albertorestifo/trenino/docs/mechanical/FDM_SPECIALIST_REVIEW.md

# FDM specialist review — integrated controller, 24 October 2026

Review basis: `integrated_controller.fs`, all 30 exported STL objects and the mesh/slicer reports in `integrated-print`, and the assembly/print guide. This is an independent design-for-FDM review of the current revision, before the requested main-gear/handle and 2020-frame redesign. Dimensions below are taken directly from the FeatureScript. No physical print or load test has been performed.

## Findings to implement before releasing prints

1. **Fork is not lying on the flat side claimed by the print layout.** Bars are y=-52…-44, but the roller ends now have radius 5 about y=-48, extending to y=-53. After the +90 degree X print rotation, the cylindrical nose sets Z=0 and the full long bars start 1 mm above the bed. The first contact is a rounded tangent, not a stable broad face. Make the fork bars 12 mm wide (y=-54…-42) with a common flat lower side at y=-54. A local radius-6 pivot boss can fit inside this width. Keep the radius-5 roller ends inside this envelope. Re-run cam and support clearances after widening. Otherwise the part requires extensive underside support, with poorer bearing-hole accuracy.
2. **Fork pivot ligaments are too thin for a repeat-loaded printed part.** The Ø5.3 hole crosses 8 mm wide bars, leaving only (8-5.3)/2 = 1.35 mm of material each side. The 12 mm width above raises that to 3.35 mm. Use rounded transitions into the bar rather than sharp notches. This is a recommended reinforcement, not a calculated load rating.
3. **Roller-axle head seat is only 1.2 mm thick.** Upper cheek z42…45 is cut by the counterbore beginning at z43.2. A clamped screw can crush or split this thin seat. Provide at least 2 mm solid thickness below the head counterbore, preferably by thickening the roller-end cheek locally; preserve the internal 12 mm tube spacing and recheck head clearance and the cam-removal route. Do not solve it simply by pulling the two fork cheeks together with the axle screw.
4. **The shaft needs explicit support under its journals.** D-flat-down is the correct starting orientation for a printed torque shaft, but its 9.2 mm journals are 0.4 mm above the bed when the D-flat establishes Z=0. Add local removable support under both journals or sacrificial print-only feet. Do not remove journal geometry to create flat bearing surfaces. Keep support away from deep insert bores and clean the running surfaces afterward.
5. **No integrated slicing success has yet been demonstrated.** The current `slice-report.json` records exit -3 and zero-byte outputs for every part. Logs say the settings file `integrated-print/profiles/process-integrated*.json` is missing; the generated process files are actually in `integrated-print/`. Correct the path before interpreting any result as a geometry/slicing failure. The shaft is also marked `Supports=false` in the current report. Re-slice the final revised exports, not these superseded meshes.

## Part-by-part disposition

| Part/family | FDM assessment and required treatment |
|---|---|
| Printed main shaft M01 | Keep horizontal D-flat down; add journal support as above. The Ø9.2 journal around a Ø4.6 insert leaves 2.3 mm nominal radial material, acceptable as a prototype starting point. Add ~0.5 mm entry chamfers to running/insert openings, and a modest shoulder fillet where assembly clearance permits. Insert heat can deform bearing journals; use a simple holding/alignment jig and recheck diameter after installation. |
| Bushings M02, two | Upright on end faces is suitable. Nominal Ø9.6 bore vs Ø9.2 journal gives 0.4 mm diametral clearance; actual FDM holes can close this significantly. Print these with the shaft first. Test a small fit coupon before the long parts. Avoid supports inside the bore; clean/ream rather than force fitting. They are replaceable sliding wear parts. |
| End washers M03, two | Flat 1.6 mm parts are printable, but tightening is only for shaft retention. Use conservative screw torque so the printed washers do not dish or clamp the rotating stack. Consider 2 mm if axial space allows. |
| Existing separate handle M04 | Superseded by user correction. For the replacement, integrate the lever into the large gear at its original radial attachment location and print the gear/lever broad face down. Keep a broad stem (approximately 18 mm) and gear-width root (~12 mm); add a generous 3–5 mm rounded root transition. Remove/fill the obsolete threaded lever socket if it would leave an internal void at that new root. Check that handle/gear fits the bed as a single piece; avoid a thin neck or printed transverse thread as the primary load path. |
| Drive spacers M05, two | Flat annular pieces are printable. The 3.2 and 2.5 mm thicknesses are adequate compression spacers. Faces must stay parallel; avoid elephant-foot interference in bores. Their count/thickness must be regenerated when the handle moves into the gear plane. |
| Cam M06 | Flat orientation correctly gives a smooth XY-defined contact profile. Underside boss reliefs leave approximately 9.6 mm-wide roofs, with top screw holes interrupting the bridges. Use accessible support under those reliefs; they open toward the inner edge, allowing removal. Block support on the roller track. Recess seats are 2.2 mm above the relief roof, reasonable but do not overtighten the cam screws. Inspect seam placement and polish only obvious seam/elephant-foot defects, without altering notch shape. |
| Carrier M07 | Flat bottom with vertical insert pockets is suitable. Ø9 bosses around Ø4.6 inserts leave 2.2 mm radial plastic and a 1.8 mm pocket floor; workable for the prototype with careful installation. The stop lug is only 4 mm thick and 6 mm wide with a sharp root. Add a rounded/gusseted root and increase lug thickness toward 6 mm if the revised stop geometry allows. A printed lug is a high-wear impact location; retain generous material instead of a thin projecting tab. |
| Fork M08 | Apply the three findings above before printing. Shared flat side is preferable to a supported curved nose. Horizontal pivot/axle holes may need gentle drilling/reaming; do not heat-set anything in these running holes. |
| Roller M09 | End-face-down is appropriate. Ø4.3 bore over Ø4 tube gives 0.3 mm diametral nominal running clearance. Confirm free rotation after tightening. External seam can be felt at every revolution; tune seam and deburr. A standard smooth roller/bearing is an optional later wear improvement, not necessary to evaluate the printed prototype. |
| Lower/upper plates S01/S02 | Broad-face-down, 6 mm thickness is a sound printable structure. Lower pivot counterbore leaves 3.5 mm seat; upper captured-nut floor leaves 2 mm. The upper plate's asymmetric form is intentional for cam servicing. 2020 T-slot mounting should shorten and stiffen the reaction path and may eliminate several spacers. Keep the resulting parts flat and avoid replacing them with tall thin printed towers. |
| Spring block S03 | The current +90 degree print orientation leaves insert bores horizontal but puts the adjuster/nut entry upward. Small Ø4 roofs can bridge; block automatic support inside the blind insert holes where it cannot be cleaned. Use local support only on accessible overhangs. Insert pockets have 2.7 mm nominal side walls in the 10 mm column, but the y=-26 pocket is only 1.7 mm from the outer edge after insert installation; moving it inward or extending that edge by ~1 mm would improve margin if the bracket survives the 2020 redesign. |
| Stop arch S04 | Broad-face-down 6 mm arch is much better than the earlier cantilever. Upright Ø7 posts project 5 mm above the arch and are short enough to print without support, but their roots are layer-loaded under lever impact. Add root fillets/gussets where clear of the moving lug; direct mounting into the 2020 structure is preferable to slender printed posts carrying the whole base. |
| Ten support spacers S05–S14 | Upright axis is appropriate and all are single contiguous solids. Ø12 spacers have adequate material around M3 holes. Front 8 mm insert caps leave only 1.3 mm below a 6.7 mm pocket (with a through clearance hole); if retained, increase height to 9–10 mm or use a captured/through metal nut. The 2 mm plain spacer is printable as a washer, not a structural stand-off. Use the 2020 rails to reduce stack count. |
| Frame plates | Both current orientations put their broad faces on the bed and bearing seats upward. The 190×93 mm footprint fits P2S; manage warping with a clean bed and brim if needed. Small horizontal flange holes can be bridged/cleaned. Preserve the existing metal-extrusion attachment interface. Existing correct plates need not be reprinted simply because the detent changed. |
| Main and potentiometer gears | Existing module-1 teeth are small but sensible for the prototype with 0.4 mm nozzle and fine mesh export. Broad gear face down keeps tooth profiles in XY. No support should touch teeth. Main gear is now superseded by the integrated lever version; pot gear can remain original. Check the 6 mm pot bore against the real D/round shaft rather than forcing it. |
| Fasteners, spring, dowel, tube and potentiometer references | These are hardware/reference bodies, not print parts. Exclude them from print exports and retain an explicit BOM. Do not describe the spring envelope as a manufactured spring. |

## Release checks for the revised design

- Regenerate the 2020-supported revision and all print groups before exporting. The current 30-part meshes pass topology and build-envelope checks, but that does not cover revised geometry or physical strength.
- Use a first fit job with shaft, bushings, a short insert boss coupon and the roller. Confirm heat-set insert installation and both rotating fits before printing large plates or gear/handle.
- Start with 0.20 mm layers, five walls and five top/bottom layers. Five walls matter more than merely raising infill for these small bosses; use local solid infill around bearing/insert seats if the slicer leaves sparse cores. 35% gyroid is a reasonable prototype starting point, not a strength qualification.
- PLA is suitable for initial fit/geometry evaluation. PETG changes compliance and fits; recheck those after switching. Avoid treating either material as validated for stop impacts until a modest-load bench test has been completed.
- Re-run full lever clearance and cam-removal checks after the fork width, head-seat and gear/handle revisions. The added 2020 rail geometry must be included in those checks.
- Verify support accessibility and layer preview, including the first five shaft/fork layers. A watertight mesh and a zero-interference CAD sweep alone do not prove printability.

## Requested implementation fragment

`review_fork_fragment.fs` implements the agreed candidate: 14 mm bars sharing y=-55 flat print side, Ø7.3 fork pivot bore over a 7 OD × 5.2 ID × 20 mm metal sleeve, 4 mm upper cheek with 2.2 mm remaining axle head seat, 9.5 mm-wide roller, and 11 mm axle spacer tube. The main agent must integrate and collision-test it. The stationary pivot sleeve must not be added to the rotating `rollerHardware` query. Its ends clamp against the fixed plate faces at z26 and z46; there remains 1 mm axial clearance to each outer fork face. The rounded roller nose beyond x=0 still needs a small accessible support region in this orientation; the long bars now have broad bed contact.
