albertorestifo/trenino/docs/mechanical/fusion-controller/FINAL_FDM_REVIEW.md

# Final FDM specialist review — Fusion controller

Review scope: the NEW Fusion controller only, using build scripts 01–17, export manifest, supplied print orientations, mesh report, original slicer report and superseding normal-support re-slice report, assembly guide, and `fusion-overview.png`. The earlier Onshape review does not apply to this geometry. Joint script 17 is not assumed to have run, and this review does not replace motion validation.

## Disposition

The parts are generally designed to print in the supplied orientations on the P2S, with removable supports as listed. The rotor/lever now has a broad printing face, the printed shaft lies horizontally, the base is separate rail-mounted plates, and the rounded grip is split into printable halves. One **mandatory insert-retention correction** was found in P13 before release. Other items below are prototype assembly/fit checks, not reasons to claim the CAD cannot be printed.

### Blocker: P13 cam clearance cuts through two insert sites

The raised crossblock mounting holes nearest the cam are centered at y=-51, z=52, on both ends of P13. The cam-clearance cylinder is R51 centered at y=0, z=65. The distance from that hole center to the cut is:

`sqrt(51² + (65−52)²) − 51 = 1.63 mm`

The Ø4 pilot radius is 2 mm, so even the pilot breaks into the clearance cut. The installed CNC Kitchen insert is approximately Ø4.6; its 2.3 mm radius leaves **negative wall thickness** toward the cam. Heat-setting here cannot produce a fully enclosed retaining boss. Mesh watertightness does not detect this design problem.

Recommended local correction: move the matched P13 and P01/P02 mounting-hole pairs from y=-59/-51 to **y=-62/-54**, keeping z=52, and move the four screw models with them. The y=-54 insert has approximately 2.24 mm nominal material between its outside and the R51 cut; the y=-62 insert has 1.7 mm nominal material to the block's y=-66 outer edge. The 8 mm center spacing leaves 3.4 mm between installed inserts. Recheck rail-head/tool clearances, export and re-slice the affected three parts. Do not simply fill the hole without preserving the cam-clearance envelope.

## Part-by-part review

| Parts | Assessment and concrete print/assembly treatment |
|---|---|
| P01 left sideplate | X-min face down puts the broad 12 mm plate on the bed and grows the reinforced stop cores upward. Supports are appropriate for transverse rail bores and recessed nut/head details. Steel stop bolts reinforce short printed contact posts. Ensure nut recess support is completely removed and rail faces sit flat before tightening. Match the P13 mounting-hole correction above. |
| P02 right sideplate | X-min face down gives a broad base. The sensor rails grow upward to a 56 mm overall print height, rather than appearing as disconnected bridges. Supports cover the service-window/rail access details. The tall rails are lightly loaded sensor supports; use normal supports as in the superseding slice report. Match the P13 mounting-hole correction. |
| P03/P04 flanged bushes | Both print flange-down. Ø20.1 bodies in Ø20.3 seats and Ø12.3 bores over Ø12 journals are plausible nominal clearances, but the first layer can close holes. The 1.2 mm flanges should be allowed to cool before removal to avoid warping. Print these and the shaft first. Check free rotation, axial seating and visible wear. |
| P05 printed shaft | Y-max/D-flat down is appropriate. The 16 mm structural section has a broad flat, and the shoulder has been flattened to the same plane. Round journals and sensor stub remain raised and need the enabled supports. Clean support without flattening bearing surfaces. The M3 insert in the 12 mm journal has adequate nominal surrounding material; install with controlled heat and then verify journal roundness. Shoulder/diameter changes are fatigue-sensitive under abuse; modest-load prototype testing is appropriate. |
| P06 cap | Flat, 2 mm thick, support-free. It retains the shaft; do not tighten it to eliminate the designed end float or dish the cap. |
| P07 integral lever rotor/carrier | X-max face down puts the continuous 14 mm hub/stem/fan on the bed and grows the stop lug upward. Removing the former long axial hub was the correct printability change. Cam insert pockets open toward the bed but are small Ø4 blind openings with accessible entry; clean any roof stringing before heat-setting. At R36 on an R41 fan the installed inserts retain approximately 2.7 mm radial margin. Rounded stop contact lies within the lever-root footprint and does not create the earlier Onshape carrier's raised unsupported ledge. Six walls are appropriate for this prototype. |
| P08 cams, all three profiles | Flat face down, 8 mm thick, with counterbores upward. No underside boss pockets need support. This is a good orientation for XY roller-track quality. Keep seams/support scars off the track and remove elephant foot only at the nonfunctional lower edge. Three alternatives are exported; install one only. |
| P09/P10 rounded grip | Split-face down with normal supports in the 14.4 mm-wide stem socket is suitable. Socket support is accessible from the split face and open lower mouth. Install the two inserts from the recessed socket side before closing the halves. The rounded crown and 40×60 mm envelope are manufacturable; deburr seam and counterbore mouths. Confirm comfort and grip screw seating physically rather than claiming an ergonomic qualification. |
| P11 fork | Z-min side down provides two long flat cheek contacts, unlike the old Onshape floating bars. Supports are enabled for horizontal pivot/axle bores and the tail pilot. The Ø8.3 pivot hole in a 12 mm-high cheek leaves 1.85 mm nominal ligaments; the 3 mm cheeks and approximately 1.5 mm material behind the roller nut recess are the thinnest repeatedly loaded details. They are acceptable for a gentle fit prototype with the metal sleeves carrying bolt clamp loads, but deserve early inspection for cracking, crushing or looseness. Do not use higher spring force or impact testing as the initial test. A later endurance version could widen/thicken these areas if tests show strain. |
| P12 roller | End down, no supports. Ø4.3 bore over Ø4 tube gives nominal 0.3 mm diametral clearance; the 9.5 mm roller inside the 10 mm tube span has 0.5 mm total axial room. Check that axle tightening does not remove this freedom. A seam ridge will be felt at the cam; deburr it carefully. |
| P13 reaction crossblock | Top down makes the spring-side M4 nut recess accessible upward, and normal supports handle the side insert bores and clearance contour. **Apply the insert-position blocker above.** Long 8.8 mm blind cuts provide screw-tip room behind 5.7 mm inserts; do not bury inserts deeper than their intended entry face. |
| P14 spring cup | Top down, pilot upward, no supports. The 2 mm cup plate has a broad bed footprint. Guide bores are Ø4.4 for Ø4 sleeves. Use the guide tubes so tightening the screws does not clamp the sliding plate. Remove it from the bed by the plate, not by pulling the narrow pilot. |
| P15 preload collar | The final part is the 4 mm collar, not the earlier 9 mm version. Ø6.6 outside and Ø4.5 inside leaves about 1.05 mm wall. This is a short compression limiter, not a bearing; print with solid perimeter walls and avoid forcing it over a damaged screw. Its role and dimension should remain clear in the guide. |
| P16 sensor carriage | X-max panel face down gives a broad 3 mm panel base; the adjustment ears grow upward. The small horizontal slots can bridge in this orientation; clean them enough that washers seat and the carriage slides. The RK097 bushing/body assumptions must be checked on the actual purchased part before tightening. |
| P17 input coupling hub | X-min down with normal supports is appropriate. The larger flange extends past the lower clamp body and does require support. The 0.4 mm pinch split must remain open; prevent support residue or elephant foot from welding it. Heat-set insert/clamp walls have modest but usable margins for transmitting sensor torque, not lever reaction loads. Tighten only enough to prevent slip. |
| P18 floating Oldham disc | X-min down with support beneath the lower open transverse groove. Both grooves run to the perimeter and remain accessible for cleaning. There is a 3 mm web between the opposing 2.5 mm-deep grooves. It is a deliberate floating coupling component, not an unsupported printed island. Check free sliding with the actual hub tongues before installing the sensor. |
| P19/P20 output clamp halves | Split faces down with normal supports beneath the semicircular shaft bore. The 0.4 mm assembled split allows clamping; remove brim/elephant foot from that gap. Insert-side minimum nominal material is about 1.6–1.7 mm near the bore/edge, so use controlled insert heat and modest clamp torque. The shaft bore is an assumption; do not force or overclamp an incompatible sensor shaft. |
| P21/P22 follower spacers | Axial ends down, no supports. P21 is Ø12×27.8 with Ø8.4 bore, a 1.8 mm wall; use a brim if bed adhesion is marginal. P22 is the short 3.8 mm counterpart. Their lengths establish end float; do not substitute arbitrary washer stacks. |
| P23/P24 rotor thrust spacers | End down, no supports. Ø20 outside / Ø16.4 inside leaves a 1.8 mm wall and both are 16.85 mm long. Keep end faces parallel, remove elephant foot from bores, and confirm the nominal 0.3 mm rotor end float after the entire stack is assembled. |

## Evidence and release limits

- The mesh report records 26 single connected, closed, consistently wound meshes, all on Z=0 and within the P2S envelope. This includes three cam alternatives; one installed controller uses 24 of those printed solids.
- All original slice records report success. For the 11 supported parts, `slice-report-reslice.json` supersedes the tree-support runs with normal supports. That is important: the earlier tree runs reported lost-branch diagnostics even though they exited zero.
- The normal-support re-slices still carry printer-preset/tool diagnostics including `nozzle_volume_type` and `T65535`. Release geometry, not those CLI-generated G-code files. Slice with the user's installed P2S/filament profile and inspect support contact/removal in Bambu Studio.
- Slicer success is evidence that toolpaths can be generated; it does not prove support removal, running fits, insert retention, layer strength or fatigue life. Print the shaft/bush/coupling fits first and start with low spring load.
- The actual RK097 must be measured. The assumed Ø6 shaft/M7 mounting bushing, coupling engagement and usable travel remain hardware validation items. An Oldham disc's free motion must not be removed by axial bottoming of the hubs.
- FDM review does not certify native joint constraints or cam contact. The sampled motion and service-path checks must remain separately documented and repeated after any collision-relevant geometry changes.

**Review outcome:** release the supported PLA prototype geometry only after the P13/plate mounting-hole correction and affected mesh/slice checks. No other mandatory FDM CAD changes were identified in this review. The fork's thin sections, printed bearings, clamp fits, stop contact and real sensor fit remain explicit early bench-test items.

### Adjacent mounting-hole caveat

At the plate mount nearest the cam, the rail-head counterbore R5.3 centered at Z45 reaches Z50.3, while the M3 through-bore R1.7 centered at Z52 also reaches Z50.3. Their nominal voids are tangent where their Y ranges overlap (including the suggested Y=-54 mount). The actual screw envelopes may still clear, but the zero web is a stress concentration and needs inspection in the layer preview/first prototype. A local raised mounting boss with higher hole center would improve the durable version if it can be accommodated without changing the preload stack. This is distinct from the missing insert-retention wall in P13; no load or fatigue rating is claimed here.

## Implementation closure (same review round)

The reviewed findings were implemented in scripts19,20 and22. Final crossblock rows are Y=-70/-62 at Z53.5, with the block extended toY=-74 (1mm inside the rail); this supersedes the intermediate -62/-54 proposal, which crossed a cup guide. Installed-insert outer wall is at least1.7mm for an assumed4.6mm OD, with ample cam-side wall. The guide bores remain separate. Rotor clamp with flat washer pad, default4.2mm and optional4.1mm coupling grooves, M5x30/5mm-total metal rail spacers, 2mm preload collar, M3x35 guides and M4 socket head are present.

Final neutral CAD check finds only0.000634mm� numerical cam-contact overlap. The three cam profiles each passed53 sampled poses. After corrections,27 additional rotor/coupling poses, operating/service follower positions, +/-1mm preload movement and optional tight-disc assembly fit passed the0.01mm� threshold. Revised cam withdrawal at5mm increments through40mm with the follower depressed5deg passes. Exported cam profiles track the intended roller center within0.0013mm over the159 sampled positions (mesh/facet approximation). These checks do not replace physical force or fatigue tests.

All27 final print meshes are single connected, closed, consistently wound solids, bed-oriented and inside the256mm P2S envelope. All27 final slices succeeded;12 use conventional supports. The largest part is171mm long. Vendor CLI preset/tool-command warnings are retained in logs; only geometry is released, not that G-code. Guide/BOM explicitly retain actual RK097, T-nut engagement, spring choice, free-sliding coupling and reversal-hysteresis checks. No additional review round was commissioned.
