albertorestifo/trenino/docs/feature-reference/serial-protocol.md

# Serial transport and byte protocol

This is the implemented host contract at commit `188f35e4108733358730e92ebd98f1912af5173a`, reviewed on 2026-10-25. It describes the Elixir host, not an independently verified firmware implementation. No real port was opened during this review. For configuration semantics see [hardware](hardware.md), flashing and port ownership see [firmware](firmware.md), and executable acceptance stories see [hardware user stories](hardware-user-stories.md).

## Transport and framing

[Connection](https://github.com/albertorestifo/trenino/blob/188f35e4108733358730e92ebd98f1912af5173a/lib/trenino/serial/connection.ex) opens each eligible UART with `active: false`, `speed: 115_200`, `framing: Trenino.Serial.Framing`, and `rx_framing_timeout: 1_000`. Other line settings are left to Circuits.UART defaults; this repository does not explicitly select parity, data bits, or stop bits. After the identity handshake it switches to `active: true`. Bootloader uploads use their separate board-specific baud rates.

[Framing](https://github.com/albertorestifo/trenino/blob/188f35e4108733358730e92ebd98f1912af5173a/lib/trenino/serial/framing.ex) sends one message payload per zero-delimited COBS frame:

1. Append a zero to the payload.
2. Split it at zeros or after 254 nonzero bytes. Each block has a leading code equal to nonzero byte count plus one; a full 254-byte block uses `FF`.
3. Append a literal `00` frame delimiter to the encoded bytes.

The appended-zero implementation detail matters at block boundaries: 254 `AA` payload bytes become `FF` + 254 × `AA` + `01 00` (257 bytes); 255 `AA` bytes become `FF` + 254 × `AA` + `02 AA 00`. An ordinary heartbeat payload `06` becomes `02 06 00`; payload `00 11 00` becomes `01 02 11 01 00`. There is no packet length prefix outside message bodies, checksum, CRC, sequence number, encryption, or transport acknowledgement in this framing code.

Receive buffering concatenates new bytes, splits on every `00`, and processes all complete frames in order. Empty encoded frames are ignored. Decoding appends an implied zero after every block with code below `FF`, then removes exactly one final decoded byte. A code claiming more bytes than remain raises `ArgumentError`, which is caught and causes that frame to be dropped; following valid frames are still processed. A remaining incomplete buffer returns `:in_frame`; an empty buffer returns `:ok`. `flush/2` clears buffered bytes. `frame_timeout/1` returns no frames and retains state. Although `init/1` stores a `max_length` option, nothing enforces it: an undelimited stream can grow indefinitely. These are source observations; corruption detection beyond structural COBS checks is absent.

Evidence: [framing tests](https://github.com/albertorestifo/trenino/blob/188f35e4108733358730e92ebd98f1912af5173a/test/trenino/serial/framing_test.exs) cover standard examples, 254/255-byte boundaries, split frames, 500-byte random round trips, corrupt frames, and recovery to the next frame.

## Message notation and dispatch

All layouts below are **decoded payload bytes**, before COBS. Offset zero is always the type byte. `u8` is one unsigned byte; `u32le` is four unsigned little-endian bytes; `i16le` is a signed two's-complement little-endian two-byte value. Fixed-size decoder patterns require exactly the shown size, including rejection of trailing bytes. Wire config IDs permit unsigned 32-bit values even though normally generated application IDs are positive signed-32-bit-range integers.

[Message.decode/1](https://github.com/albertorestifo/trenino/blob/188f35e4108733358730e92ebd98f1912af5173a/lib/trenino/serial/protocol/message.ex) dispatches by the first byte. Empty binary returns `{:error, :insufficient_data}`; an unrecognized byte returns `{:error, :unknown_message_type}`; nonbinary input returns `{:error, :invalid_input}`. Known messages with a bad body return `{:error, :invalid_message}`. Struct APIs represent input/output kinds with atoms and encoders convert to integer tags. Most encoders rely on binary construction rather than full field validation: callers must not assume the Ecto constraints are repeated at the wire boundary.

| Type | Message; usual direction | Exact decoded layout; total length | Host behavior |
|---|---|---|---|
| `00` | IdentityRequest; host → device | `00`, request_id `u32le` at 1–4; 5 bytes | Discovery writes and drains a fresh request on each attempt. |
| `01` | IdentityResponse; device → host | `01`, request_id `u32le` at 1–4, major `u8` at 5, minor at 6, patch at 7, config_id `u32le` at 8–11; 12 bytes | Converts version bytes to `"major.minor.patch"`; records firmware version/config ID. No board type, serial number, USB identity, or device ID is present. |
| `02` | Configure; host → device | Header and discriminated payload detailed below; variable length | One frame per direct input, matrix, or I2C module. |
| `03` | ConfigurationStored; device → host | `03`, config_id `u32le` at 1–4; 5 bytes | Completes matching in-flight configuration; no per-part ACK. |
| `04` | ConfigurationError; device → host | `04`, config_id `u32le` at 1–4; 5 bytes | Completes matching request with `:device_rejected`; no numeric reason/detail. |
| `05` | InputValue; device → host | `05`, pin `u8` at 1, value `i16le` at 2–3; 4 bytes | Caches/broadcasts raw integer values by receiving port and pin. **There is no config_id in this message.** |
| `06` | Heartbeat; nominally both directions | `06`; 1 byte, empty body | Codec exists; Connection only broadcasts it. No periodic heartbeat writer, pong handler, missed-heartbeat timer, or liveness enforcement exists in these modules. |
| `07` | SetOutput; host → device | `07`, pin `u8` at 1, value `u8` at 2 (`00` low, `01` high); 3 bytes | Fire and forget; invalid value atom returns `:invalid_value`; other received value bytes reject. |
| `08` | RetryCalibration; host → device | `08`, pin `u8` at 1; 2 bytes | Encoder explicitly accepts integer 0–255, otherwise `:invalid_pin`; codec support does not make this part of the host sampling wizard. |
| `09`–`0C` | Reserved, removed BLDC stubs | No supported payload | Dispatcher returns unknown-message-type. |
| `0D` | WriteSegments; host → device | `0D`, I2C address `u8` at 1, byte count `N:u8` at 2, N raw bytes at 3 onward; `3+N` bytes | Encoder permits at most 16 data bytes, otherwise `:data_too_long`. Decoder requires precisely N bytes but does **not** itself cap N at 16. |
| `0E` | SetModuleBrightness; host → device | `0E`, I2C address `u8` at 1, brightness `u8` at 2; 3 bytes | Encode/decode restrict brightness to 0–15; invalid encode returns `:invalid_brightness`. No acknowledgement. |
| `0F` | ModuleError; device → host | `0F`, I2C address `u8` at 1, error_code `u8` at 2; 3 bytes | ConfigurationManager logs a warning. No error-code enum, persistent status, retry, or failed-configuration event is defined. Module documentation says it follows ConfigurationStored for each failed module. |

IdentityRequest/Response sources: [request](https://github.com/albertorestifo/trenino/blob/188f35e4108733358730e92ebd98f1912af5173a/lib/trenino/serial/protocol/identity_request.ex), [response](https://github.com/albertorestifo/trenino/blob/188f35e4108733358730e92ebd98f1912af5173a/lib/trenino/serial/protocol/identity_response.ex). Response encoding splits a string into exactly three integer components; malformed versions can raise rather than return an error tuple. Configuration responses: [stored](https://github.com/albertorestifo/trenino/blob/188f35e4108733358730e92ebd98f1912af5173a/lib/trenino/serial/protocol/configuration_stored.ex), [error](https://github.com/albertorestifo/trenino/blob/188f35e4108733358730e92ebd98f1912af5173a/lib/trenino/serial/protocol/configuration_error.ex). Remaining codecs: [input](https://github.com/albertorestifo/trenino/blob/188f35e4108733358730e92ebd98f1912af5173a/lib/trenino/serial/protocol/input_value.ex), [heartbeat](https://github.com/albertorestifo/trenino/blob/188f35e4108733358730e92ebd98f1912af5173a/lib/trenino/serial/protocol/heartbeat.ex), [output](https://github.com/albertorestifo/trenino/blob/188f35e4108733358730e92ebd98f1912af5173a/lib/trenino/serial/protocol/set_output.ex), [retry](https://github.com/albertorestifo/trenino/blob/188f35e4108733358730e92ebd98f1912af5173a/lib/trenino/serial/protocol/retry_calibration.ex), [segments](https://github.com/albertorestifo/trenino/blob/188f35e4108733358730e92ebd98f1912af5173a/lib/trenino/serial/protocol/write_segments.ex), [brightness](https://github.com/albertorestifo/trenino/blob/188f35e4108733358730e92ebd98f1912af5173a/lib/trenino/serial/protocol/set_module_brightness.ex), [module error](https://github.com/albertorestifo/trenino/blob/188f35e4108733358730e92ebd98f1912af5173a/lib/trenino/serial/protocol/module_error.ex). ModuleError encoding checks integer types but not byte bounds.
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
