albertorestifo/trenino/docs/mechanical/cam-detent-prototype.png

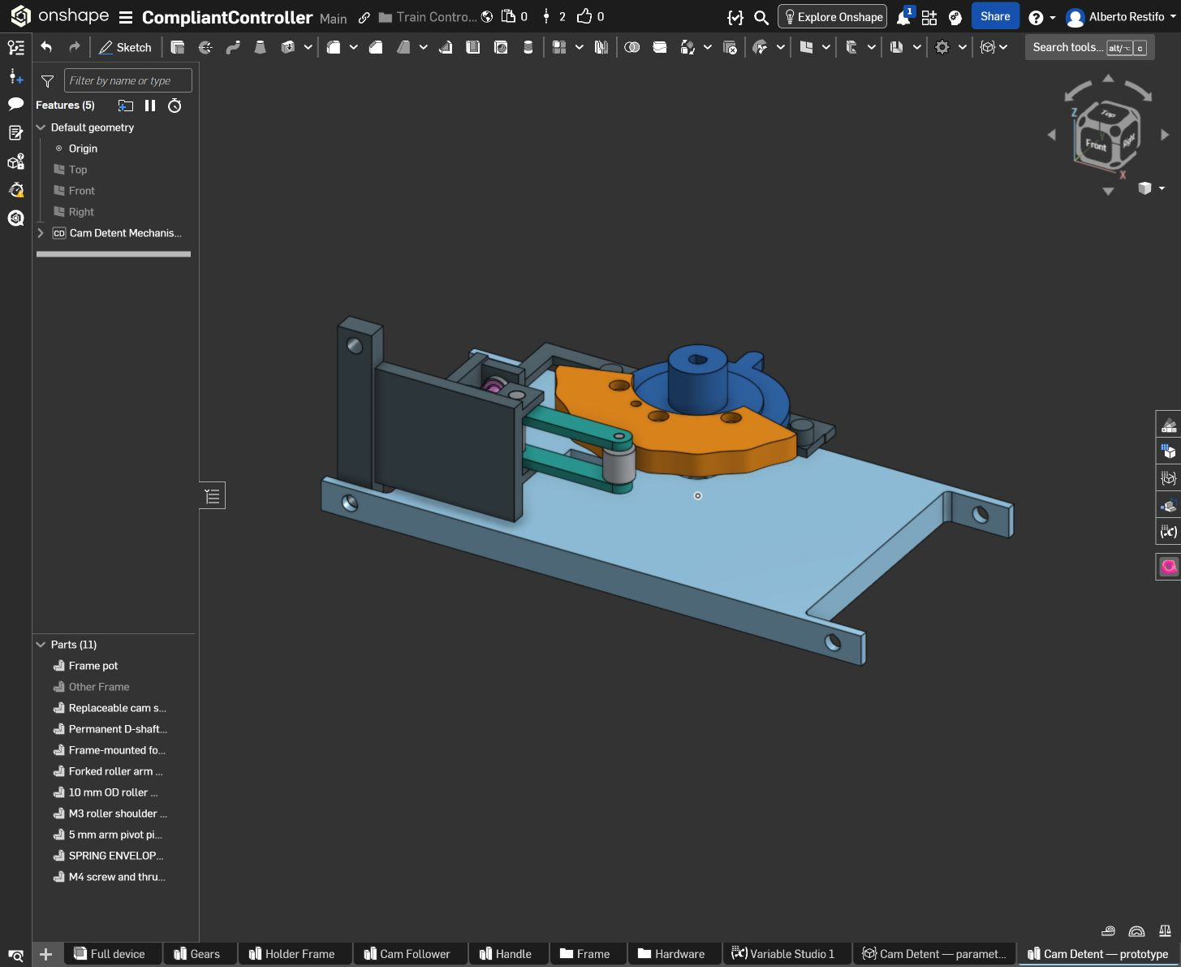
docs/mechanical/cam-detent-prototype.png
