albertorestifo/trenino/docs/mechanical/fusion-controller/fusion-closeup.png

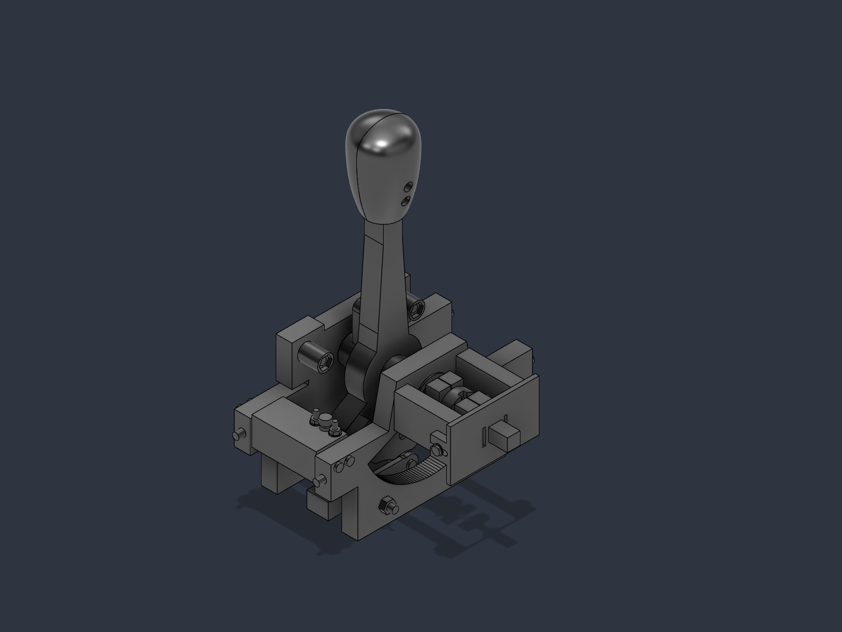
docs/mechanical/fusion-controller/fusion-closeup.png
