albertorestifo/trenino/docs/mechanical/fusion-controller/fusion-overview.png

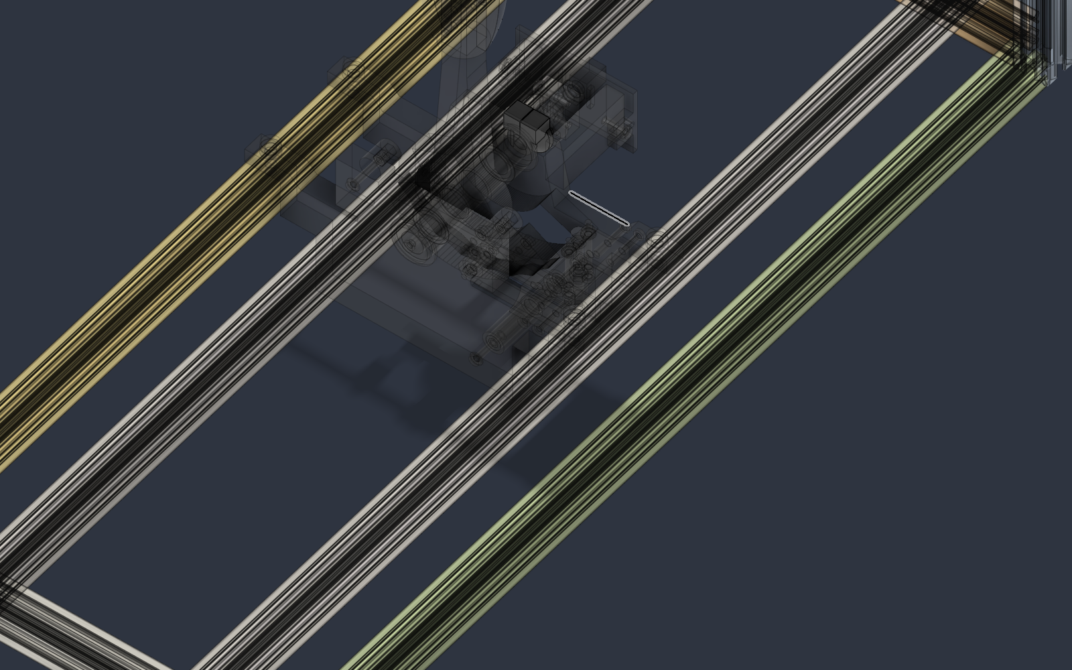
docs/mechanical/fusion-controller/fusion-overview.png
