albertorestifo/trenino/docs/mechanical/fusion-controller/gear-comparison/geared-v3-overview.png

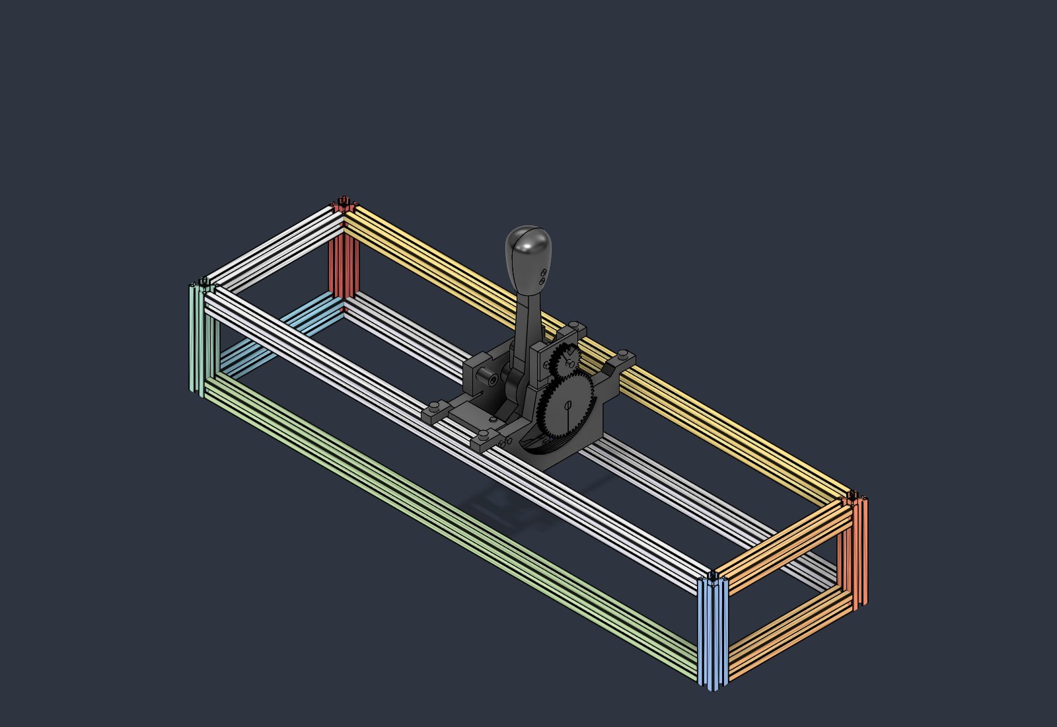
docs/mechanical/fusion-controller/gear-comparison/geared-v3-overview.png
