albertorestifo/trenino/docs/mechanical/fusion-controller/gear-comparison/layer-review/layers-1.png

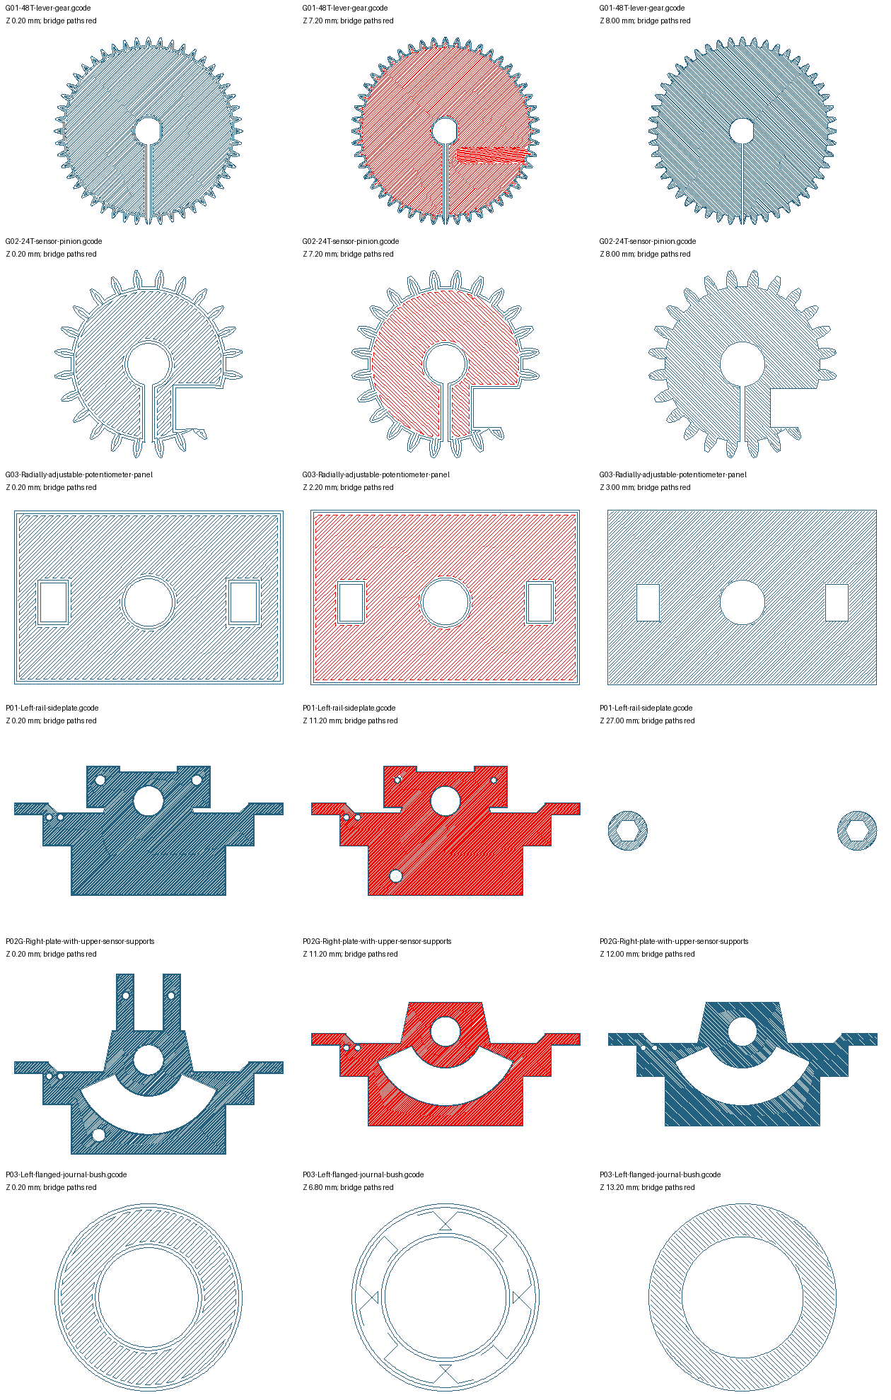
docs/mechanical/fusion-controller/gear-comparison/layer-review/layers-1.png
