albertorestifo/trenino/docs/mechanical/fusion-controller/gear-comparison/layer-review/layers-2.png

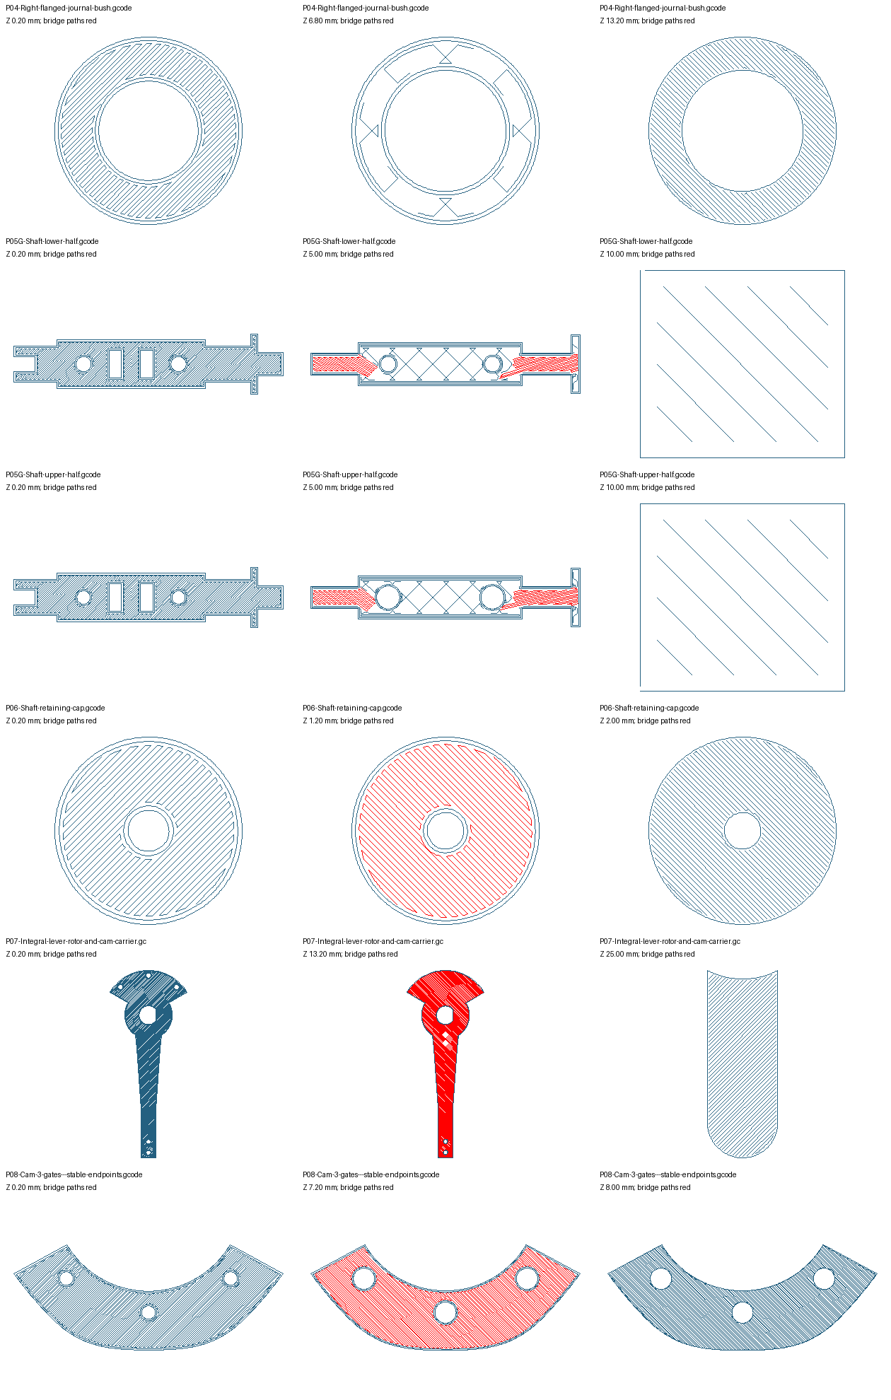
docs/mechanical/fusion-controller/gear-comparison/layer-review/layers-2.png
