albertorestifo/trenino/docs/mechanical/fusion-controller/gear-comparison/layer-review/layers-3.png

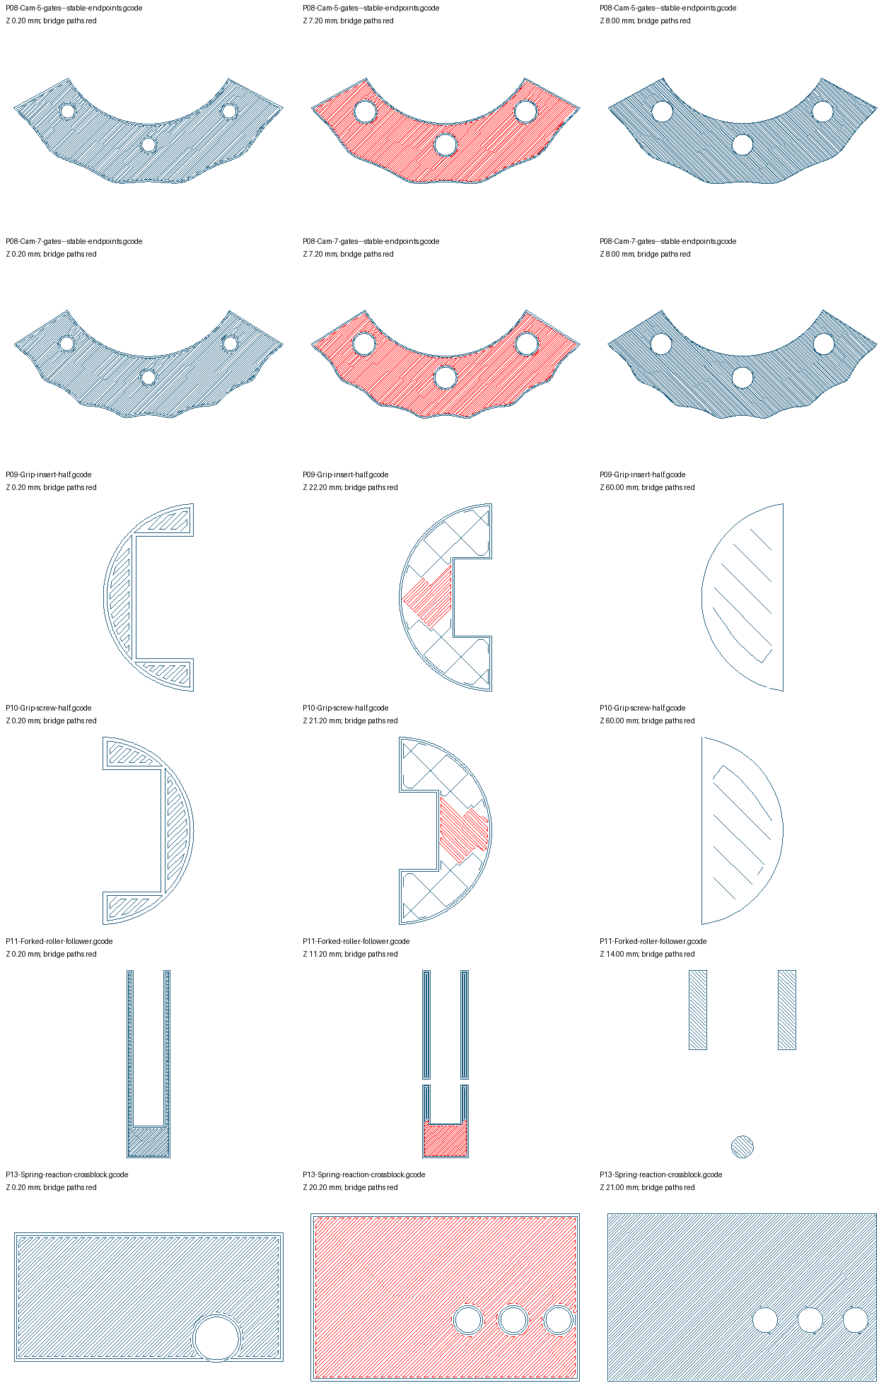
docs/mechanical/fusion-controller/gear-comparison/layer-review/layers-3.png
