albertorestifo/trenino/docs/mechanical/fusion-controller/gear-comparison/layer-review/layers-4.png

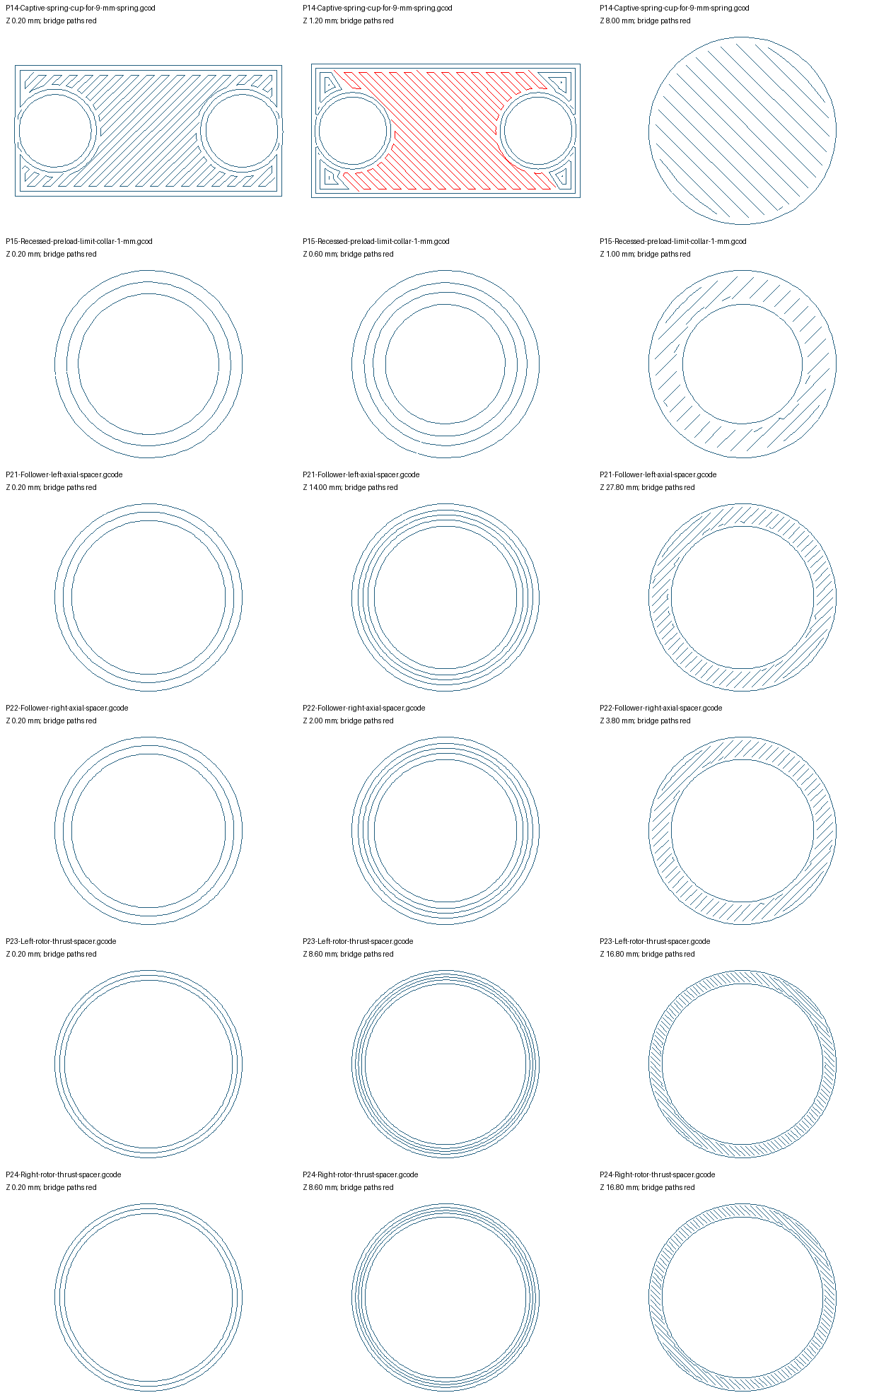
docs/mechanical/fusion-controller/gear-comparison/layer-review/layers-4.png
