albertorestifo/trenino/docs/mechanical/fusion-controller/gear-comparison/layer-review/layers-5.png

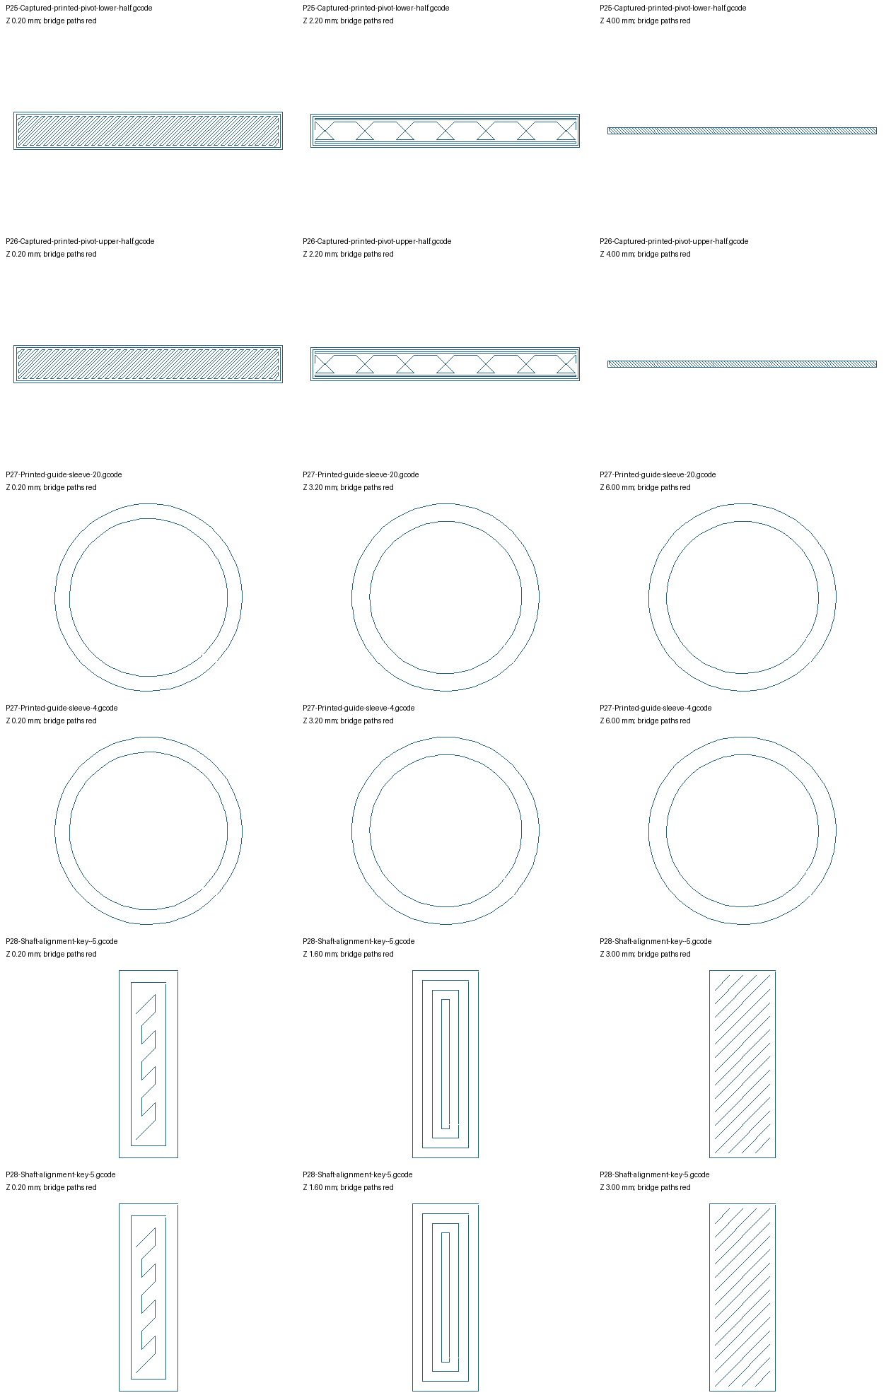
docs/mechanical/fusion-controller/gear-comparison/layer-review/layers-5.png
