albertorestifo/trenino/docs/mechanical/fusion-controller/gear-comparison/plate-layer-review/layers-1.png

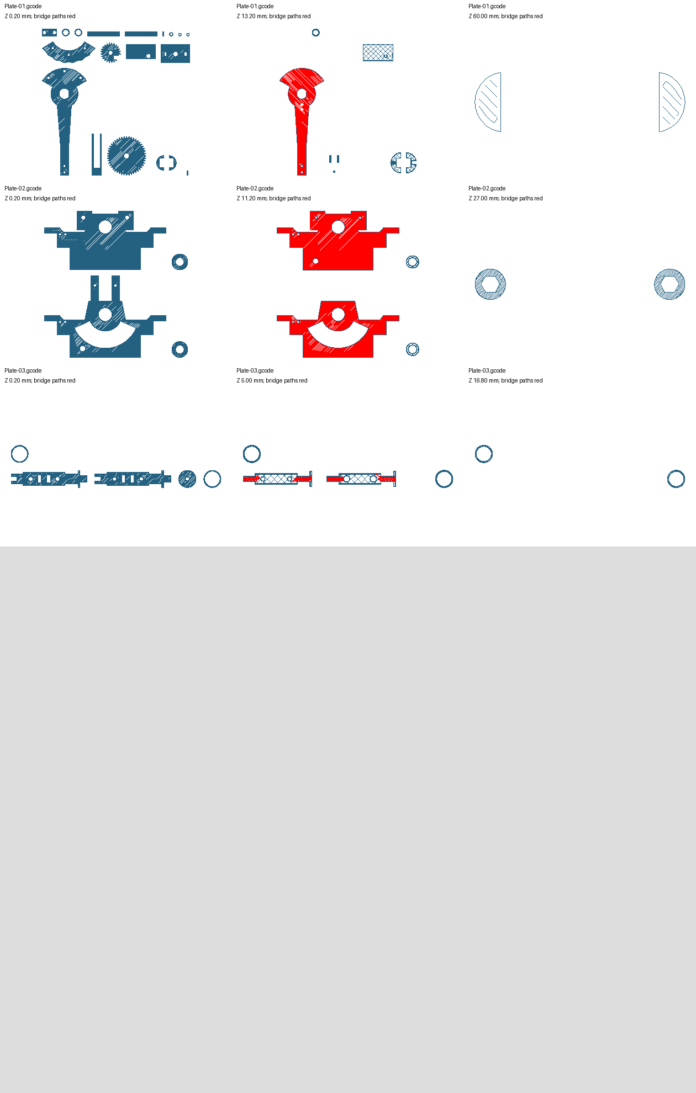
docs/mechanical/fusion-controller/gear-comparison/plate-layer-review/layers-1.png
