albertorestifo/trenino/docs/mechanical/fusion-controller/one-piece-shaft/cam-service-side.png

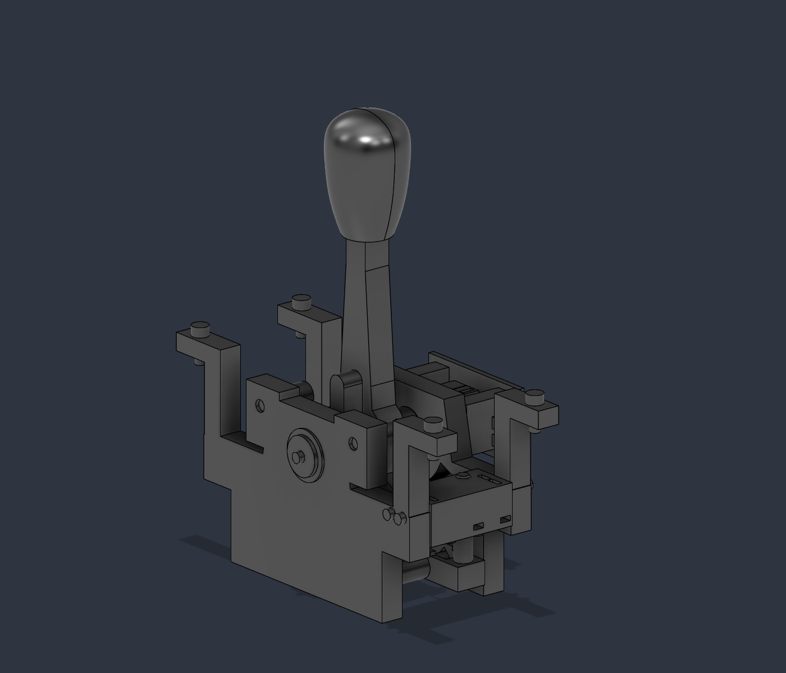
docs/mechanical/fusion-controller/one-piece-shaft/cam-service-side.png
