albertorestifo/trenino/docs/mechanical/fusion-controller/one-piece-shaft/fdm-layer-review/critical-1.png

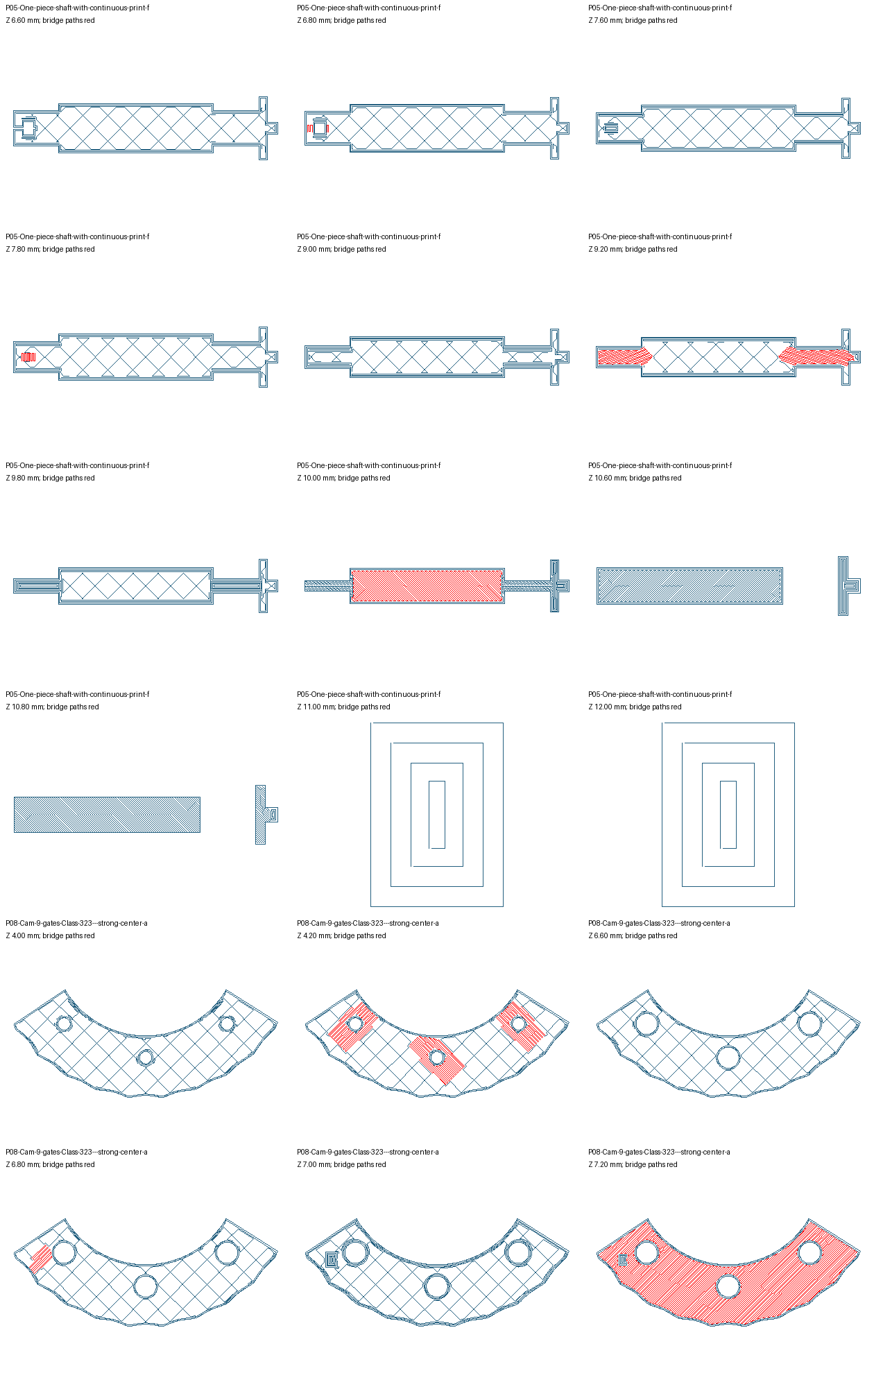
docs/mechanical/fusion-controller/one-piece-shaft/fdm-layer-review/critical-1.png
