albertorestifo/trenino/docs/mechanical/fusion-controller/one-piece-shaft/layer-review/critical-1.png

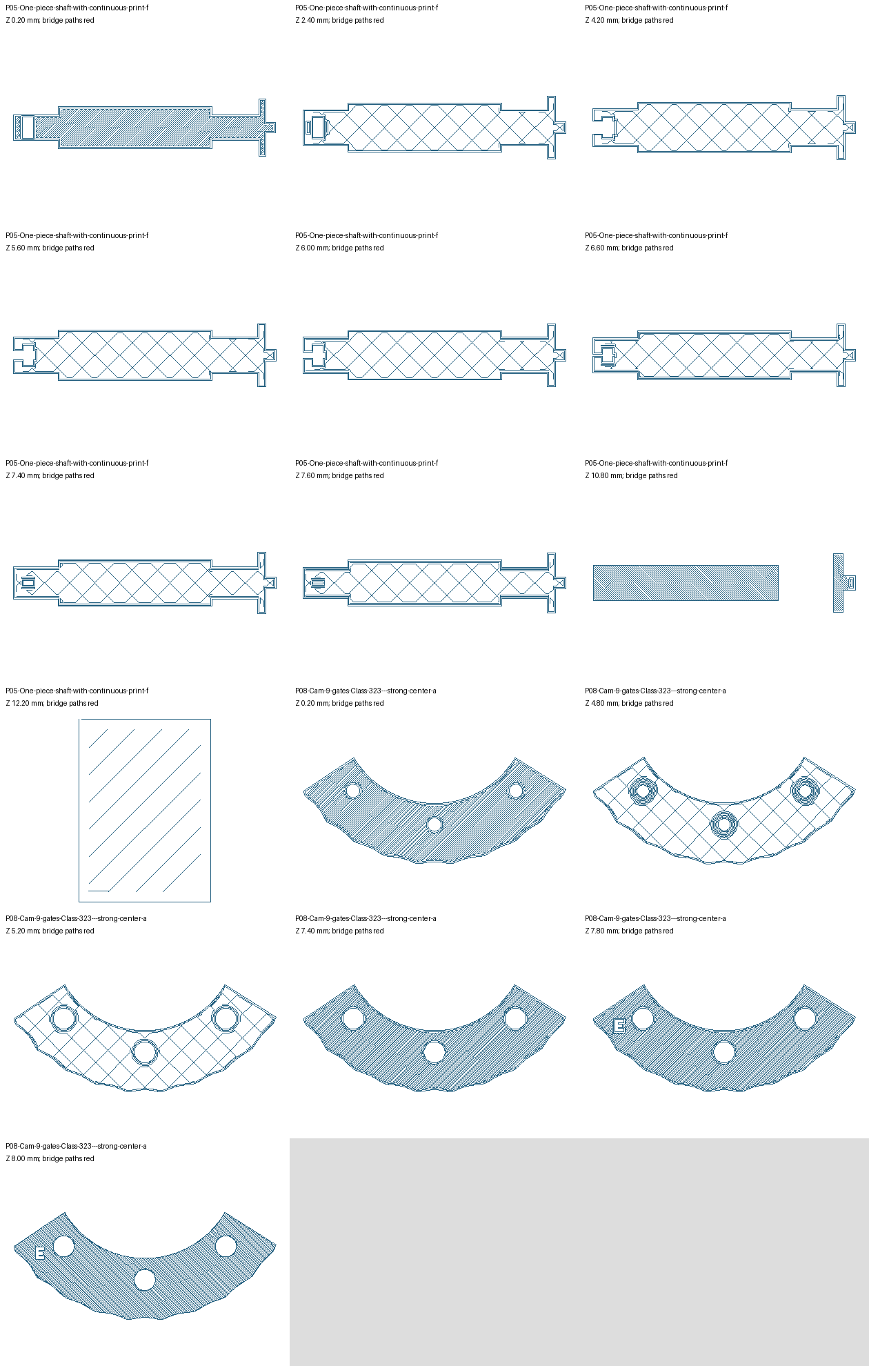
docs/mechanical/fusion-controller/one-piece-shaft/layer-review/critical-1.png
