albertorestifo/trenino/docs/mechanical/fusion-controller/one-piece-shaft/rail-mounted-layout.png

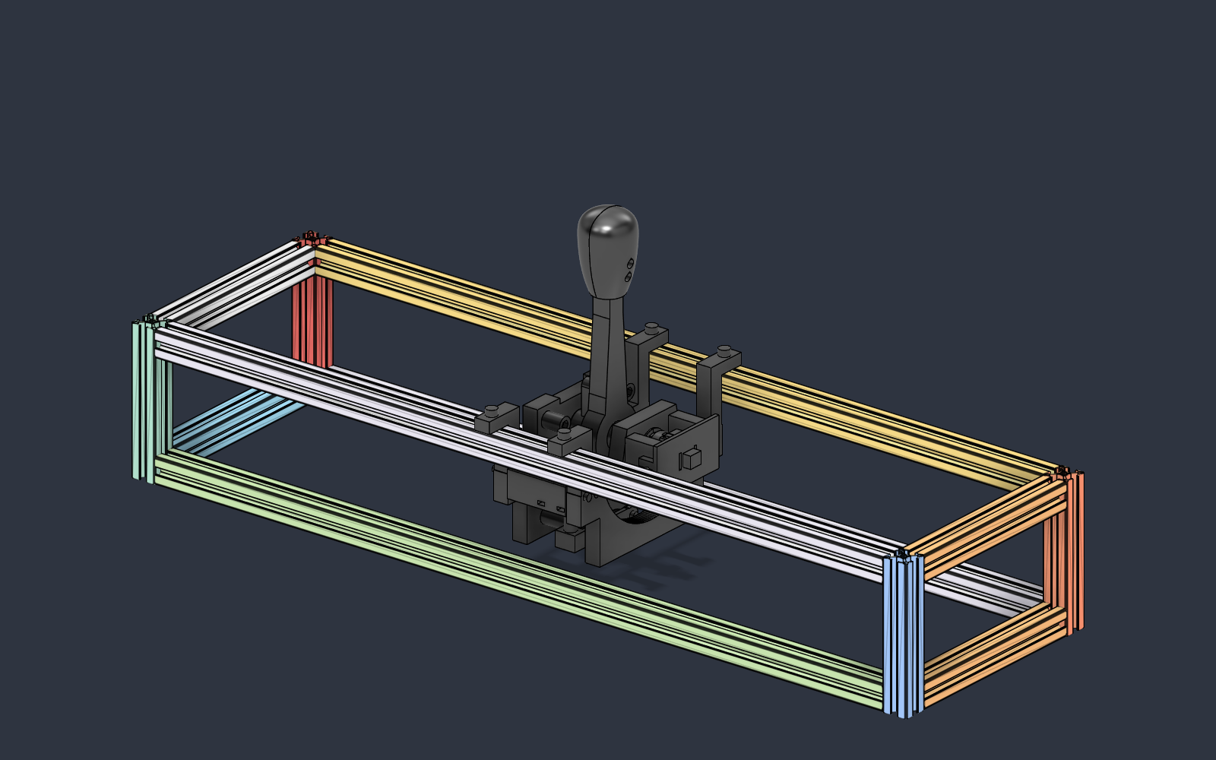
docs/mechanical/fusion-controller/one-piece-shaft/rail-mounted-layout.png
