albertorestifo/trenino/docs/mechanical/fusion-controller/opposite-sides/cam-service-side.png

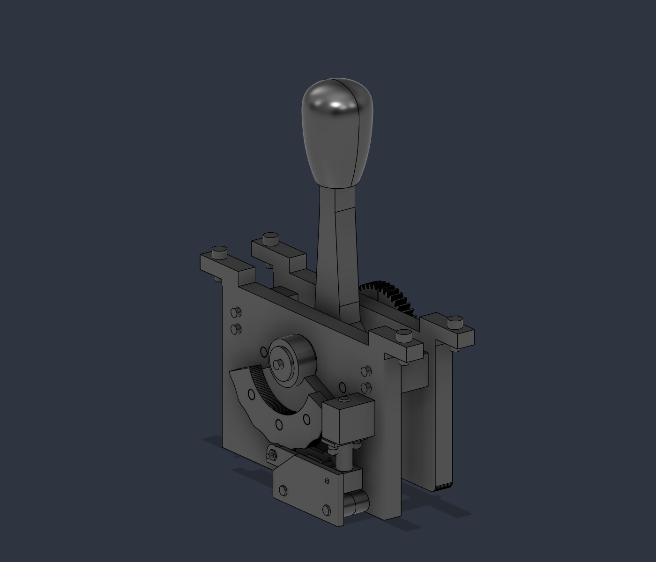
docs/mechanical/fusion-controller/opposite-sides/cam-service-side.png
