albertorestifo/trenino/docs/mechanical/fusion-controller/opposite-sides/layer-review/critical-1.png

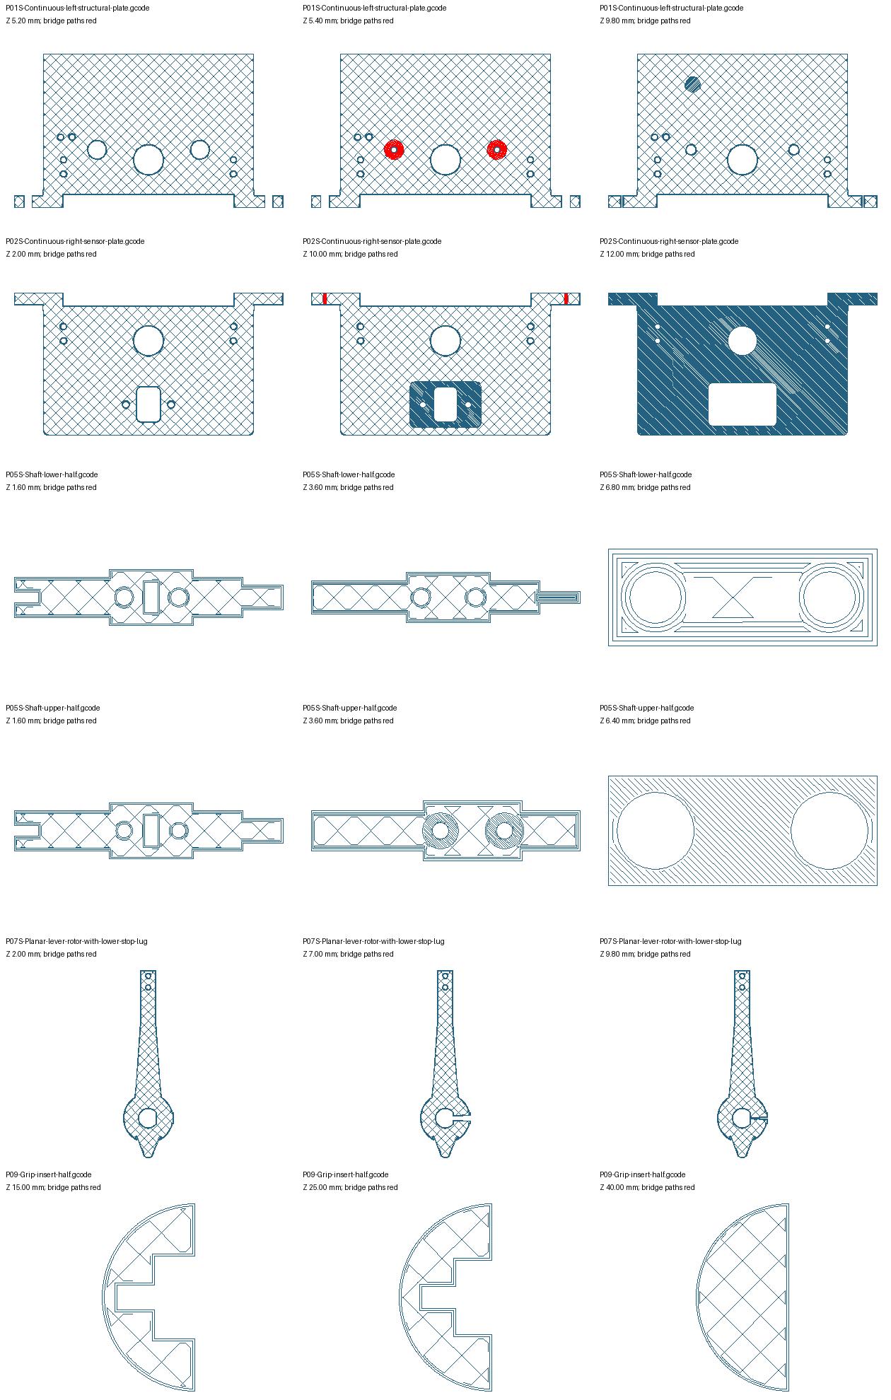
docs/mechanical/fusion-controller/opposite-sides/layer-review/critical-1.png
