albertorestifo/trenino/docs/mechanical/fusion-controller/opposite-sides/layer-review/critical-2.png

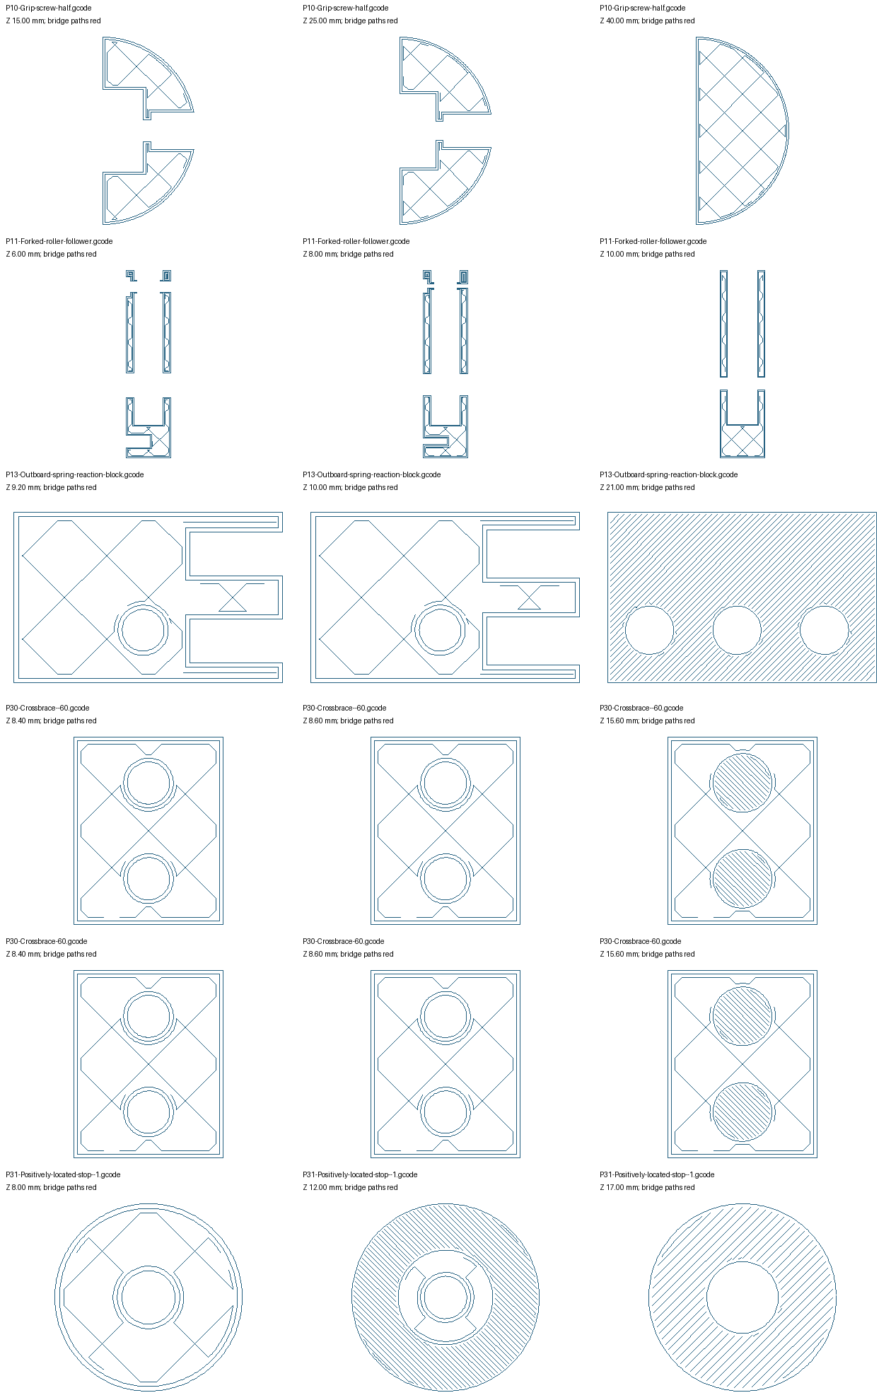
docs/mechanical/fusion-controller/opposite-sides/layer-review/critical-2.png
