albertorestifo/trenino/docs/mechanical/fusion-controller/opposite-sides/layer-review/critical-3.png

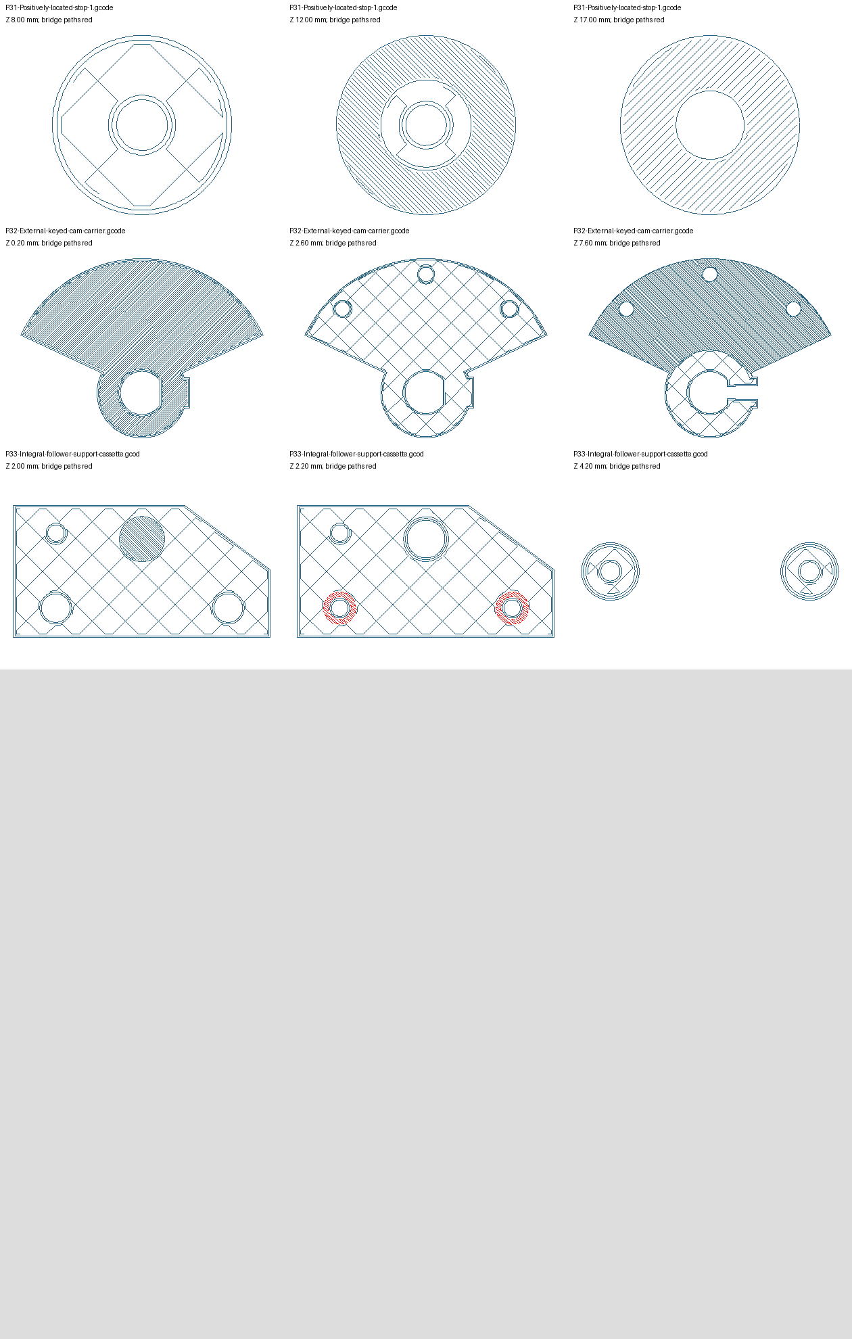
docs/mechanical/fusion-controller/opposite-sides/layer-review/critical-3.png
