albertorestifo/trenino/docs/mechanical/fusion-controller/opposite-sides/layer-review/layers-2.png

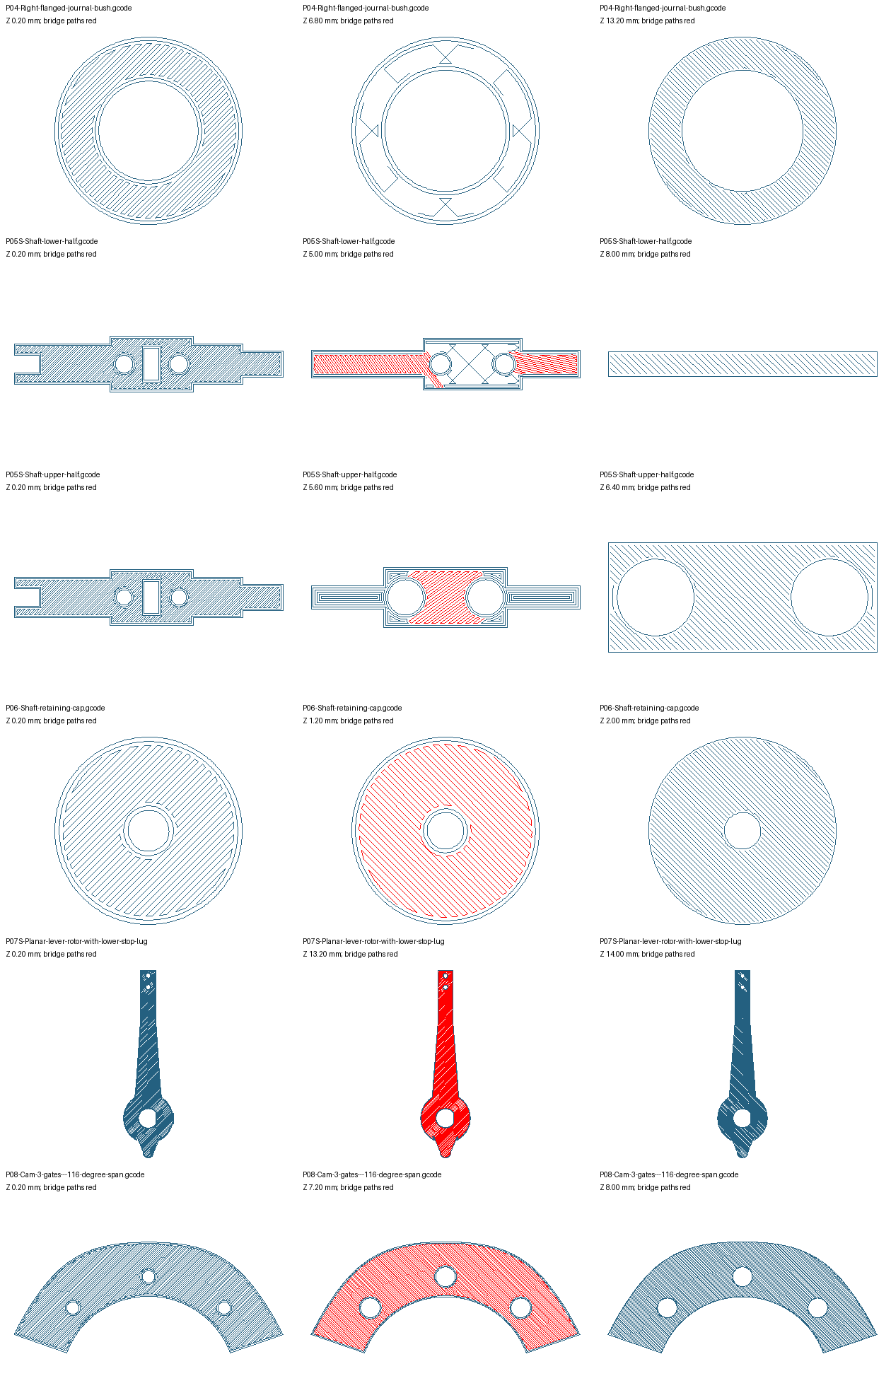
docs/mechanical/fusion-controller/opposite-sides/layer-review/layers-2.png
