albertorestifo/trenino/docs/mechanical/fusion-controller/opposite-sides/layer-review/layers-3.png

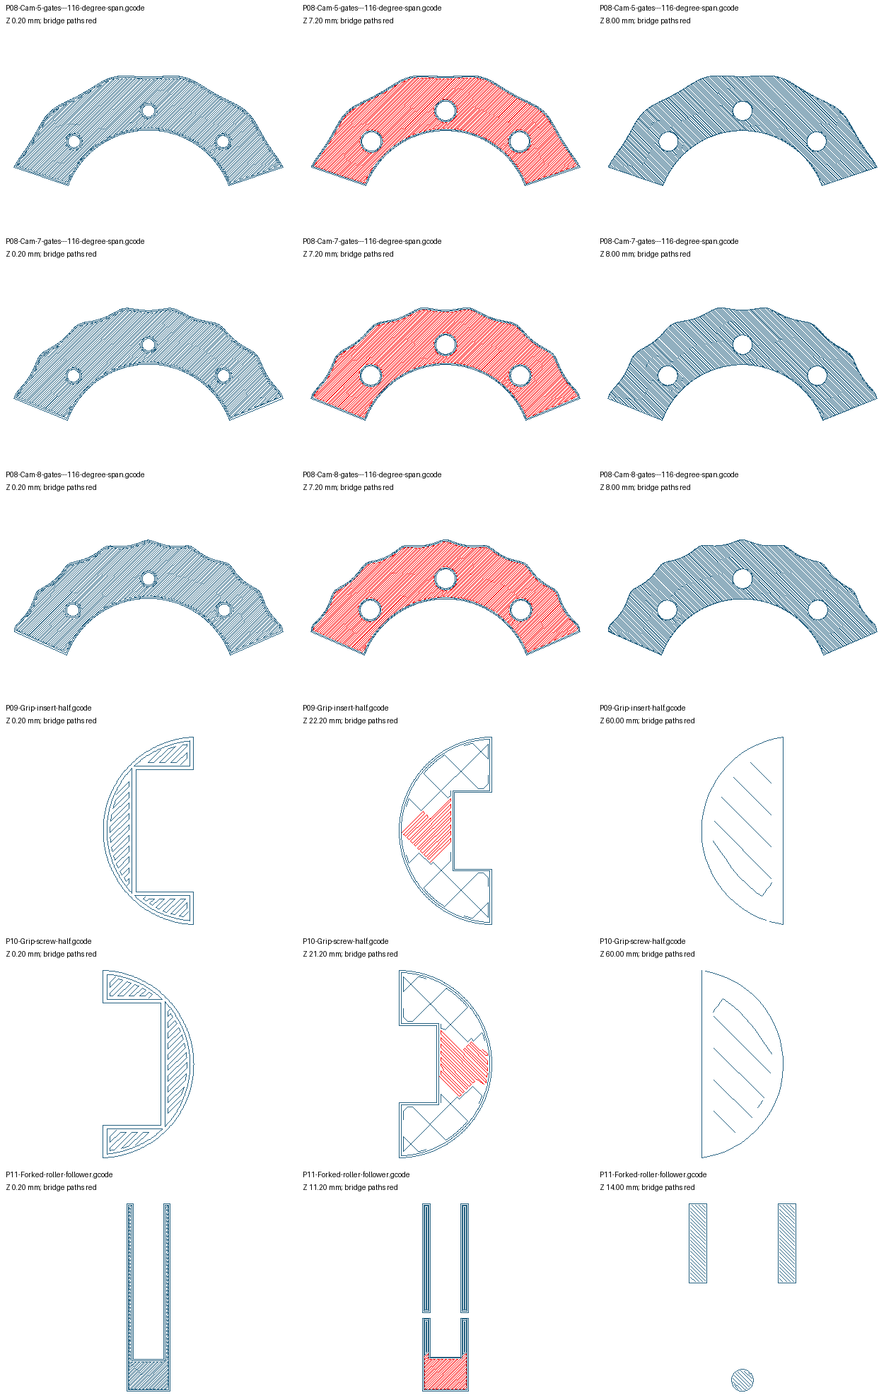
docs/mechanical/fusion-controller/opposite-sides/layer-review/layers-3.png
