albertorestifo/trenino/docs/mechanical/fusion-controller/opposite-sides/layer-review/layers-4.png

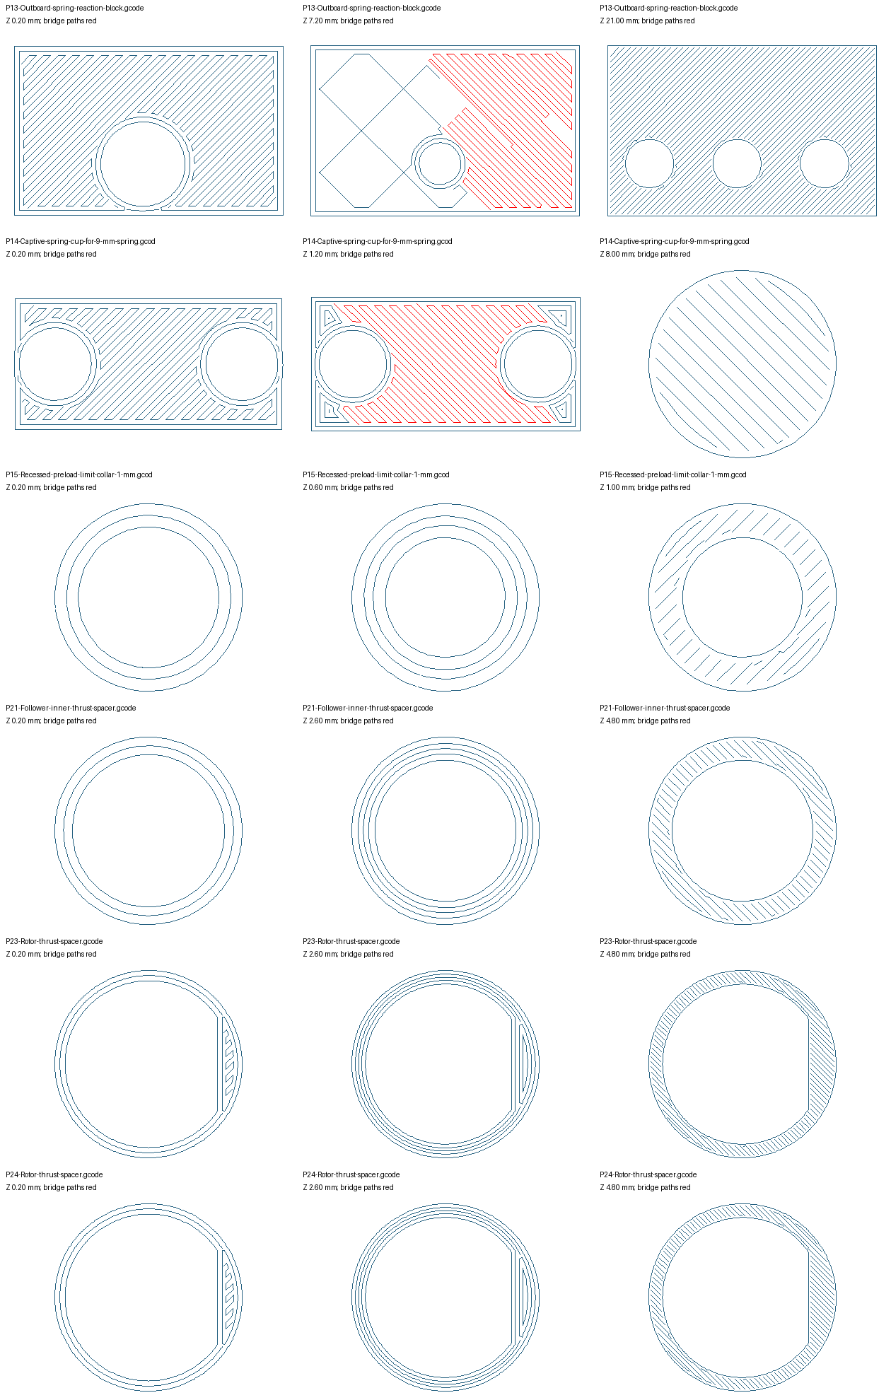
docs/mechanical/fusion-controller/opposite-sides/layer-review/layers-4.png
