albertorestifo/trenino/docs/mechanical/fusion-controller/opposite-sides/layer-review/layers-6.png

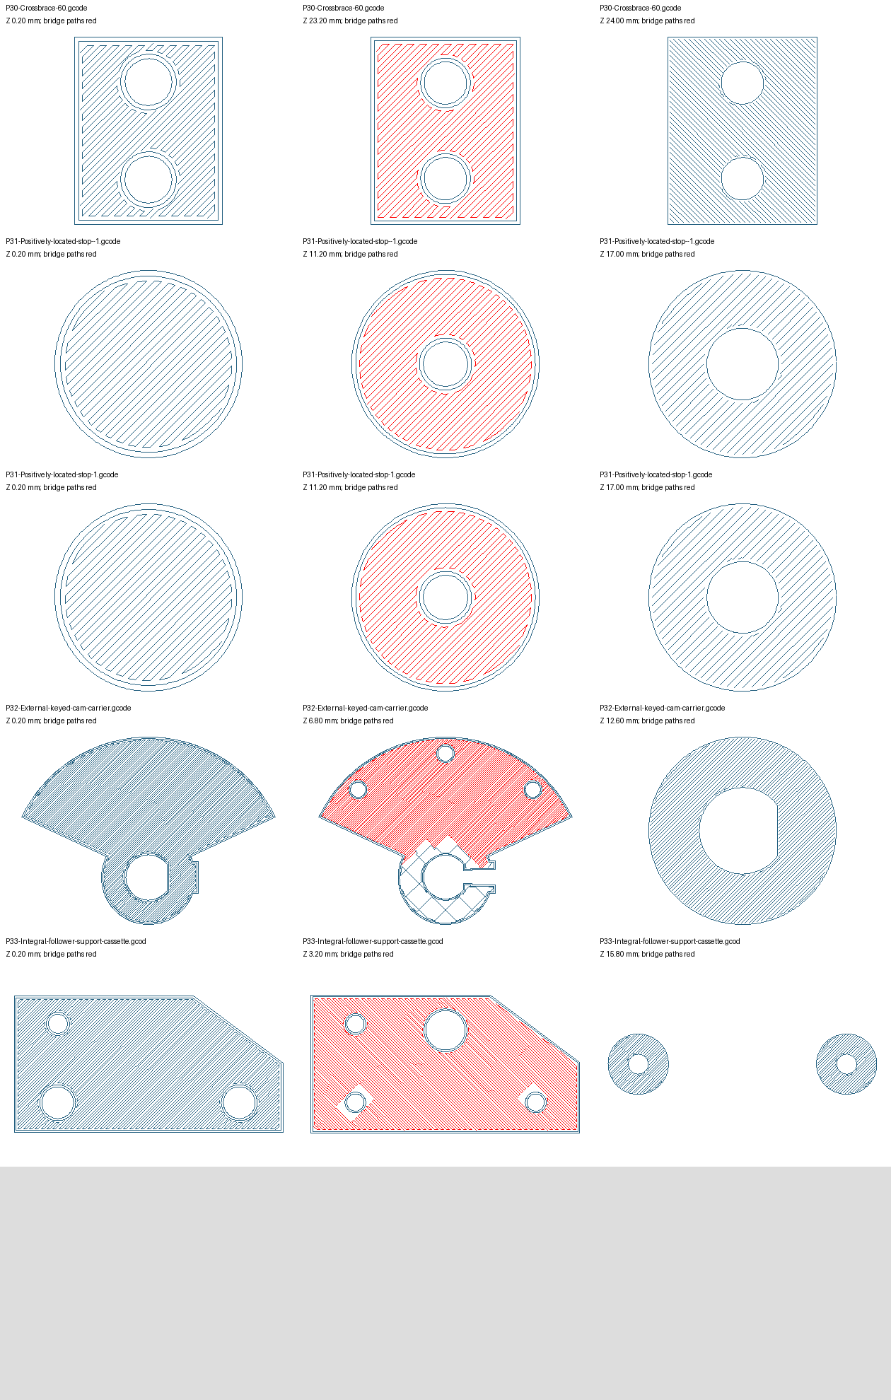
docs/mechanical/fusion-controller/opposite-sides/layer-review/layers-6.png
