albertorestifo/trenino/docs/mechanical/fusion-controller/opposite-sides/mechanism-detail.png

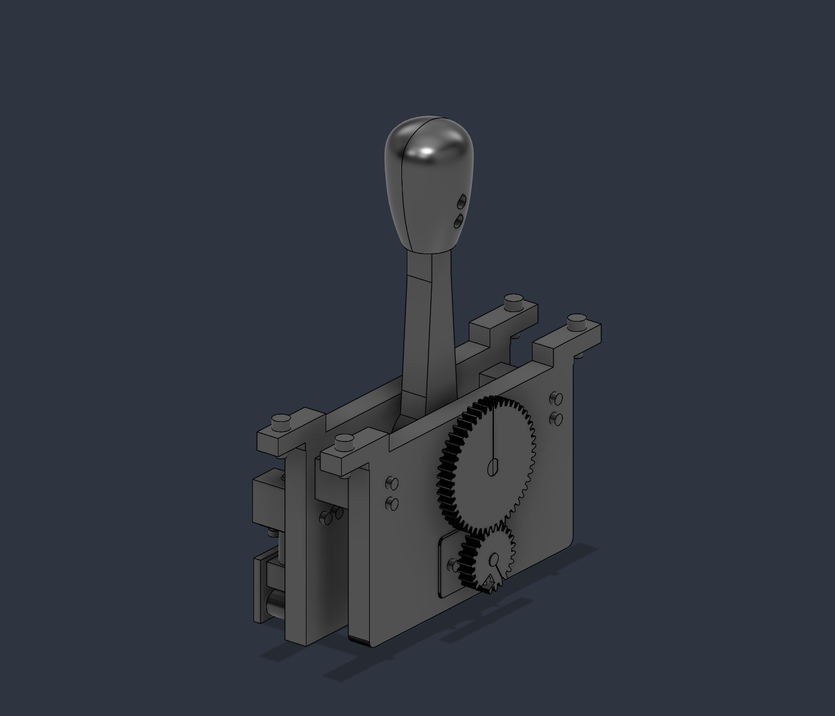
docs/mechanical/fusion-controller/opposite-sides/mechanism-detail.png
