albertorestifo/trenino/docs/mechanical/fusion-controller/raised-wide-travel/layer-review/layers-1.png

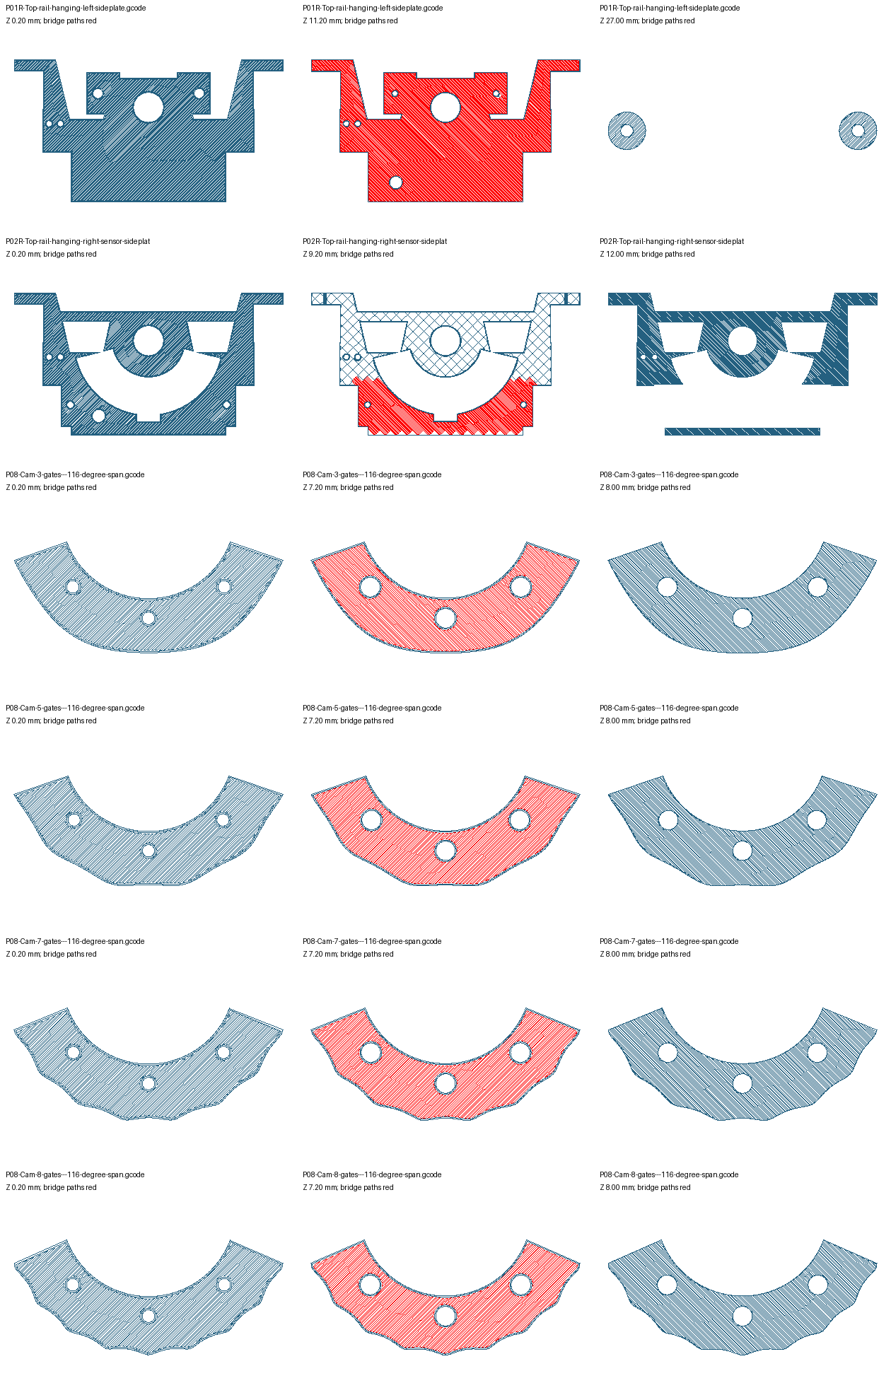
docs/mechanical/fusion-controller/raised-wide-travel/layer-review/layers-1.png
