albertorestifo/trenino/docs/mechanical/fusion-controller/raised-wide-travel/mechanism-detail.png

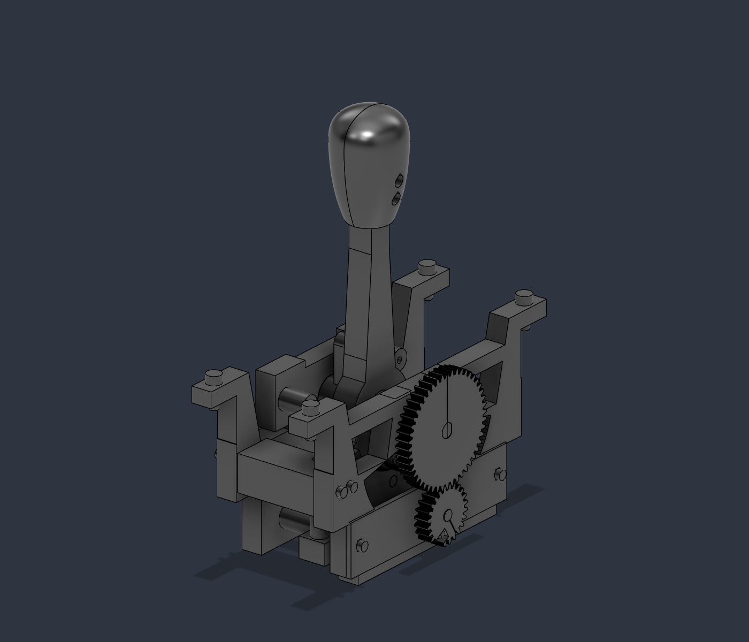
docs/mechanical/fusion-controller/raised-wide-travel/mechanism-detail.png
