albertorestifo/trenino/docs/mechanical/fusion-controller/recessed-bottom-sensor/layer-review/layers-1.png

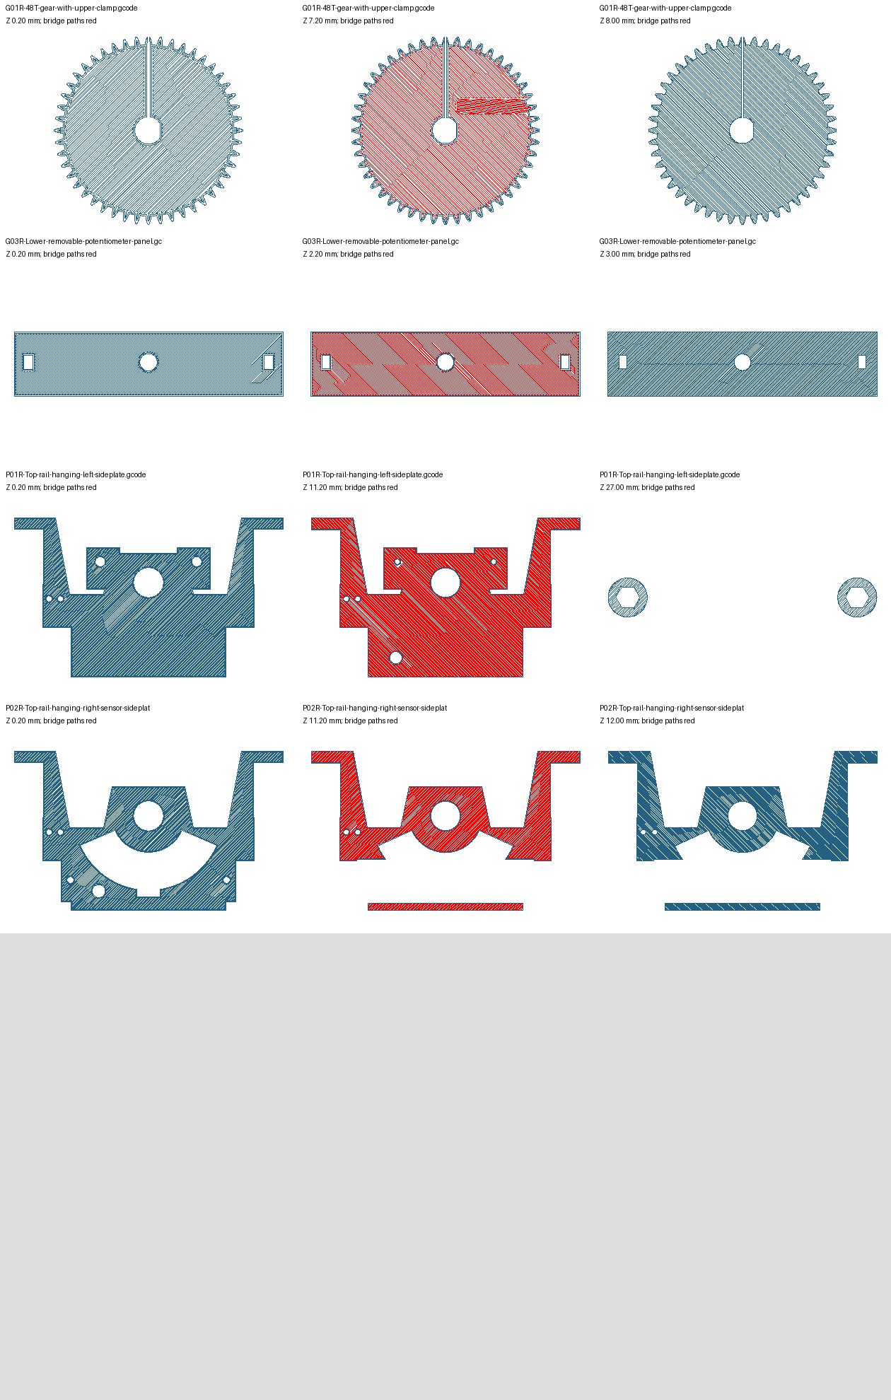
docs/mechanical/fusion-controller/recessed-bottom-sensor/layer-review/layers-1.png
