albertorestifo/trenino/docs/mechanical/fusion-controller/support-revision/disc-bridge-preview.png

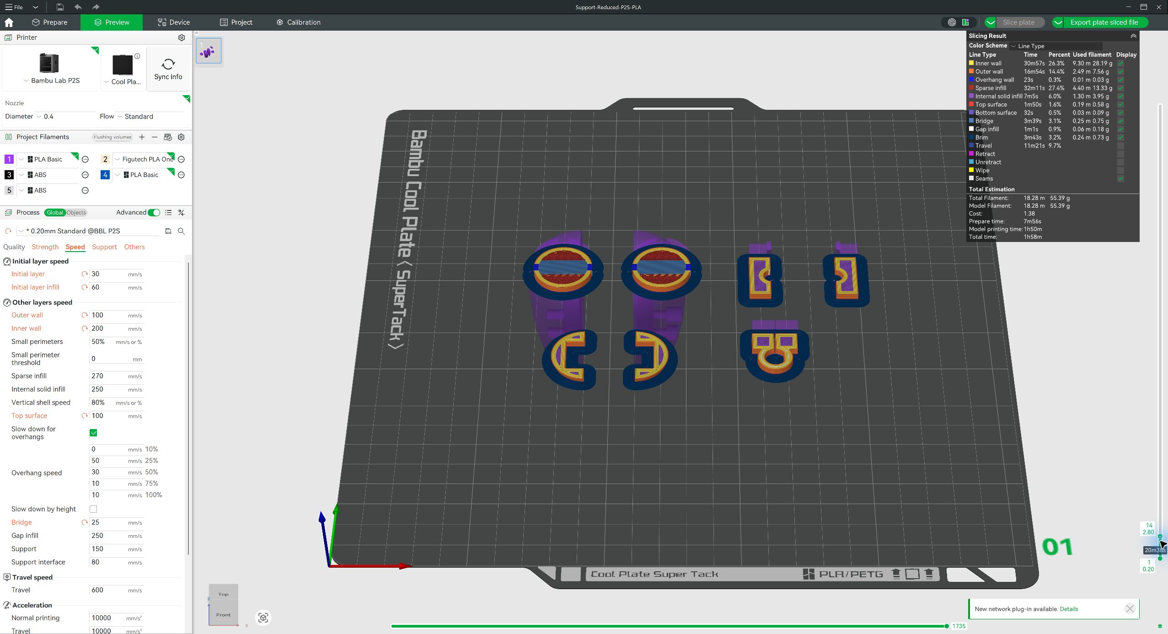
docs/mechanical/fusion-controller/support-revision/disc-bridge-preview.png
