albertorestifo/trenino/docs/mechanical/integrated-internals.png

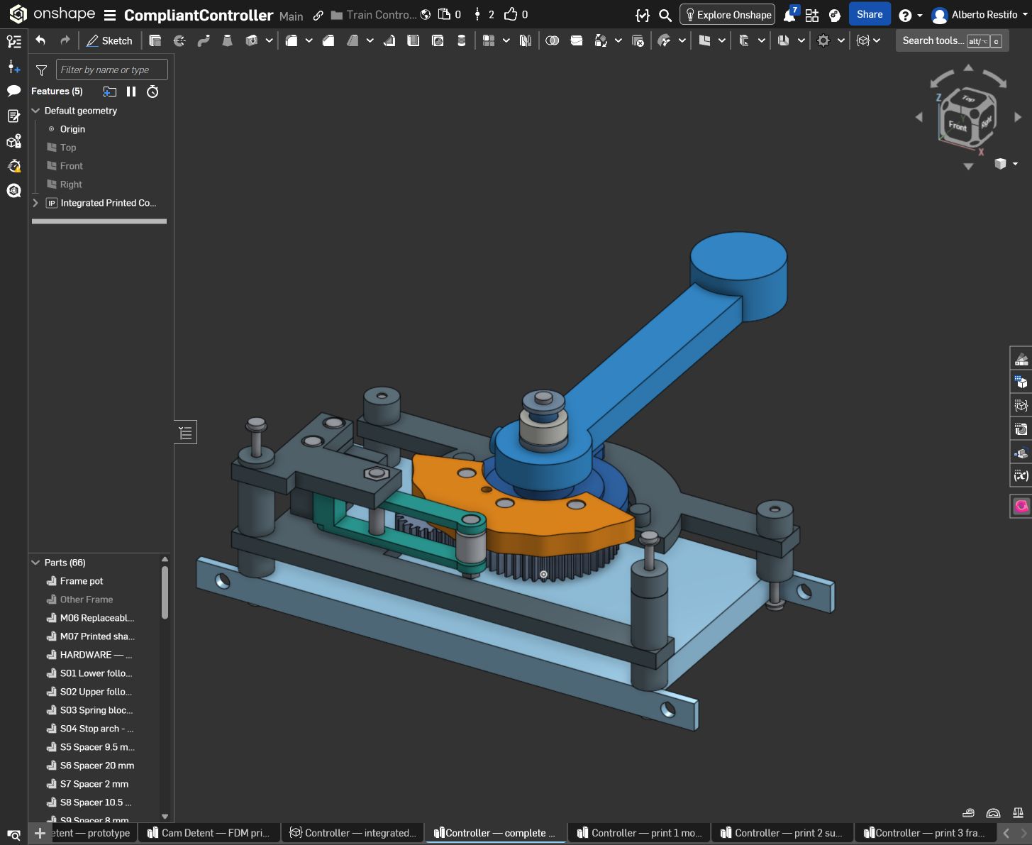
docs/mechanical/integrated-internals.png
