albertorestifo/trenino/docs/mechanical/integrated-stack.png

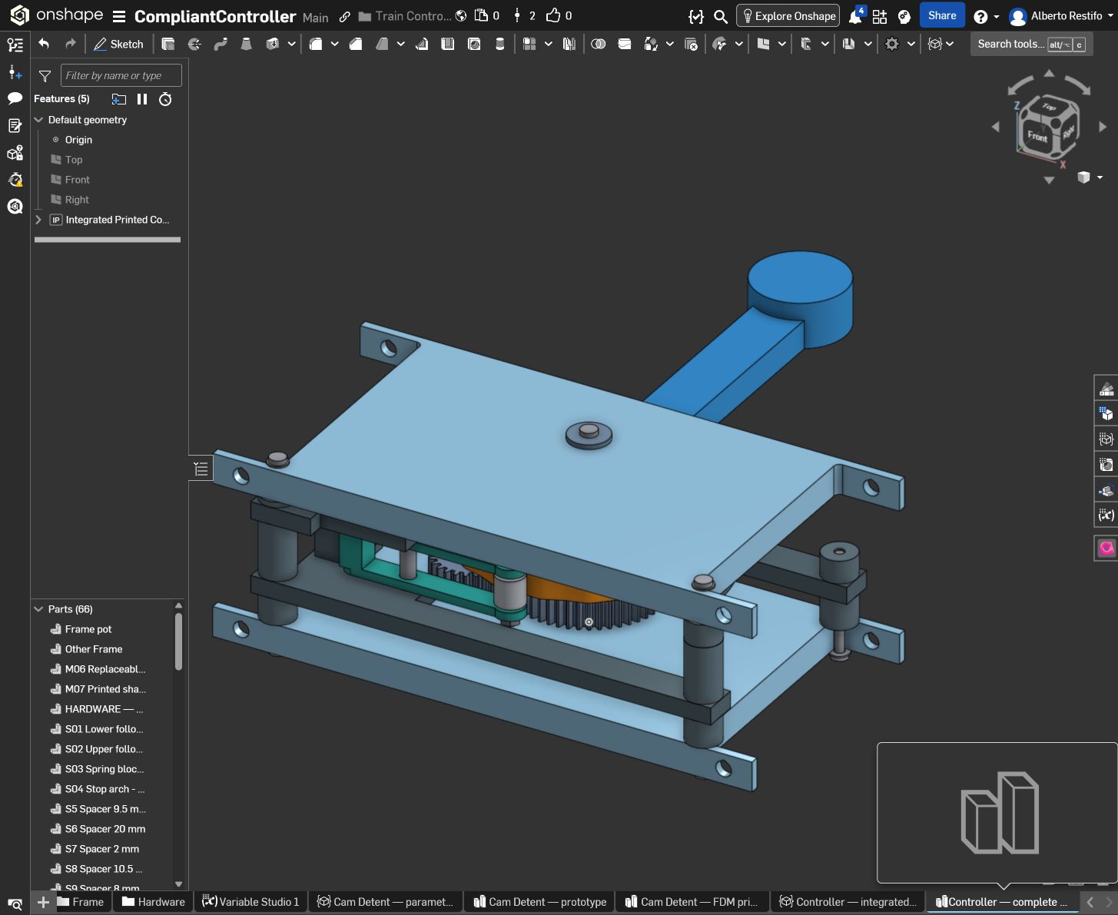
docs/mechanical/integrated-stack.png
