albertorestifo/trenino/docs/mechanical/reviewed-internals.png

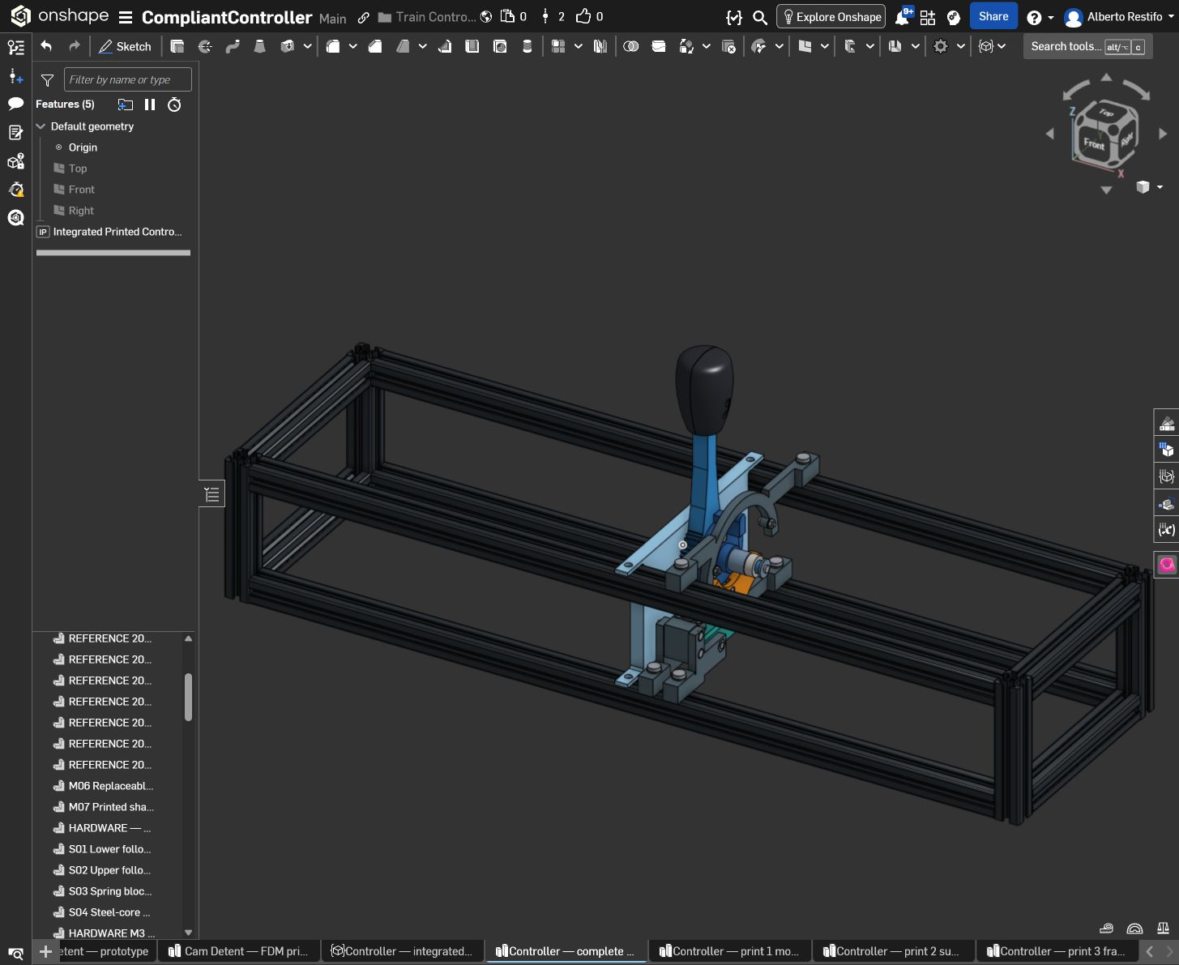
docs/mechanical/reviewed-internals.png
