albertorestifo/trenino/docs/mechanical/fusion-controller/CHANGED-PARTS-PRINT.md

# Changed parts - P2S PLA prototype

Print only P01, P02, P25 and P26, one of each. The saved Bambu Studio project contains these four parts on one plate, already oriented and arranged. P01/P02 lie on their broad faces; P25/P26 stand on their annular ends with 5 mm outer brims.

Use Changed-Parts-P2S-PLA.3mf for the editable project, or Changed-Parts-P2S-PLA.gcode.3mf for the sliced plate. Prepared with Bambu Studio 2.4.0.70, P2S 0.4 mm standard-flow nozzle, Bambu PLA Basic, Cool Plate SuperTack. This is the existing selected plate/material; confirm those match the physical plate and loaded filament before sending. Re-slice if either differs. No print was sent or started.

Settings: 0.20 mm layers, five walls, five top and bottom layers, 35% gyroid, normal automatic supports, 0.20 mm support Z clearance, 0.35 mm support XY clearance, 5 mm outer brim with 0.1 mm gap, no raft. Outer walls and top surfaces 100 mm/s, inner walls 200 mm/s, first layer 30 mm/s and first-layer infill 60 mm/s. Installed filament profile supplies 220 C nozzle and 40 C bed. Estimate: 5h26m, 168.29 g including supports and brims. Support layers may use independent finer heights.

Remove the brims and the small supports at the horizontal rail holes and side holes. Verify M5 screw clearance and the 3.4 mm insert bores without forcing hardware. These small printed centering inserts fit inside the existing metal pivot sleeve; they are not substitutes for that sleeve.

Updated hardware: four M5 x16 button-head rail screws with 3 mm TOTAL metal washer/spacer stack each, using your matching top-slot M5 T-nuts. Two M3 x25 stop screws and one M3 x80 follower pivot screw use M3 locknuts and 0.5 mm washers. Do not reuse the obsolete M5 stop/pivot hardware or rail screw lengths. See ASSEMBLY-AND-PRINT-GUIDE.md for full assembly.

Verification: corrected native model saved as AIDesignedLever v4 with389 healthy features. No clashes above0.01 mm3 in23 sampled operating positions or tested rail-screw/stop-nut insertion and driver paths. Exported meshes are closed, single connected solids with consistent winding. Bambu Studio reported Slice ok; first-layer contact, local supports and overall toolpaths were inspected. Fit and strength remain physical prototype checks.
