albertorestifo/trenino/docs/mechanical/fusion-controller/inventory-support-free-revision/FRESH-TASK-HANDOFF.md

# Current status

CURRENT: 25 October 2026 — AIDesignedLever v6, saved/unmodified in Fusion Admin Project.
Work completed here directly, without further agents.
Native: inventory-support-free-revision/Inventory-Compact-Lever.f3d
Geometry: inventory-support-free-revision/stl/ (30 files, 3 alternative cams; print one)
Read ASSEMBLY-AND-PRINT-GUIDE.md and VALIDATION.md for current instructions.
All meshes closed/consistent/on bed; all 30 diagnostic slices generated layers without supports.
No printer-ready G-code: CLI metadata/T65535 errors unresolved. Re-slice STLs in GUI using selected defaults.
No print started and no inventory checked out. Physical stock recount, sensor fit/supplied mounting hardware, spring solid height/rate and printed structural strength remain unresolved.
Previous handoff preserved under inventory-support-free-revision/historical-v5-docs/.
Do not rerun incremental Fusion mutation scripts 33–40. Final geometry already exists in v6.

Historical investigation detail: INVESTIGATIONS.md.
