albertorestifo/trenino/docs/mechanical/fusion-controller/changed-parts-bambu-preview.png

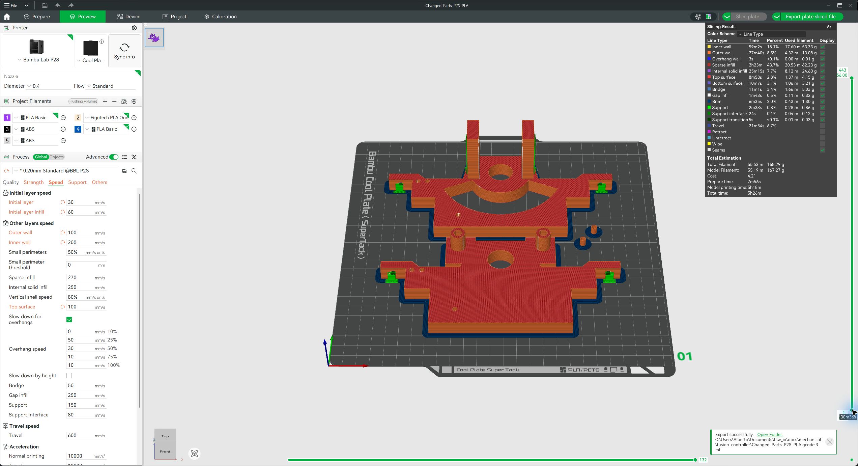
docs/mechanical/fusion-controller/changed-parts-bambu-preview.png
