albertorestifo/trenino/docs/mechanical/fusion-controller/inventory-support-free-revision/layer-review/critical-1.png

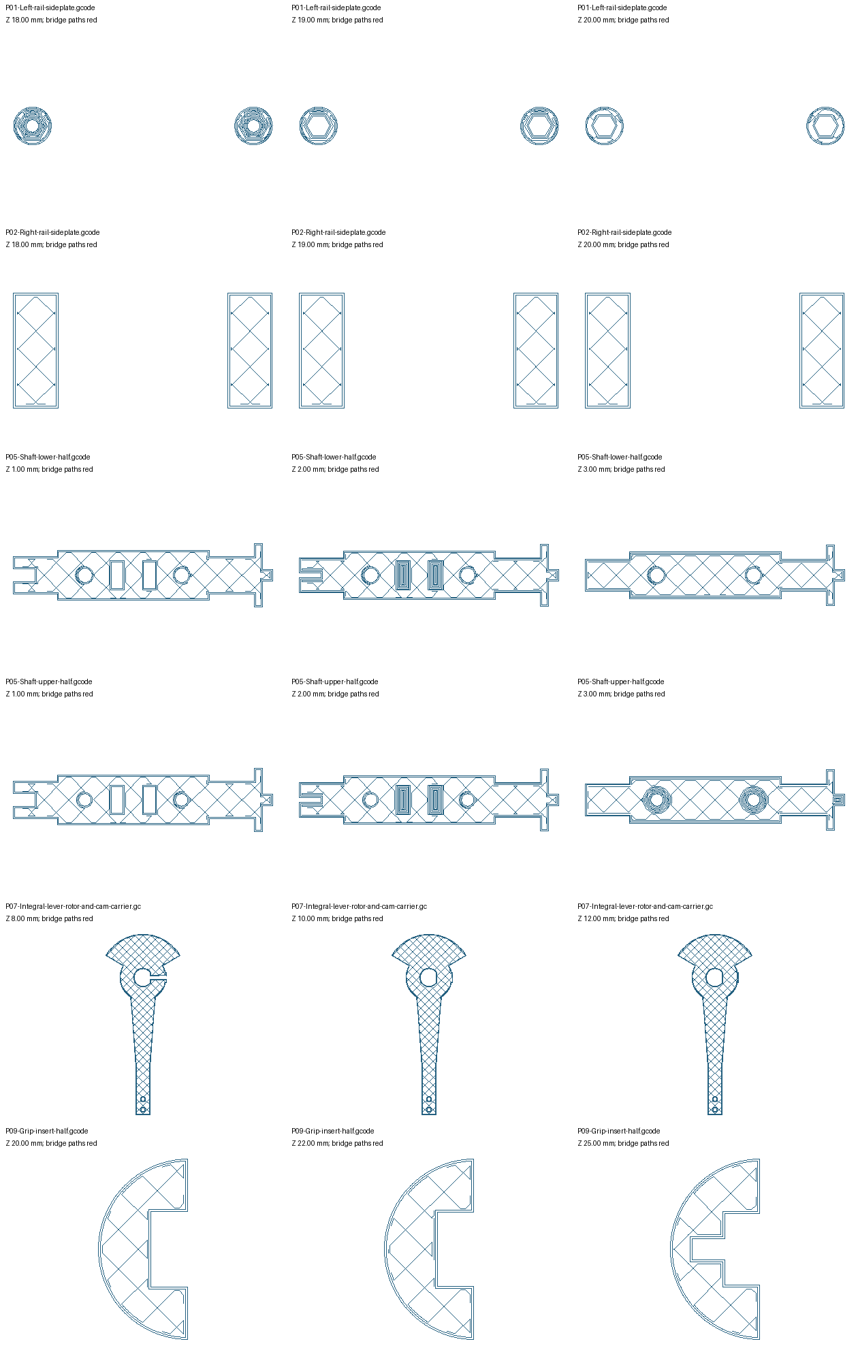
docs/mechanical/fusion-controller/inventory-support-free-revision/layer-review/critical-1.png
