albertorestifo/trenino/docs/mechanical/fusion-controller/inventory-support-free-revision/layer-review/layers-1.png

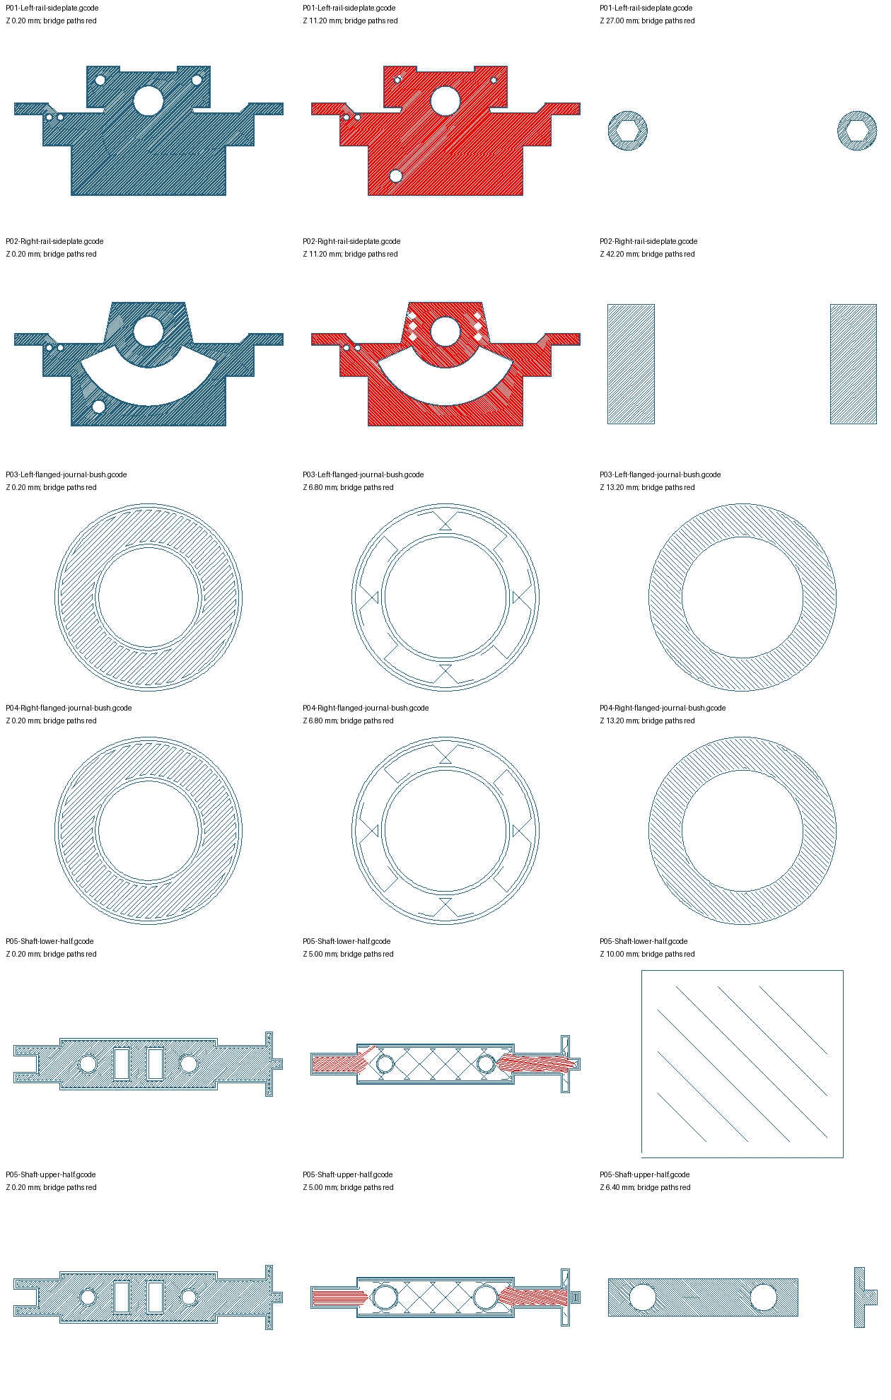
docs/mechanical/fusion-controller/inventory-support-free-revision/layer-review/layers-1.png
