albertorestifo/trenino/docs/mechanical/fusion-controller/inventory-support-free-revision/layer-review/layers-2.png

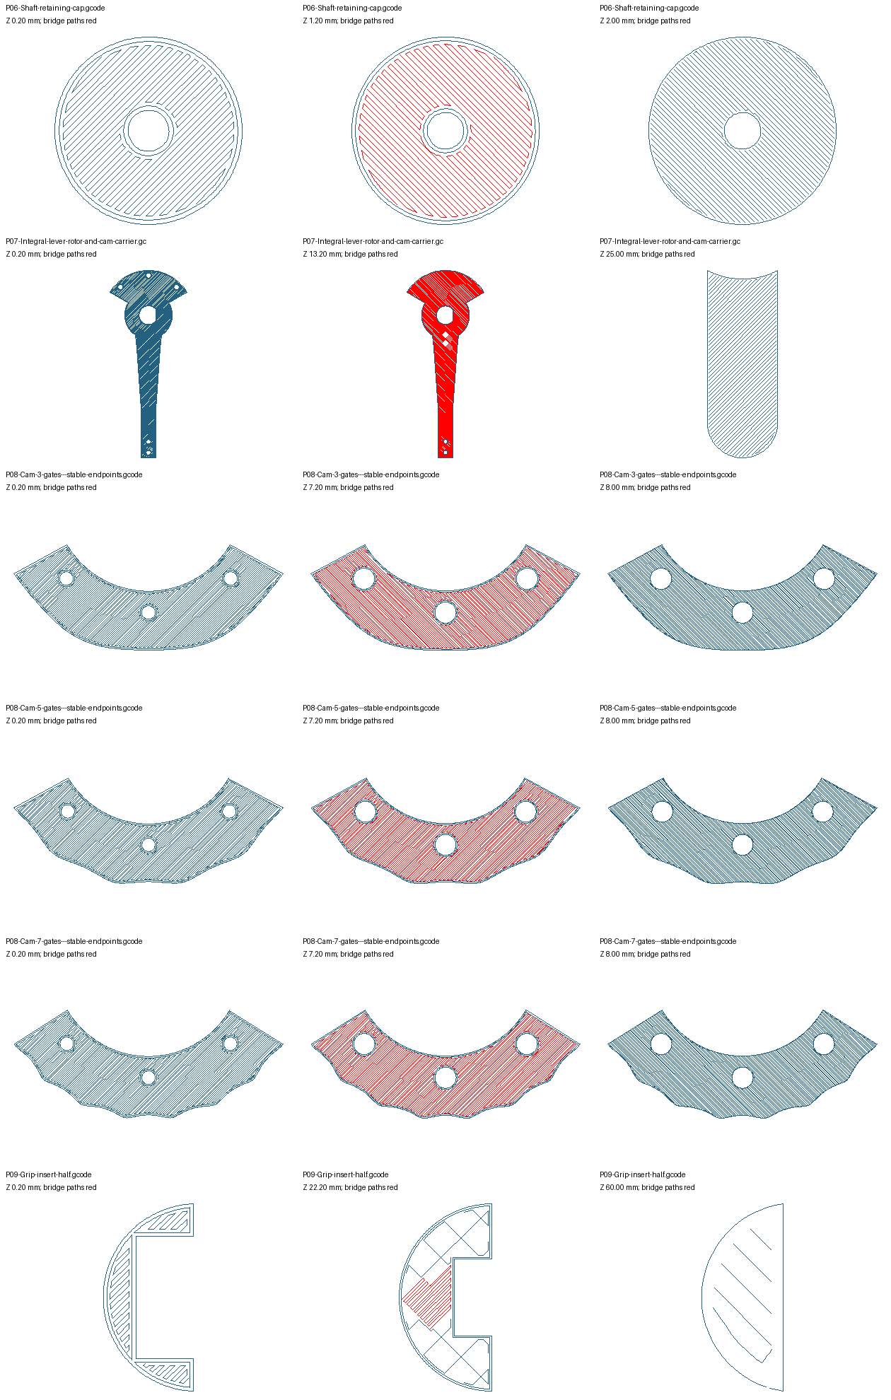
docs/mechanical/fusion-controller/inventory-support-free-revision/layer-review/layers-2.png
