albertorestifo/trenino/docs/mechanical/fusion-controller/sliced/P05-Printed-main-shaft---horizontal-print.gcode.3mf

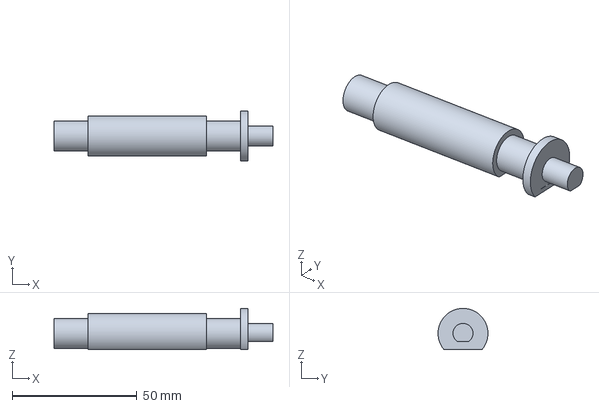
[picture p38: CAD file, 2026-10-25]
docs/mechanical/fusion-controller/sliced/P05-Printed-main-shaft---horizontal-print.gcode.3mf
87.7 x 20.0 x 16.5 mm
