albertorestifo/trenino/docs/mechanical/reviewed-print/sliced/moving-M04-One-piece-lever-and-original-48T-main-gear-id11.gcode.3mf

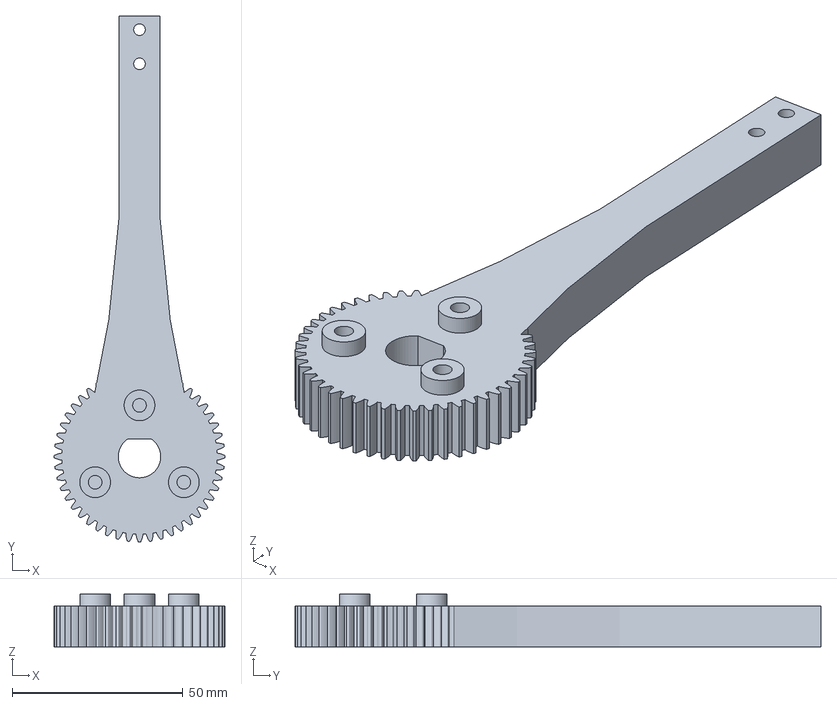
[picture p39: CAD file, 2026-10-25]
docs/mechanical/reviewed-print/sliced/moving-M04-One-piece-lever-and-original-48T-main-gear-id11.gcode.3mf
50.0 x 154.0 x 15.5 mm
