albertorestifo/trenino/docs/mechanical/Cam-Detent-FDM-P2S-layout.3mf

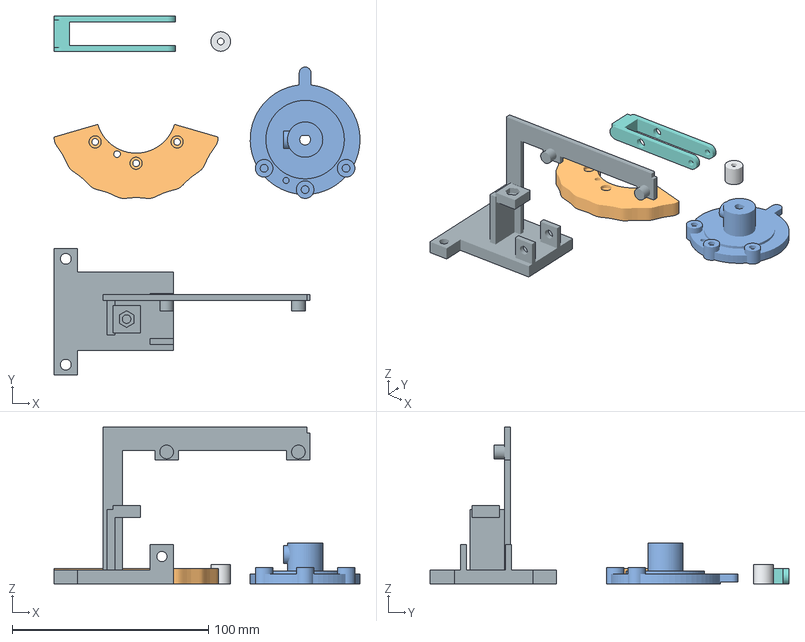
[picture p40: CAD file, 2026-10-25]
docs/mechanical/Cam-Detent-FDM-P2S-layout.3mf
156.0 x 183.0 x 80.0 mm
02 — Hub — flat carrier underside down
04 — Fork — long flat side down — bore supports
01 — Roller — print end face down
03 — Cam — flat underside down
05 — Bracket — mounting face down — supports required
