albertorestifo/trenino/docs/mechanical/fdm-stl/Cam Detent — FDM print layout - 02 — Hub — flat carrier underside down.stl

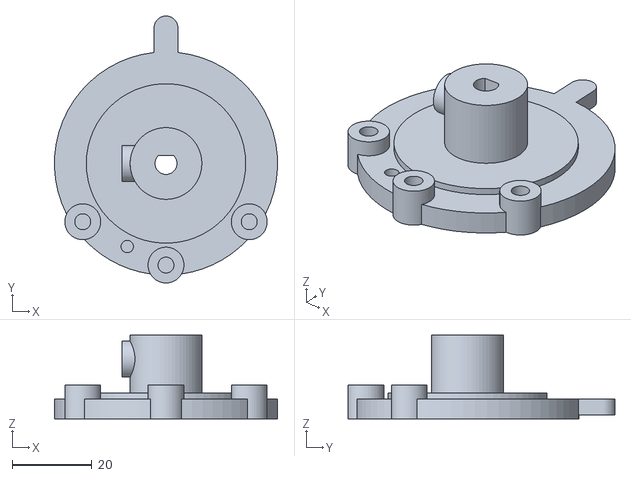
[picture p41: CAD file, 2026-10-25]
docs/mechanical/fdm-stl/Cam Detent — FDM print layout - 02 — Hub — flat carrier underside down.stl
56.0 x 67.0 x 21.0
