albertorestifo/trenino/docs/mechanical/fusion-controller/direct-v6-build-fixes/diagnostic-slices/P05-Shaft-lower-half.gcode.3mf

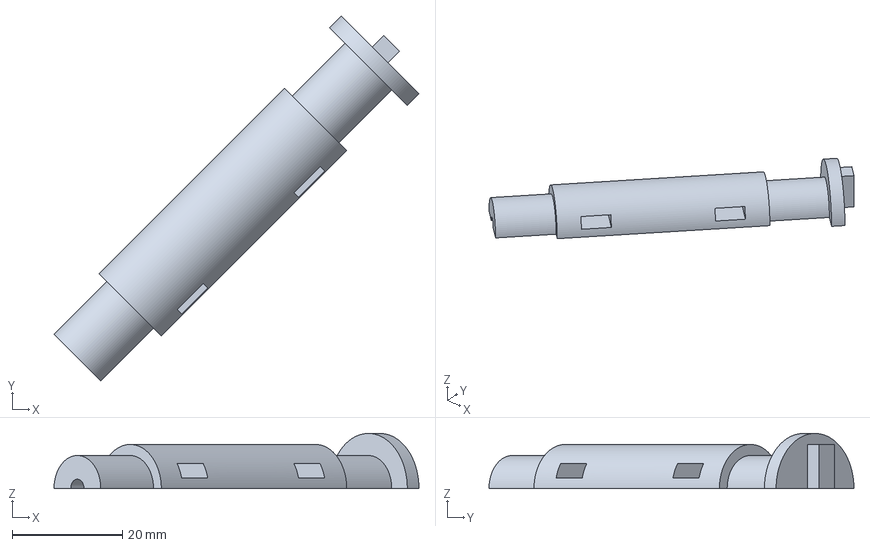
[picture p42: CAD file, 2026-10-25]
docs/mechanical/fusion-controller/direct-v6-build-fixes/diagnostic-slices/P05-Shaft-lower-half.gcode.3mf
66.3 x 66.3 x 10.00 mm
