albertorestifo/trenino/docs/mechanical/fusion-controller/direct-v6-build-fixes/optional-stl/P07-Integral-lever-rotor-and-cam-carrier.stl

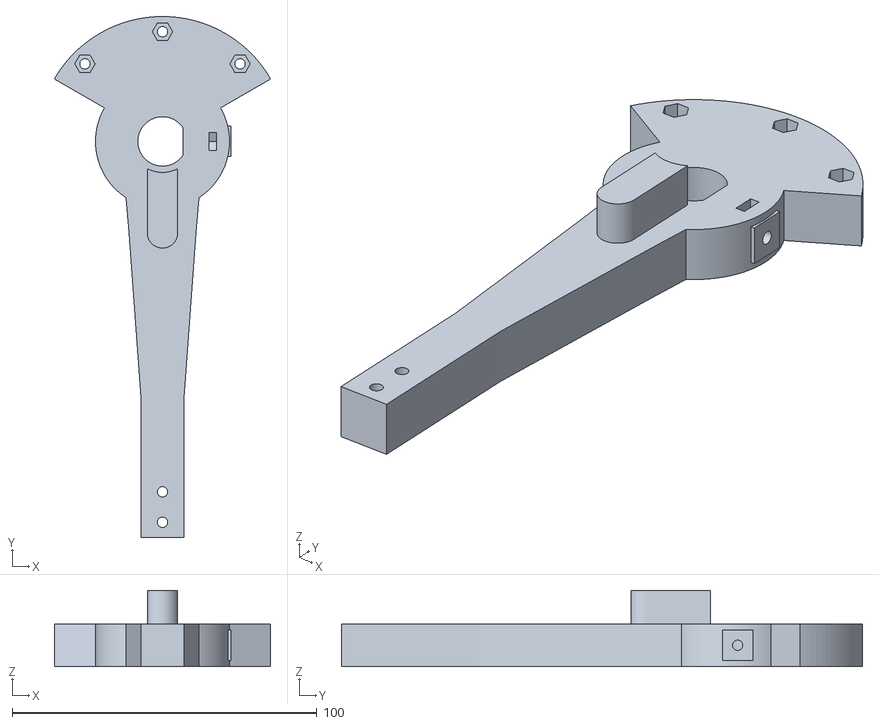
[picture p43: CAD file, 2026-10-25]
docs/mechanical/fusion-controller/direct-v6-build-fixes/optional-stl/P07-Integral-lever-rotor-and-cam-carrier.stl
71.0 x 171.0 x 25.0
