albertorestifo/trenino/docs/mechanical/fusion-controller/direct-v6-build-fixes/P05-lower-before-bed-rotation.stl

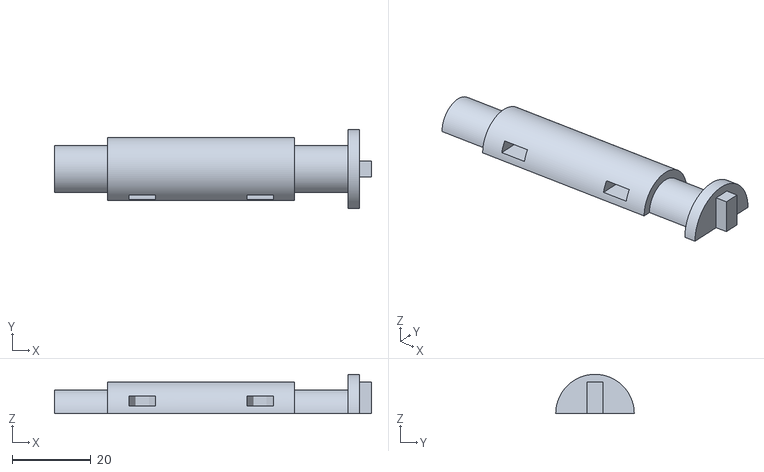
[picture p44: CAD file, 2026-10-25]
docs/mechanical/fusion-controller/direct-v6-build-fixes/P05-lower-before-bed-rotation.stl
80.7 x 20.0 x 10.00
