albertorestifo/trenino/docs/mechanical/fusion-controller/direct-v6-build-fixes/raw-stl/P19-Compact-one-piece-sensor-clamp.stl

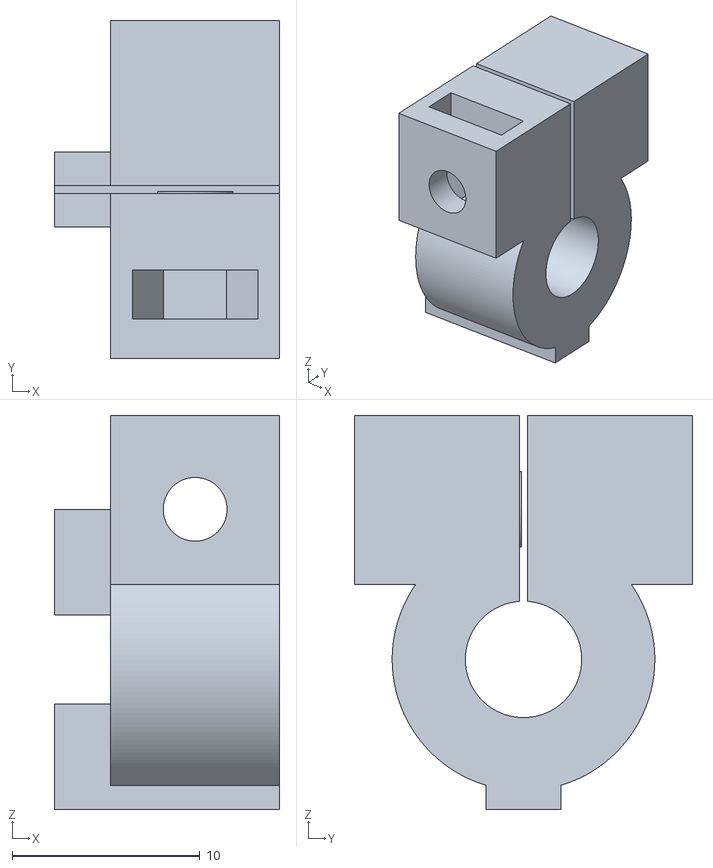
[picture p45: CAD file, 2026-10-25]
docs/mechanical/fusion-controller/direct-v6-build-fixes/raw-stl/P19-Compact-one-piece-sensor-clamp.stl
12.0 x 18.0 x 21.0
