albertorestifo/trenino/docs/mechanical/fusion-controller/direct-v6-build-fixes/required-stl/P13-Spring-reaction-crossblock.stl

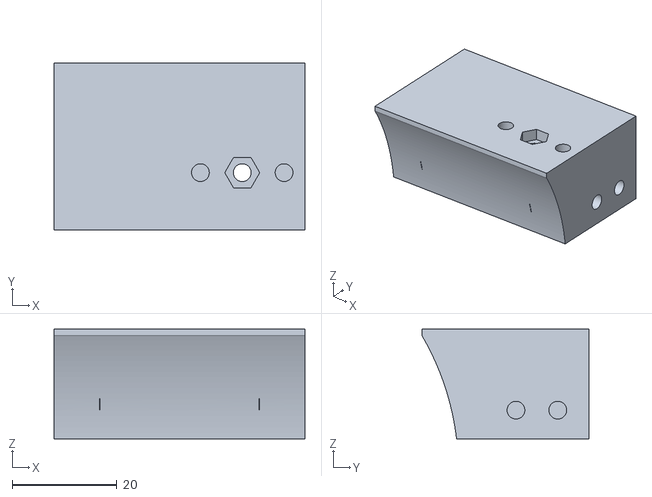
[picture p46: CAD file, 2026-10-25]
docs/mechanical/fusion-controller/direct-v6-build-fixes/required-stl/P13-Spring-reaction-crossblock.stl
48.0 x 32.0 x 21.0
