albertorestifo/trenino/docs/mechanical/fusion-controller/gear-comparison/diagnostic-lower-high.stl

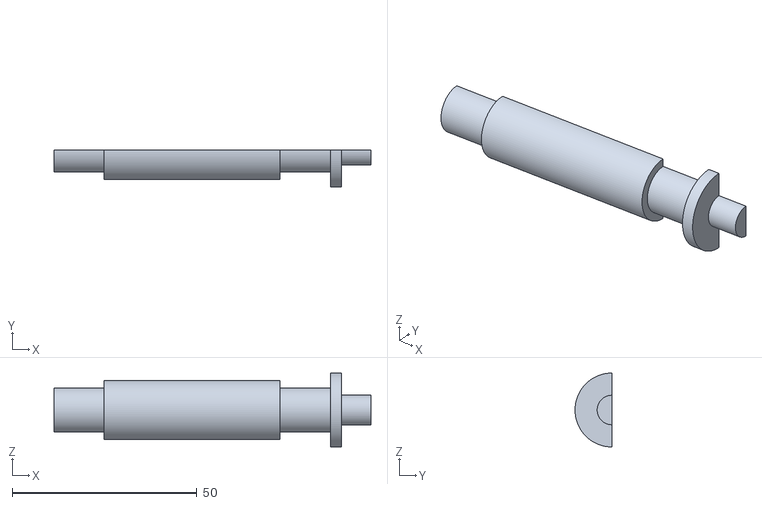
[picture p47: CAD file, 2026-10-25]
docs/mechanical/fusion-controller/gear-comparison/diagnostic-lower-high.stl
85.7 x 10.00 x 20.0
