albertorestifo/trenino/docs/mechanical/fusion-controller/gear-comparison/diagnostic-slices/P22-Follower-right-axial-spacer.gcode.3mf

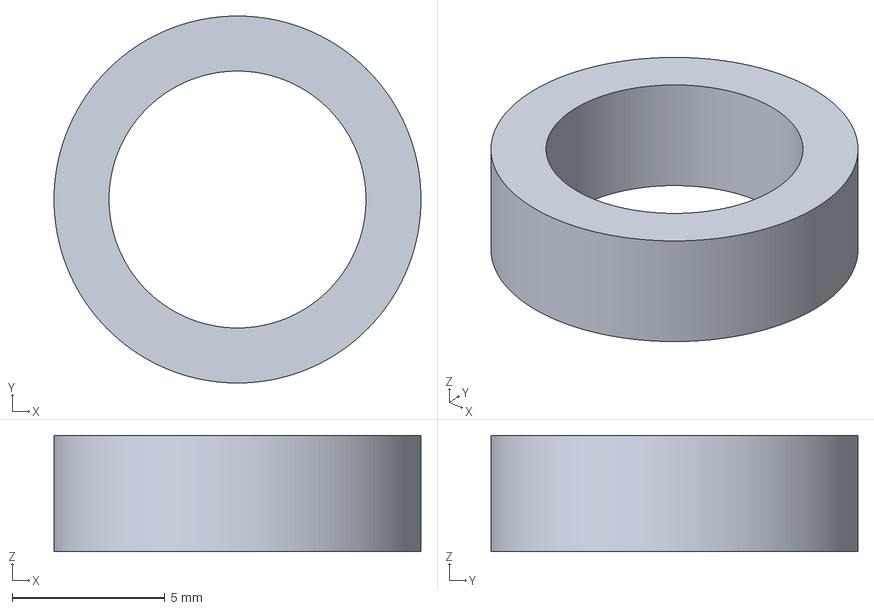
[picture p48: CAD file, 2026-10-25]
docs/mechanical/fusion-controller/gear-comparison/diagnostic-slices/P22-Follower-right-axial-spacer.gcode.3mf
12.0 x 12.0 x 3.80 mm
