albertorestifo/trenino/docs/mechanical/fusion-controller/gear-comparison/plate-slice-check/Plate-02.gcode.3mf

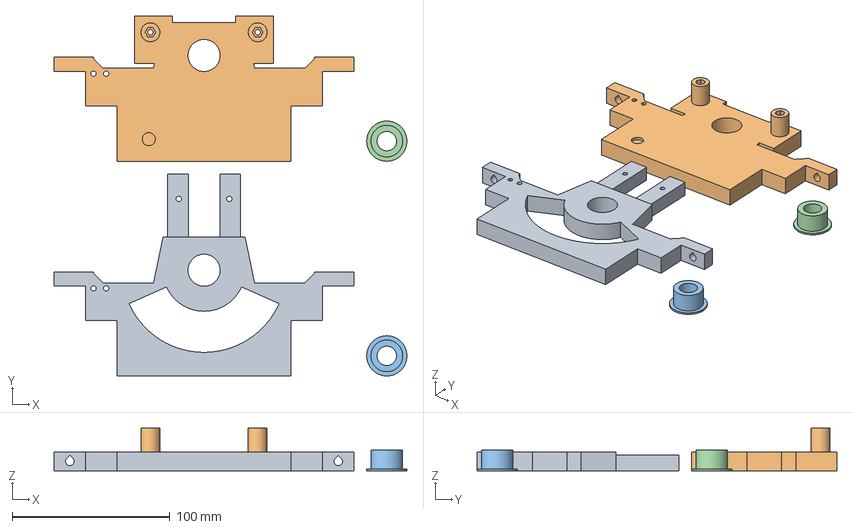
[picture p49: CAD file, 2026-10-25]
docs/mechanical/fusion-controller/gear-comparison/plate-slice-check/Plate-02.gcode.3mf
223.5 x 228.0 x 27.0 mm
P02G-Right-plate-with-upper-sensor-supports
P01-Left-rail-sideplate
P03-Left-flanged-journal-bush
P04-Right-flanged-journal-bush
