albertorestifo/trenino/docs/mechanical/fusion-controller/gear-comparison/plates/Plate-03.3mf

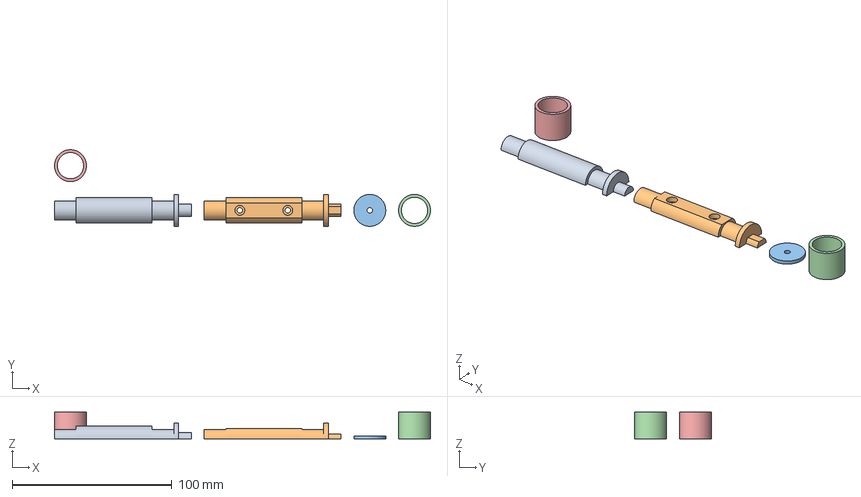
[picture p50: CAD file, 2026-10-25]
docs/mechanical/fusion-controller/gear-comparison/plates/Plate-03.3mf
235.4 x 48.0 x 16.9 mm
P05G-Shaft-lower-half
P05G-Shaft-upper-half
P06-Shaft-retaining-cap
P23-Left-rotor-thrust-spacer
P24-Right-rotor-thrust-spacer
