albertorestifo/trenino/docs/mechanical/fusion-controller/gear-comparison/stl/G01-48T-lever-gear.stl

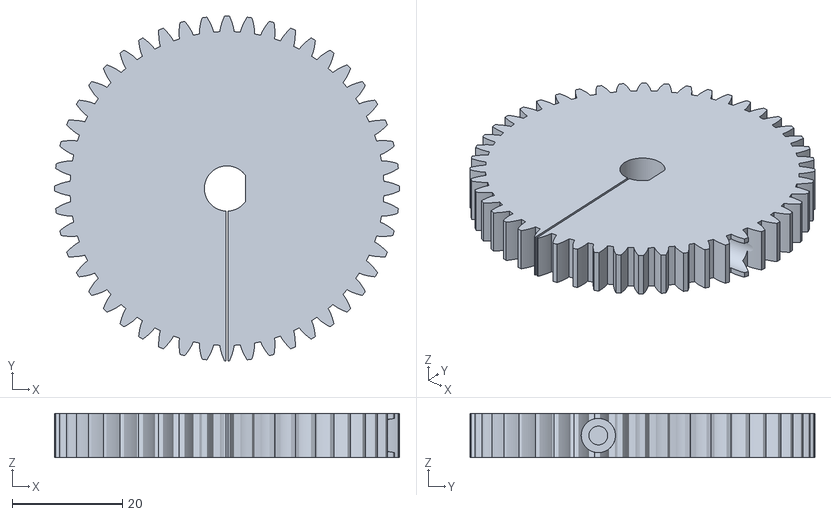
[picture p52: CAD file, 2026-10-25]
docs/mechanical/fusion-controller/gear-comparison/stl/G01-48T-lever-gear.stl
62.5 x 62.5 x 8.00
