albertorestifo/trenino/docs/mechanical/fusion-controller/inventory-support-free-revision/diagnostic-slices/P05-Shaft-upper-half.gcode.3mf

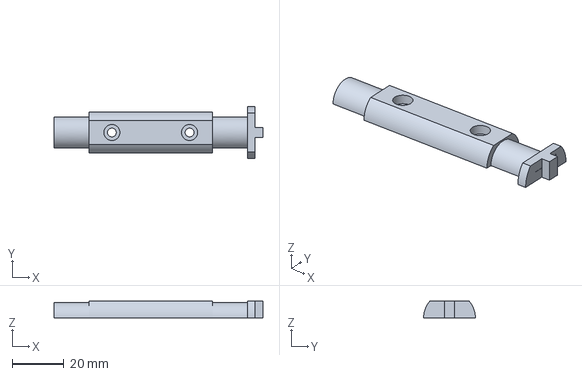
[picture p53: CAD file, 2026-10-25]
docs/mechanical/fusion-controller/inventory-support-free-revision/diagnostic-slices/P05-Shaft-upper-half.gcode.3mf
80.7 x 20.0 x 6.50 mm
