albertorestifo/trenino/docs/mechanical/fusion-controller/one-piece-shaft/diagnostic-slices/P08-Cam-9-gates-Class-323---strong-center-and-Emergency.gcode.3mf

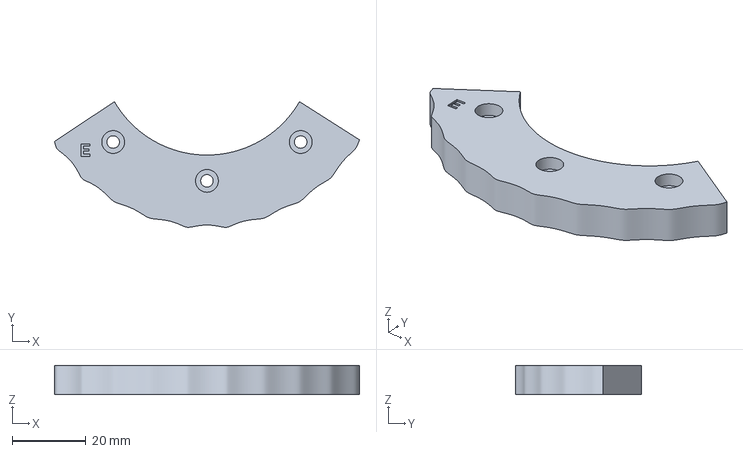
[picture p55: CAD file, 2026-10-25]
docs/mechanical/fusion-controller/one-piece-shaft/diagnostic-slices/P08-Cam-9-gates-Class-323---strong-center-and-Emergency.gcode.3mf
82.8 x 34.1 x 8.00 mm
