albertorestifo/trenino/docs/mechanical/fusion-controller/one-piece-shaft/required-stl/P04-Right-bush-upper-half.stl

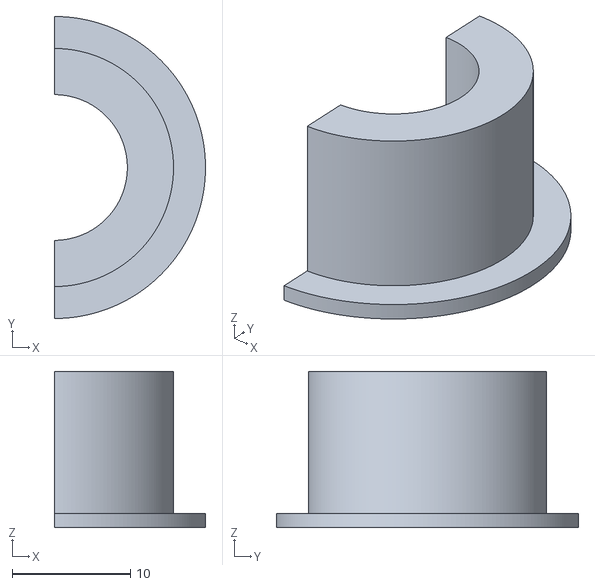
[picture p56: CAD file, 2026-10-25]
docs/mechanical/fusion-controller/one-piece-shaft/required-stl/P04-Right-bush-upper-half.stl
12.8 x 25.5 x 13.2
