albertorestifo/trenino/docs/mechanical/fusion-controller/opposite-sides/diagnostic-slices/P01S-Continuous-left-structural-plate.gcode.3mf

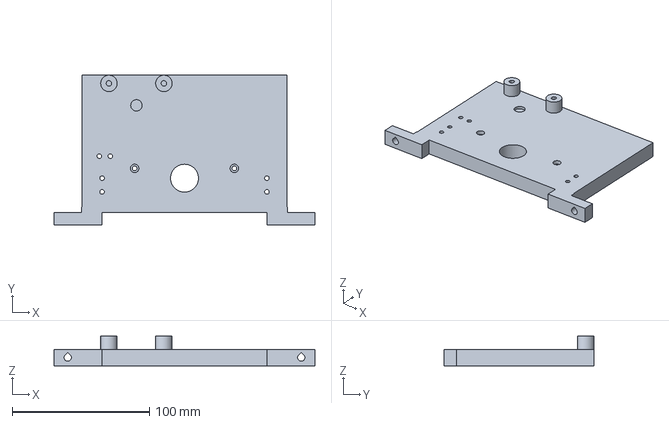
[picture p57: CAD file, 2026-10-25]
docs/mechanical/fusion-controller/opposite-sides/diagnostic-slices/P01S-Continuous-left-structural-plate.gcode.3mf
190.0 x 109.0 x 21.5 mm
