albertorestifo/trenino/docs/mechanical/fusion-controller/opposite-sides/stl/P21-Follower-inner-thrust-spacer.stl

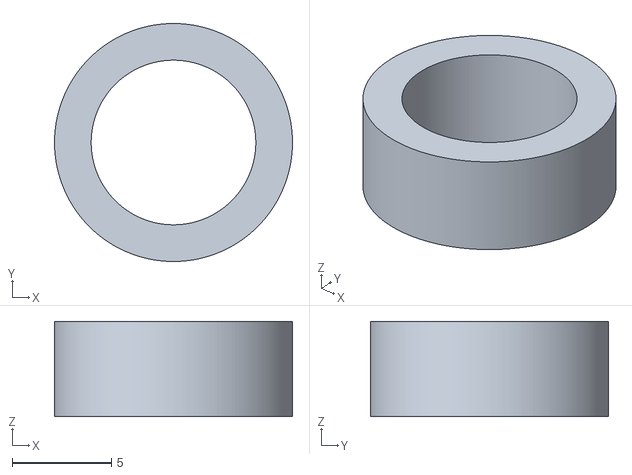
[picture p58: CAD file, 2026-10-25]
docs/mechanical/fusion-controller/opposite-sides/stl/P21-Follower-inner-thrust-spacer.stl
12.0 x 12.0 x 4.80
