albertorestifo/trenino/docs/mechanical/fusion-controller/raised-wide-travel/diagnostic-slices/P08-Cam-5-gates---116-degree-span.gcode.3mf

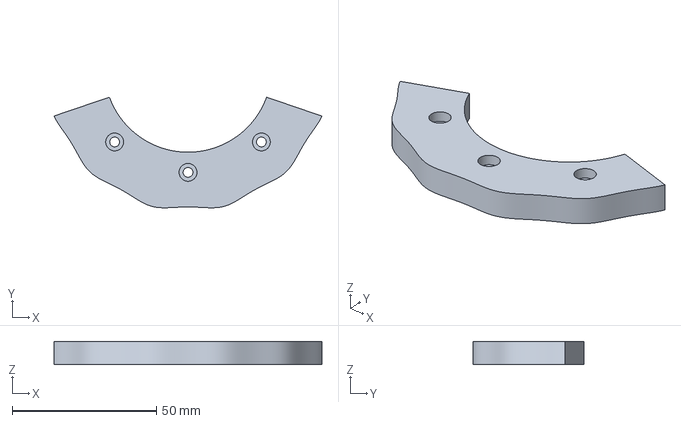
[picture p59: CAD file, 2026-10-25]
docs/mechanical/fusion-controller/raised-wide-travel/diagnostic-slices/P08-Cam-5-gates---116-degree-span.gcode.3mf
93.0 x 38.4 x 8.00 mm
