albertorestifo/trenino/docs/mechanical/fusion-controller/raised-wide-travel/raw-stl/P28-Shaft-alignment-key-5.stl

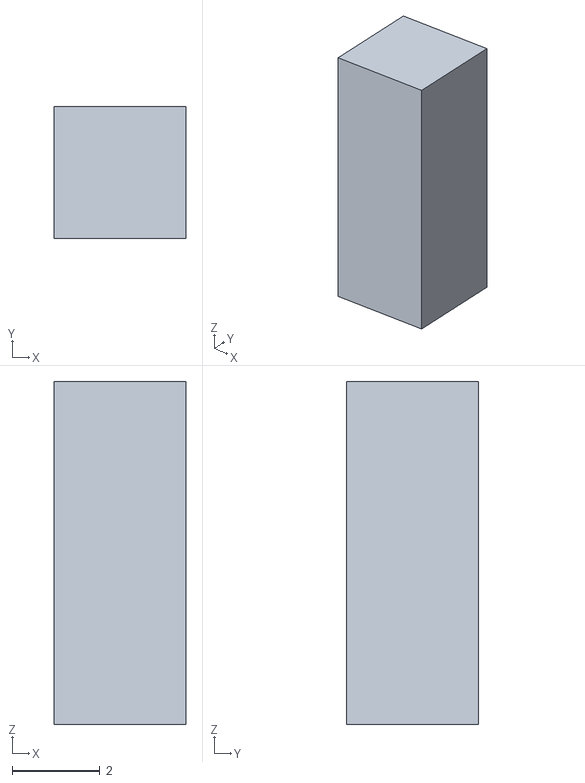
[picture p60: CAD file, 2026-10-25]
docs/mechanical/fusion-controller/raised-wide-travel/raw-stl/P28-Shaft-alignment-key-5.stl
3.00 x 3.00 x 7.80
