albertorestifo/trenino/docs/mechanical/fusion-controller/raised-wide-travel/stl/P08-Cam-3-gates---116-degree-span.stl

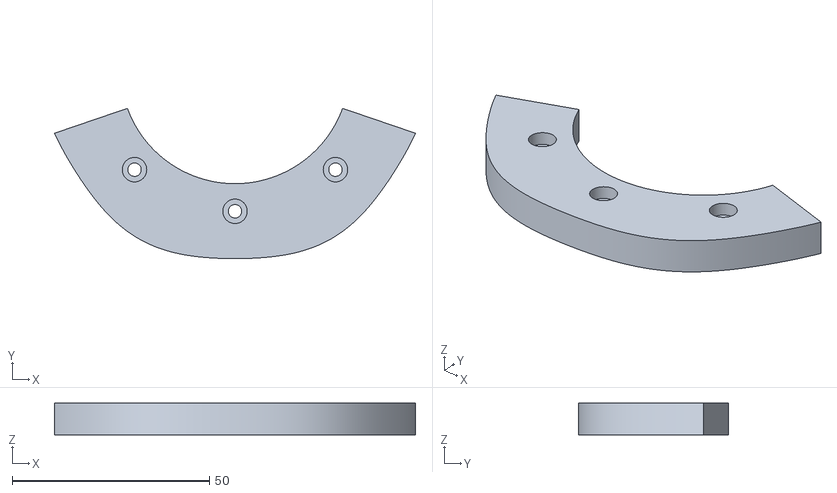
[picture p61: CAD file, 2026-10-25]
docs/mechanical/fusion-controller/raised-wide-travel/stl/P08-Cam-3-gates---116-degree-span.stl
91.5 x 38.1 x 8.00
