albertorestifo/trenino/docs/mechanical/fusion-controller/raw-stl/P19-RK097-clamp-insert-half.stl

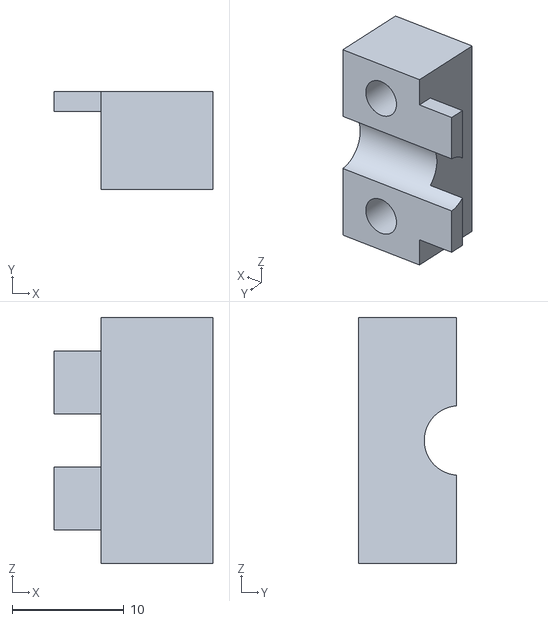
[picture p62: CAD file, 2026-10-25]
docs/mechanical/fusion-controller/raw-stl/P19-RK097-clamp-insert-half.stl
14.2 x 8.80 x 22.0
