albertorestifo/trenino/docs/mechanical/fusion-controller/recessed-bottom-sensor/diagnostic-slices/P01R-Top-rail-hanging-left-sideplate.gcode.3mf

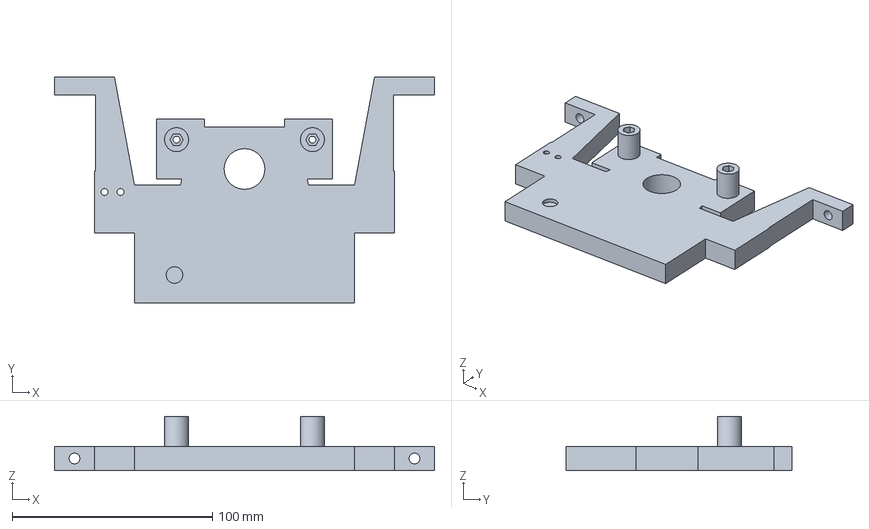
[picture p63: CAD file, 2026-10-25]
docs/mechanical/fusion-controller/recessed-bottom-sensor/diagnostic-slices/P01R-Top-rail-hanging-left-sideplate.gcode.3mf
190.0 x 113.0 x 27.0 mm
