albertorestifo/trenino/docs/mechanical/fusion-controller/sliced/P24-Right-rotor-thrust-spacer.gcode.3mf

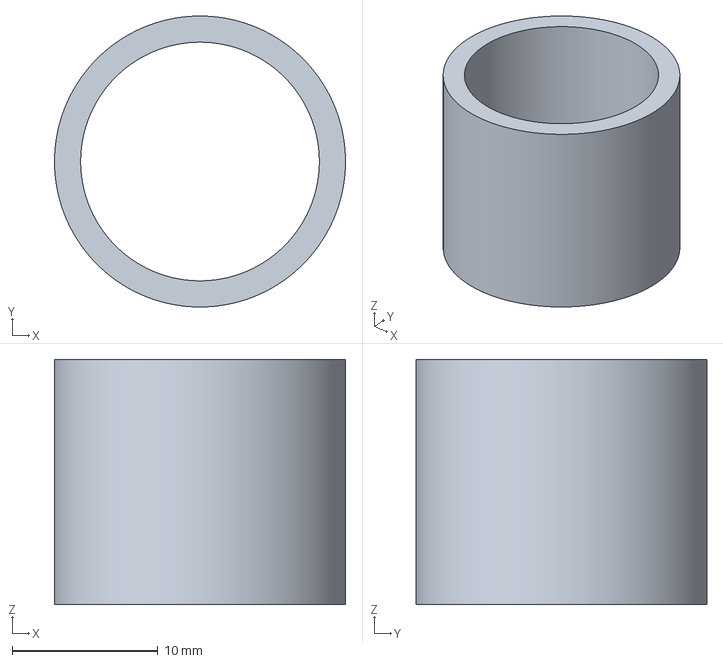
[picture p64: CAD file, 2026-10-25]
docs/mechanical/fusion-controller/sliced/P24-Right-rotor-thrust-spacer.gcode.3mf
20.0 x 20.0 x 16.9 mm
