albertorestifo/trenino/docs/mechanical/integrated-print/controller-moving.3mf

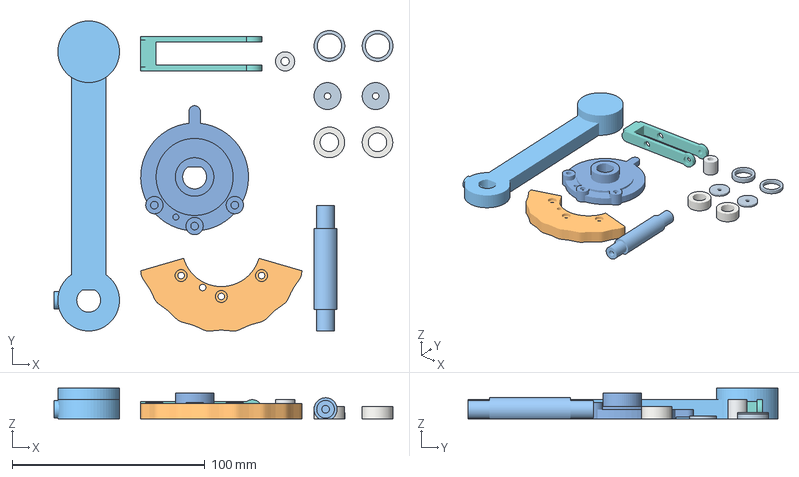
[picture p66: CAD file, 2026-10-25]
docs/mechanical/integrated-print/controller-moving.3mf
176.0 x 161.0 x 16.0 mm
M02 Printed bushing 4 - replaces 625 bearing
M07 Printed shaft carrier and stop lug
M01 Printed shaft - 12 mm D, 9.2 mm journals
M02 Printed bushing 54 - replaces 625 bearing
M06 Replaceable cam sector - 8 mm
M09 Roller - 10 mm diameter
M04 Printed lever and grip - flat underside
M05 Drive spacer 3.1999999999999993 mm
M08 Forked roller arm - 36 mm pivot radius
M03 Shaft retaining washer 64.8
M05 Drive spacer 2.5 mm
M03 Shaft retaining washer -1.9
