albertorestifo/trenino/docs/mechanical/integrated-print/stl/moving-M07-Printed-shaft-carrier-and-stop-lug-id3.stl

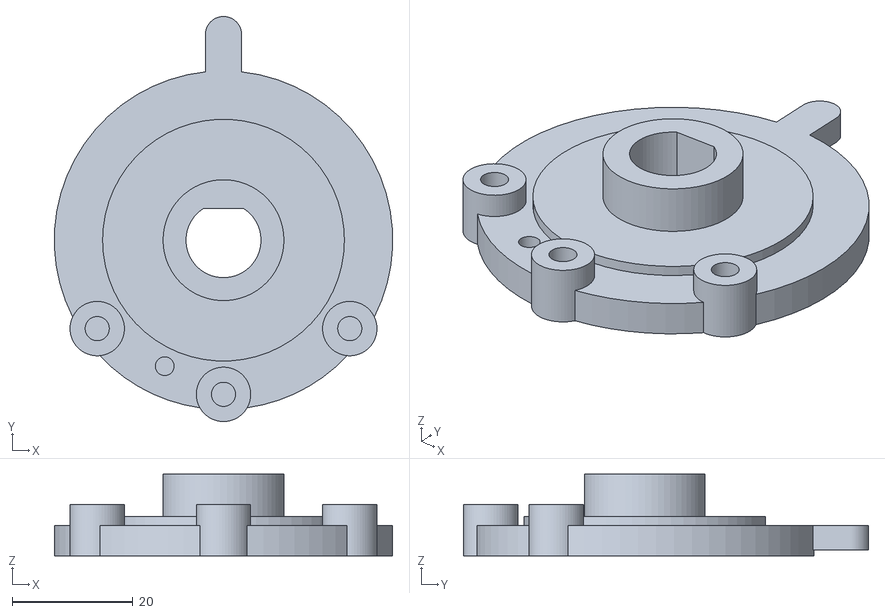
[picture p67: CAD file, 2026-10-25]
docs/mechanical/integrated-print/stl/moving-M07-Printed-shaft-carrier-and-stop-lug-id3.stl
56.0 x 67.0 x 13.5
