albertorestifo/trenino/docs/mechanical/reviewed-print/controller-frame.3mf

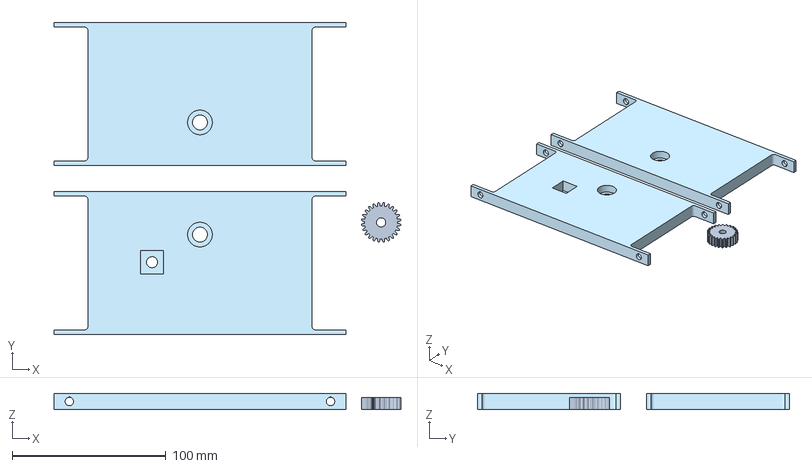
[picture p68: CAD file, 2026-10-25]
docs/mechanical/reviewed-print/controller-frame.3mf
225.9 x 203.0 x 10.5 mm
F04 Original 24T potentiometer gear
Other Frame
Frame pot
