albertorestifo/trenino/docs/mechanical/reviewed-print/sliced/frame-Frame-pot-id4.gcode.3mf

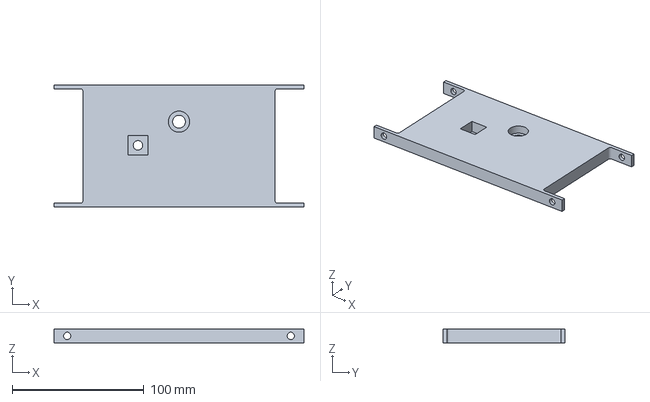
[picture p69: CAD file, 2026-10-25]
docs/mechanical/reviewed-print/sliced/frame-Frame-pot-id4.gcode.3mf
190.0 x 93.0 x 10.5 mm
