albertorestifo/trenino/docs/mechanical/reviewed-print/stl/moving-M05-Drive-spacer-13-mm-id8.stl

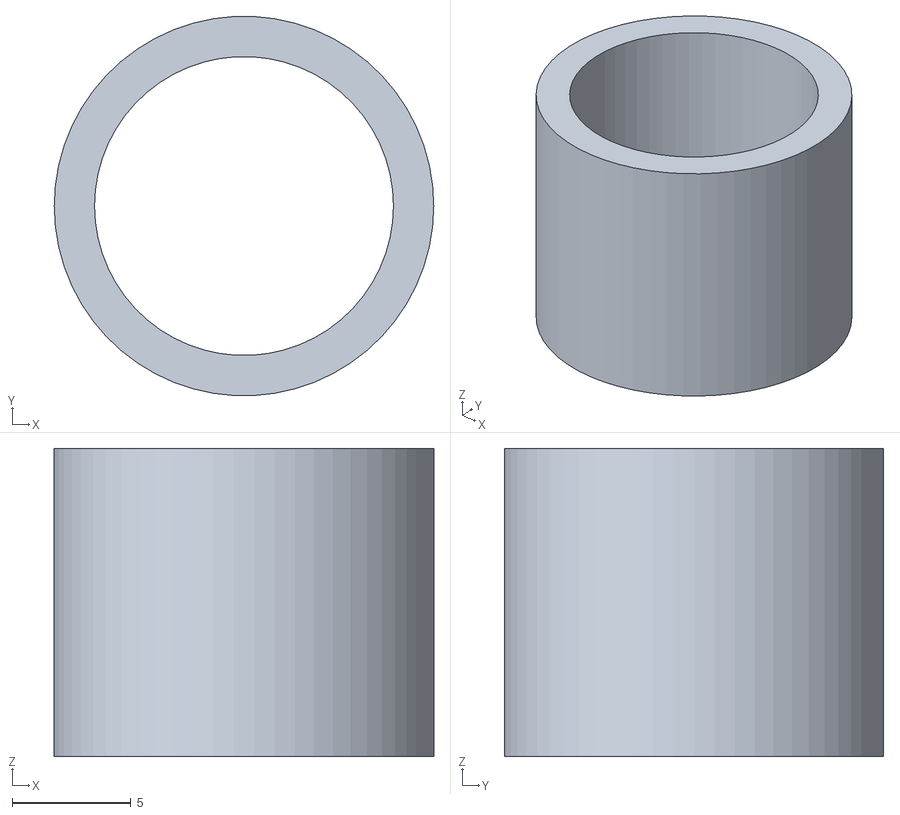
[picture p70: CAD file, 2026-10-25]
docs/mechanical/reviewed-print/stl/moving-M05-Drive-spacer-13-mm-id8.stl
16.0 x 16.0 x 13.0
