albertorestifo/trenino/docs/mechanical/slicer-check/sliced/hub.gcode.3mf

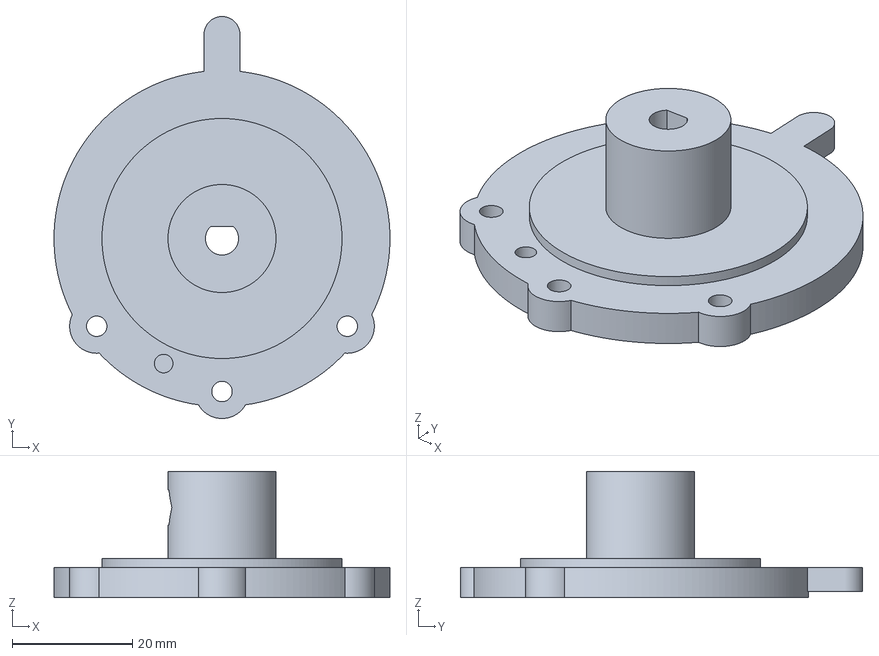
[picture p71: CAD file, 2026-10-25]
docs/mechanical/slicer-check/sliced/hub.gcode.3mf
56.0 x 67.0 x 21.0 mm
