albertorestifo/trenino/docs/mechanical/fdm-stl/Cam Detent — FDM print layout - 04 — Fork — long flat side down — bore supports.stl

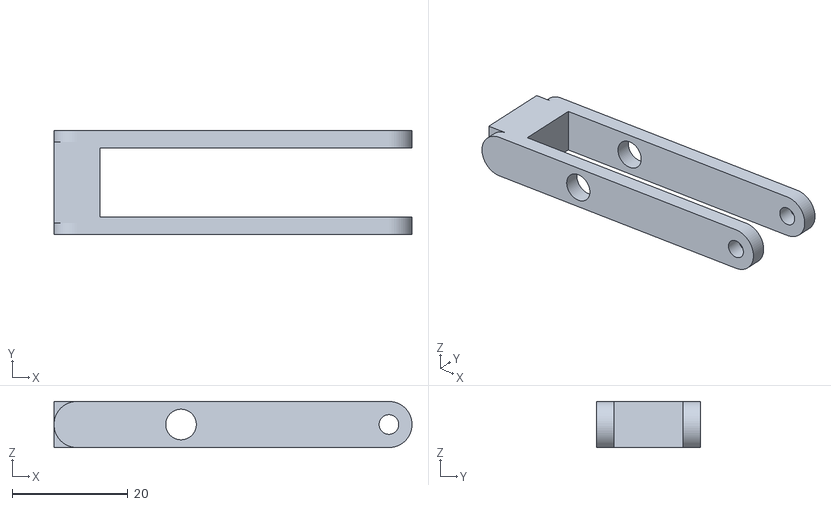
[picture p72: CAD file, 2026-10-25]
docs/mechanical/fdm-stl/Cam Detent — FDM print layout - 04 — Fork — long flat side down — bore supports.stl
62.0 x 18.0 x 8.00
