albertorestifo/trenino/docs/mechanical/fusion-controller/direct-v6-build-fixes/diagnostic-slices/P09-Grip-insert-half.gcode.3mf

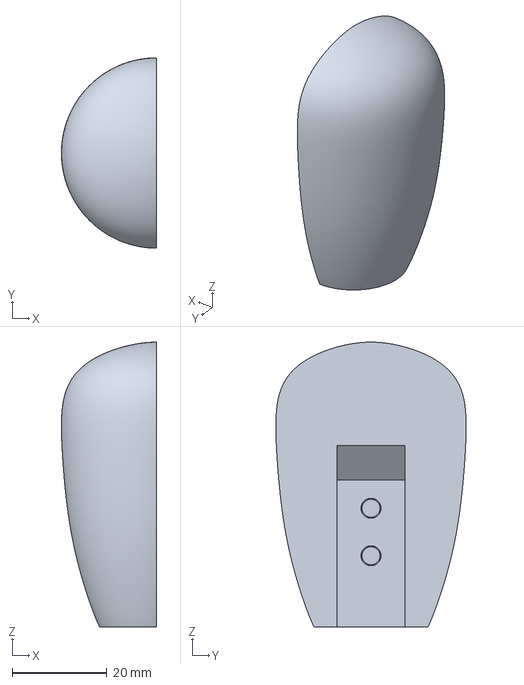
[picture p73: CAD file, 2026-10-25]
docs/mechanical/fusion-controller/direct-v6-build-fixes/diagnostic-slices/P09-Grip-insert-half.gcode.3mf
20.0 x 40.1 x 60.0 mm
