albertorestifo/trenino/docs/mechanical/fusion-controller/fixed-frame-reference.3mf

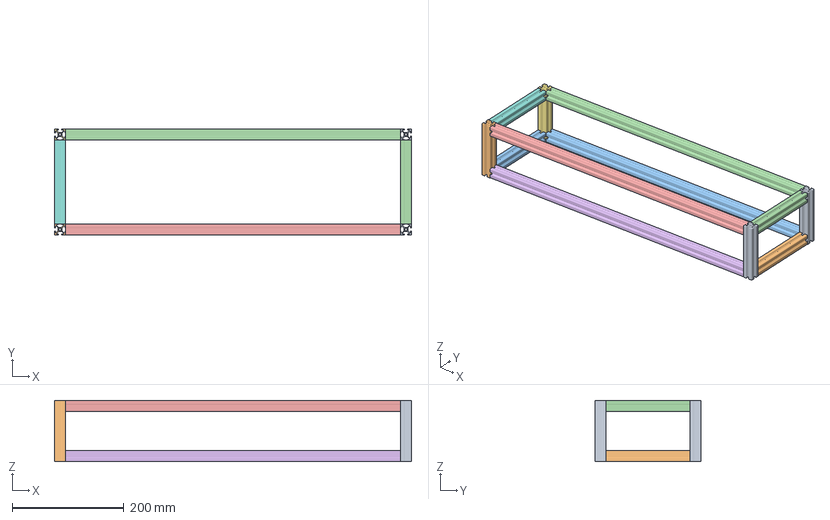
[picture p74: CAD file, 2026-10-25]
docs/mechanical/fusion-controller/fixed-frame-reference.3mf
640.0 x 190.0 x 110.0 mm
