albertorestifo/trenino/docs/mechanical/fusion-controller/gear-comparison/diagnostic-slices/P08-Cam-3-gates---stable-endpoints.gcode.3mf

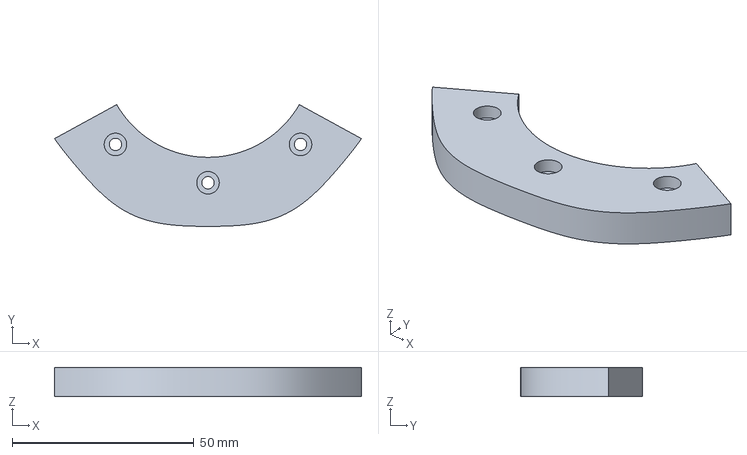
[picture p75: CAD file, 2026-10-25]
docs/mechanical/fusion-controller/gear-comparison/diagnostic-slices/P08-Cam-3-gates---stable-endpoints.gcode.3mf
84.5 x 33.5 x 8.00 mm
