albertorestifo/trenino/docs/mechanical/fusion-controller/gear-comparison/plate-slice-check/Plate-01.gcode.3mf

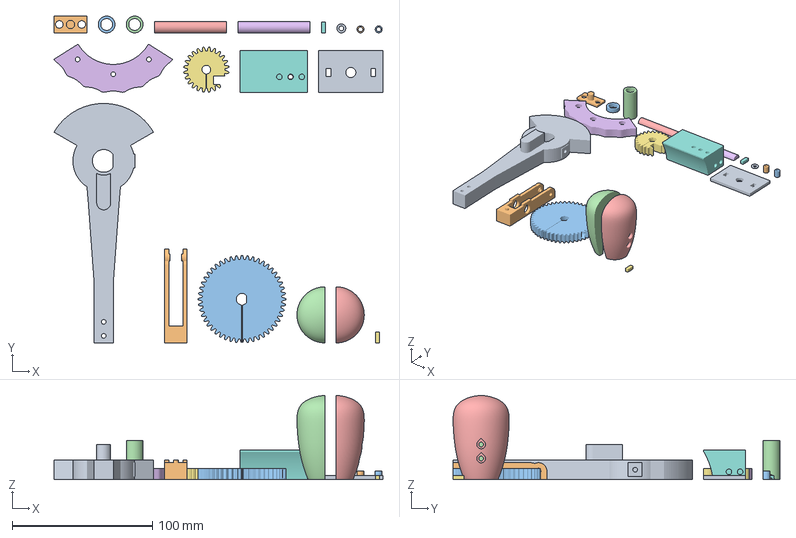
[picture p76: CAD file, 2026-10-25]
docs/mechanical/fusion-controller/gear-comparison/plate-slice-check/Plate-01.gcode.3mf
235.0 x 233.4 x 60.0 mm
P07-Integral-lever-rotor-and-cam-carrier
P11-Forked-roller-follower
G01-48T-lever-gear
P09-Grip-insert-half
P10-Grip-screw-half
P08-Cam-7-gates---stable-endpoints
G02-24T-sensor-pinion
P13-Spring-reaction-crossblock
G03-Radially-adjustable-potentiometer-panel
P14-Captive-spring-cup-for-9-mm-spring
P22-Follower-right-axial-spacer
P21-Follower-left-axial-spacer
P25-Captured-printed-pivot-lower-half
P26-Captured-printed-pivot-upper-half
P28-Shaft-alignment-key--5
P28-Shaft-alignment-key-5
P15-Recessed-preload-limit-collar-1-mm
P27-Printed-guide-sleeve-4
P27-Printed-guide-sleeve-20
