albertorestifo/trenino/docs/mechanical/fusion-controller/gear-comparison/raw-stl/P02G-Right-plate-with-upper-sensor-supports.stl

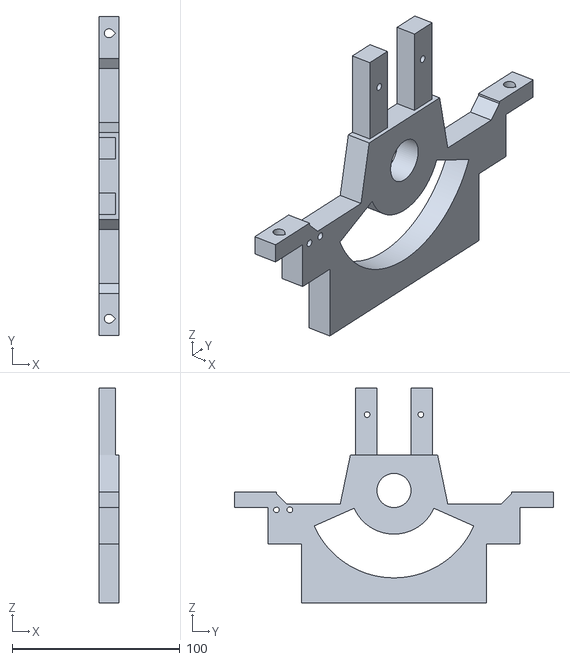
[picture p77: CAD file, 2026-10-25]
docs/mechanical/fusion-controller/gear-comparison/raw-stl/P02G-Right-plate-with-upper-sensor-supports.stl
12.0 x 190.0 x 128.0
