albertorestifo/trenino/docs/mechanical/fusion-controller/gear-comparison/stl/P06-Shaft-retaining-cap.stl

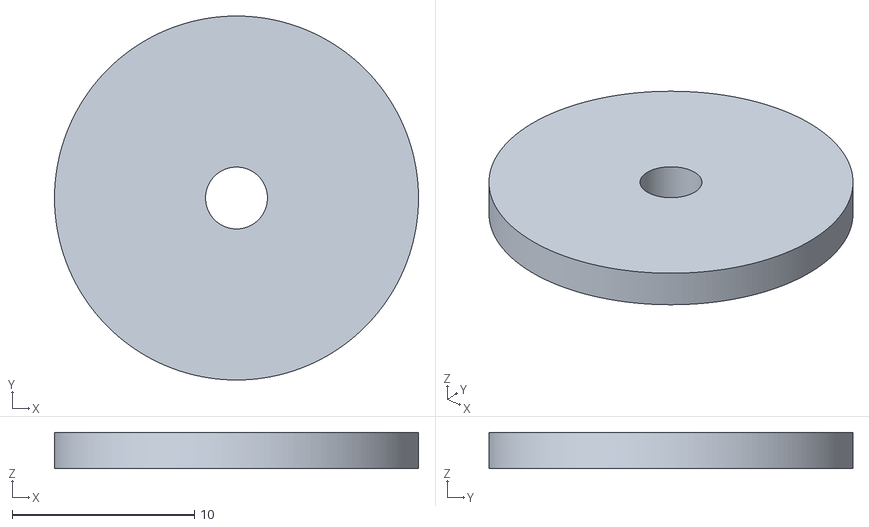
[picture p78: CAD file, 2026-10-25]
docs/mechanical/fusion-controller/gear-comparison/stl/P06-Shaft-retaining-cap.stl
20.0 x 20.0 x 2.00
