albertorestifo/trenino/docs/mechanical/fusion-controller/inventory-support-free-revision/diagnostic-slices/P08-Cam-7-gates---stable-endpoints.gcode.3mf

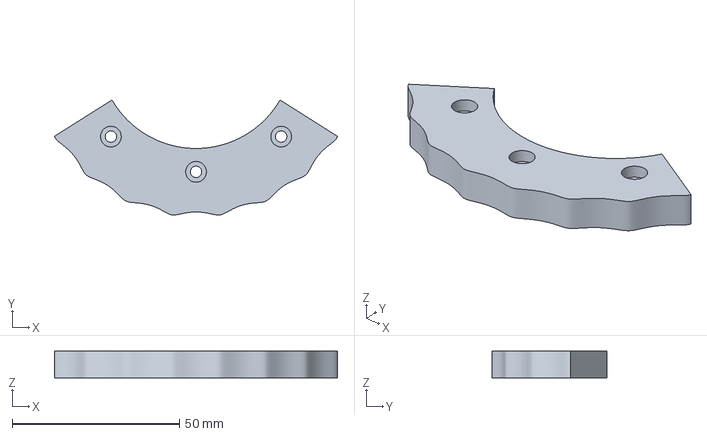
[picture p79: CAD file, 2026-10-25]
docs/mechanical/fusion-controller/inventory-support-free-revision/diagnostic-slices/P08-Cam-7-gates---stable-endpoints.gcode.3mf
84.6 x 34.4 x 8.00 mm
