albertorestifo/trenino/docs/mechanical/fusion-controller/one-piece-shaft/diagnostic-slices/P05-One-piece-shaft-with-continuous-print-flat.gcode.3mf

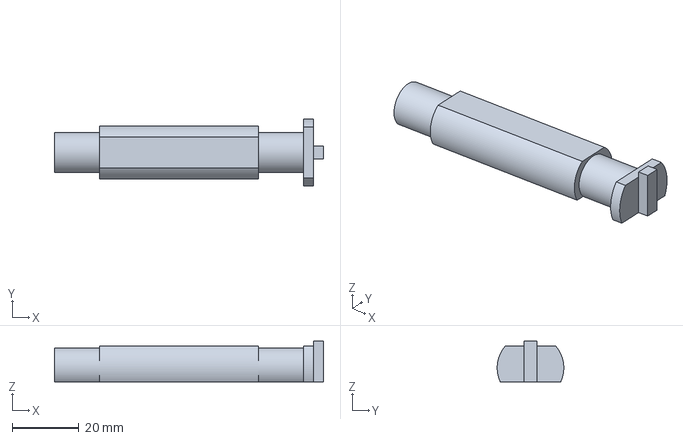
[picture p80: CAD file, 2026-10-25]
docs/mechanical/fusion-controller/one-piece-shaft/diagnostic-slices/P05-One-piece-shaft-with-continuous-print-flat.gcode.3mf
80.7 x 20.0 x 12.2 mm
