albertorestifo/trenino/docs/mechanical/fusion-controller/one-piece-shaft/required-stl/P02-Right-rail-sideplate.stl

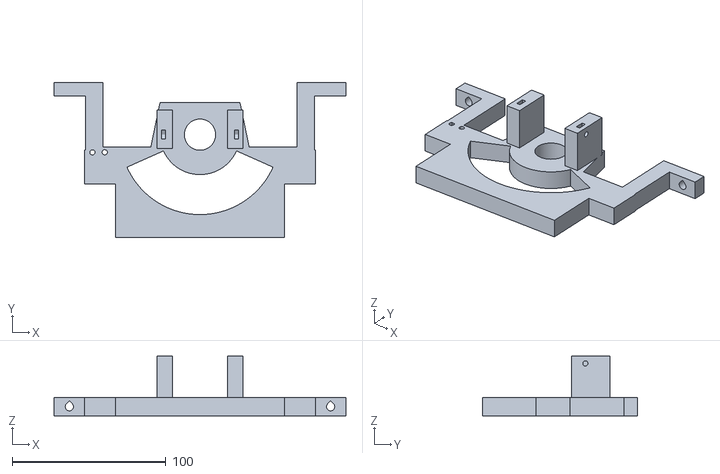
[picture p81: CAD file, 2026-10-25]
docs/mechanical/fusion-controller/one-piece-shaft/required-stl/P02-Right-rail-sideplate.stl
190.0 x 101.0 x 39.0
