albertorestifo/trenino/docs/mechanical/fusion-controller/opposite-sides/diagnostic-slices/P27-Printed-guide-sleeve-4.gcode.3mf

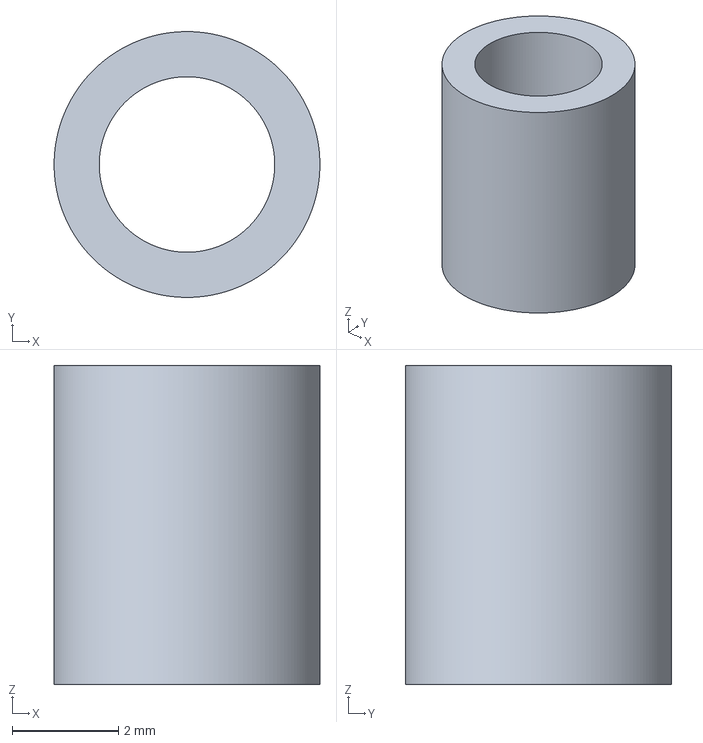
[picture p82: CAD file, 2026-10-25]
docs/mechanical/fusion-controller/opposite-sides/diagnostic-slices/P27-Printed-guide-sleeve-4.gcode.3mf
5.00 x 5.00 x 6.00 mm
