albertorestifo/trenino/docs/mechanical/fusion-controller/opposite-sides/raw-stl/P11-Forked-roller-follower.stl

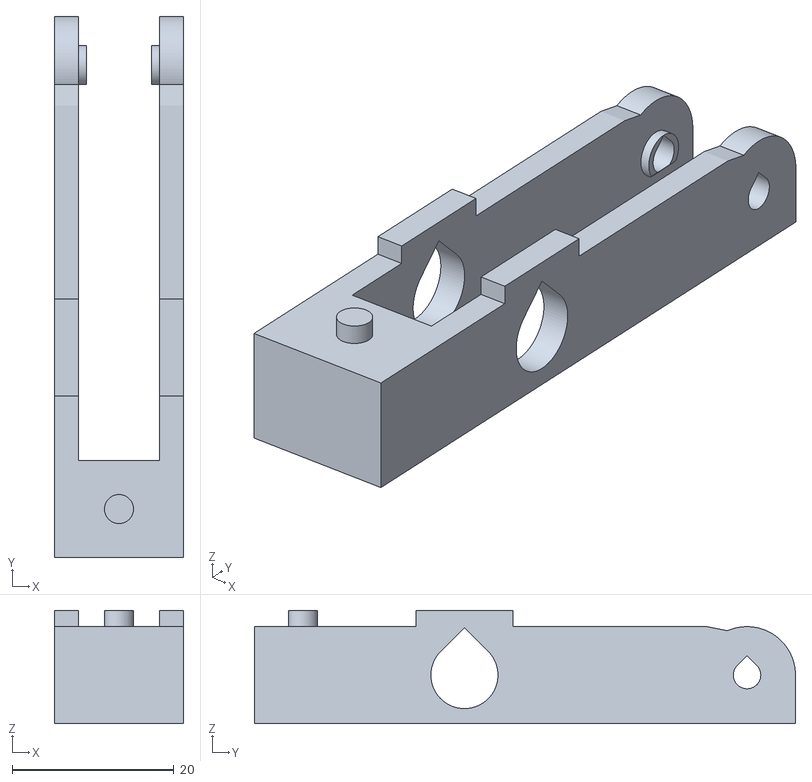
[picture p83: CAD file, 2026-10-25]
docs/mechanical/fusion-controller/opposite-sides/raw-stl/P11-Forked-roller-follower.stl
16.0 x 67.0 x 14.0
