albertorestifo/trenino/docs/mechanical/fusion-controller/opposite-sides/stl/G03S-Compact-adjustable-pot-panel.stl

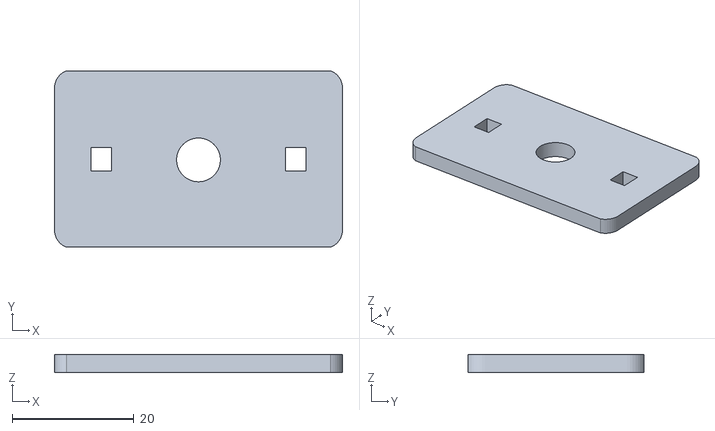
[picture p84: CAD file, 2026-10-25]
docs/mechanical/fusion-controller/opposite-sides/stl/G03S-Compact-adjustable-pot-panel.stl
47.4 x 29.0 x 3.00
