albertorestifo/trenino/docs/mechanical/fusion-controller/raised-wide-travel/raw-stl/P08-Cam-7-gates---116-degree-span.stl

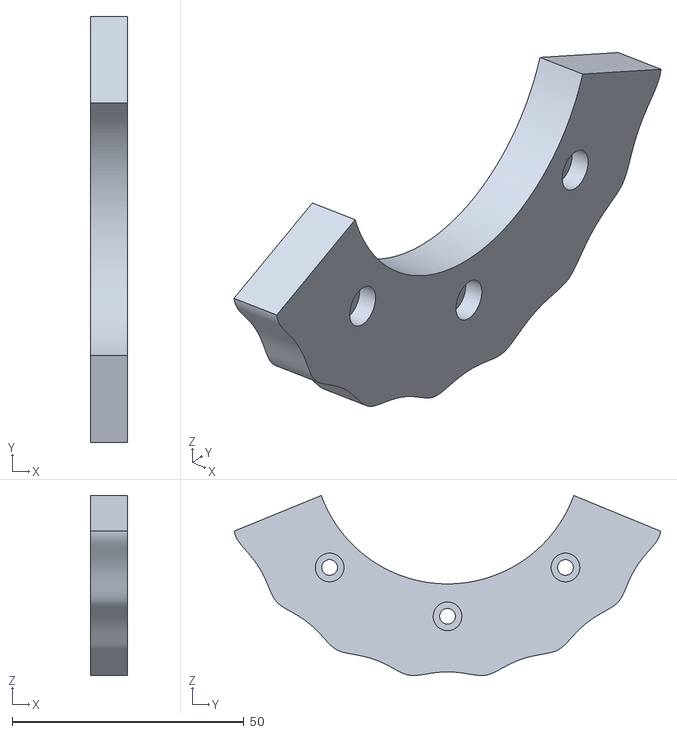
[picture p85: CAD file, 2026-10-25]
docs/mechanical/fusion-controller/raised-wide-travel/raw-stl/P08-Cam-7-gates---116-degree-span.stl
8.00 x 92.0 x 38.9
