albertorestifo/trenino/docs/mechanical/fusion-controller/raw-stl/P07-Integral-lever-rotor-and-cam-carrier.stl

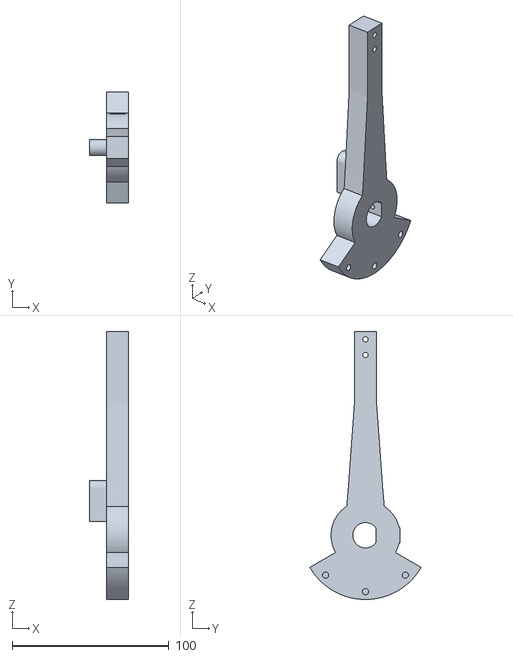
[picture p86: CAD file, 2026-10-25]
docs/mechanical/fusion-controller/raw-stl/P07-Integral-lever-rotor-and-cam-carrier.stl
25.0 x 71.0 x 171.0
