albertorestifo/trenino/docs/mechanical/fusion-controller/recessed-bottom-sensor/diagnostic-slices/P02R-Top-rail-hanging-right-sensor-sideplate.gcode.3mf

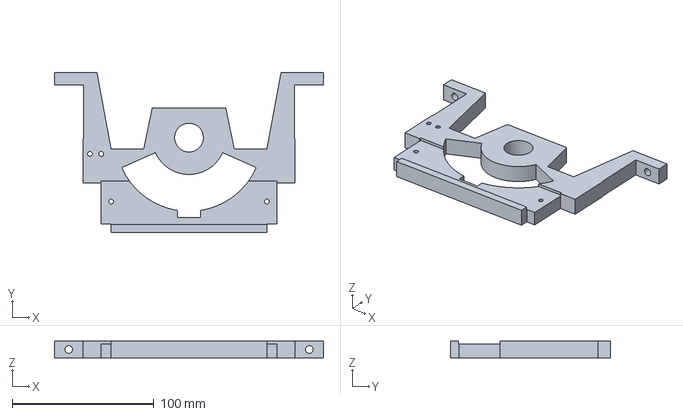
[picture p87: CAD file, 2026-10-25]
docs/mechanical/fusion-controller/recessed-bottom-sensor/diagnostic-slices/P02R-Top-rail-hanging-right-sensor-sideplate.gcode.3mf
190.0 x 113.0 x 12.0 mm
