albertorestifo/trenino/docs/mechanical/fusion-controller/recessed-bottom-sensor/raw-stl/P05G-Shaft-upper-half.stl

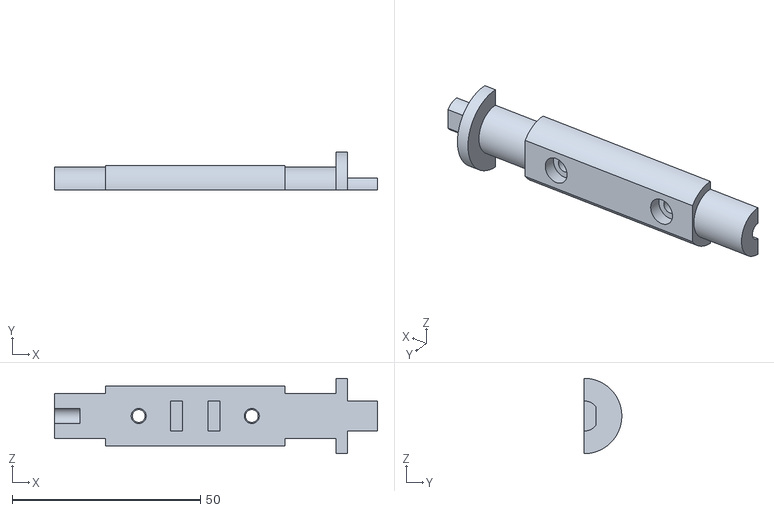
[picture p88: CAD file, 2026-10-25]
docs/mechanical/fusion-controller/recessed-bottom-sensor/raw-stl/P05G-Shaft-upper-half.stl
85.7 x 10.00 x 20.0
