albertorestifo/trenino/docs/mechanical/fusion-controller/stl/P02-Right-rail-sideplate.stl

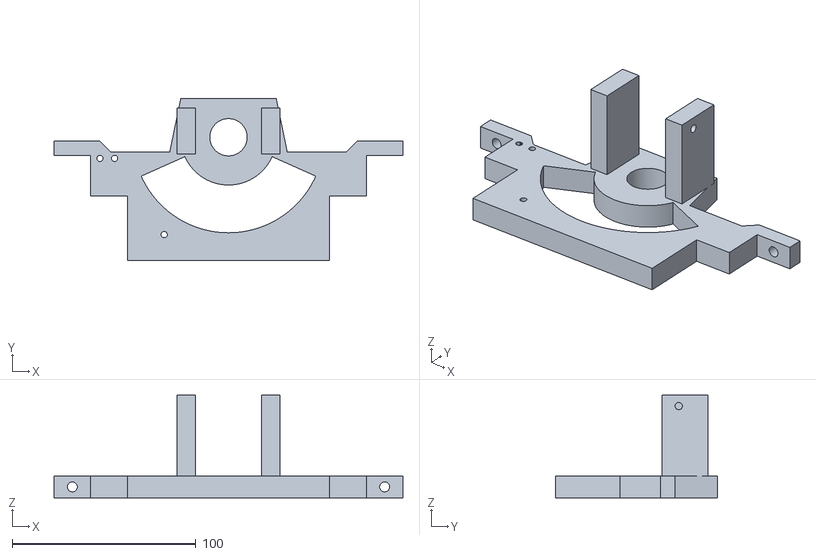
[picture p89: CAD file, 2026-10-25]
docs/mechanical/fusion-controller/stl/P02-Right-rail-sideplate.stl
190.0 x 88.0 x 56.0
