albertorestifo/trenino/docs/mechanical/fusion-controller/support-revision/Support-Reduced-P2S-PLA.3mf

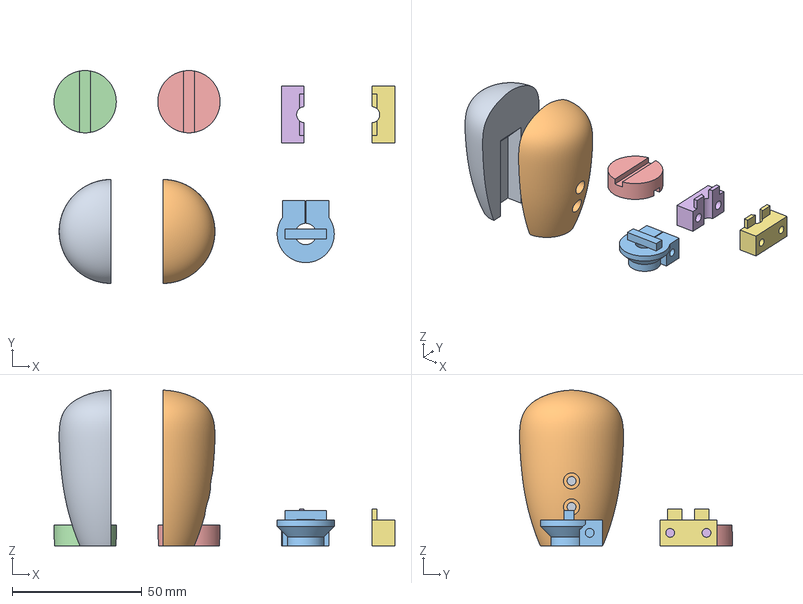
[picture p90: CAD file, 2026-10-25]
docs/mechanical/fusion-controller/support-revision/Support-Reduced-P2S-PLA.3mf
131.4 x 82.0 x 60.0 mm
P09-Grip-insert-half.stl
P10-Grip-screw-half.stl
P17-Shaft-side-floating-coupling-hub.stl
P18-Floating-cross-slot-coupling-disc.stl
P18-Tight-fit-alternate-disc---4-1-mm-slots.stl
P19-RK097-clamp-insert-half.stl
P20-RK097-clamp-screw-half.stl
