albertorestifo/trenino/docs/mechanical/integrated-print/controller-supports.3mf

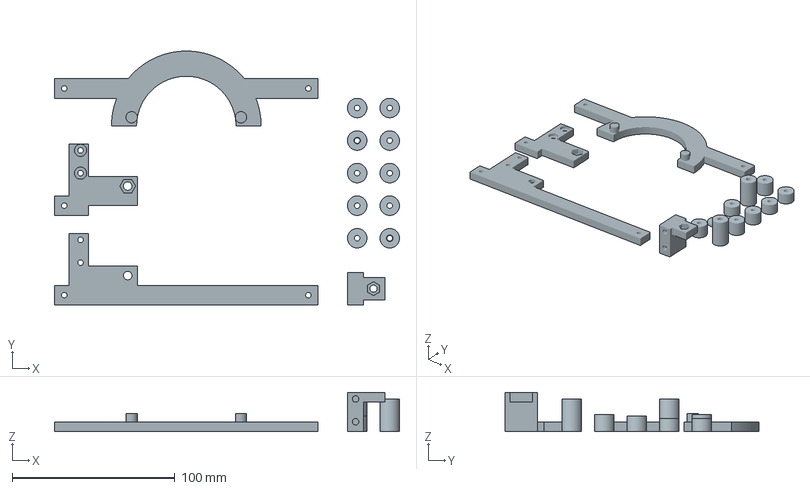
[picture p91: CAD file, 2026-10-25]
docs/mechanical/integrated-print/controller-supports.3mf
212.0 x 156.0 x 24.0 mm
S5 Spacer 9.5 mm
S8 Spacer 10.5 mm
S12 Spacer 8 mm
S11 Spacer 20 mm
S14 Spacer 8 mm
S01 Lower follower plate - flat
S03 Spring block - four M3 inserts
S6 Spacer 20 mm
S9 Spacer 8 mm
S10 Spacer 9.5 mm
S13 Spacer 10.5 mm
S02 Upper follower plate - flat
S04 Stop arch - flat, supported at both ends
S7 Spacer 2 mm
