albertorestifo/trenino/docs/mechanical/integrated-print/stl/supports-S13-Spacer-10.5-mm-id12.stl

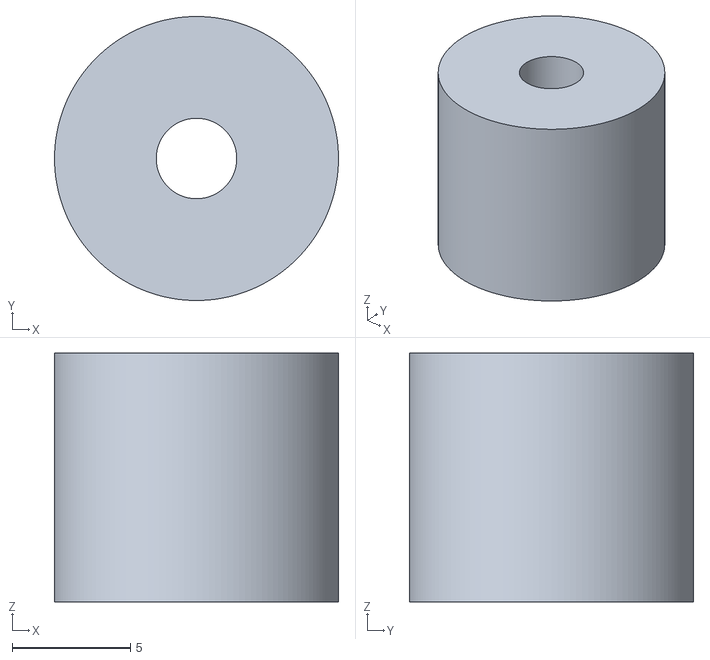
[picture p92: CAD file, 2026-10-25]
docs/mechanical/integrated-print/stl/supports-S13-Spacer-10.5-mm-id12.stl
12.0 x 12.0 x 10.5
