albertorestifo/trenino/docs/mechanical/reviewed-print/controller-supports.3mf

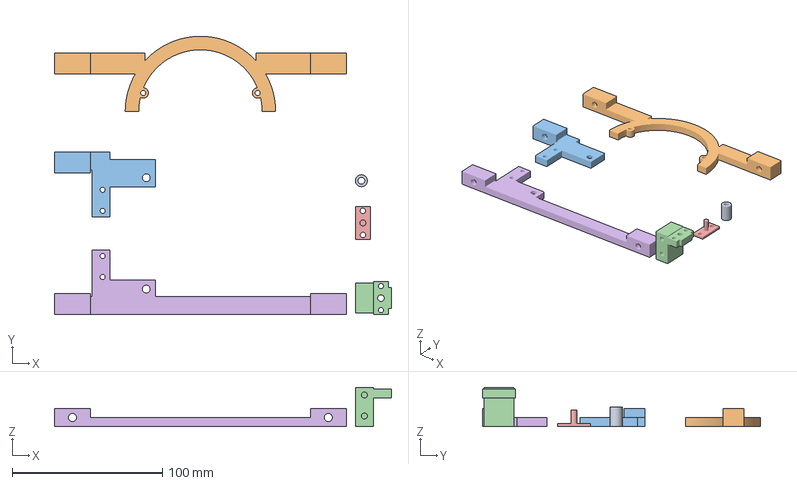
[picture p93: CAD file, 2026-10-25]
docs/mechanical/reviewed-print/controller-supports.3mf
224.0 x 185.0 x 26.0 mm
PRINT M4 preload limit collar - 13 mm
S04 Steel-core stop arch - bolts to upper 2020 rails
S02 Upper follower plate - flat
S03 Spring block - four M3 inserts
PRINT Spring cup - captive on two M3 guide screws
S01 Lower follower plate - flat
