albertorestifo/trenino/docs/mechanical/reviewed-print/sliced/supports-S01-Lower-follower-plate---flat-id7.gcode.3mf

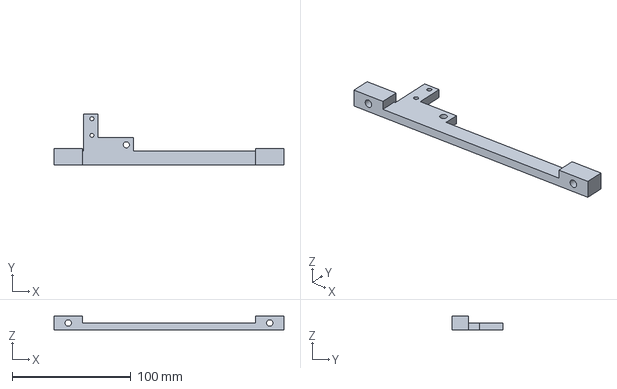
[picture p94: CAD file, 2026-10-25]
docs/mechanical/reviewed-print/sliced/supports-S01-Lower-follower-plate---flat-id7.gcode.3mf
194.0 x 43.0 x 12.0 mm
