albertorestifo/trenino/docs/mechanical/reviewed-print/stl/moving-M01-Printed-shaft---12-mm-D-9.2-mm-journals-id9.stl

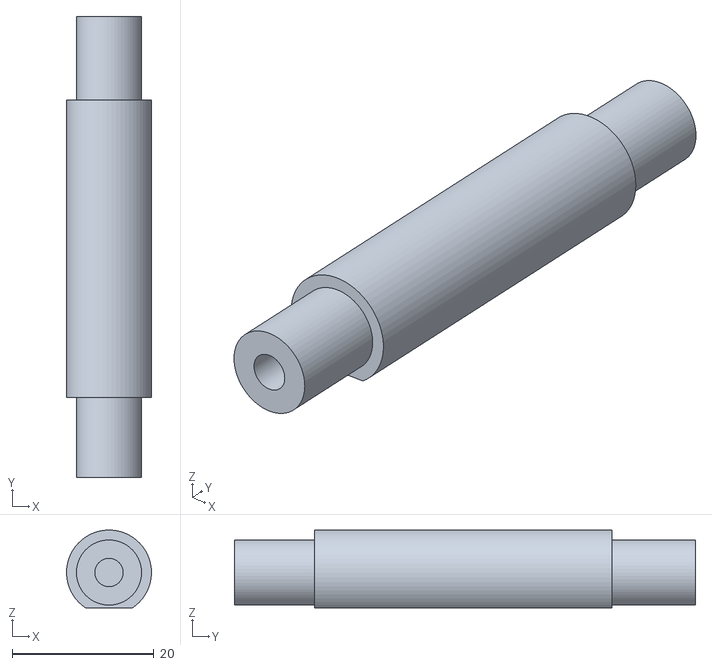
[picture p95: CAD file, 2026-10-25]
docs/mechanical/reviewed-print/stl/moving-M01-Printed-shaft---12-mm-D-9.2-mm-journals-id9.stl
12.0 x 65.1 x 11.0
