albertorestifo/trenino/docs/mechanical/slicer-check/sliced/bracket-final.gcode.3mf

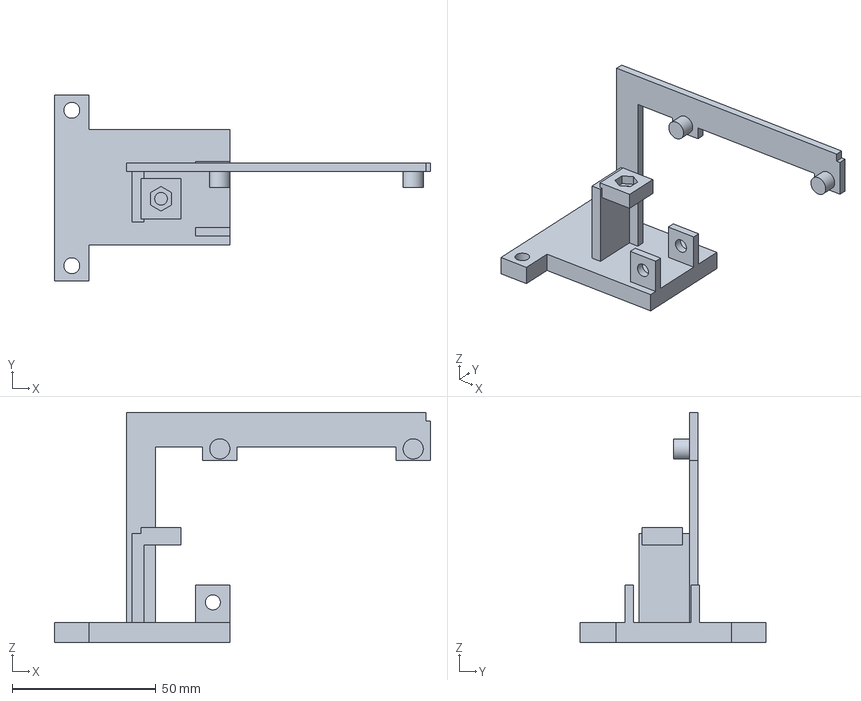
[picture p96: CAD file, 2026-10-25]
docs/mechanical/slicer-check/sliced/bracket-final.gcode.3mf
130.6 x 64.5 x 80.0 mm
