albertorestifo/trenino/docs/mechanical/fdm-stl/Cam Detent — FDM print layout - 01 — Roller — print end face down.stl

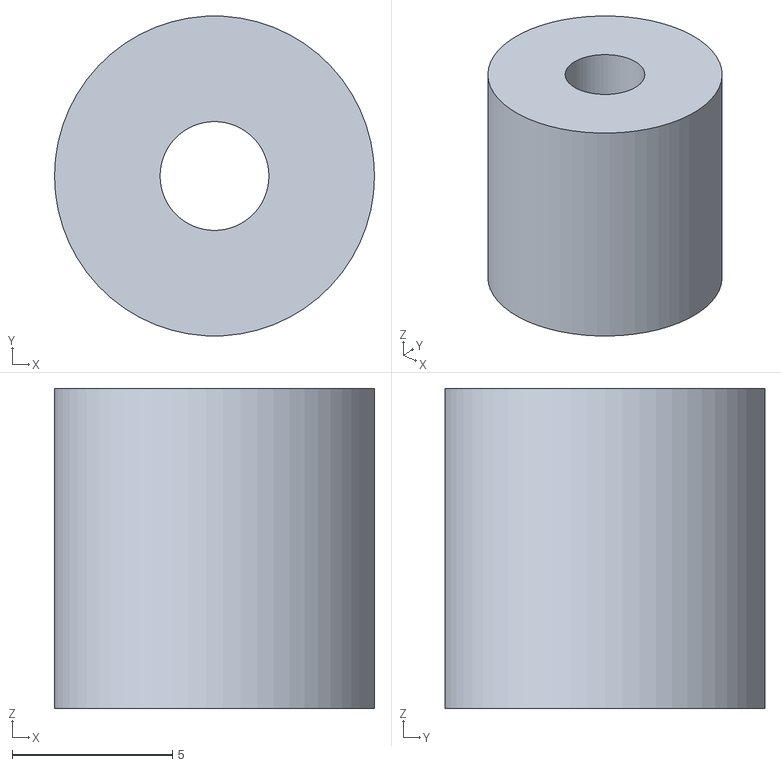
[picture p97: CAD file, 2026-10-25]
docs/mechanical/fdm-stl/Cam Detent — FDM print layout - 01 — Roller — print end face down.stl
10.0 x 9.99 x 10.0
