albertorestifo/trenino/docs/mechanical/fusion-controller/Changed-Parts-P2S-PLA.3mf

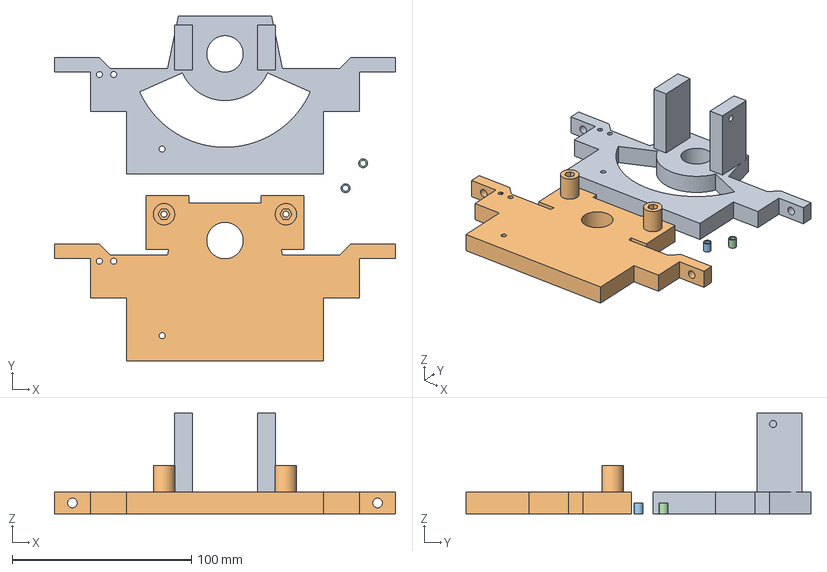
[picture p98: CAD file, 2026-10-25]
docs/mechanical/fusion-controller/Changed-Parts-P2S-PLA.3mf
190.0 x 192.0 x 56.0 mm
P02-Right-rail-sideplate.stl
P01-Left-rail-sideplate.stl
P25-Left-pivot-sleeve-centering-insert.stl
P26-Right-pivot-sleeve-centering-insert.stl
