albertorestifo/trenino/docs/mechanical/fusion-controller/direct-v6-build-fixes/optional-stl/P05-Shaft-upper-half.stl

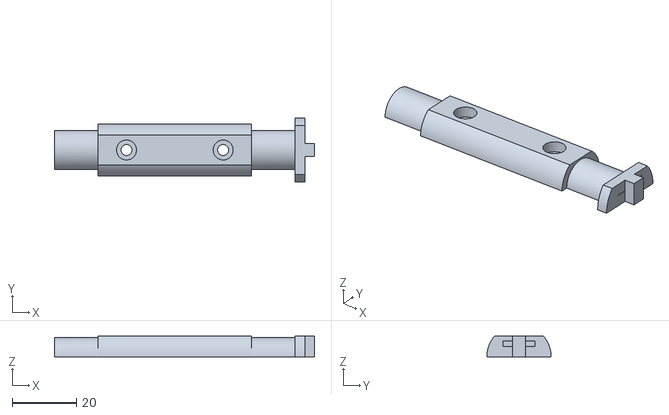
[picture p99: CAD file, 2026-10-25]
docs/mechanical/fusion-controller/direct-v6-build-fixes/optional-stl/P05-Shaft-upper-half.stl
80.7 x 20.0 x 6.50
