albertorestifo/trenino/docs/mechanical/fusion-controller/direct-v6-build-fixes/required-stl/P01-Left-rail-sideplate.stl

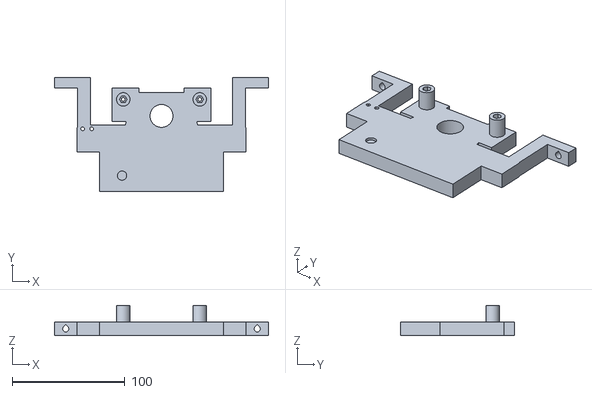
[picture p100: CAD file, 2026-10-25]
docs/mechanical/fusion-controller/direct-v6-build-fixes/required-stl/P01-Left-rail-sideplate.stl
190.0 x 101.0 x 27.0
