albertorestifo/trenino/docs/mechanical/fusion-controller/direct-v6-build-fixes/stl/P16-Compact-adjustable-RK097-mount.stl

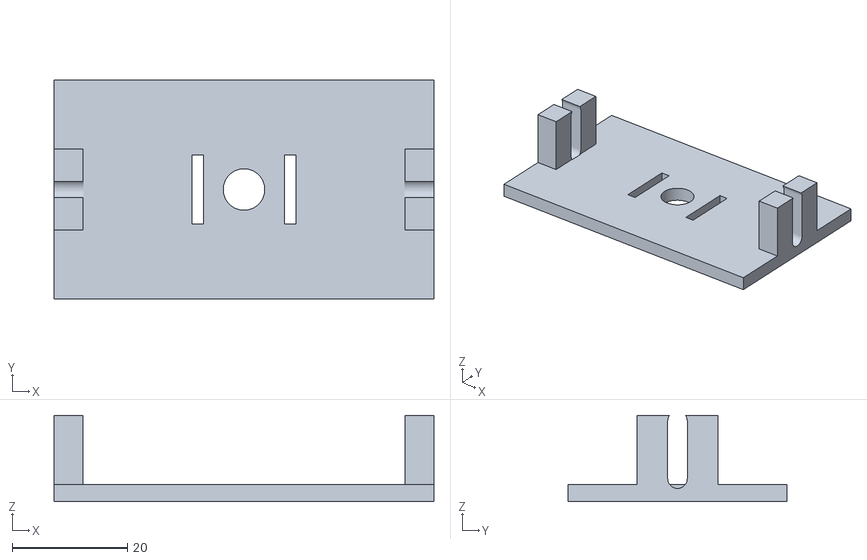
[picture p101: CAD file, 2026-10-25]
docs/mechanical/fusion-controller/direct-v6-build-fixes/stl/P16-Compact-adjustable-RK097-mount.stl
66.0 x 38.0 x 15.0
