albertorestifo/trenino/docs/mechanical/fusion-controller/gear-comparison/diagnostic-slices/P15-Recessed-preload-limit-collar-1-mm.gcode.3mf

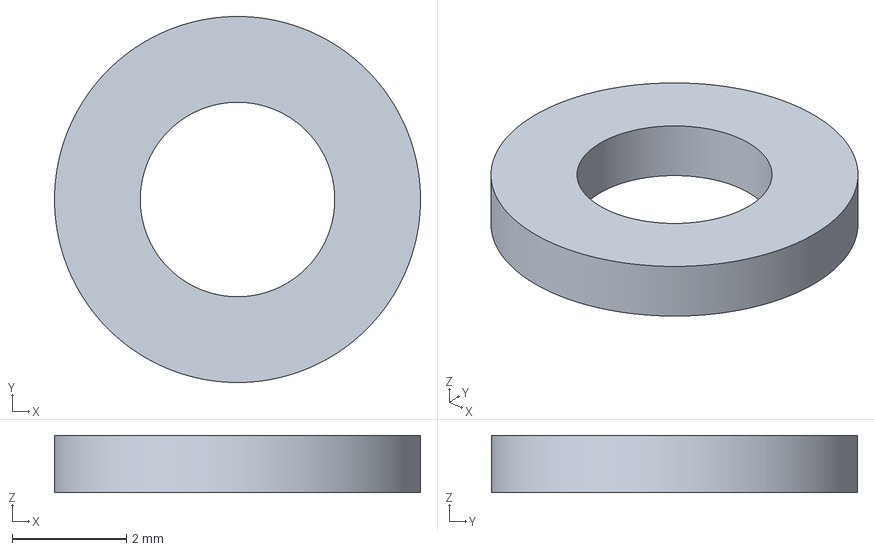
[picture p102: CAD file, 2026-10-25]
docs/mechanical/fusion-controller/gear-comparison/diagnostic-slices/P15-Recessed-preload-limit-collar-1-mm.gcode.3mf
6.40 x 6.40 x 1.00 mm
