albertorestifo/trenino/docs/mechanical/fusion-controller/inventory-support-free-revision/stl/P05-Shaft-lower-half.stl

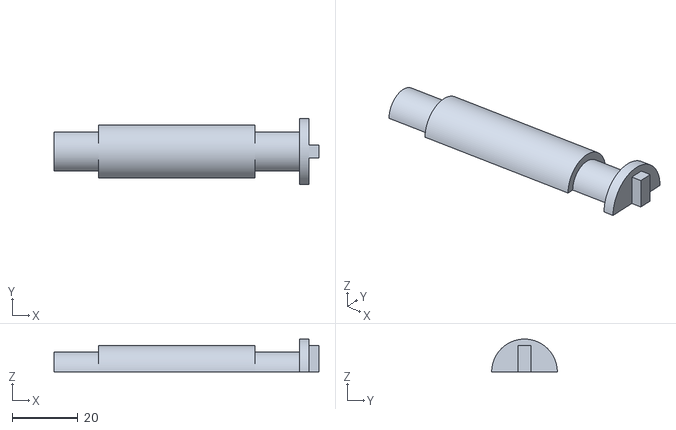
[picture p103: CAD file, 2026-10-25]
docs/mechanical/fusion-controller/inventory-support-free-revision/stl/P05-Shaft-lower-half.stl
80.7 x 20.0 x 10.00
