albertorestifo/trenino/docs/mechanical/fusion-controller/opposite-sides/diagnostic-slices/P23-Rotor-thrust-spacer.gcode.3mf

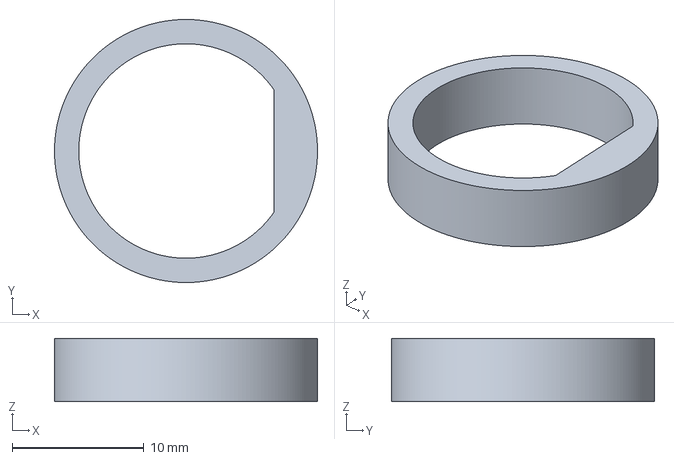
[picture p104: CAD file, 2026-10-25]
docs/mechanical/fusion-controller/opposite-sides/diagnostic-slices/P23-Rotor-thrust-spacer.gcode.3mf
20.0 x 20.0 x 4.80 mm
