albertorestifo/trenino/docs/mechanical/fusion-controller/opposite-sides/raw-stl/P02S-Continuous-right-sensor-plate.stl

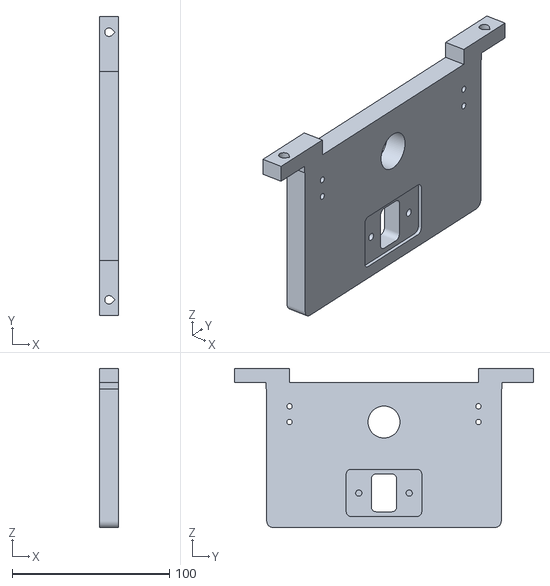
[picture p105: CAD file, 2026-10-25]
docs/mechanical/fusion-controller/opposite-sides/raw-stl/P02S-Continuous-right-sensor-plate.stl
12.0 x 190.0 x 101.0
