albertorestifo/trenino/docs/mechanical/fusion-controller/opposite-sides/stl/P03-Left-flanged-journal-bush.stl

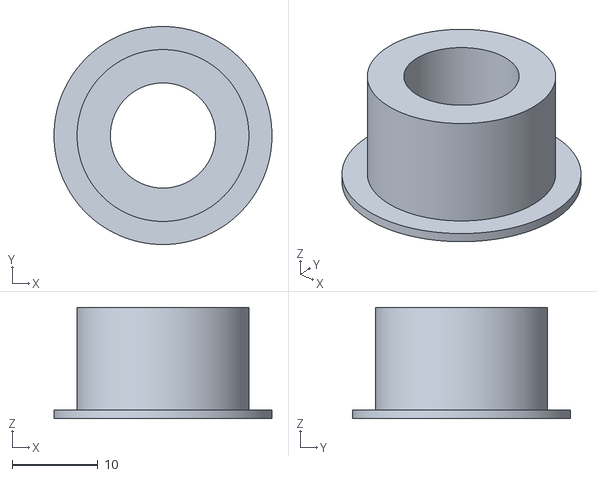
[picture p106: CAD file, 2026-10-25]
docs/mechanical/fusion-controller/opposite-sides/stl/P03-Left-flanged-journal-bush.stl
25.5 x 25.5 x 13.0
