albertorestifo/trenino/docs/mechanical/fusion-controller/raw-stl/P13-Spring-reaction-crossblock.stl

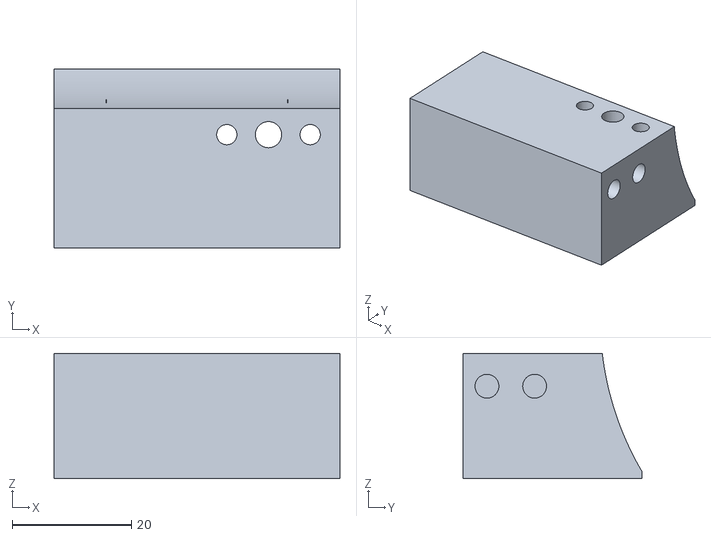
[picture p107: CAD file, 2026-10-25]
docs/mechanical/fusion-controller/raw-stl/P13-Spring-reaction-crossblock.stl
48.0 x 30.0 x 21.0
