albertorestifo/trenino/docs/mechanical/fusion-controller/recessed-bottom-sensor/diagnostic-slices/G03R-Lower-removable-potentiometer-panel.gcode.3mf

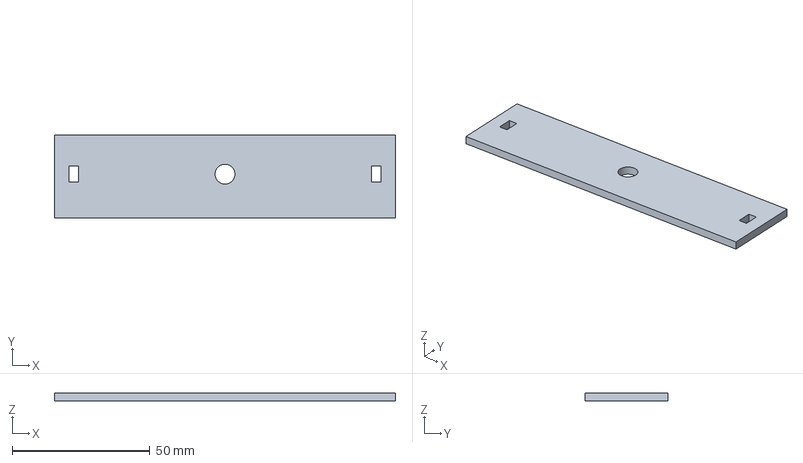
[picture p108: CAD file, 2026-10-25]
docs/mechanical/fusion-controller/recessed-bottom-sensor/diagnostic-slices/G03R-Lower-removable-potentiometer-panel.gcode.3mf
124.0 x 30.0 x 3.00 mm
