albertorestifo/trenino/docs/mechanical/integrated-print/controller-frame.3mf

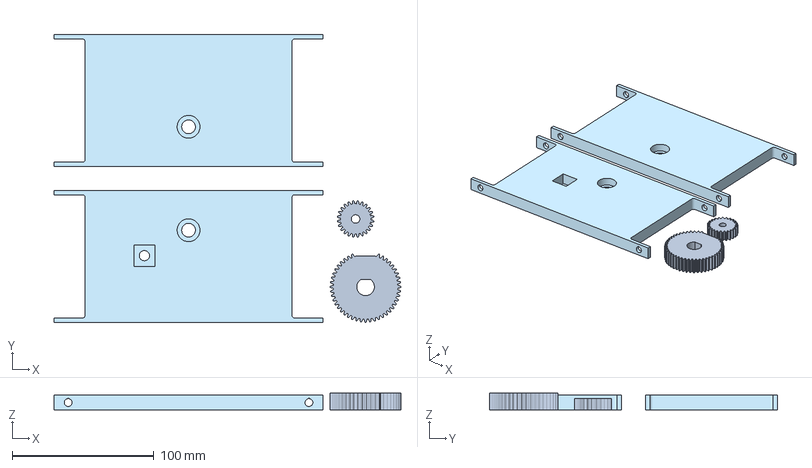
[picture p109: CAD file, 2026-10-25]
docs/mechanical/integrated-print/controller-frame.3mf
245.0 x 203.0 x 12.0 mm
Other Frame
Frame pot
F03 Original 48T gear - enlarged printed shaft bore
F04 Original 24T potentiometer gear
