albertorestifo/trenino/docs/mechanical/integrated-print/stl/frame-F04-Original-24T-potentiometer-gear-id5.stl

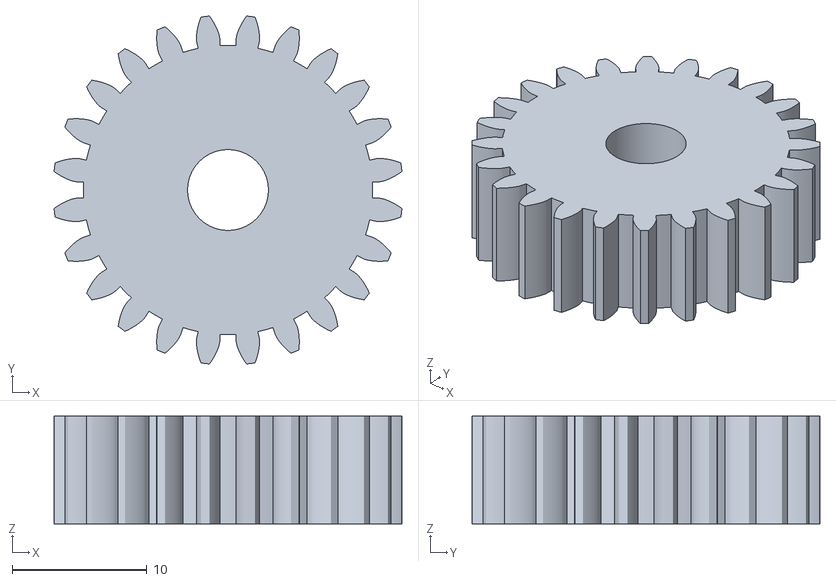
[picture p110: CAD file, 2026-10-25]
docs/mechanical/integrated-print/stl/frame-F04-Original-24T-potentiometer-gear-id5.stl
25.9 x 25.9 x 8.00
