albertorestifo/trenino/docs/mechanical/reviewed-print/controller-moving.3mf

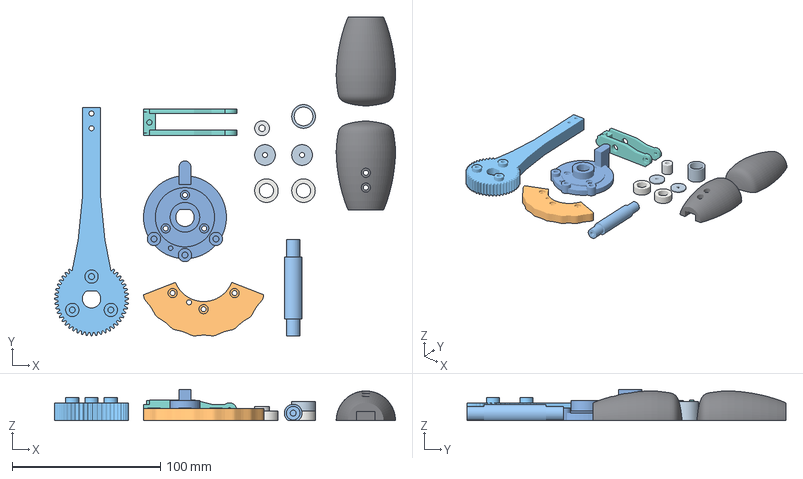
[picture p111: CAD file, 2026-10-25]
docs/mechanical/reviewed-print/controller-moving.3mf
230.0 x 215.0 x 21.0 mm
M02 Printed bushing 54 - replaces 625 bearing
M11 Railway palm grip - upper screw half
M10 Railway palm grip - lower insert half
M07 Printed shaft carrier and stop lug
M09 Roller - 10 mm diameter x 9.5 mm
M03 Shaft retaining washer -1.9
M05 Drive spacer 13 mm
M01 Printed shaft - 12 mm D, 9.2 mm journals
M02 Printed bushing 4 - replaces 625 bearing
M04 One-piece lever and original 48T main gear
M06 Replaceable cam sector - 8 mm
M08 Forked roller arm - flat side, sleeved pivot
M03 Shaft retaining washer 64.8
