albertorestifo/trenino/docs/mechanical/reviewed-print/stl/moving-M07-Printed-shaft-carrier-and-stop-lug-id5.stl

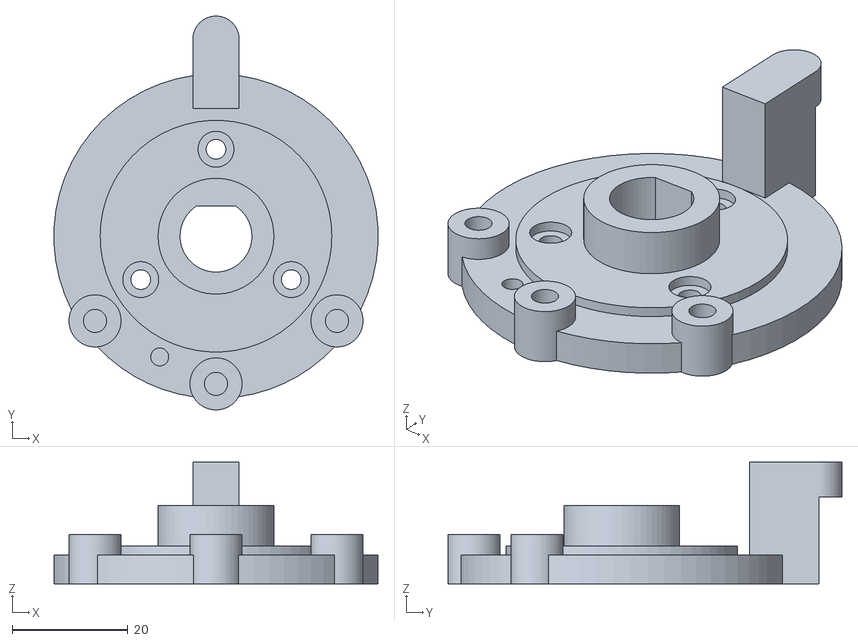
[picture p112: CAD file, 2026-10-25]
docs/mechanical/reviewed-print/stl/moving-M07-Printed-shaft-carrier-and-stop-lug-id5.stl
55.9 x 68.0 x 21.0
