albertorestifo/trenino/docs/mechanical/fdm-stl/Cam Detent — FDM print layout - 03 — Cam — flat underside down.stl

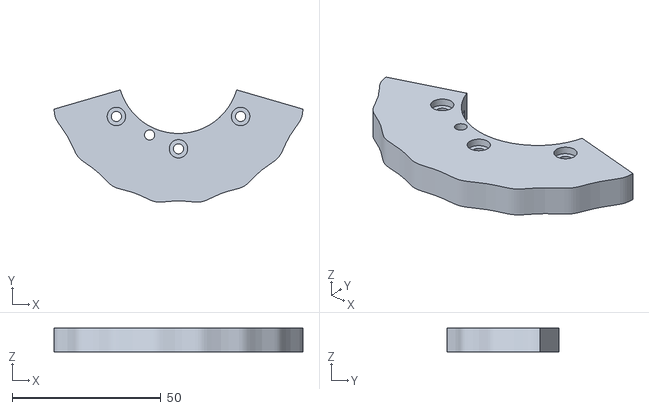
[picture p113: CAD file, 2026-10-25]
docs/mechanical/fdm-stl/Cam Detent — FDM print layout - 03 — Cam — flat underside down.stl
83.7 x 37.8 x 8.00
