albertorestifo/trenino/docs/mechanical/fusion-controller/gear-comparison/stl/G03-Radially-adjustable-potentiometer-panel.stl

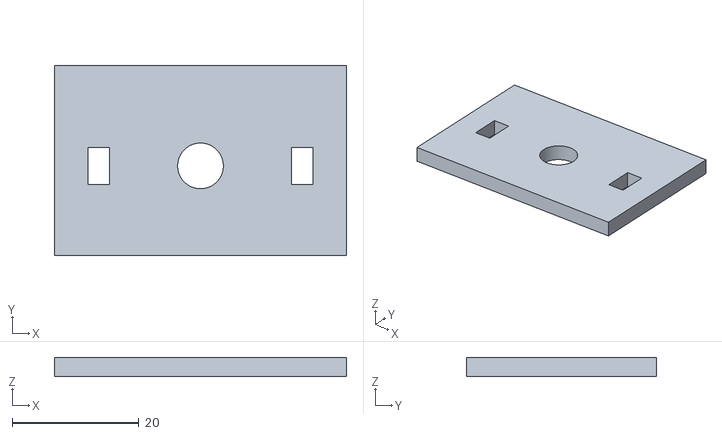
[picture p115: CAD file, 2026-10-25]
docs/mechanical/fusion-controller/gear-comparison/stl/G03-Radially-adjustable-potentiometer-panel.stl
46.0 x 30.0 x 3.00
