albertorestifo/trenino/docs/mechanical/fusion-controller/inventory-support-free-revision/diagnostic-slices/P25-Captured-printed-pivot-lower-half.gcode.3mf

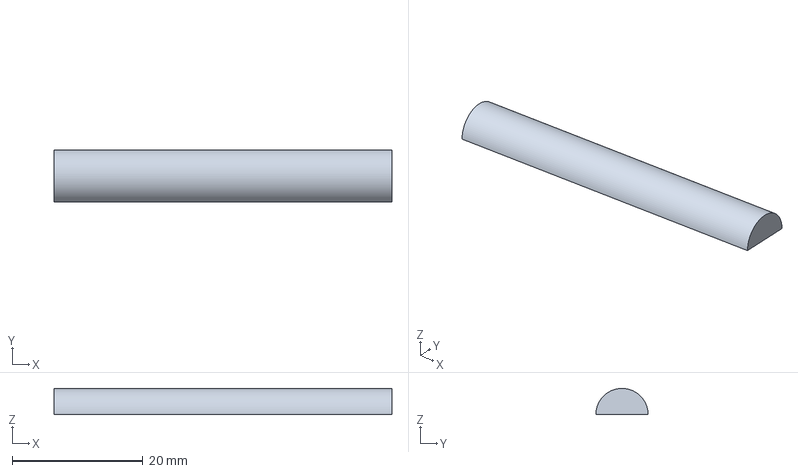
[picture p116: CAD file, 2026-10-25]
docs/mechanical/fusion-controller/inventory-support-free-revision/diagnostic-slices/P25-Captured-printed-pivot-lower-half.gcode.3mf
51.7 x 8.00 x 4.00 mm
