albertorestifo/trenino/docs/mechanical/fusion-controller/inventory-support-free-revision/stl/P18-Compact-floating-coupling-disc.stl

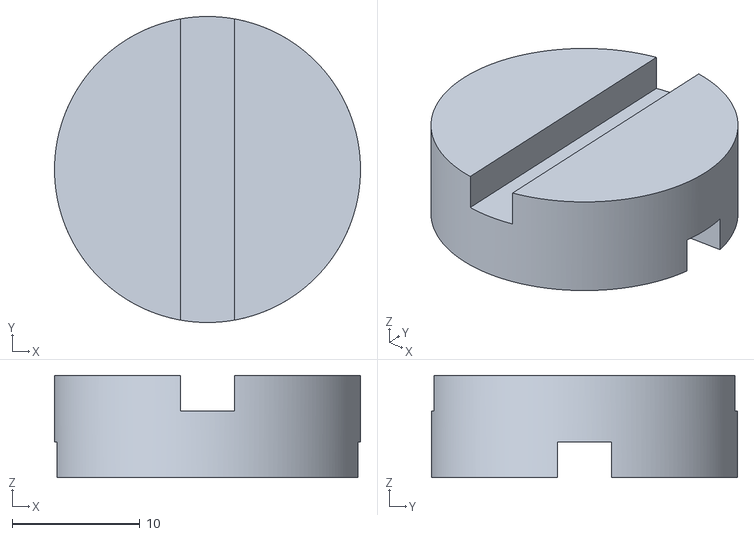
[picture p117: CAD file, 2026-10-25]
docs/mechanical/fusion-controller/inventory-support-free-revision/stl/P18-Compact-floating-coupling-disc.stl
24.0 x 24.0 x 8.00
