albertorestifo/trenino/docs/mechanical/fusion-controller/opposite-sides/stl/P07S-Planar-lever-rotor-with-lower-stop-lug.stl

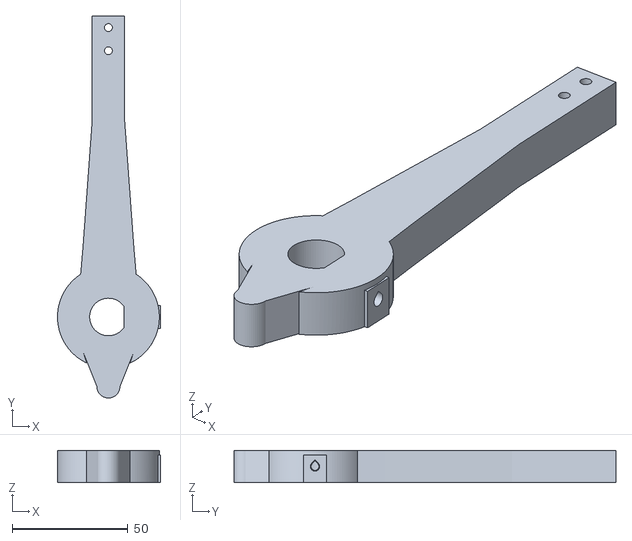
[picture p118: CAD file, 2026-10-25]
docs/mechanical/fusion-controller/opposite-sides/stl/P07S-Planar-lever-rotor-with-lower-stop-lug.stl
44.5 x 165.0 x 14.0
