albertorestifo/trenino/docs/mechanical/fusion-controller/raised-wide-travel/diagnostic-slices/P08-Cam-8-gates---116-degree-span.gcode.3mf

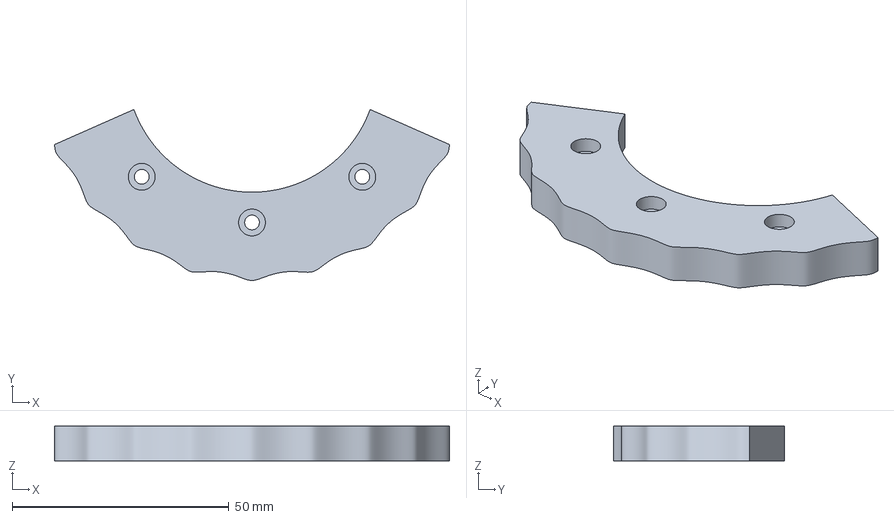
[picture p119: CAD file, 2026-10-25]
docs/mechanical/fusion-controller/raised-wide-travel/diagnostic-slices/P08-Cam-8-gates---116-degree-span.gcode.3mf
91.2 x 39.5 x 8.00 mm
