albertorestifo/trenino/docs/mechanical/fusion-controller/recessed-bottom-sensor/raw-stl/P08-Cam-5-gates---stable-endpoints.stl

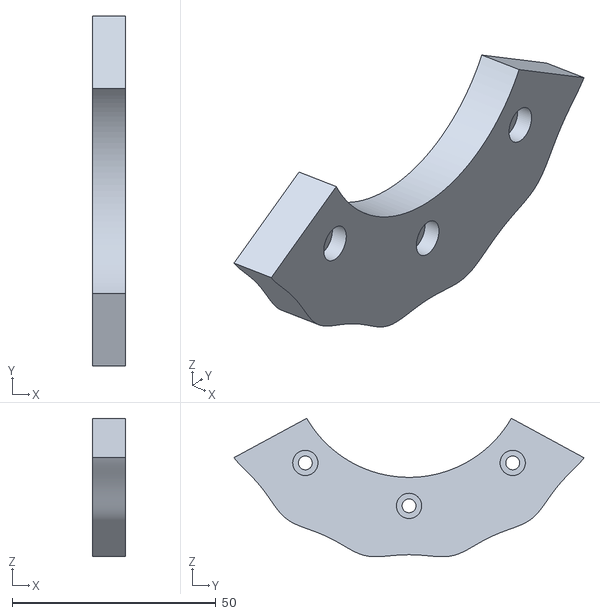
[picture p120: CAD file, 2026-10-25]
docs/mechanical/fusion-controller/recessed-bottom-sensor/raw-stl/P08-Cam-5-gates---stable-endpoints.stl
8.00 x 85.9 x 34.0
