albertorestifo/trenino/docs/mechanical/fusion-controller/sliced/P15-Preload-limit-collar-4-mm.gcode.3mf

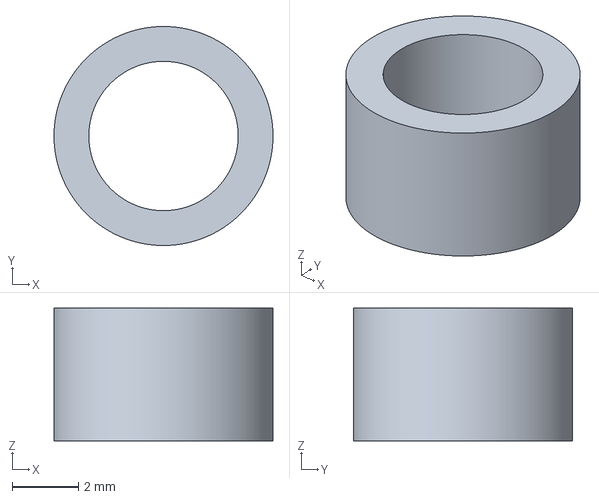
[picture p121: CAD file, 2026-10-25]
docs/mechanical/fusion-controller/sliced/P15-Preload-limit-collar-4-mm.gcode.3mf
6.60 x 6.60 x 4.00 mm
