albertorestifo/trenino/docs/mechanical/integrated-print/stl/moving-M05-Drive-spacer-3.1999999999999993-mm-id9.stl

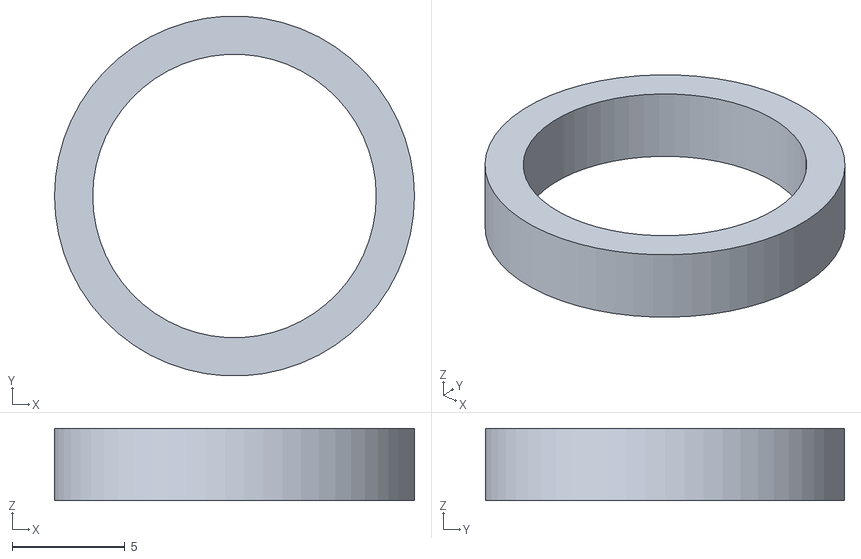
[picture p122: CAD file, 2026-10-25]
docs/mechanical/integrated-print/stl/moving-M05-Drive-spacer-3.1999999999999993-mm-id9.stl
16.0 x 16.0 x 3.20
