albertorestifo/trenino/docs/mechanical/reviewed-print/sliced/moving-M02-Printed-bushing-54---replaces-625-bearing-id2.gcode.3mf

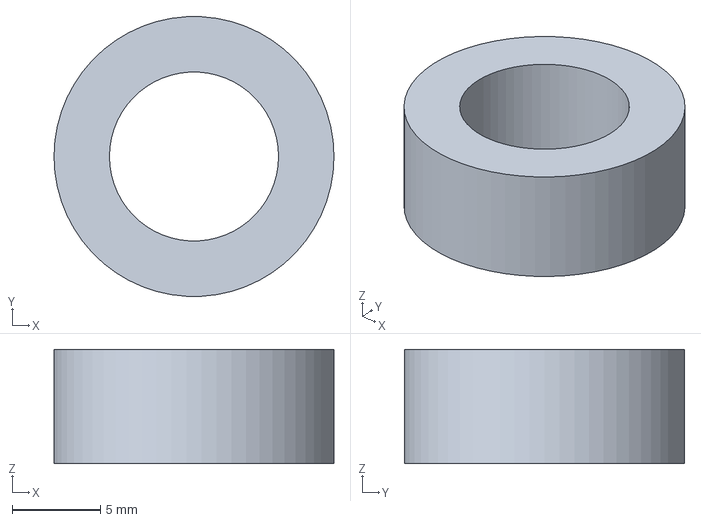
[picture p123: CAD file, 2026-10-25]
docs/mechanical/reviewed-print/sliced/moving-M02-Printed-bushing-54---replaces-625-bearing-id2.gcode.3mf
15.9 x 15.9 x 6.50 mm
