albertorestifo/trenino/docs/mechanical/reviewed-print/stl/moving-M09-Roller---10-mm-diameter-x-9.5-mm-id6.stl

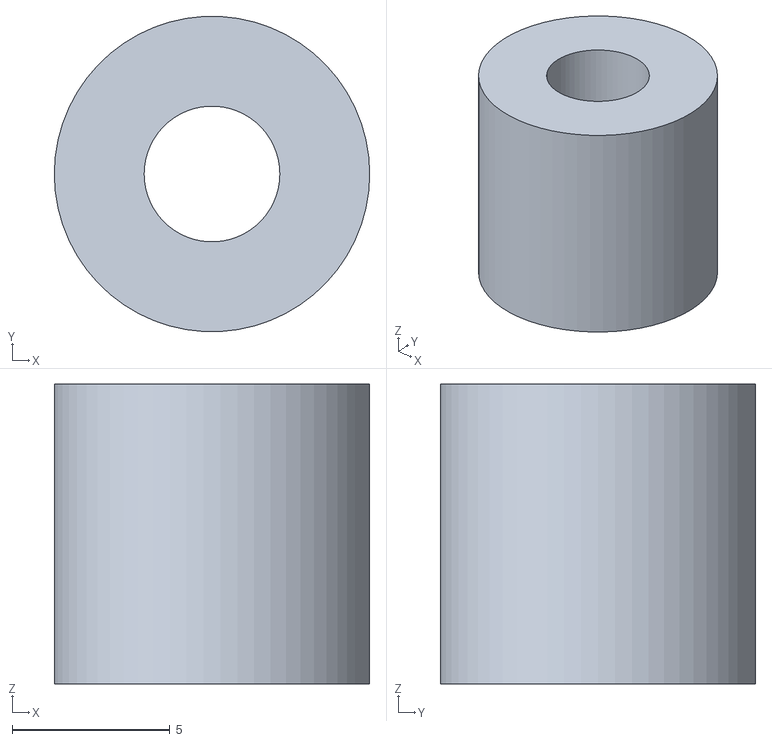
[picture p124: CAD file, 2026-10-25]
docs/mechanical/reviewed-print/stl/moving-M09-Roller---10-mm-diameter-x-9.5-mm-id6.stl
10.0 x 9.99 x 9.50
