albertorestifo/trenino/docs/mechanical/slicer-check/sliced/cam.gcode.3mf

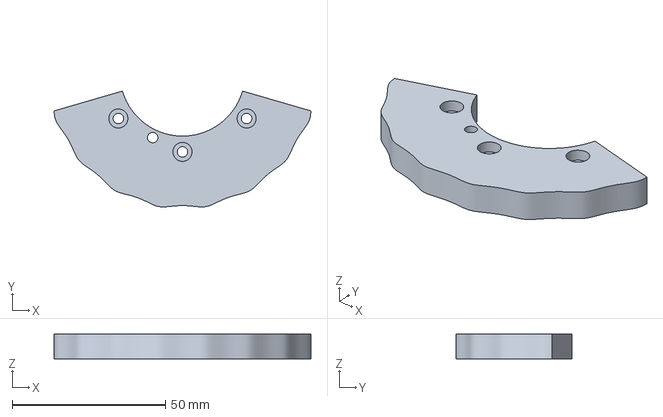
[picture p125: CAD file, 2026-10-25]
docs/mechanical/slicer-check/sliced/cam.gcode.3mf
83.7 x 37.8 x 8.00 mm
