albertorestifo/trenino/(list of files, cad)

Other CAD files:
docs/mechanical/fusion-controller/stl/P05-Printed-main-shaft---horizontal-print.stl
docs/mechanical/fusion-controller/raw-stl/P05-Printed-main-shaft---horizontal-print.stl
docs/mechanical/reviewed-print/stl/moving-M04-One-piece-lever-and-original-48T-main-gear-id11.stl
docs/mechanical/fusion-controller/Changed-Parts-P2S-PLA.gcode.3mf
docs/mechanical/fusion-controller/direct-v6-build-fixes/stl/P05-Shaft-lower-half.stl
docs/mechanical/fusion-controller/inventory-support-free-revision/raw-stl/P05-Shaft-upper-half.stl
docs/mechanical/fusion-controller/one-piece-shaft/raw-stl/P08-Cam-9-gates-Class-323---strong-center-and-Emergency.stl
docs/mechanical/fusion-controller/one-piece-shaft/stl/P08-Cam-9-gates-Class-323---strong-center-and-Emergency.stl
docs/mechanical/fusion-controller/opposite-sides/raw-stl/G01R-48T-gear-with-upper-clamp.stl
docs/mechanical/fusion-controller/recessed-bottom-sensor/raw-stl/P28-Shaft-alignment-key--5.stl
docs/mechanical/fusion-controller/recessed-bottom-sensor/stl/P22-Follower-right-axial-spacer.stl
docs/mechanical/fusion-controller/support-revision/Support-Reduced-P2S-PLA.gcode.3mf
docs/mechanical/fusion-controller/direct-v6-build-fixes/optional-stl/P09-Grip-insert-half.stl
docs/mechanical/fusion-controller/direct-v6-build-fixes/raw-stl/P07-Integral-lever-rotor-and-cam-carrier.stl
docs/mechanical/fusion-controller/direct-v6-build-fixes/required-stl/P19-Compact-one-piece-sensor-clamp.stl
docs/mechanical/fusion-controller/direct-v6-build-fixes/stl/P28-Shaft-alignment-key-5.stl
docs/mechanical/fusion-controller/gear-comparison/plates/Plate-02.3mf
docs/mechanical/fusion-controller/inventory-support-free-revision/raw-stl/P19-Compact-one-piece-sensor-clamp.stl
docs/mechanical/fusion-controller/inventory-support-free-revision/stl/P19-Compact-one-piece-sensor-clamp.stl
docs/mechanical/fusion-controller/one-piece-shaft/raw-stl/P05-One-piece-shaft-with-continuous-print-flat.stl
docs/mechanical/fusion-controller/one-piece-shaft/stl/P05-One-piece-shaft-with-continuous-print-flat.stl
docs/mechanical/fusion-controller/raised-wide-travel/diagnostic-slices/P08-Cam-3-gates---116-degree-span.gcode.3mf
docs/mechanical/fusion-controller/raised-wide-travel/stl/P08-Cam-5-gates---116-degree-span.stl
docs/mechanical/fusion-controller/recessed-bottom-sensor/stl/P08-Cam-3-gates---stable-endpoints.stl
docs/mechanical/fusion-controller/sliced/P08-Cam-3-gates---stable-endpoints.gcode.3mf
docs/mechanical/fusion-controller/direct-v6-build-fixes/diagnostic-slices/P02-Right-rail-sideplate.gcode.3mf
docs/mechanical/fusion-controller/direct-v6-build-fixes/raw-stl/P13-Spring-reaction-crossblock.stl
docs/mechanical/fusion-controller/gear-comparison/plate-slice-check/Plate-03.gcode.3mf
docs/mechanical/fusion-controller/gear-comparison/plates/Plate-01.3mf
docs/mechanical/fusion-controller/gear-comparison/stl/P09-Grip-insert-half.stl
docs/mechanical/fusion-controller/inventory-support-free-revision/diagnostic-slices/P02-Right-rail-sideplate.gcode.3mf
docs/mechanical/fusion-controller/inventory-support-free-revision/raw-stl/P22-Follower-right-axial-spacer.stl
docs/mechanical/fusion-controller/raised-wide-travel/diagnostic-slices/P08-Cam-7-gates---116-degree-span.gcode.3mf
docs/mechanical/fusion-controller/raised-wide-travel/raw-stl/P08-Cam-3-gates---116-degree-span.stl
docs/mechanical/fusion-controller/raised-wide-travel/stl/P03-Left-flanged-journal-bush.stl
docs/mechanical/fusion-controller/recessed-bottom-sensor/raw-stl/G03R-Lower-removable-potentiometer-panel.stl
docs/mechanical/fusion-controller/recessed-bottom-sensor/stl/G01R-48T-gear-with-upper-clamp.stl
docs/mechanical/fusion-controller/stl/P07-Integral-lever-rotor-and-cam-carrier.stl
docs/mechanical/slicer-check/sliced/bracket.gcode.3mf
docs/mechanical/fusion-controller/direct-v6-build-fixes/diagnostic-slices/P04-Right-bush-upper-half.gcode.3mf
docs/mechanical/fusion-controller/direct-v6-build-fixes/raw-stl/P05-Shaft-lower-half.stl
docs/mechanical/fusion-controller/direct-v6-build-fixes/required-stl/P04-Right-bush-lower-half.stl
docs/mechanical/fusion-controller/gear-comparison/diagnostic-slices/P13-Spring-reaction-crossblock.gcode.3mf
docs/mechanical/fusion-controller/inventory-support-free-revision/raw-stl/P26-Captured-printed-pivot-upper-half.stl
docs/mechanical/fusion-controller/opposite-sides/diagnostic-slices/P08-Cam-5-gates---116-degree-span.gcode.3mf
docs/mechanical/fusion-controller/opposite-sides/raw-stl/P06-Shaft-retaining-cap.stl
docs/mechanical/fusion-controller/raised-wide-travel/raw-stl/P24-Right-rotor-thrust-spacer.stl
docs/mechanical/fusion-controller/raised-wide-travel/stl/P23-Left-rotor-thrust-spacer.stl
docs/mechanical/fusion-controller/raw-stl/P04-Right-flanged-journal-bush.stl
docs/mechanical/fusion-controller/recessed-bottom-sensor/diagnostic-slices/G01R-48T-gear-with-upper-clamp.gcode.3mf
docs/mechanical/fusion-controller/recessed-bottom-sensor/stl/G03R-Lower-removable-potentiometer-panel.stl
docs/mechanical/fusion-controller/stl/P25-Left-pivot-sleeve-centering-insert.stl
docs/mechanical/fdm-stl/Cam Detent — FDM print layout - 05 — Bracket — mounting face down — supports required.stl
docs/mechanical/fusion-controller/direct-v6-build-fixes/diagnostic-slices/P04-Right-bush-lower-half.gcode.3mf
docs/mechanical/fusion-controller/direct-v6-build-fixes/raw-stl/P23-Left-rotor-thrust-spacer.stl
docs/mechanical/fusion-controller/direct-v6-build-fixes/stl/P27-Printed-guide-sleeve-4.stl
docs/mechanical/fusion-controller/gear-comparison/diagnostic-slices/P25-Captured-printed-pivot-lower-half.gcode.3mf
docs/mechanical/fusion-controller/gear-comparison/raw-stl/G01-48T-lever-gear.stl
docs/mechanical/fusion-controller/gear-comparison/stl/P13-Spring-reaction-crossblock.stl
docs/mechanical/fusion-controller/inventory-support-free-revision/diagnostic-slices/P23-Left-rotor-thrust-spacer.gcode.3mf
docs/mechanical/fusion-controller/inventory-support-free-revision/raw-stl/P05-Shaft-lower-half.stl
docs/mechanical/fusion-controller/inventory-support-free-revision/stl/P05-Shaft-upper-half.stl
docs/mechanical/fusion-controller/Before-mount-access-fix.f3d
docs/mechanical/fusion-controller/Fusion-Train-Controller.f3d
docs/mechanical/fusion-controller/direct-v6-build-fixes/Before-Build-Fixes-v6.f3d
docs/mechanical/fusion-controller/direct-v6-build-fixes/Direct-Pot-Recessed-Build-Fixes.f3d
docs/mechanical/fusion-controller/direct-v6-build-fixes/diagnostic-slices/P01-Left-rail-sideplate.gcode.3mf
docs/mechanical/fusion-controller/direct-v6-build-fixes/diagnostic-slices/P05-Shaft-upper-half.gcode.3mf
docs/mechanical/fusion-controller/direct-v6-build-fixes/diagnostic-slices/P07-Integral-lever-rotor-and-cam-carrier.gcode.3mf
docs/mechanical/fusion-controller/direct-v6-build-fixes/diagnostic-slices/P13-Spring-reaction-crossblock.gcode.3mf
docs/mechanical/fusion-controller/direct-v6-build-fixes/diagnostic-slices/P19-Compact-one-piece-sensor-clamp.gcode.3mf
docs/mechanical/fusion-controller/direct-v6-build-fixes/raw-stl/P01-Left-rail-sideplate.stl
docs/mechanical/fusion-controller/direct-v6-build-fixes/raw-stl/P02-Right-rail-sideplate.stl
docs/mechanical/fusion-controller/direct-v6-build-fixes/raw-stl/P04-Right-bush-lower-half.stl
docs/mechanical/fusion-controller/direct-v6-build-fixes/raw-stl/P04-Right-bush-upper-half.stl
docs/mechanical/fusion-controller/direct-v6-build-fixes/raw-stl/P05-Shaft-upper-half.stl
docs/mechanical/fusion-controller/direct-v6-build-fixes/raw-stl/P09-Grip-insert-half.stl
docs/mechanical/fusion-controller/direct-v6-build-fixes/raw-stl/P16-Compact-adjustable-RK097-mount.stl
docs/mechanical/fusion-controller/direct-v6-build-fixes/stl/P08-Cam-7-gates---stable-endpoints.stl
docs/mechanical/fusion-controller/direct-v6-build-fixes/stl/P10-Grip-screw-half.stl
docs/mechanical/fusion-controller/direct-v6-build-fixes/stl/P11-Forked-roller-follower.stl
docs/mechanical/fusion-controller/direct-v6-build-fixes/stl/P24-Right-rotor-thrust-spacer.stl
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
