albertorestifo/trenino/docs/mcp-setup.md

# AI-Powered Train Setup with Claude

> **Quick connect:** with Trenino running, Claude Code users run `claude mcp add --transport http --scope user trenino http://localhost:4000/mcp`. Other clients: see [Setup](#setup), or point your assistant at `http://localhost:4000/llms.txt`.
>
> The `/mcp` endpoint and `/llms.txt` need a Trenino release newer than 0.8.2. On 0.8.2 and earlier, use the SSE endpoint instead: `claude mcp add --transport sse --scope user trenino http://localhost:4000/mcp/sse`.

Trenino includes a built-in MCP (Model Context Protocol) server that lets you use Claude to configure your trains through natural conversation. Instead of manually setting up output bindings, button mappings, and command sequences, describe what you want and let Claude handle the details.

## What Can Claude Do?

- **Explore the simulator API** to discover what controls a train has (throttle, brakes, lights, doors, etc.)
- **Detect your hardware** — Claude can ask you to press a button or move a lever, and it will automatically identify the input for you. No need to look up input IDs.
- **Set up output bindings** — "make the red LED turn on when speed exceeds 50" and Claude will find the right endpoint, pick your LED, and create the binding
- **Configure button mappings** — "this button should toggle the headlights" and Claude will create the binding with the correct mode and endpoint
- **Create command sequences** — "create a startup sequence that turns on the battery, then the pantograph, then the main breaker with delays between each"
- **Write and manage Lua scripts** — "create a script that flashes my warning LED when speed exceeds 100 km/h" and Claude will write, create, and enable the script for you
- **Set up display bindings** — "show the current speed on my 7-segment display" and Claude will find the speed endpoint, your display module, and create the binding with the right format string
- **Experiment with controls** — read and write simulator values in real-time to test what endpoints do before committing to a configuration

## Setup

### Requirements

- Trenino running on your machine (the MCP server lives inside the desktop app at `http://localhost:4000/mcp`)
- An MCP client on the same computer: Claude Code, Claude Desktop, Codex, Gemini CLI, VS Code, Cursor, …

The server only accepts connections from your own computer and needs no API key.

### Let your assistant do it

With Trenino open, ask a coding agent running on your computer (Claude Code, Codex, Gemini CLI, GitHub Copilot in VS Code, …) to **"install the Trenino MCP"**. Trenino publishes everything an agent needs to set itself up:

| URL | What it is |
|-----|---|
| `http://localhost:4000/llms.txt` | Setup guide written for AI assistants, with the exact install command for each client |
| `http://localhost:4000/mcp/server-card` | [MCP Server Card](https://modelcontextprotocol.io/seps/2127-mcp-server-cards) describing both transports |
| `http://localhost:4000/.well-known/ai-catalog.json` | AI Catalog entry pointing at the server card |

If the agent does not find it, tell it: *"Read http://localhost:4000/llms.txt and install the Trenino MCP server."*

Chat apps such as Claude Desktop cannot do this themselves: they fetch web pages from the cloud, so they cannot see your computer's `localhost`, and they cannot edit their own config. Use the manual steps below.

### Manual setup

Trenino speaks the current **Streamable HTTP** transport at `http://localhost:4000/mcp`, and the older **HTTP+SSE** transport at `http://localhost:4000/mcp/sse` for clients that still need it. Releases up to 0.8.2 only have the SSE endpoint: replace `--transport http` with `--transport sse` and `/mcp` with `/mcp/sse` in the commands below.

**Claude Code**

```bash
claude mcp add --transport http --scope user trenino http://localhost:4000/mcp
```

Inside the Trenino repository this is already configured through the checked-in `.mcp.json`, which uses the SSE endpoint so it works with every Trenino version.

**Claude Desktop**

Claude Desktop only launches local (stdio) servers from its config file, so it connects through the [`mcp-remote`](https://www.npmjs.com/package/mcp-remote) bridge, which needs [Node.js](https://nodejs.org). Add this to `claude_desktop_config.json` (macOS: `~/Library/Application Support/Claude/`, Windows: `%APPDATA%\Claude\`), then fully quit and reopen Claude Desktop:

```json
{
  "mcpServers": {
    "trenino": {
      "command": "npx",
      "args": ["-y", "mcp-remote", "http://localhost:4000/mcp"]
    }
  }
}
```

Adding Trenino under **Settings → Connectors** does not work: custom connectors are reached from Anthropic's servers, which cannot see your computer.

**Codex** (CLI, IDE extension and app)

```bash
codex mcp add trenino --url http://localhost:4000/mcp
```

**Gemini CLI**

```bash
gemini mcp add --transport http trenino http://localhost:4000/mcp
```

**VS Code** (GitHub Copilot)

```bash
code --add-mcp '{"name":"trenino","type":"http","url":"http://localhost:4000/mcp"}'
```

**Cursor** — add to `~/.cursor/mcp.json`:

```json
{
  "mcpServers": {
    "trenino": { "url": "http://localhost:4000/mcp" }
  }
}
```

**ChatGPT** (web and desktop) is not supported: its connectors run in OpenAI's cloud and need a public HTTPS address, while Trenino deliberately refuses connections from outside your computer. Use Codex instead.

## Example Workflows

### Setting Up a Complete Train

> "I have a BR 146.2. Help me set up my buttons and LEDs."

Claude will walk you through it interactively:
1. Look up your train configuration
2. Ask you to press each button on your hardware to identify it
3. Ask you to interact with the matching control in Train Sim World to find the endpoint
4. Create the binding with the right mode and values
5. Repeat for LEDs, sequences, and other controls

### Setting Up Output Bindings (LEDs)

> "Set up my red LED to turn on when the emergency brake is active."

Claude will:
1. Look up the train configuration
2. Browse the simulator API to find the emergency brake endpoint
3. List your hardware outputs to find the red LED
4. Create an output binding with the right condition

### Creating Command Sequences

> "Create a cold start sequence for the BR 187 that turns on the battery isolator, waits 500ms, raises the pantograph, waits 1 second, then closes the main breaker."

Claude will:
1. Explore the simulator API to find the correct endpoints for each step
2. Create a sequence with the right commands, values, and delays
3. Optionally bind it to a button for you

### Experimenting with Controls

> "What controls does the current train have? Try setting the wipers to on."

Claude will browse the simulator API tree, find the wiper endpoint, and set the value — you'll see the result in real-time in the game.

### Writing Lua Scripts

> "Create a script for the BR 442 that turns on my warning LED when speed exceeds 100 km/h, and turns it off when speed drops below 95."

Claude will:
1. Look up the speed endpoint for that train (`CurrentDrivableActor.Function.HUD_GetSpeed`, which returns m/s — Claude will convert to km/h automatically)
2. Find your warning LED output ID
3. Write the Lua script with hysteresis logic
4. Create and enable the script with the speed endpoint as the trigger

## Available Tools

Claude has access to dozens of tools for interacting with Trenino (the client lists them all once connected):

| Category | Tools |
|---|---|
| Simulator | Browse endpoints, read values, write values |
| Trains | List trains, get full train configuration |
| Elements | List, create, delete buttons, levers and selectors |
| Devices | List devices, list inputs, list outputs; list, create, update, delete I2C modules |
| Detection | Detect hardware inputs (button/lever) |
| Levers | List simulator levers, get, link to a simulator lever, calibrate, bind input, open the Lever Setup Wizard |
| Output Bindings | List, create, update, delete |
| Button Bindings | Get, create, update, delete |
| Selectors | Get, configure, split evenly, delete |
| Sequences | List, create, update, delete |
| Scripts | List, get, create, update, delete Lua scripts |
| Display Bindings | List, create, update, delete display bindings |
| Virtual Joystick | Check status and installation; enable, disable, retry, clean up; list, map (axis/button), delete mappings |

## Tips

- **Start Trenino first** — the MCP server is part of Trenino's web server. Claude can only connect when Trenino is running.
- **Have the game running** — simulator tools need Train Sim World running with the External Interface API enabled.
- **Let Claude detect your inputs** — rather than looking up input IDs manually, let Claude prompt you to press the button or move the lever you want to bind. A modal will appear in the Trenino UI.
- **Ask Claude to explore** — if you're not sure what endpoints a train has, ask Claude to browse the simulator API tree.
- **Be specific about hardware** — if you have multiple devices or outputs with similar names, mention the specific one (e.g., "the LED on pin 5 of my Arduino Mega").
