albertorestifo/trenino/docs/mechanical/fusion-controller/inventory-support-free-revision/PRINT-ORIENTATIONS.md

# Print orientations — v6

Keep these orientations when arranging parts. All dimensions in mm. No generated supports; short bridges require fit inspection.

| File | Bed face | Size X × Y × Z | Bed area mm² |
|---|---|---|---:|
| P01-Left-rail-sideplate.stl | X minimum face down | 190.00 × 92.00 × 27.00 | 10184.86 |
| P02-Right-rail-sideplate.stl | X minimum face down | 190.00 × 88.00 × 42.15 | 6867.29 |
| P03-Left-flanged-journal-bush.stl | X minimum face down | 25.50 × 25.50 × 13.20 | 391.83 |
| P04-Right-flanged-journal-bush.stl | X maximum face down | 25.50 × 25.50 × 13.20 | 391.83 |
| P05-Shaft-lower-half.stl | Y maximum split face down | 80.70 × 20.00 × 10.00 | 1055.74 |
| P05-Shaft-upper-half.stl | Y minimum split face down | 80.70 × 20.00 × 6.50 | 1055.74 |
| P06-Shaft-retaining-cap.stl | X minimum face down | 20.00 × 20.00 × 2.00 | 305.03 |
| P07-Integral-lever-rotor-and-cam-carrier.stl | X maximum face down | 71.01 × 171.00 × 25.00 | 4348.34 |
| P08-Cam-7-gates---stable-endpoints.stl | X minimum face down | 84.64 × 34.41 × 8.00 | 1551.23 |
| P08-Cam-5-gates---stable-endpoints.stl | X minimum face down | 85.92 × 33.98 × 8.00 | 1579.56 |
| P08-Cam-3-gates---stable-endpoints.stl | X minimum face down | 84.46 × 33.50 × 8.00 | 1574.94 |
| P09-Grip-insert-half.stl | Z minimum face down | 20.03 × 40.07 × 60.00 | 122.42 |
| P10-Grip-screw-half.stl | Z minimum face down | 20.04 × 40.07 × 60.00 | 122.42 |
| P11-Forked-roller-follower.stl | Z minimum face down | 16.00 × 67.00 × 14.00 | 522.00 |
| P13-Spring-reaction-crossblock.stl | Z maximum face down | 48.00 × 30.00 × 21.00 | 1084.73 |
| P21-Follower-left-axial-spacer.stl | X minimum face down | 12.00 × 12.00 × 27.80 | 57.67 |
| P22-Follower-right-axial-spacer.stl | X minimum face down | 12.00 × 12.00 × 3.80 | 57.67 |
| P23-Left-rotor-thrust-spacer.stl | X minimum face down | 20.00 × 20.00 × 16.85 | 102.91 |
| P24-Right-rotor-thrust-spacer.stl | X minimum face down | 20.00 × 20.00 × 16.85 | 102.91 |
| P25-Captured-printed-pivot-lower-half.stl | Y maximum split face down | 51.70 × 8.00 × 4.00 | 413.60 |
| P26-Captured-printed-pivot-upper-half.stl | Y minimum split face down | 51.70 × 8.00 × 4.00 | 413.60 |
| P27-Printed-guide-sleeve-4.stl | Z minimum face down | 5.00 × 5.00 × 6.00 | 11.08 |
| P27-Printed-guide-sleeve-20.stl | Z minimum face down | 5.00 × 5.00 × 6.00 | 11.08 |
| P14-Captive-spring-cup-for-9-mm-spring.stl | Z maximum face down | 23.60 × 12.00 × 8.00 | 237.43 |
| P15-Recessed-preload-limit-collar-1-mm.stl | Z minimum face down | 6.40 × 6.40 × 1.00 | 23.09 |
| P16-Compact-adjustable-RK097-mount.stl | X maximum face down | 66.00 × 38.00 × 15.00 | 2419.34 |
| P18-Compact-floating-coupling-disc.stl | X minimum face down | 24.00 × 24.00 × 8.00 | 352.03 |
| P19-Compact-one-piece-sensor-clamp.stl | X maximum face down | 18.00 × 21.00 × 12.00 | 261.98 |
| P28-Shaft-alignment-key--5.stl | Y minimum split face down | 3.00 × 7.80 × 3.00 | 23.40 |
| P28-Shaft-alignment-key-5.stl | Y minimum split face down | 3.00 × 7.80 × 3.00 | 23.40 |
