albertorestifo/trenino/docs/mechanical/fusion-controller/inventory-support-free-revision/illustrated-guide/Compact-Lever-v6-Assembly-Guide.pdf

COMPACT LEVER / FUSION v6

# Lever assembly guide

A practical build sequence for the compact stock-based prototype

Build one complete lever from the v6 parts. Start with the small fits, assemble the moving mechanisms on the bench, then fit the unit to the rails. The pictures below use the saved model and its exported geometry.

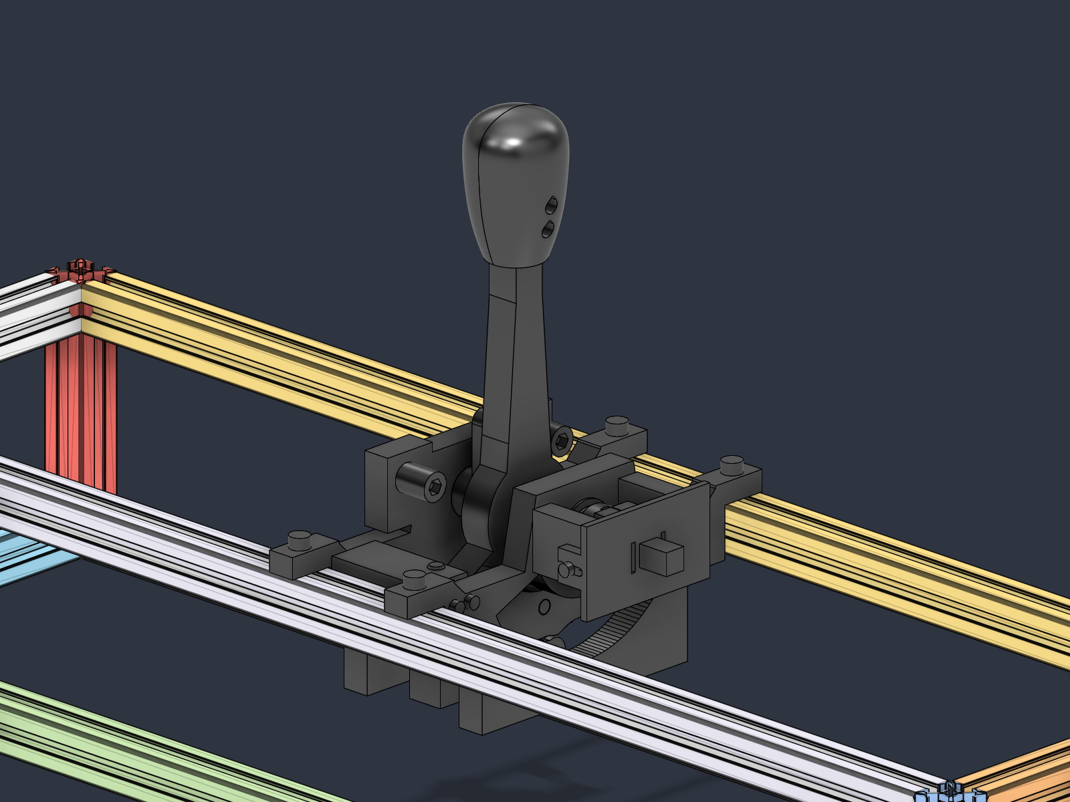
[picture p127: figure]

Read the pictures Teal, amber and violet distinguish printed parts in the exploded views. Those views separate parts for clarity; they do not show working gaps. Diagrams are schematic and not to scale.

Use the right files Print from the v6 stl folder. There are 30 files with three alternative cams: choose one cam, for 28 printed pieces. P12, P17 and P20 are intentionally absent. Both P05 halves, both pivot halves, both guide sleeves and both alignment keys are needed.

Prototype checks Sensor dimensions and its supplied nut/washer are not confirmed. Spring rate and solid height are assumed. Printed shaft and pivot strength still need a low-load physical test. These checks appear at the relevant steps.

Assembly guide | 25 October 2026 | Dimensions in mm | 1

# Prepare the bench

Sort screws by length before assembly

Hardware | Qty | Used for
M3 x 8 cap screws | 3 | Shaft joint 2; retaining cap 1
M3 x 10 cap screws | 3 | One cam
M3 x 12 cap screws | 4 | Carriage 2; cup guides 2
M3 x 16 cap screws | 2 | Rotor clamp; sensor clamp
M3 x 20 cap screws | 10 | Crossblock 4; grip 2; stops 2; bearing axle; preload
M3 plain nuts | 3 | Stops 2; bearing axle 1
M3 x 5.7 heat-set inserts | 19 | CNC Kitchen standard inserts
M5 x 14 screws and M5 T-nuts | 4 each | Rail mounts
623ZZ bearings | 2 | 3 mm bore x 10 mm OD x 4 mm width
Compression spring | 1 | 1 mm wire; 9 mm OD; 20 mm free length
RK097 A10K potentiometer | 1 | Mounting nut/washer assumed supplied

Tools Matching hex keys, a controlled-temperature insert tool, calipers, small deburring tools and a multimeter for sensor centering. A temporary holding tool helps retract the follower during cam changes.

Before fitting hardware Remove loose brim and strings. Keep bearing bores and coupling grooves smooth without enlarging them unnecessarily. Test a heat-set insert on scrap before installing the full set. Do not force a tight shaft through a bush.

Inventory status Records show enough of the seven BOM stock items, but most counts are estimates. Confirm the potentiometer mounting hardware and actual T-nut fit. No metal tube cutting is required.

# Join the printed shaft

Step 1 Install inserts before closing mating parts

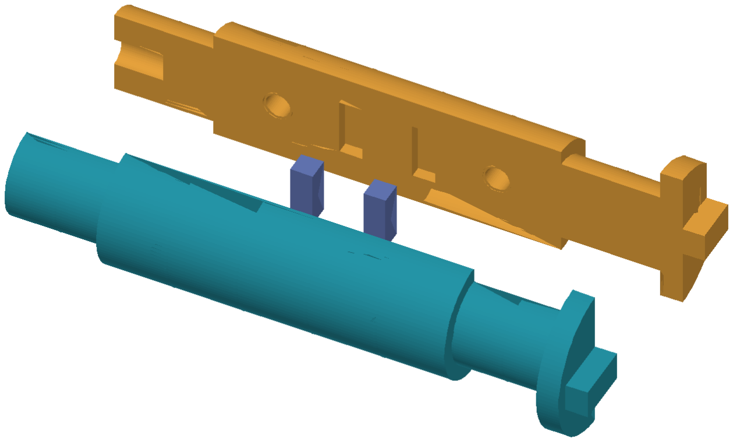
[picture p128: figure]

P05 lower half | P05 upper half | Two P28 keys

### 1 Seat the inserts

Install three inserts in P05: two for the joining screws and one for the retaining cap. Keep insert faces flush and preserve the shaft seam and bore geometry.

### 2 Fit the two alignment keys

Seat both P28 keys in their mating pockets. Bring the flat split faces together. The keys align the halves; the screws hold them together.

### 3 Fasten the halves

Use two M3 x 8 cap screws in the recessed joining holes. Tighten evenly until the seam closes. Stop if an insert moves or the shaft distorts.

Check The seam must be flush along the journals and coupling tongue. Test the shaft in P03/P04 by hand. It must turn freely without scraping or forcing. The split shaft is a prototype and has no validated load rating.

# Build the rotor stack

Step 2 Assemble the shaft bearings and rotor on the bench

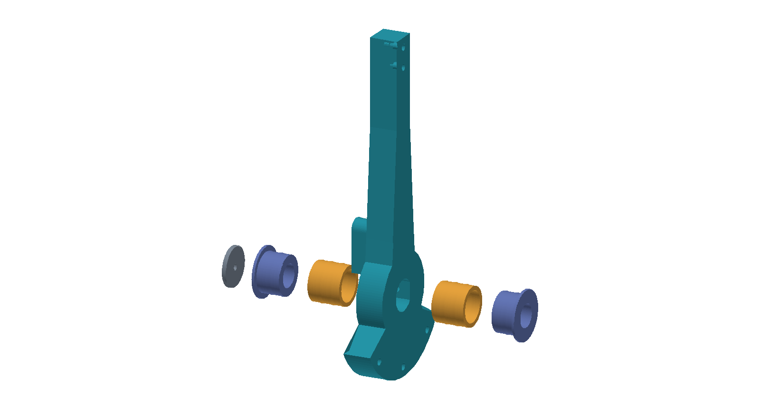
[picture p129: figure]

P07 rotor and lever | P23 and P24 spacers | P03 and P04 bushes

### 4 Install the remaining inserts

Insert allocation: P07 rotor 4; P09 grip 2; P13 crossblock 7; P19 sensor clamp 1; carriage supports on P02 2. Together with the three shaft inserts, this is 19. Keep underside pockets accessible.

### 5 Arrange the stack

From the retaining-cap side toward the sensor: P06 cap, P03 left bush, P23 left spacer, P07 rotor, P24 right spacer, P04 right bush. The P05 shaft passes through this stack; it is omitted from the exploded picture for clarity.

### 6 Keep the rotor free

Fit the retaining cap with one M3 x 8 and the rotor clamp with one M3 x 16. Preserve about 0.3 mm total end float. Do not tighten the cap to eliminate the designed running clearance.

Check Bush flanges face outward at the plates. Tighten the rotor clamp only enough to remove drive play without crushing the printed shaft. Install this stack between the plates during Step 3.

# Fit the follower and pivot

Step 3 The pivot is trapped when the sideplates are closed

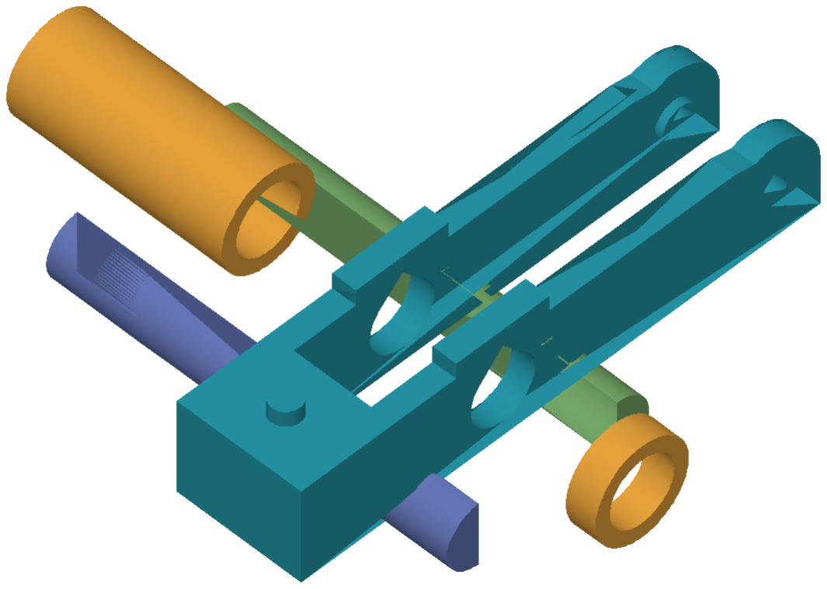
[picture p130: figure]

P11 follower | P21 long / P22 short | P25 violet / P26 green

### 7 Install the bearing pair

Fit the two 623ZZ bearings between the fork pads with one M3 x 20 axle screw and one plain nut. The pads contact the inner races. Both outer rings must turn freely after tightening.

pad | 623ZZ | 623ZZ | pad

Schematic axle section • inner races carry clamp load

### 8 Capture the printed pivot

Mate P25 and P26 into one round pivot. Pass it through P21, the follower and P22. P21 is the long left spacer; P22 is the short sensor-side spacer. Seat both pivot ends in the blind sideplate pockets.

### 9 Bring the plates together

Install the rotor stack and pivot assembly between P01/P02. Attach P13 with four M3 x 20 screws. A sideplate must be released to remove the captive pivot later.

Check The follower pivots freely with slight axial clearance. Verify bearing pads do not rub shields. Do not assume the printed split pivot has the strength of a metal sleeve.

# Assemble the spring cup

Step 4 Start with the lowest preload

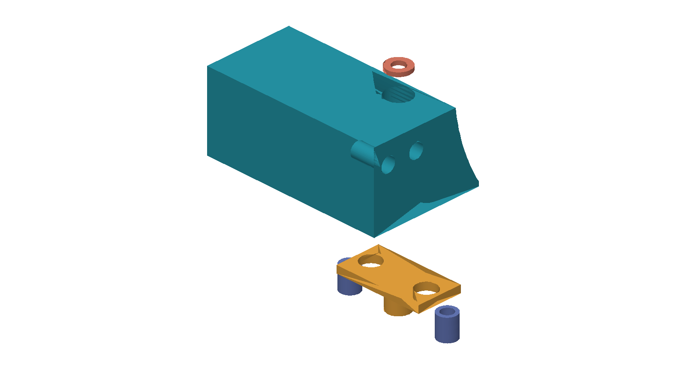
[picture p131: figure]

P13 reaction block | P14 cup and pilot | Two P27 sleeves

### 10 Fit the guides

The two printed 6 mm sleeves run through the cup guide holes. M3 x 12 screws enter from below into the underside crossblock inserts. The screws clamp the sleeves, while the cup can slide.

### 11 Fit the spring and adjuster

Place the spring between the follower spring seat and cup, around the cup pilot. Fit the 1 mm P15 collar in the top recess and the M3 x 20 preload screw. Its tip bears on the cup. Do not omit the collar.

P13 block

P15

P14 cup

Follower seat

Check the spring assumption
Installed length is nominally 17 mm; estimated minimum during operation is 15.2 mm. Solid height is assumed no more than 14 mm. Confirm that it does not bind before applying meaningful hand force. Rate and actual detent force are unknown.

Schematic side section

# Attach the cam and grip

Step 5 Fit one cam only

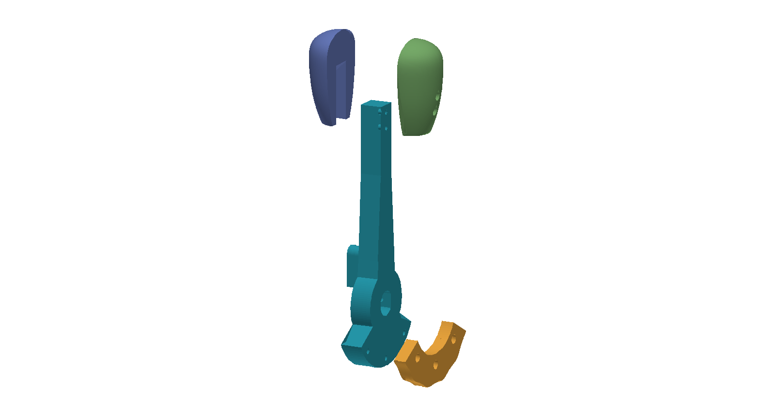
[picture p132: figure]

P07 lever | P08 selected cam | P09 violet / P10 green

### 12 Choose a cam

Fit the 3, 5 or 7 gate cam to the carrier with three M3 x 10 screws. Start with the 5 gate variant if you have no preference. The bearing pair follows its lower profile.

### 13 Fit stops and grip

Install the two plain stop nuts and recessed M3 x 20 stop screws in P01. Fit P09/P10 around the keyed stem with two M3 x 20 screws. Seat the grip seam before tightening.

### 14 Test motion before fitting the sensor

Sweep the lever gently through its range. Structural stops are at approximately -52 and +52 degrees; stable end gates are at -50 and +50 degrees. Watch the follower and spring for binding.

Check Keep fingers clear of the cam and spring while testing. Start with low preload and a light hand load. Any binding, whitening, cracked layers or shifting inserts must be resolved before further use.

# Connect the potentiometer

Step 6 Center the lever and sensor before tightening

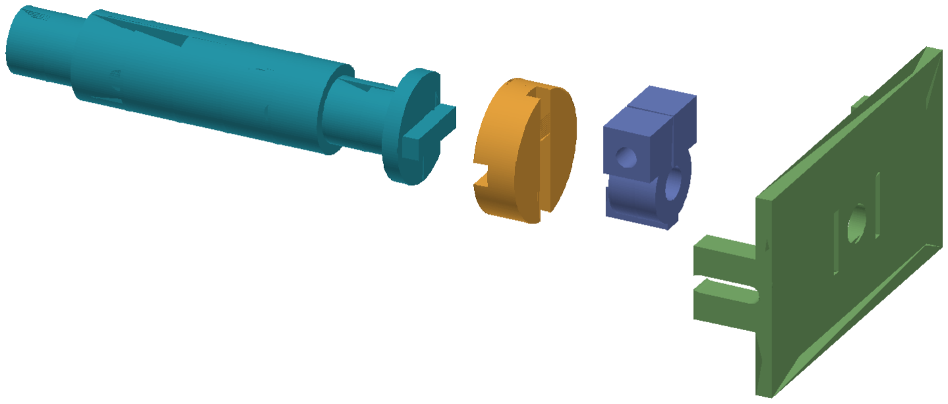
[picture p133: figure]

P05 integrated tongue | P18 floating disc | P19 split clamp

Green part: P16 adjustable mount. Exploded translations show the sequence; actual gaps are much smaller.

### 15 Fit disc and clamp

Slide P18 onto the shaft tongue. Fit P19 to the sensor shaft with one M3 x 16 clamp screw. The disc grooves are perpendicular: one accepts the shaft tongue, the other the clamp tongue.

### 16 Attach and adjust the sensor mount

Secure the potentiometer in P16 using its assumed supplied nut/washer. Tighten accessible clamp hardware, then fix the carriage with two M3 x 12 screws. Adjust axially so the tongues engage without bottoming.

P05 tongue | P18 disc | P19 clamp

Sensor

Nominal working clearances Face gaps 0.65 mm; tongue-to-groove-bottom gaps 0.45 mm. Preserve shaft end float. The disc must slide freely and must not transmit hand loads into the potentiometer.

Verify fit Model assumes a 6 mm shaft, M7 bushing and 12 mm exposed shaft. The seller’s 15 mm label does not confirm that datum. The pot and supplied mounting hardware remain unmeasured.

# Mount and commission

Step 7 Fit the complete mechanism to the upper rails

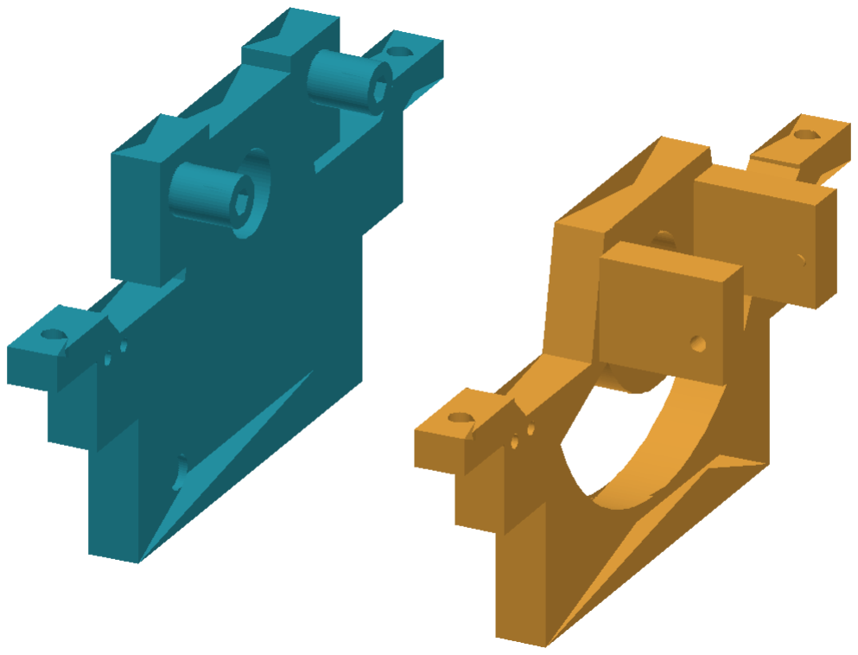
[picture p134: figure]

P01 left plate | P02 sensor-side plate

### 17 Fasten to the rails

Seat all four mounting flanges on the upper rails. Use four M5 x 14 screws with compatible M5 drop-in T-nuts. Do not add the old washer/spacer stacks. Verify thread engagement and that screw tips do not bottom out.

### 18 Check sensor travel and calibrate

Sweep slowly with power off. The structural stops must engage before the sensor reaches its own stops. Connect the sensor, calibrate electrical endpoints in firmware, and compare gate readings approached from both directions.

Leave space Overall module envelope is about 125.5 mm wide. Add clearance for fingers, wiring and tolerances. Cam servicing needs 40 mm of sideways withdrawal space; slide a neighboring module away when necessary.

Cam changes Remove the three cam screws, back off the preload adjuster, hold the follower about 5 degrees down and slide the cam sideways. Backing off the screw does not fully unload the captive spring. To unload it, restrain the cup and carefully release its guide hardware before removing the spring.

Final checks Free shaft rotation and follower movement; free bearing outer rings; seated inserts and nuts; no coil bind; coupling slides without bottoming; structural stops protect the sensor; no rail bolt bottoming. Recheck fasteners after the first light-load session.
