albertorestifo/trenino/docs/mechanical/fdm-print-layout.png

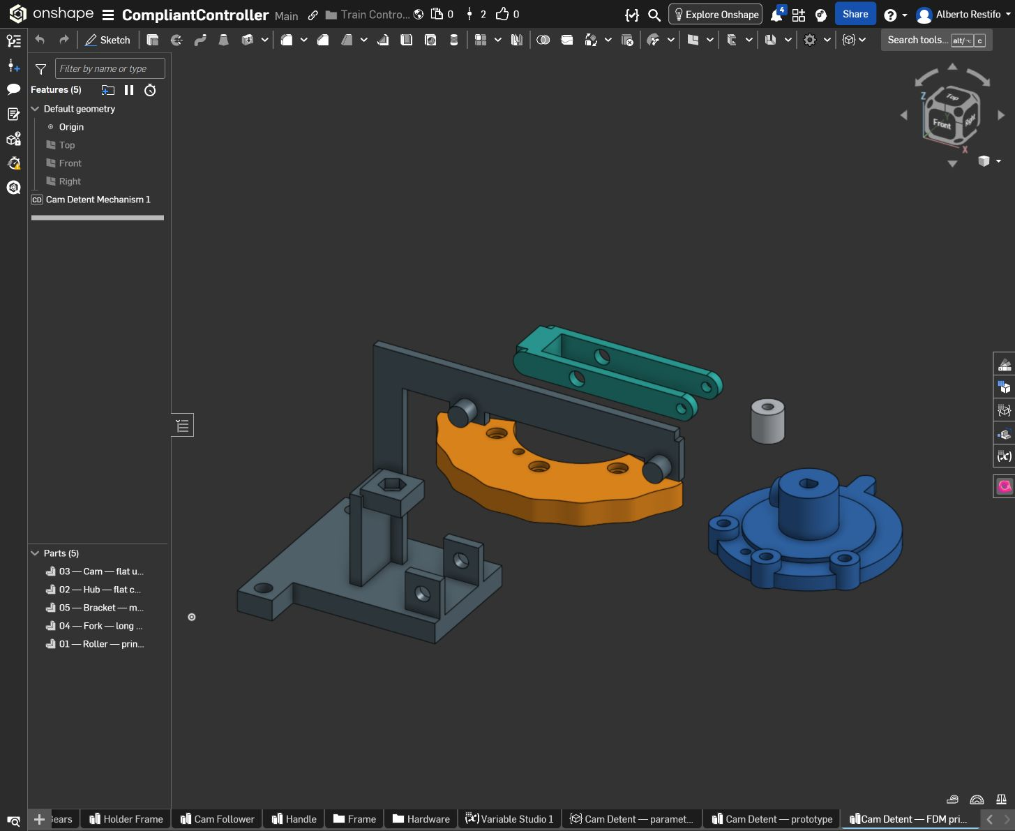
docs/mechanical/fdm-print-layout.png
