albertorestifo/trenino/docs/mechanical/fusion-controller/inventory-support-free-revision/illustrated-guide/coupling.png

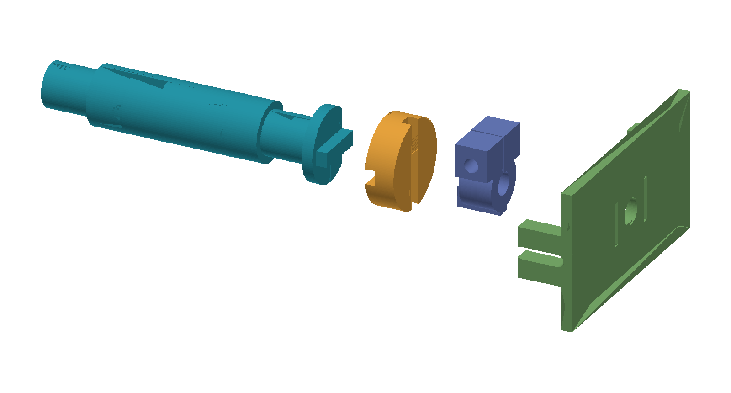
docs/mechanical/fusion-controller/inventory-support-free-revision/illustrated-guide/coupling.png
