albertorestifo/trenino/docs/mechanical/fusion-controller/inventory-support-free-revision/illustrated-guide/follower.png

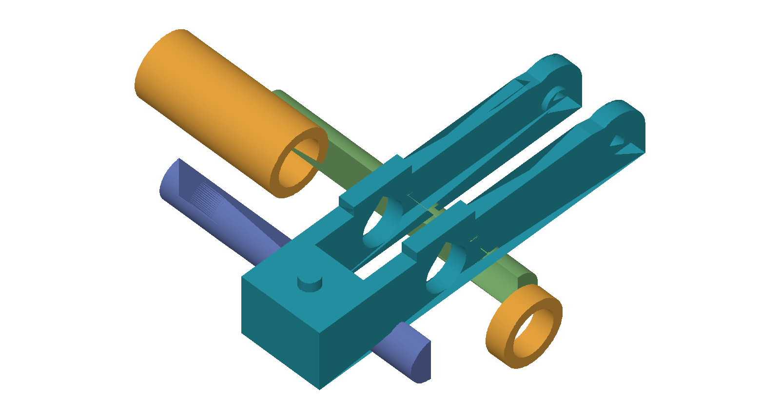
docs/mechanical/fusion-controller/inventory-support-free-revision/illustrated-guide/follower.png
