albertorestifo/trenino/docs/mechanical/fusion-controller/inventory-support-free-revision/illustrated-guide/page-8.png

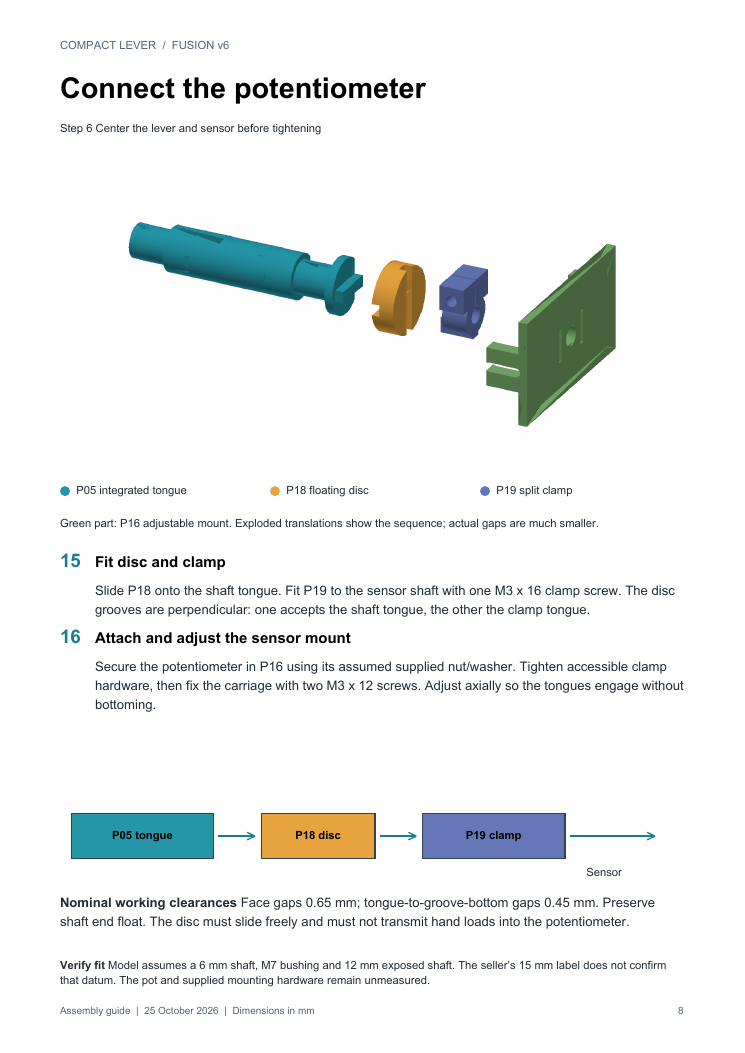
docs/mechanical/fusion-controller/inventory-support-free-revision/illustrated-guide/page-8.png
