albertorestifo/trenino/docs/mechanical/fusion-controller/inventory-support-free-revision/illustrated-guide/page-9.png

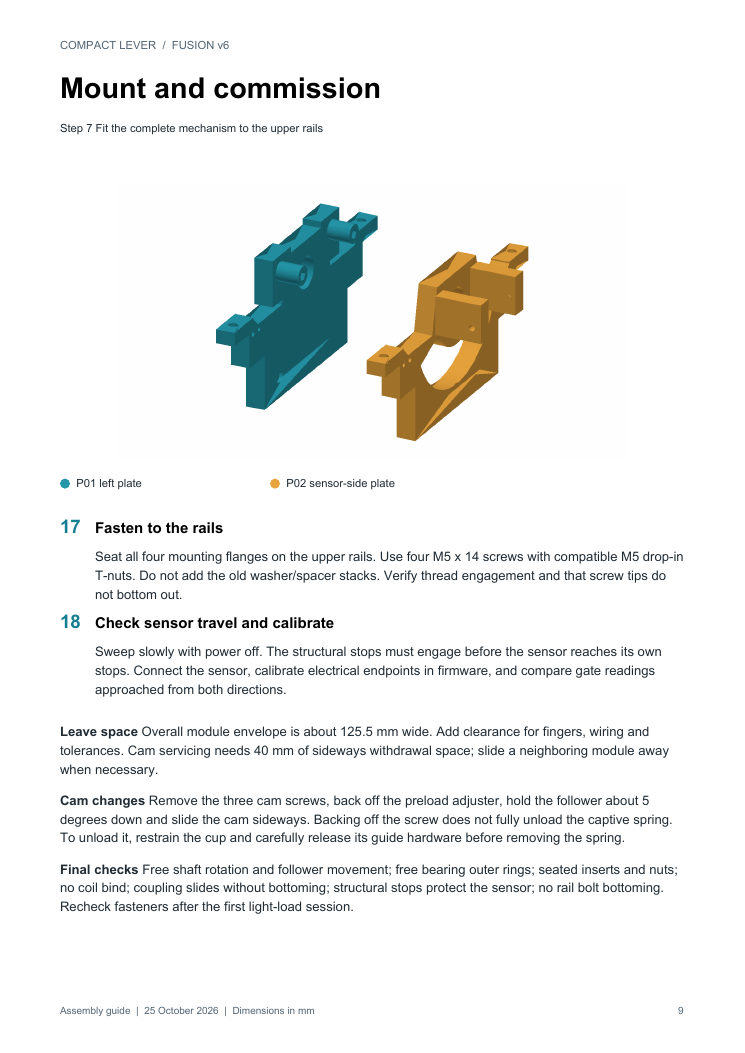
docs/mechanical/fusion-controller/inventory-support-free-revision/illustrated-guide/page-9.png
