albertorestifo/trenino/docs/mechanical/fusion-controller/inventory-support-free-revision/illustrated-guide/plates.png

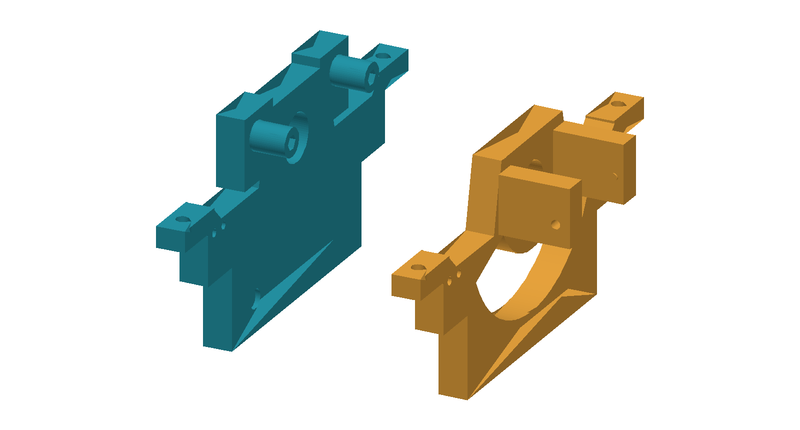
docs/mechanical/fusion-controller/inventory-support-free-revision/illustrated-guide/plates.png
