albertorestifo/trenino/docs/mechanical/fusion-controller/inventory-support-free-revision/illustrated-guide/shaft.png

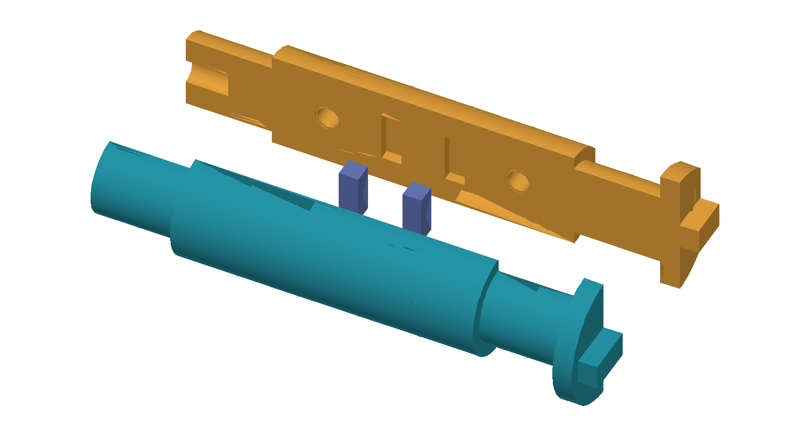
docs/mechanical/fusion-controller/inventory-support-free-revision/illustrated-guide/shaft.png
