albertorestifo/trenino/docs/mechanical/fusion-controller/opposite-sides/guide-preview/final-1.png

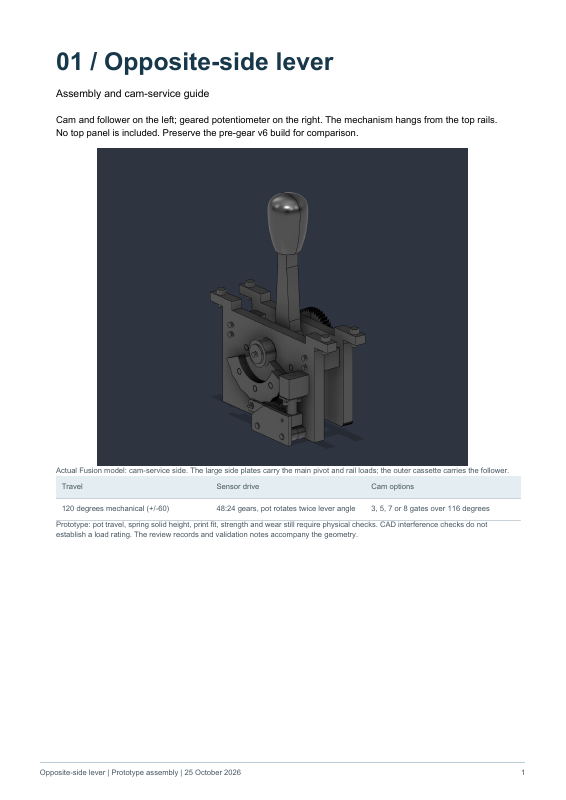
docs/mechanical/fusion-controller/opposite-sides/guide-preview/final-1.png
