albertorestifo/trenino/docs/mechanical/fusion-controller/opposite-sides/guide-preview/final-2.png

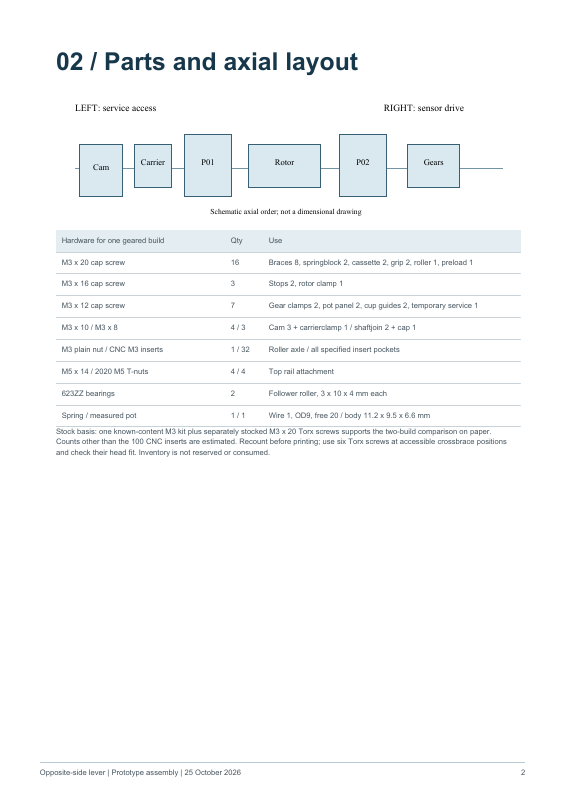
docs/mechanical/fusion-controller/opposite-sides/guide-preview/final-2.png
