albertorestifo/trenino/docs/mechanical/fusion-controller/opposite-sides/guide-preview/final-3.png

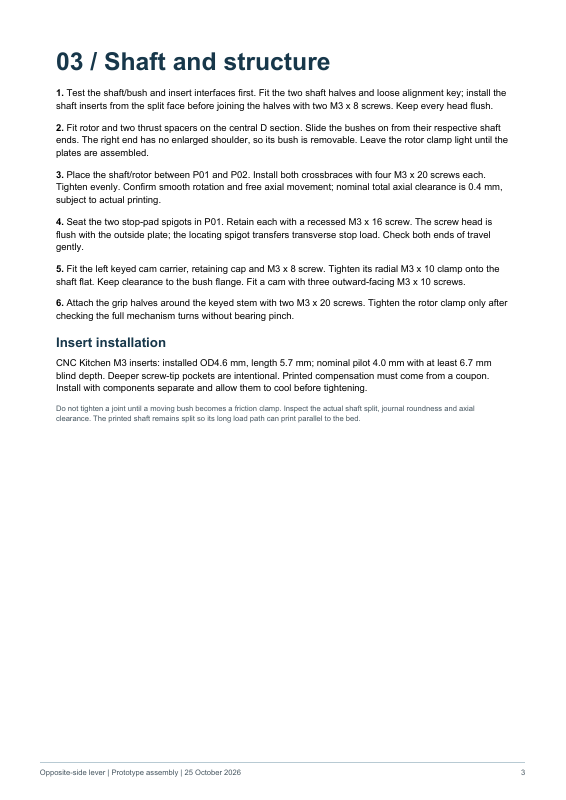
docs/mechanical/fusion-controller/opposite-sides/guide-preview/final-3.png
