albertorestifo/trenino/docs/mechanical/fusion-controller/opposite-sides/guide-preview/final-4.png

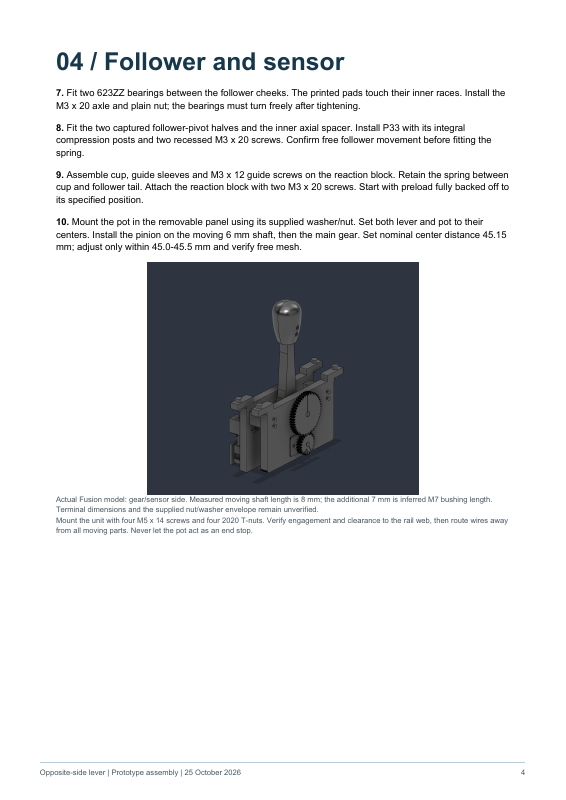
docs/mechanical/fusion-controller/opposite-sides/guide-preview/final-4.png
