albertorestifo/trenino/docs/mechanical/fusion-controller/opposite-sides/guide-preview/final-5.png

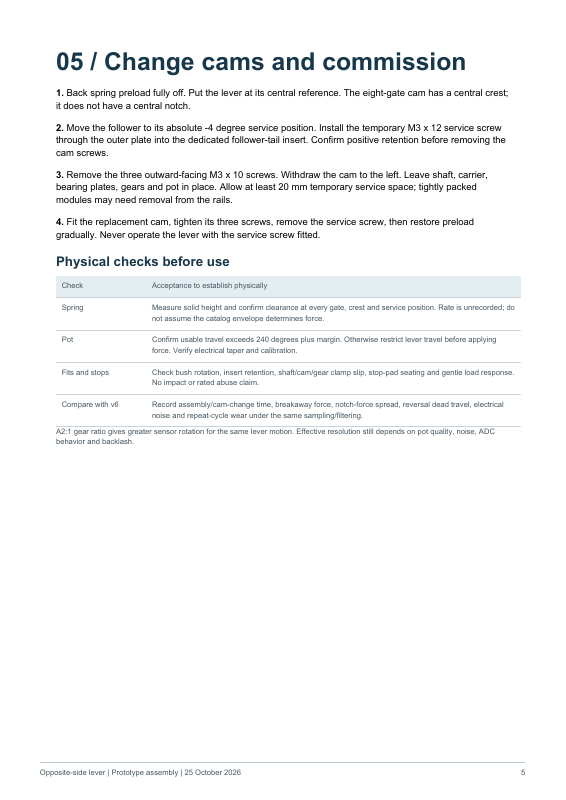
docs/mechanical/fusion-controller/opposite-sides/guide-preview/final-5.png
