albertorestifo/trenino/docs/mechanical/fusion-controller/opposite-sides/guide-preview/final-6.png

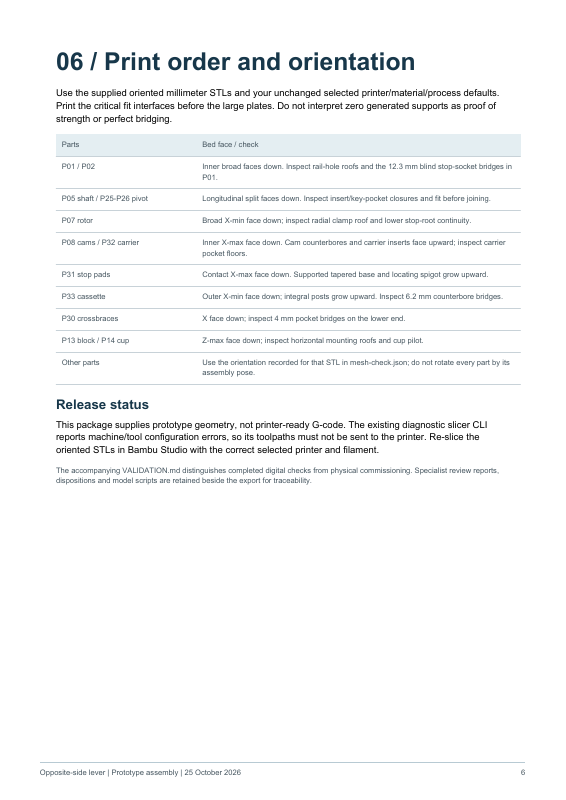
docs/mechanical/fusion-controller/opposite-sides/guide-preview/final-6.png
