albertorestifo/trenino/docs/mechanical/fusion-controller/opposite-sides/guide-preview/final-montage.png

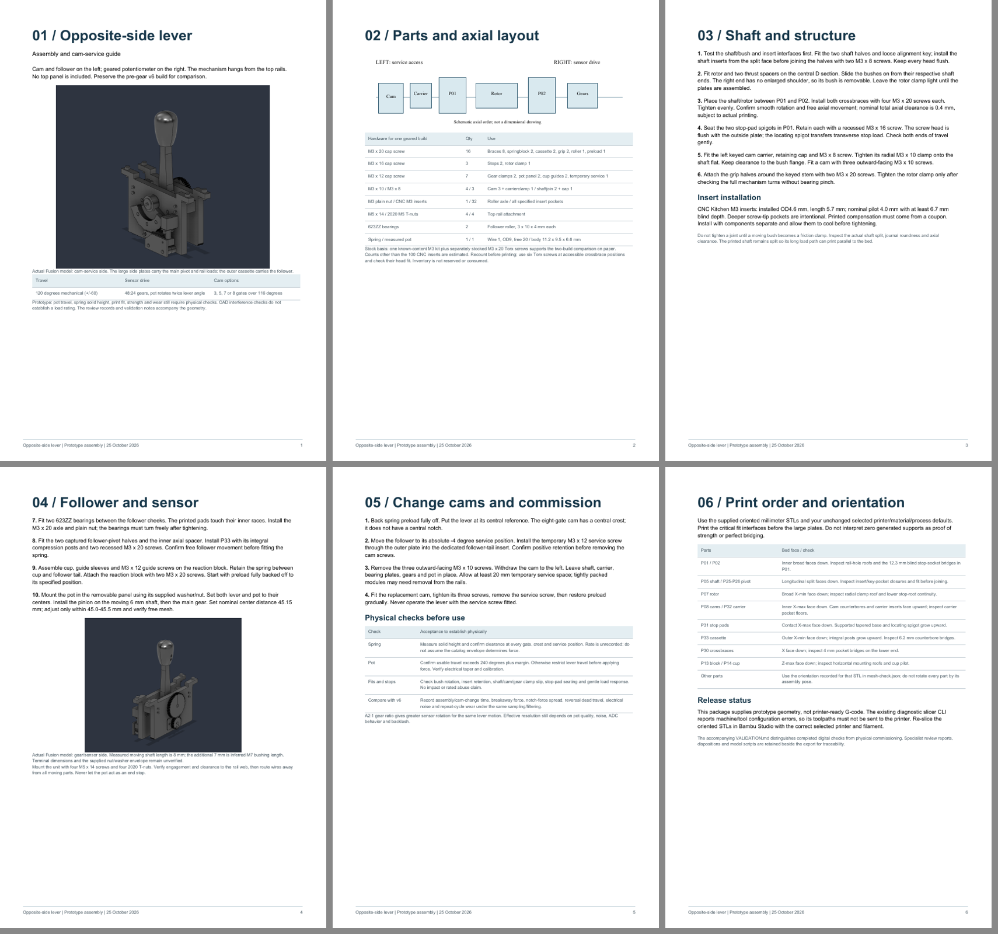
docs/mechanical/fusion-controller/opposite-sides/guide-preview/final-montage.png
