albertorestifo/trenino/docs/mechanical/fusion-controller/opposite-sides/guide-preview/montage.png

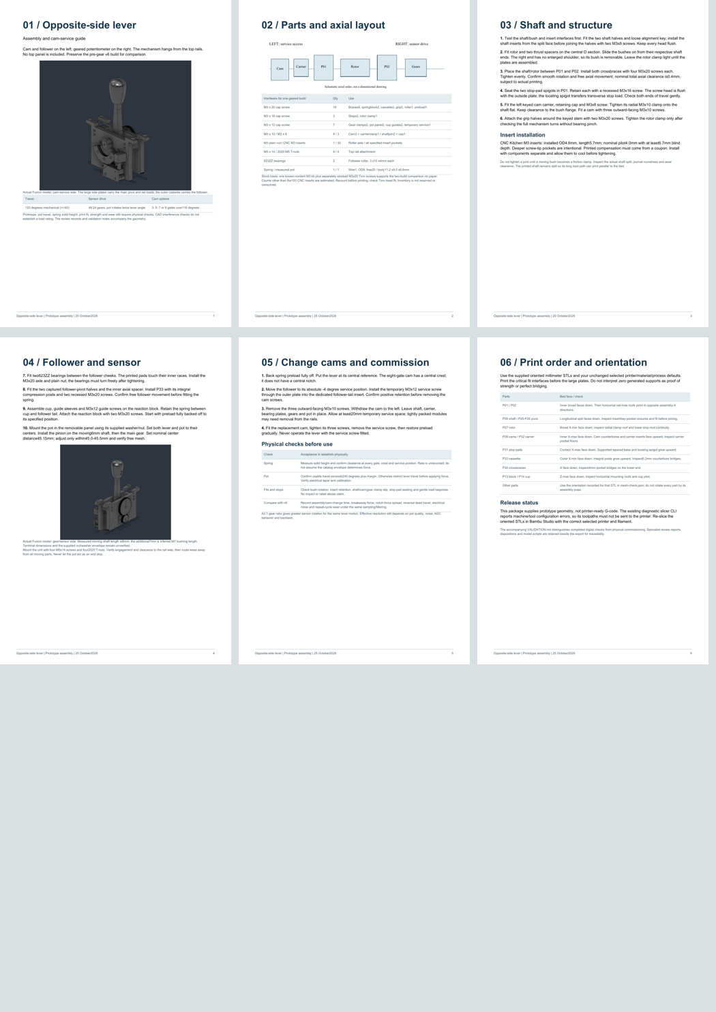
docs/mechanical/fusion-controller/opposite-sides/guide-preview/montage.png
