albertorestifo/trenino/docs/mechanical/fusion-controller/opposite-sides/guide-preview/page-2.png

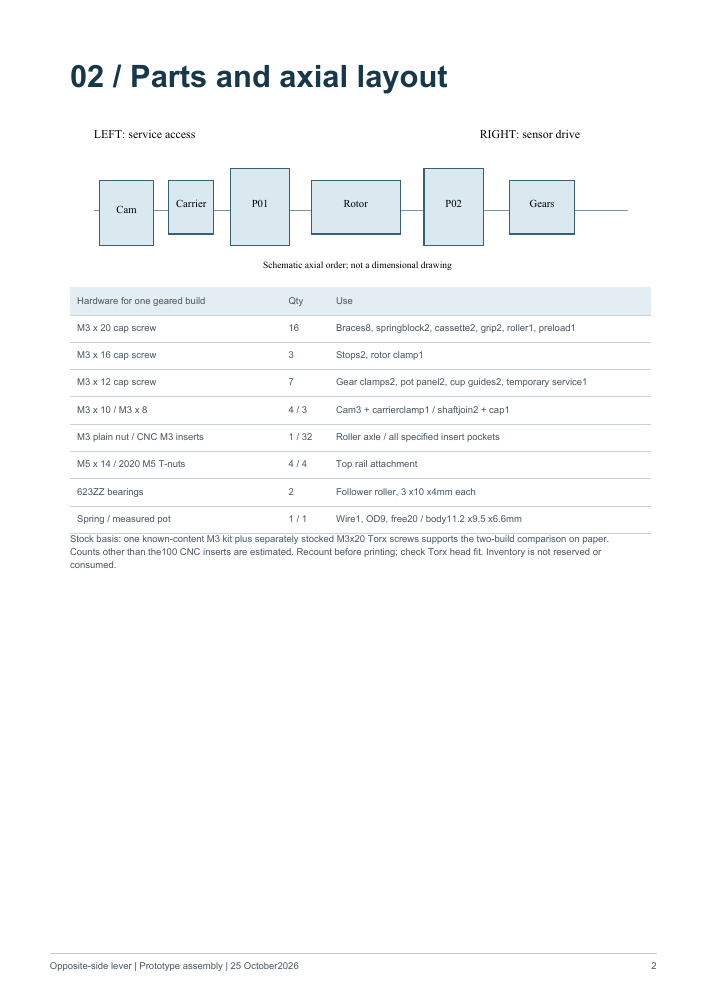
docs/mechanical/fusion-controller/opposite-sides/guide-preview/page-2.png
