albertorestifo/trenino/docs/mechanical/fusion-controller/opposite-sides/guide-preview/page-3.png

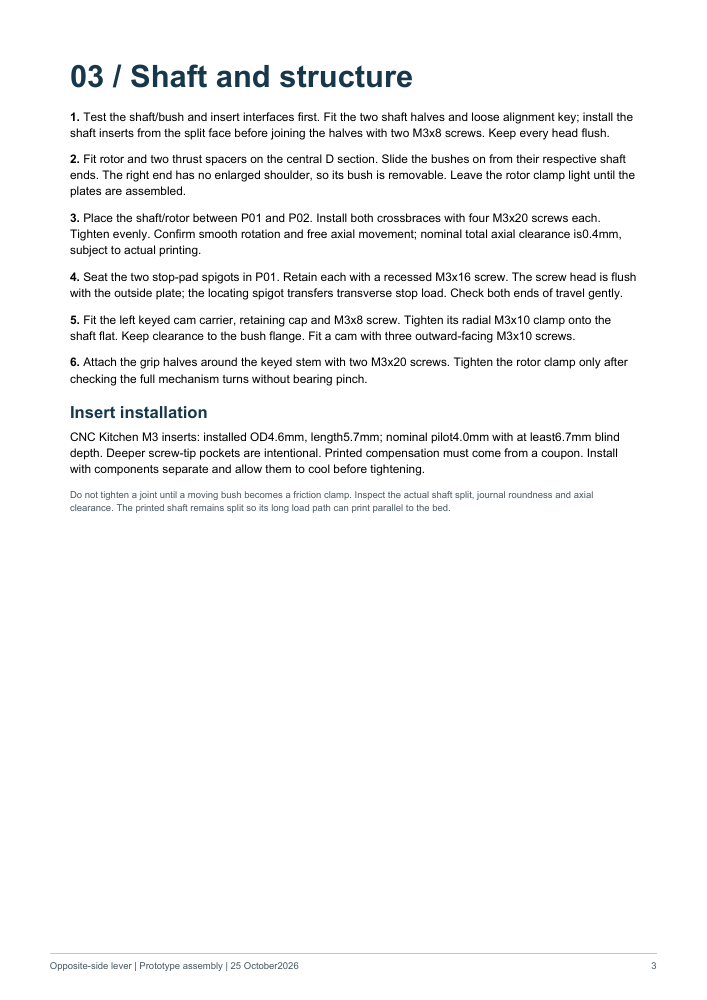
docs/mechanical/fusion-controller/opposite-sides/guide-preview/page-3.png
