albertorestifo/trenino/docs/mechanical/fusion-controller/opposite-sides/guide-preview/page-4.png

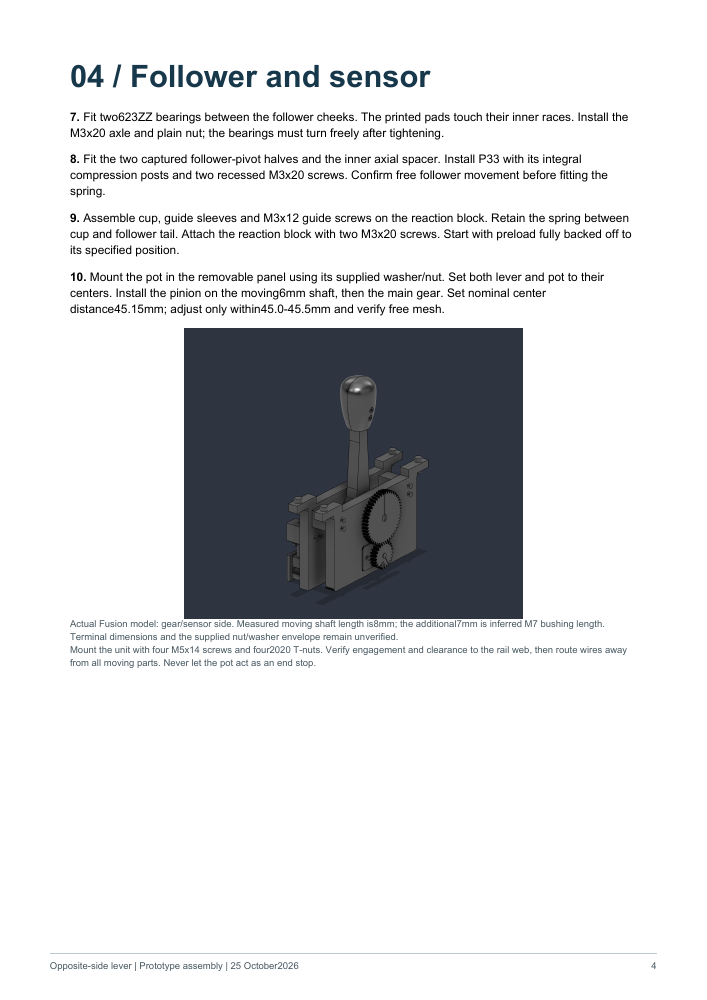
docs/mechanical/fusion-controller/opposite-sides/guide-preview/page-4.png
