albertorestifo/trenino/docs/mechanical/fusion-controller/opposite-sides/guide-preview/page-5.png

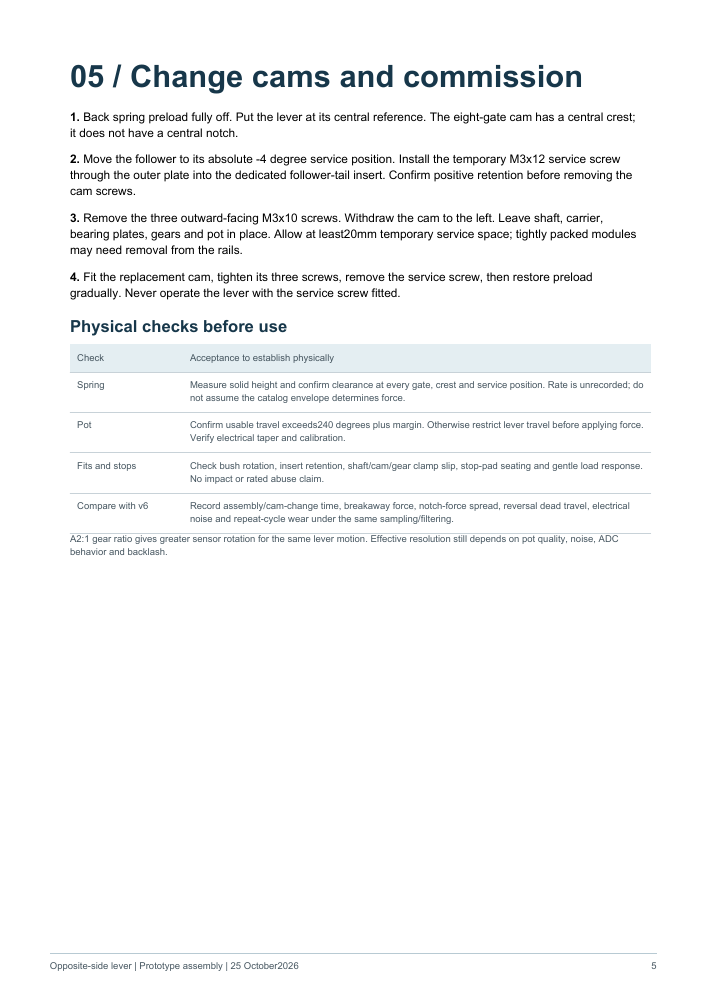
docs/mechanical/fusion-controller/opposite-sides/guide-preview/page-5.png
