albertorestifo/trenino/docs/mechanical/integrated-support-print.png

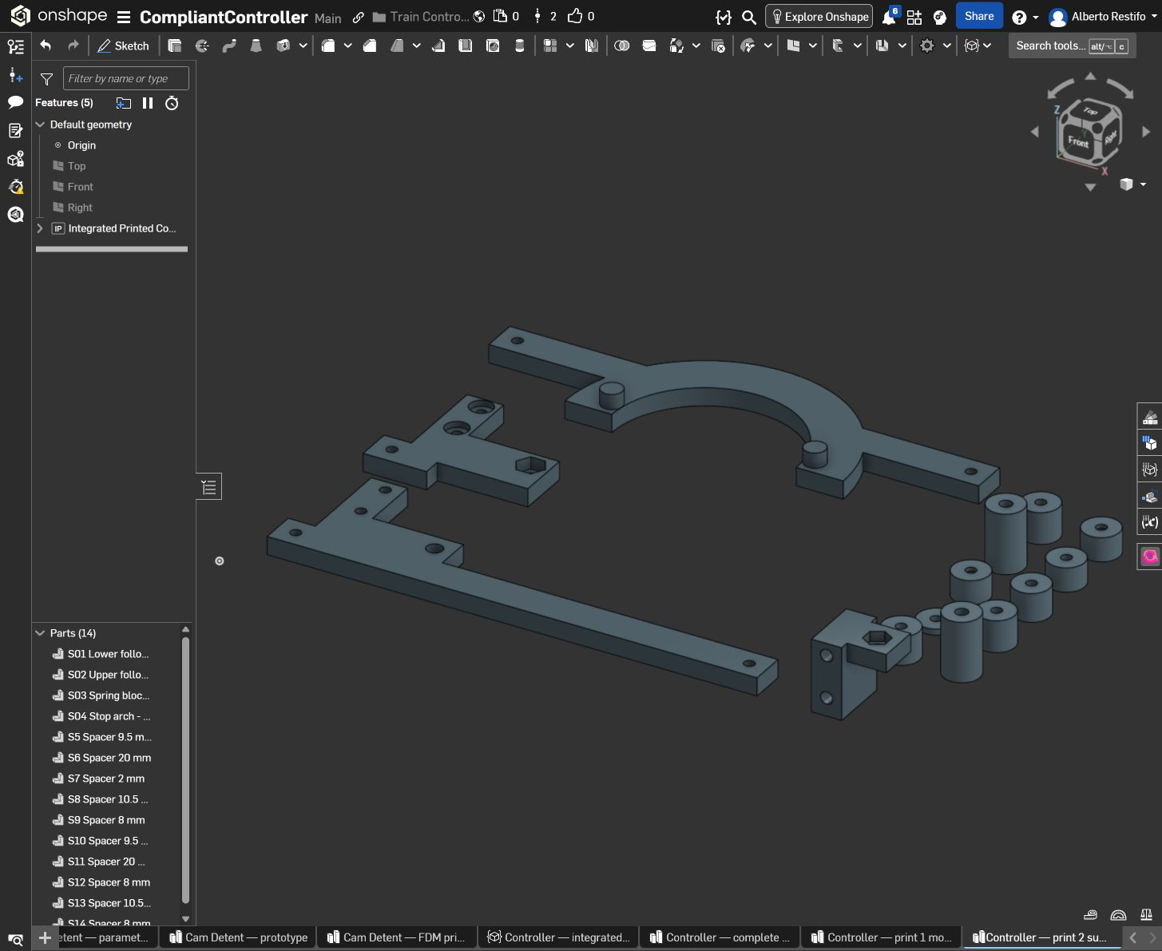
docs/mechanical/integrated-support-print.png
