albertorestifo/trenino/docs/mechanical/insert-cad-validation.txt

CNC Kitchen standard M3 x 5.7 insert revision — 2026-10-24

FeatureScript 3044 preserved. Final source written to existing Feature Studio
49901711a30f64ac872dc409 and read back: exact text match.
Assembly and print layout regenerated using the same source.

Kernel tests completed without notices:
- Neutral assembled model: 12 bodies including reference plates/hardware;
  all-body pair test: no volumetric interference.
- Neutral cam removal: 41 sampled poses, lift 13.5 mm then diagonal withdrawal;
  no interference with other modeled bodies.
- 3, 5 and 7 notch profiles at maximum 1.5 mm follower lift:
  29 sampled poses each, -70 to +70 degrees in 5-degree increments;
  moving cam/hub/fork/roller against bracket/reference plates: zero interference;
  maximum measured cam-to-roller gap: zero at sampled poses.
- Print layout: five bodies, each minimum Z=0, no pair interference;
  overall bounds x10..166, y10..193, z0..80 mm.

Dimensions verified against manufacturer drawing:
https://cnckitchen.store/cdn/shop/files/table_metric.png?v=1775822778&width=1946
M3x5.7: length5.7, OD4.6, hole4.0, minimum wall1.6 mm,
blind depth at least length+1 mm.
Three carrier pockets: effective depth6.7, bottom1.8, boss diameter9 mm.
Radial pocket: effective depth6.7, continued screw clearance to shaft.
Pocket cutting tools overshoot open faces by0.1 mm to ensure clean booleans.
Cam boss clearance0.3 radial and axial; remaining web2.2 mm under head seats.
M3x8 cam screws: nominal5.5 mm insert engagement.

Actual Fine-resolution Onshape3MF exported; all five meshes converted from
metres to millimetres and checked by check_stl.py (fdm-mesh-check.json).
Each is one closed connected consistently wound solid with positive volume.

These checks do not validate full original drivetrain clearance, real printed
fits, physical spring force, insert pull-out, wear, or retention hardware.
