albertorestifo/trenino/docs/mechanical/fusion-controller/gear-comparison/COMPARISON-RESULTS.csv

measurement | unit | A coupling v6 | B gears | notes
First assembly time | min
Repeat assembly time | min
Insert installation time | min
Adjustment time | min
Printed material | g
Print time | h
Installed width | mm
Practical lever spacing | mm
Center reversal lost motion | deg
Low-end reversal lost motion | deg
High-end reversal lost motion | deg
ADC endpoint span | counts
Center hold peak-to-peak noise | counts
Center hold standard deviation | counts
Detent bidirectional repeatability | counts
Cam change time | min
Sensor replacement time | min
Completed endurance cycles | cycles
Post-endurance backlash | deg
Reprinted parts | count
Assembly problems | text
