albertorestifo/trenino/CHANGELOG.md

# Changelog

All notable changes to this project will be documented in this file.

The format is based on [Keep a Changelog](https://keepachangelog.com/en/1.1.0/).

## [Unreleased]

### Fixed

- A lever resting between two mapped notches now sends the nearest notch instead
  of nothing. Captured notch ranges rarely touch, so a lever moved from Brake and
  settling just outside a narrow Off detent left the simulator on the last brake
  value. A linear notch reached from a gap sends its nearest end. The mapping
  wizard's live preview shows the same notch.
- A lever write that still fails after every retry is now logged.
- The sensitivity of an analog input can now be changed after it is added: the inputs
  table on the configuration page has a Sensitivity field for each analog input. Apply
  the configuration afterwards to send the new value to the controller.
- Changing the hardware input of a lever or button now takes effect in the simulator
  right away. Before, an input added or calibrated after its device connected was
  ignored until the app restarted.

## [0.9.0] - 2026-11-09

### Changed

- Row actions look the same in every table. The button that opens an item's settings
  is labelled "Edit" everywhere (it said "Configure" on elements and output bindings),
  and lever rows show it inline instead of hiding it in the "..." menu, which now holds
  only "Design notch disk". Action buttons line up down each column, output binding
  rows stay on one line, the gauge status sits under the gauge's name, and "Add gauge"
  sits top right like the other sections' add buttons.
- Gauges (beta) follow controller firmware 3.3.0, which replaced its motor-shield
  stepper axes with X27 gauge modules. A gauge is now an X27 driven by a VID6606
  chip channel (STEP/DIR, plus the chip's shared RESET_N) or straight from four AVR
  board pins, up to four per controller, and is part of the configuration sent with
  Apply. The guided setup, shield address, manual-control lease and homing are gone:
  the controller zeros every gauge itself at startup and on every Apply. Add a gauge
  with its pins (the train-lever gauge board's channels are one click away), then
  calibrate its dial in a new panel that moves the needle while you note what the dial
  shows. A stale simulator value holds the needle. Needs firmware 3.3.0 or newer.
- Gauge MCP tools: `list_gauges`, `create_gauge`, `update_gauge`, `delete_gauge`,
  `apply_device_configuration`, `move_gauge` and `zero_gauge` replace the stepper axis
  tools. Dial and binding tools take `gauge_id` instead of `stepper_axis_id`.
- Levers are smoother: the lever position and the value sent for linear notches now
  keep 4 decimals instead of 2. Before, a lever had at most 101 positions, so a brake
  notch spread over a tenth of the travel moved the simulator in about 10 steps. Lower
  the input's Sensitivity to 1 or 2 to get every step the ADC reads. Notch boundaries
  and gate values are unchanged.

- Lever calibration finds notches the way drivers feel them, tested on
  trains from the UK, Germany, Austria and the US. The ends of a brake or
  power range ("Max Brake", "Min Power") are part of the range instead of
  separate notches, power steps inside one simulator notch become separate
  notches, gates such as Emergency are always reached, and notches are named
  as in the game ("Emergency", "Brake", "N3"). Calibration warns when part of
  the lever was blocked (for example power while the reverser is in neutral)
  or a position springs back. It always puts the lever back where it was,
  and keeps your notch mapping when the notches did not change. The sweep
  applies power and will move the train; the wizard and the
  `calibrate_lever` MCP tool warn about this before it starts. This lets
  levers that release the brake as they sweep, such as a combined
  power/brake handle with no separate brake, be calibrated.
- The Lever Setup Wizard's "Detect Notches" step no longer moves the lever
  as soon as you open it. Press "Start Detection" (or "Detect Again" for a
  lever that is already calibrated) when you are ready; a failed run offers
  "Try Again".
- The wizard's "Map Positions" step shows your progress (the simulator
  notches and your lever) on the left and the notch you are capturing, with
  its live readings and buttons, on the right, so everything fits without
  scrolling.
- The Windows virtual joystick is now a beta feature. The Joystick tab stays
  in the navigation; while beta features are off, it explains that the
  joystick is less tested and errors are expected, and offers an "Enable
  beta features" button. The virtual joystick MCP tools are hidden until
  beta features are on. Saved mappings, and a joystick that is already
  active, keep working.
- Gauges, such as speedometers, are now a beta feature. Turn
  on "Enable beta features" on the Settings page to see the Gauges and Gauge
  bindings sections and the gauge MCP tools. Gauges already set up keep
  working while beta features are off.

### Removed

- Gauges set up for firmware 3.1.0 to 3.2.1 (motor-shield stepper axes), their dial
  calibrations and the train gauge bindings that used them. They cannot run on firmware
  3.3.0; set the gauges up again.

### Added

- Beta features: features that are still being tested are off by default
  and can be turned on with "Enable beta features" on the Settings page.
  Selectors, gauges and the Windows virtual joystick are beta features.
- Selectors (beta, turn on "Enable beta features" in Settings): use a
  potentiometer as a rotary switch with fixed positions, such as a lights
  selector. Split its travel evenly into 2 to 12 positions,
  or turn the knob into each detent and capture it. The gaps between
  positions are dead zones, so jitter never switches it. Each position runs
  its own action when the knob enters it and when it leaves: set a simulator
  value, run a sequence, or tap a key. Selectors are set up from the train
  page without the simulator running. When a train loads or the simulator
  reconnects, the current position's action runs again so the game matches
  the knob. The elements table shows each selector's position. Selectors are
  also available through new MCP tools (`get_selector`,
  `configure_selector`, `set_selector_even_split`, `delete_selector`), and
  `list_device_inputs` now reports whether an input is calibrated.
- Lever setup can be done by an AI assistant, and blends with the wizard.
  New MCP tools (`list_simulator_levers`, `get_lever`, `set_lever_endpoint`,
  `calibrate_lever`, `bind_lever_input`, `open_lever_setup`) let an
  assistant find the simulator lever by its in-game role, calibrate it, bind
  your hardware input, and then open the Lever Setup Wizard at the step that
  needs you: mapping the physical notches. The wizard's "Find in Simulator"
  step suggests matching levers on its own and has an "Ask AI" button that
  copies a ready-made prompt.
- Design a notch disk for a calibrated lever: "Design notch disk" in the
  lever's "..." menu on the train page (and "Design a notch disk" on the
  wizard's "Detect Notches" step) opens the train-lever notch disk generator with
  the lever's notches filled in, ready to download the STL. Each gate
  becomes a click, Emergency and centre positions (Off, Idle, Coast, the
  zero notch) hold harder, and brake or power ranges become ranges with a
  wall at each end: the lever rests anywhere in the range and has to be
  pushed over a wall to leave it, with a higher wall before Emergency. Every
  notch lands where it sits on the simulator lever, so a centred Off is the
  centre of the disk. The MCP `get_lever` tool
  returns the same link as `notch_disk_url`.
- A quiet footer at the bottom of every page links to the Trenino Discord
  community, for questions, ideas and sharing setups.

### Fixed

- Devices connect within a few seconds of being plugged in. Before, Trenino
  only looked for new devices once a minute, and a port that failed to
  connect also waited about a minute for its next try. Failed ports are now
  retried after 5 seconds, then less often after each further failure, up
  to once a minute.
- Devices with levers or other analog inputs now connect reliably. Before,
  a board could sometimes show "No Trenino firmware detected" even though
  its firmware was fine: input readings it sent while connecting were
  mistaken for failed replies, and Trenino gave up before reading the
  device's answer.
- With several devices connected, the Apply configuration dialog now shows
  what each device is running: this configuration, another one by name, an
  unknown one, or none.
- A configuration with only outputs can now be applied to a device, so its
  outputs can be tested from the configuration page. Before, Apply stayed
  unavailable until an input was added. Requires firmware 3.1 or newer.
- Applying a configuration no longer affects other open configuration
  pages. Before, a page could switch to the configuration just applied
  elsewhere, or show its error.
- Editing or deleting a sequence now takes effect on button bindings right
  away. Before, buttons kept running the old commands until the train was
  reloaded.
- Reconnecting a device no longer makes levers and buttons receive each
  reading more than once. Every reconnect used to add another subscription to
  the device's input values.
- Output LEDs now light reliably after a train loads. If subscribing to the
  simulator failed once, for example while the train was still loading, the
  output stayed dark for the whole session. Trenino now keeps retrying,
  subscribes again after the simulator restarts or reconnects, and switches
  outputs off while the simulator is disconnected.
- A sequence on a momentary button now runs to the end on a quick tap. Before,
  releasing the button stopped the sequence part-way, so a door-close sequence
  could leave a control held and need a second press. Pressing again while
  the sequence is still running is ignored.
- Gauges no longer read their hardware from the database on every
  simulator sample while the needle is still, which filled the debug log.
- Error reporting now works in released builds. Before, no error report ever
  reached us, even with error reporting turned on: the reporting address was
  missing from every desktop build. Reports still go out only if you opted in.
  Errors from the local API and MCP server are now reported too, failed
  firmware uploads send one report instead of up to four, and upload timeouts
  are reported. Everyday problems you can fix yourself, such as an unplugged
  cable, a serial port from another device, Train Sim World not running or
  being offline, are no longer reported as errors.

### Security

- Updated the Ecto database library to 3.14.3 for EEF-CVE-2026-118391.

## [0.8.3] - 2026-11-04

### Added

- Stepper-driven gauges. Configure stepper axes on a board, bind them to
  train telemetry such as speed or brake pressure, and set each one up with a
  guided wizard that homes the needle and calibrates the dial. Gauges are also
  available through new MCP tools.
- AI assistants can discover and install Trenino's MCP server on their own.
  The app serves `/llms.txt` with an install command for each client, an MCP
  server card and an AI catalog, and accepts Streamable HTTP at `POST /mcp`
  alongside SSE. The setup guide now covers Claude Desktop, Codex, Gemini CLI,
  VS Code and Cursor.
- The lever setup wizard shows which way your lever moves compared to the
  simulator, with a "Your lever" strip and a **Reversed vs. simulator** badge.
  Levers whose direction can't be detected let you pick it by hand.
- Display bindings support optional speed unit conversion (`m/s → km/h` or
  `m/s → mph`) applied before formatting — also available as `unit` in the
  `create_display_binding`/`update_display_binding` MCP tools.
- I2C display modules gain an **orientation** setting (`Normal`,
  `Rotated 180°`, `Flipped horizontal`, `Flipped vertical`) for displays
  mounted upside down or mirrored. Applied in software during segment
  encoding, so it works for display bindings, Lua `display.set`, and the
  display test — no firmware update needed. Also exposed as `orientation` in
  the `create_i2c_module`/`update_i2c_module`/`list_i2c_modules` MCP tools.

### Changed

- The hardware configuration and train pages share one section layout. Each
  page scrolls as one, with sections grouped under headings (Inputs and
  Outputs on the hardware page; Controls, Displays & lights and Automation on
  the train page) and a sticky row of links to jump between sections. Every
  section has the same header with a count and one **Add ...** button, the
  same compact empty state, and the same row actions: labelled buttons such as
  **Edit**, **Test** or **Calibrate**, a "..." menu when a row has three or
  more, and a trash button that always asks before deleting (inputs, matrices,
  outputs, elements and output bindings used to delete without asking). A
  disabled add button now says why. Renames: **Stepper axes** is now
  **Gauges**; the train page's gauge section is **Gauge bindings** with
  **Add gauge binding**; **New Sequence** is **Add sequence**; Sequences is no
  longer a collapsible panel. A sequence's **Test** is disabled while the
  simulator is offline.
- Stepper axes are much simpler. Adding a gauge asks only for a name and a
  shield port, then goes straight into the guided gauge setup. Each card shows
  one status (Needs setup, Ready, Moving, Zeroing, Needs re-zero, Paused,
  Fault, Offline) and at most one action. A new **Re-zero** action hands a set-up
  gauge back to the train after a reconnect, stop or fault, homing it if it has
  an end stop. Manual controls moved to **Diagnostics** in the card menu, and
  the shield address is a single line with a guided **Change** panel. The
  stepper presets and the separate dial calibration panel are gone: the guided
  setup covers both.
- New Trenino identity (brand guide v1.1): a throttle-lever logo with an
  Inter Bold wordmark, a new app icon, favicon and splash screen, and a
  refreshed theme with one indigo action color and labelled statuses
  (Connected, Connecting, Needs attention, Failed).
- The simulator banner is gone. The status button in the nav now covers
  devices and Train Sim World together, and its dropdown shows the
  simulator first with the next step and Retry or Open Settings. Only the
  Trains pages show a small notice while the simulator is not connected.
- Devices in the nav dropdown are named after the configuration they run,
  with the port second.
- Settings is now a nav tab next to Devices, Trains and Joystick.
- The Windows installer no longer installs the vJoy driver. Joystick mode is
  optional, so it now asks you to install vJoy 2.2.2.0 yourself and links to
  the release when the driver is missing. The installer is smaller and never
  changes system drivers. If an earlier Trenino installed vJoy for you, it
  stays installed; remove it from Windows Settings if you no longer need it.

### Removed

- I2C input chips (MCP23017 and ADS1115), which were never released. Connect
  more boards for extra buttons and axes instead. Firmware 3.2.1 drops them
  too.

### Security

- The MCP endpoint and the web UI only accept requests from this computer
  (local Host and Origin), and cross-origin requests are no longer allowed.
- Updated Bandit to fix an HTTP/2 memory amplification advisory.
- Updated phoenix_html to 4.4.0 to fix an attribute injection advisory
  (CVE-2026-117645).

### Fixed

- Levers mapped with narrow gate notches can now reach those notches, and
  reversed levers interpolate their linear ranges in the right direction.
- 14-segment display glyphs for `0` and `7` no longer light the middle
  vertical segments.
- MCP `create_i2c_module`/`update_i2c_module` silently dropped `brightness`
  and `num_digits` (passed as top-level attrs instead of nested chip params);
  they are now persisted, and chip params survive partial updates.
- Saving a train with changed identifiers re-detects the active train right
  away. Previously, adding an identifier that matched the loaded train left it
  inactive until the cab changed.
- Notched levers no longer bounce against the simulator while held on a notch.
  A value the simulator already received is not sent again, so input jitter
  cannot keep pulling the handle off the position it snapped to.
- Connected stepper boards no longer keep the app busy while idle. The
  once-a-second status poll used to query the database and refresh the
  configuration page even when nothing had changed; it now does so only when
  the motor's status actually changes.
- Firmware uploads to Pro Micro, Leonardo and Micro boards on macOS and Linux
  no longer hang with no output. The upload now waits for the board to reset
  into its bootloader instead of starting avrdude while the old firmware was
  still running.
- Cancelling a firmware upload, or one timing out, now stops avrdude. It used
  to keep running in the background and hold the serial port.
- **View Release** and the firmware release-notes links open in the system
  browser in the desktop app. They used to do nothing when clicked.

## [0.8.2] - 2026-10-28

### Fixed

- Lever setup wizard no longer deadlocks on the Map Positions step: the notch
  mapping session is now stopped when the wizard closes (after a successful
  save or finish), leftover sessions from previous attempts are cleared and
  retried on re-entry, and session lookups ignore dead processes so
  stop-then-restart cannot observe a stale registration. Previously, any
  completed mapping left an orphaned session that made the next configuration
  attempt fail with "Failed to start mapping" and an endless loading spinner.

## [0.8.1] - 2026-10-28

### Fixed

- Windows desktop startup honors `APPDATA`/`LOCALAPPDATA` environment overrides
  when choosing the backend extraction cache, restoring the launcher-script
  workaround for profiles with non-ASCII (e.g. Cyrillic) user directories;
  Tauri's cache path always resolves the real profile folder, which the
  bundled backend cannot boot from.

## [0.8.0] - 2026-10-25

### Added

- **Train Sim World 7 support** — automatically detect `CommAPIKey.txt` from the
  `TrainSimWorld7` user directory while retaining Train Sim World 6 fallback
- **Multiple identifiers per train profile** — configure equivalent ObjectClass prefixes such as `RVM_FSN_DB_BR423` and `RVM_OTHER_DB_BR423` once, with global exact-identifier ownership and explicit ambiguity handling for overlapping prefixes
- **Windows virtual joystick mode** — map calibrated analog inputs and digital
  controls to one removable DirectInput vJoy device with eight conventional axes
  and 32 buttons; includes standalone mappings, explicit destination replacement,
  live preview, recovery actions, MCP tools, and ownership-safe signed-driver
  packaging
- **I2C display module support** — attach HT16K33 LED display drivers to Arduino devices via I2C; each module is configured with a chip address, brightness (0–15), digit count (4 or 8), display type (7-segment or 14-segment), and optional decimal-point and right-alignment settings
- **Display bindings** — bind simulator endpoint values to I2C display modules on a per-train basis; format numbers with `{value}` (raw) or `{value:.Nf}` (N decimal places, e.g. `{value:.0f}` for integers); bindings activate automatically when a matching train is loaded and blank the display on deactivation
- **`display.set(i2c_address, text)` in Lua scripting** — write arbitrary text directly to an I2C display from a script
- 8 new MCP tools: `list_i2c_modules`, `create_i2c_module`, `update_i2c_module`, `delete_i2c_module`, `list_display_bindings`, `create_display_binding`, `update_display_binding`, `delete_display_binding`

### Changed

- Setup pages now show actionable connection prerequisites, compact joystick mappings, accessible display dialogs, wider train identifiers, and navigation that remains available in narrow windows.
- Display binding setup starts with the physical display and offers decimal-place controls before custom formatting.
- Settings now saves and tests the simulator connection with inline results and platform-specific API-key instructions.
- Updated advisory-affected Hex dependencies to compatible releases.
- Updated the Tauri stack, Req, Sentry and Burrito; aligned local/CI Zig to 0.16.0 and migrated Req pool timeout configuration. Windows desktop builds now require Windows 10 or 11.
- **Breaking HTTP and MCP train contract** — train payloads now expose a sorted `identifiers` array and no longer include the singular `identifier` field

### Fixed

- Desktop startup keeps the backend running after database migrations finish.
- Windows installer vJoy checks use native 64-bit PowerShell to avoid false incompatibility warnings.
- Virtual joystick probes capture PowerShell output and pass paths correctly instead of reporting an installed driver as missing.
- Updated desktop backends use a fresh extraction cache even when the application version is unchanged.
- Lever writes recover after failed tasks and pause after connection failures instead of retrying continuously.
- Display settings retain edits during validation, including unchecked options.
- Display-only hardware configurations can deploy without dummy inputs.
- Display reconnection replays unchanged values; unsuccessful writes are no longer cached as delivered.
- Invalid display precision is rejected before saving and cannot crash the preview.
- MCP button-binding destination conflicts return a recoverable message.
- Application and installer metadata consistently identify the upcoming release as 0.8.0.
- Smooth lever movement no longer queues every jitter sample to Train Sim World. While a write is in flight, Trenino keeps only the latest value for that lever, so a slow simulator response cannot build up seconds of cab lag

## [0.7.4] - 2026-05-09

### Fixed

- **Windows firmware flashing: avrdude now found correctly** — `APP_PATH` is passed from the Tauri wrapper to the Elixir backend at startup, allowing the bundled avrdude to be located in the installation directory (root cause of all boards failing to flash on Windows, [#76](https://github.com/albertorestifo/trenino/issues/76))
- **Windows firmware flashing: removed fragile `-U` path workaround** — avrdude 8.x handles Windows drive-letter paths natively; the relative-path transformation that broke on cross-drive setups has been removed
- Serial connection: device discovery now runs in a background Task so the Connection GenServer stays responsive during the DTR settle delay and identity handshake
- Firmware upload: cancelled or timed-out uploads now correctly kill the avrdude process; previously, cancelling left avrdude running and released the serial port prematurely
- Protocol: replaced O(n²) binary concatenation in COBS encoding with an O(n) list accumulator
- Intermittent Connection GenServer test failures resolved (stale port state between tests)

## [0.7.3] - 2026-05-03

### Added

- Linux x86_64 AppImage installer in nightly builds and releases
- Better Stack error tracking via Sentry SDK, activated when `SENTRY_DSN` env var is set
- **Firmware version compatibility checks** — incompatible releases are now badged in the firmware page and the install/upload buttons are disabled with a clear explanation
- **Error reporting consent screen** — first-run screen at `/consent` lets users opt in or out of error reporting before using the app; redirects automatically until a preference is set
- **Settings page** with error reporting toggle and simulator connection configuration; accessible via the gear icon in the navigation bar
- Firmware devices with unsupported upload protocols in the manifest are now rejected at download time with a clear error (closes [#76](https://github.com/albertorestifo/trenino/issues/76))

### Changed

- Navigation bar: Simulator link replaced with a Settings gear icon
- Simulator URL and API key are now configured via the Settings page instead of environment-level config

### Fixed

- Windows firmware flashing: replaced fixed bootloader wait with a 5-second polling loop for COM port redetection, fixing timeouts on slower machines
- Firmware upload failures are now captured in Sentry with the full avrdude output for easier debugging
- Double URL-encoding of the port name in firmware install links
- Startup log demoted from `error` to `info` when no firmware manifest is available yet
- Nightly build pipeline
- Windows NSIS installer now bundles the Visual C++ Redistributable, eliminating "missing runtime" errors on fresh Windows installations
- Burrito Linux builds now download precompiled ERTS from Beam Machine, reducing CI build times and workarounds

### Removed

- All BLDC (brushless motor) functionality — the experimental code has been removed from the codebase

## [0.7.2] - 2026-03-09

### Added

- MCP tools for Lua script CRUD operations (create, read, update, delete scripts via AI)

### Changed

- Removed `detect_simulator_endpoint` MCP tool (redundant with existing detection tools)
- Clarified simulator API path format in MCP tool descriptions

### Fixed

- Fix LiveView crash when serial Connection GenServer is blocked by UART timeouts
- NavHook no longer blocks on mount; device/simulator state loads asynchronously via PubSub
- `list_devices` and `connected_devices` return empty list instead of crashing on GenServer timeout
- Fix commands parameter arriving as JSON string in sequence MCP tools
- Reload controller bindings after MCP tool updates to output bindings or button bindings
- Remove noisy `node-invalid` debug log from OutputController

## [0.7.1] - 2026-03-06

### Changed

- Info flash notifications auto-dismiss after 5 seconds
- Input selection list now shows lever name as primary text for easier identification

### Fixed

- Fix crash when opening the "Add Input" modal due to missing `bldc_enabled` assign
- Add missing `checking` attr declaration on `empty_releases` component in firmware page

## [0.7.0] - 2026-03-06

### Added

- **Lua scripting system for train automation**
  - New Script schema and database migration for storing Lua scripts per train
  - ScriptEngine providing sandboxed Lua execution environment with Trenino API
  - ScriptRunner GenServer for executing scripts with configurable triggers (manual, on_train_active, on_input_change)
  - Dedicated script editor LiveView page with syntax highlighting
  - Scripts section added to train edit page for managing train-specific automation
  - REST API endpoints for script management (`/api/scripts`)
  - Claude Skill for AI-assisted Lua script authoring (`.claude/skills/lua-scripting.md`)
- **Native MCP server for AI-powered train configuration**
  - Built-in MCP server at `/mcp/sse` for integration with Claude Desktop and Claude Code
  - 22 tools organized across 7 categories: Simulator, Trains, Elements, Devices, Detection, Output Bindings, Button Bindings, and Sequences
  - Element tools for managing train buttons and levers directly from AI conversation
  - **Interactive detection tools** — Claude can now prompt you to press a button or move a lever on your hardware, or interact with a control in Train Sim World, and automatically detect the input/endpoint via a UI modal overlay
  - MCP setup documentation (`docs/mcp-setup.md`) with configuration examples
  - See [MCP Setup Guide](docs/mcp-setup.md) for details
- **BLDC haptic lever UI hidden behind `enable_bldc_levers` feature flag** — the feature remains under development and is excluded from stable releases; enable with `config :trenino, enable_bldc_levers: true` in `config/dev.exs`
- **Resilient train detection with two-layer defense**
  - Primary detection using ObjectClass from CurrentDrivableActor
  - Fallback to ProviderName for trains with mismatched manifests
  - Improved reliability for detecting freight trains and custom train configurations
- **Arduino Nano new bootloader support** (nanoatmega328new)
  - Additional firmware variant for Arduino Nano boards with newer bootloader
  - Automatic device type detection from firmware filenames

### Changed

- REST API expanded with new endpoints for outputs (`/api/outputs`), scripts (`/api/scripts`), and trains (`/api/trains`)
- Script execution integrated with hardware input monitoring and train activation events
- MCP tool registry architecture supports dynamic tool registration and categorization

### Fixed

- Serial connection GenServer crashing when Bluetooth or unresponsive devices cause `:port_timed_out` exits during port open or device discovery, taking down all device tracking ([#46](https://github.com/albertorestifo/trenino/issues/46))
- Firmware flashing via avrdude is now more robust with automatic retry on transient failures
- Flaky CI tests for firmware uploader and upload history ordering
- Train detection failing for freight trains where locomotive and wagons have different class prefixes
- Notch validation incorrectly rejecting negative `sim_input` values (some levers like ThrottleAndBrake use -1.0 to 1.0 range)
- LeverAnalyzer using hardcoded 0.0-1.0 input range instead of reading actual lever range from simulator
- Simulator API requests failing for control paths with special characters (parentheses, spaces)
- Serial discovery settle delay increased to 3 seconds for Arduino Mega compatibility (stock stk500v2 bootloader resets the board via DTR toggle on port open and may take up to 3 seconds before accepting commands)

### Removed

## [0.6.1] - 2026-01-31

### Fixed

- Device type dropdown showing empty when firmware manifest download fails - now properly falls back to hardcoded device list

## [0.6.0] - 2026-01-31

### Added

- **Dynamic device registry from firmware manifests**
  - Device list now loaded from release.json manifest in firmware releases
  - New DeviceRegistry GenServer maintains ETS cache for fast device lookups
  - Firmware releases can include manifest_json field with device definitions
  - Automatic fallback to hardcoded devices if no manifest available
  - Device configurations merge dynamic manifest data with static hardware parameters

### Changed

- **Firmware release management improvements**
  - Firmware releases now support manifest_json field for device metadata
  - FirmwareFile schema adds environment field for PlatformIO environment names
  - Device detection from firmware filenames now uses registry lookup
  - Downloader automatically loads device registry when manifest is present

### Fixed

### Removed

## [0.5.0] - 2026-01-09

### Added

- **LED output bindings** - Bind hardware LEDs to simulator state
  - Create output bindings that control LEDs based on API values
  - Boolean operators: equals, not equals, greater than, less than, and/or combinations
  - LED automatically updates when simulator value changes
- **Editable names for hardware elements**
  - Name field when creating inputs, outputs, and matrices
  - Inline name editing directly in the configuration tables
  - Names are used in train configuration selectors for easier identification
- **Button sequence triggering**
  - New "Trigger Sequence" option in button configuration
  - Configure different sequences for button press (ON) and release (OFF)
  - Works with both momentary and latching button types
- **Button ON/OFF value auto-detection**
  - Automatically captures OFF value (resting state) and ON value (when control changes)
  - "Detect Again" button to re-detect after confirmation
  - Toggle between auto-detect and manual entry modes
- **API explorer for sequence commands**
  - Browse and select endpoints when configuring sequence commands
  - Auto-detection support for discovering InputValue endpoints

### Changed

- **Redesigned device configuration UI**
  - Inputs table now shows Pin, Name, Type, and Value columns
  - Value column combines raw and calibrated readings (e.g., "512/0.5")
  - Removed Settings column for cleaner appearance
  - Consistent table design across inputs, outputs, and matrices
- **Redesigned train elements UI**
  - Compact table layout replaces large card design
  - Separate tables for levers and buttons with status indicators
  - Sequences section with matching table design
- **Improved button configuration wizard**
  - "Trigger Sequence" as top-level option alongside Keystroke and API Call
  - Hardware type selection (Momentary/Latching) shown before mode selection
  - Both ON and OFF sequences are optional (at least one required)
- **Train identifier prefix matching**
  - Train identifiers now act as prefixes - "RVM_LIRREX_M9" matches "RVM_LIRREX_M9-A", "RVM_LIRREX_M9-B", etc.
- **Automatic lever direction detection** during notch mapping
  - No longer requires manual "Invert lever direction" toggle
  - Works for both standard and reversed notch layouts
- **Streamlined lever configuration wizard**
  - Non-linear navigation in edit mode - click any step to jump directly
  - Dependency tracking shows which steps need to be redone after changes
  - Removed unused "Test" step

### Fixed

- Device reconnection failing after cable disconnect/reconnect
- Sequence endpoint selector not preserving ID when confirming detected values
- "Use endpoint" button not working in API explorer for sequences
- Boolean output binding operators causing runtime errors
- Lever auto-detect incorrectly showing for sequence configuration
- New trains not being set as active until app restart

### Removed

- Arduino Nano (Old Bootloader) board option - only new bootloader/clones supported

## [0.4.0] - 2026-01-03

### Added

- **Keystroke simulation mode** for button bindings
  - Map hardware buttons to keyboard keystrokes instead of API endpoints
  - Hold mode: Key is held while button is pressed, released when button is released
  - Support for modifier combinations (Ctrl, Shift, Alt)
  - Interactive key capture UI for intuitive keystroke recording
- **Lever direction inversion** option
  - Toggle in Map Notches step to invert hardware-to-simulator mapping
  - Use when physical lever direction is opposite to simulator expectation
  - Visual indicator reflects inverted position for immediate feedback

### Changed

- Button configuration wizard now includes a type selection step for better workflow

### Fixed

- Train detection now correctly identifies freight trains where locomotive and wagons have different class prefixes (uses drivable actor's ObjectClass)
- API Explorer list not scrolling in lever setup wizard
- Control auto-detection failing due to incorrect API response format
- SQLite "Database busy" errors under heavy load (added performance optimizations)

## [0.3.1]

### Changed

- Unified lever configuration wizard
  - Single 6-step wizard replaces previous 4-modal flow
  - Step 1: Select calibrated hardware lever input
  - Step 2: Find simulator endpoint via API explorer with auto-detect
  - Step 3: Review calibration requirements
  - Step 4: Auto-calibrate using LeverAnalyzer (detects discrete/continuous/hybrid behavior)
  - Step 5: Map notch positions to hardware with visual wobble capture
  - Step 6: Test live position indicator and complete
- New horizontal bar visualization for lever notches
  - Gates displayed as dots, linear notches as segments
  - Small gaps between adjacent notches for visual distinction
  - Live position indicator showing current hardware value
- Simplified lever card UI with single Configure/Edit button

### Fixed

- Lever mapping using incorrect simulator InputValue range
- Lever recalibration failing with "element_id already taken" error
- Momentary button mode not working correctly
- Overlapping modals during configuration wizard

### Removed

- Old NotchMappingWizard component (replaced by unified wizard)
- Separate "Bind Input" and "Map Notches" buttons for levers
- Old input binding modal for levers

## [0.3.0]

### Added

- Button binding modes
  - **Simple mode**: Sends ON value when pressed, OFF value when released (default behavior)
  - **Momentary mode**: Repeats ON value at configurable interval while button is held (for horn, etc.)
  - **Sequence mode**: Executes a series of commands with configurable delays
- Hardware type configuration for buttons
  - **Momentary**: Spring-loaded buttons that return when released
  - **Latching**: Toggle switches that stay in position until pressed again
- Command sequences
  - Create reusable sequences of simulator commands per train
  - Each command specifies endpoint, value, and delay before next command
  - Test button to execute sequences directly from the sequence manager
  - Buttons in sequence mode can trigger different sequences for press and release (latching only)
- Button endpoint auto-detection
  - "Auto-detect" option in button configuration wizard
  - Automatically discovers InputValue endpoints from simulator
  - Monitors for value changes when you interact with controls in-game
  - Suggests ON/OFF values based on detected changes
- Matrix input support
  - New "Matrix" input type with row/column GPIO pin configuration
  - Live grid preview showing dimensions and virtual pin mapping
  - Matrix Test Wizard for verifying button wiring with real-time highlighting and progress tracking
- Lever endpoint auto-detection
  - Automatically detects standard lever endpoints when navigating the API explorer
  - One-click configuration of all lever fields (min, max, value, notch count, notch index)
- API explorer in button configuration modal
- Warning banner when simulator is disconnected on train edit page

### Changed

- Configuration wizard now opens automatically after adding a new element
- Input Type field moved to top of Add Input modal for better workflow
- Inputs and Outputs now displayed in separate sections in device configuration
- Apply to Device button moved to page header for easier access
- Flash messages now display correctly across all pages

### Fixed

- Button getting stuck in "scan" position
- "Map Notches" button showing circular error message
- Device configuration not being associated after leaving config page
- "Mixed key types" error when saving notches
- Matrix pin validation crash when typing in a single field
- List cards not clickable on entire surface
- "Set up" button not responding in element configuration
- Flash messages not visible (clipped by navbar)

## [0.2.0]

### Added

- Output configuration UI for LEDs and indicators
  - Add/delete outputs with pin number (0-255) and optional name
  - Test buttons to toggle outputs on/off when device is connected
  - Outputs are controlled via SetOutput commands (not stored on device)

### Fixed

- Allow pin 0 to be selected when configuring analog and button inputs (pin 0 is a valid Arduino pin)
- Fix firmware upload crash when avrdude is not installed (now shows proper error message)
- Fix firmware upload on Windows for Pro Micro/Leonardo boards (detect bootloader on new COM port after 1200bps touch)
- Fix slow device reconnection after firmware upload (was waiting 30s backoff, now reconnects immediately)
- Fix config_id being regenerated when applying saved configuration (now preserves the existing config_id)
- Fix slow page transitions when simulator is disconnected (connection retries are now async)
