albertorestifo/trenino/docs/mechanical/fusion-controller/direct-v6-build-fixes/fdm-review-shaft/critical-2.png

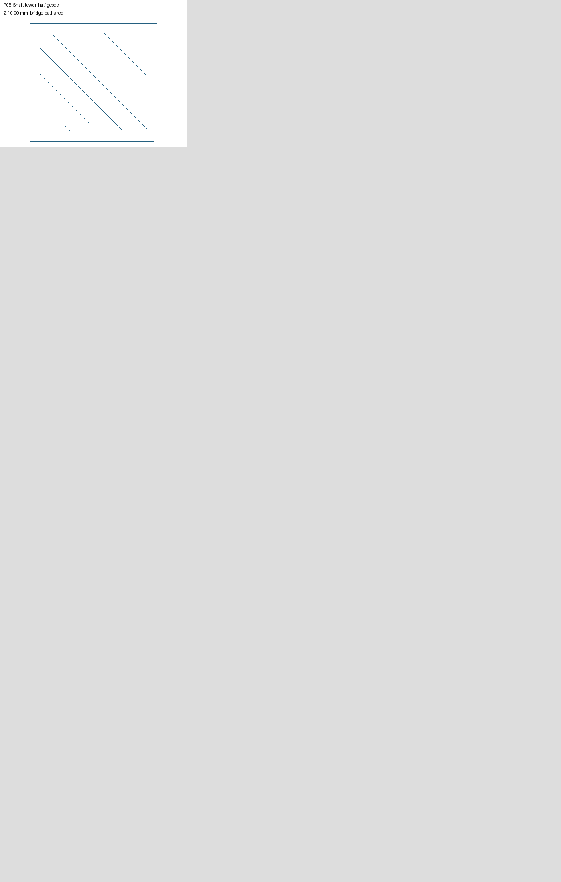
docs/mechanical/fusion-controller/direct-v6-build-fixes/fdm-review-shaft/critical-2.png
