albertorestifo/trenino/docs/mechanical/fusion-controller/direct-v6-build-fixes/layer-review/critical-2.png

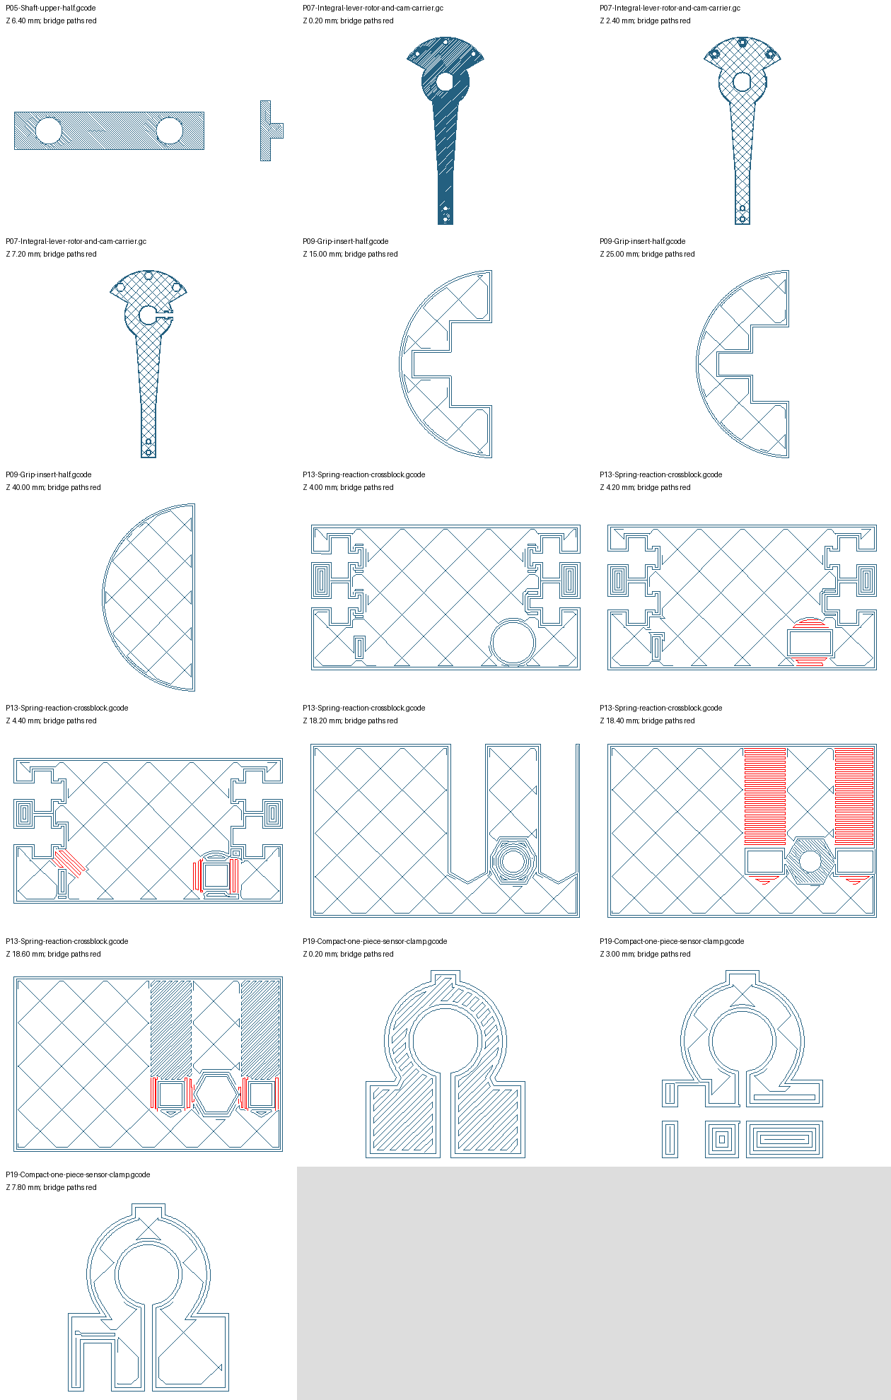
docs/mechanical/fusion-controller/direct-v6-build-fixes/layer-review/critical-2.png
