albertorestifo/trenino/docs/mechanical/fusion-controller/direct-v6-build-fixes/layer-review/layers-1.png

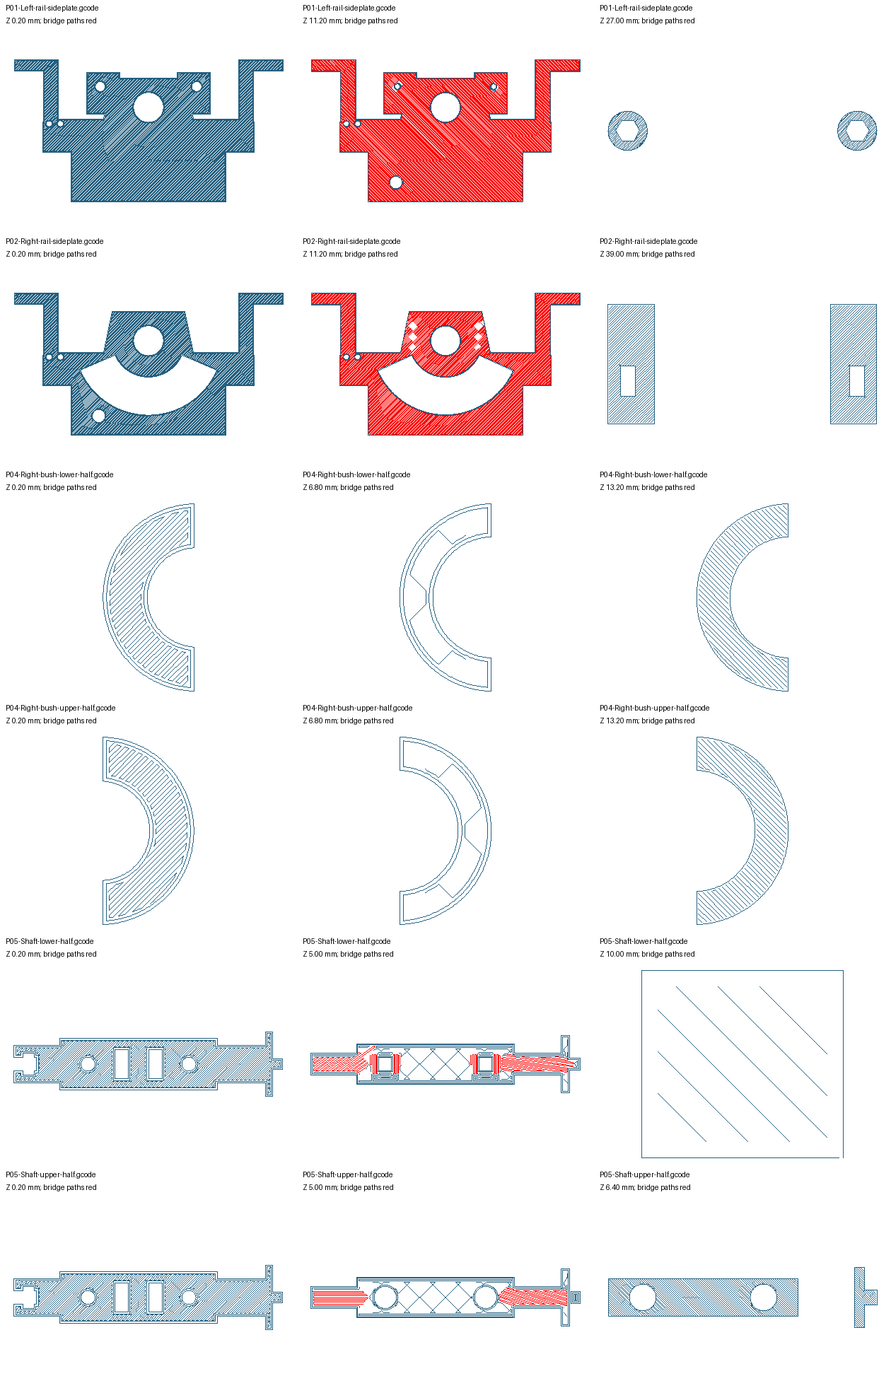
docs/mechanical/fusion-controller/direct-v6-build-fixes/layer-review/layers-1.png
