albertorestifo/trenino/(commit log)

2025-11-24 Device UI start
2025-11-28 Working calibration flow
2025-11-29 Calibration for levers
2025-12-07 Add tests for the notch calibration
2025-12-14 Fix windows build
    - Add graceful shutdown that works on Windows via the /shutdown endpoint
    - Fix startup issue
    [lib.rs]
2025-12-16 Support lateast features of the v2 board protocol
    - Matrix
    - Button
    - SetOutput
2025-12-16 Add button binding
2025-12-20 Fix pin 0 not selectable in input configuration
    Pin 0 is a valid Arduino pin but was incorrectly rejected by validation.
    Changed pin validation from `greater_than: 0` to `greater_than_or_equal_to: 0`
    for both analog and button input types. Also updated the UI form to allow
    pin 0 in the number input.
2025-12-20 Fix firmware upload on Windows for Pro Micro/Leonardo boards
    On Windows, the Pro Micro and Leonardo boards often reappear on a different
    COM port after the 1200bps bootloader touch. The uploader now detects the
    new port by comparing available ports before and after the touch.
    Also improved error parsing to recognize "cannot open port" errors.
2025-12-20 Fix slow device reconnection after firmware upload
    After firmware upload, the port was marked as :failed with a 30 second
    backoff before reconnection. Now the port entry is removed entirely so
    the device is discovered fresh, and an immediate scan is triggered 500ms
    after upload completion.
2025-12-20 Fix config_id regeneration and async simulator connection
    - Fix config_id being regenerated when applying saved configuration to
    a device (now preserves the existing config_id)
    - Make simulator connection retries fully async to prevent blocking
    page transitions when the simulator is disconnected
    - Add TaskSupervisor for async connection tasks
    - Add test for config_id preservation
2025-12-20 Add output configuration UI for LEDs
    - Add device_outputs table to store output pin configuration
    - Create Output schema with pin (0-255) and optional name field
    - Add Hardware context functions for output CRUD operations
    - Implement outputs section in configuration edit LiveView with:
    - Add output modal with pin and name fields
    - Outputs table with test buttons when device connected
    - Delete output functionality
    - Test button sends SetOutput command to toggle LED on/off
    Outputs are stored in the database but not sent to device config.
    They are controlled via fire-and-forget SetOutput commands.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
2025-12-20 Fix active config detection and add lever endpoint auto-detection
    Bug fix:
    - Fix device configuration not being associated after leaving config page
    - Update DeviceConnection.device_config_id when ConfigurationStored is received
    - Add Connection.update_device_config_id/2 to sync connection state with DB
    Features:
    - Add auto-detection of standard lever endpoints in API explorer
    - Show detection banner when navigating to a lever node with standard endpoints
    - Auto-configure all 5 lever fields (min, max, value, notch count, notch index)
    - Widen lever config modal for better endpoint visibility
    - Add hover tooltips showing full endpoint paths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
2025-12-20 Fix Map Notches button calling wrong handler
    The "Map Notches" button was calling `open_guided_notch_mapping` which
    requires notches to already exist, showing an error "Please add notches
    first (use Map Notches)" - a circular reference.
    Changed the button to call `open_notch_mapping` instead, which opens
    the modal that allows creating and auto-detecting notches.
    Added tests to verify the button opens the correct modal and works
    without pre-existing notches.
2025-12-20 Add API explorer to button config and fix notch save error
    Button config improvements:
    - Add API explorer button to endpoint field in button config modal
    - Make api_explorer_select handler context-aware (works with both
    lever config and button config modals)
    - Fix "mixed key types" error when saving notches
    - Normalize map keys to strings before adding index to avoid mixing
    atom and string keys in save_calibration and save_notches
    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
2025-12-21 Fix button getting stuck in the "scan" position
2025-12-21 Add matrix input configuration UI and test wizard
    - Add "Matrix" input type to add input modal
    - Matrix configuration with row/column GPIO pins (comma-separated)
    - Live grid preview showing dimensions and virtual pin mapping
    - Validation for pin range, duplicates, and overlap
    - MatrixTestWizard LiveComponent for testing matrix button wiring
    - Real-time button highlighting when pressed
    - Track and display which buttons have been tested
    - Progress bar showing tested button count
    - Add tests for matrix input and validation
2025-12-21 Fix matrix pin validation crash when typing in single field
    The validate_matrix_pins event handler required both row_pins and
    col_pins in the params, but LiveView only sends the changed field.
    Now uses Map.get with fallback to existing socket value.
2025-12-21 Add test for matrix input creation and fix handle_event grouping
    - Add test for successfully adding a matrix input via the UI
    - Test verifies matrix pin values are preserved through form submission
    - Test confirms matrix input appears in table with correct dimensions
    - Reorganize handle_event clauses to be grouped together (fixes warning)
    - Move private helper functions after all handle_event callbacks
2025-12-21 Fix matrix input error handling to show user-friendly message
    When trying to add a matrix input and one already exists, the unique
    constraint error on pin=0 was being silently swallowed. Now shows
    a clear error message: "A matrix input already exists for this device.
    Only one matrix input is allowed per device."
2025-12-21 Allow multiple matrix inputs per device with nullable pin
    Matrix inputs don't use a single GPIO pin - their pins are stored in the
    matrix_pins table. This change makes the pin field nullable for matrix
    inputs and uses a partial unique index to only enforce uniqueness when
    pin is not null.
    - Add migration with partial unique index on (device_id, pin) WHERE pin IS NOT NULL
    - Update Input schema to validate pin is null for matrix type
    - Update LiveView to not pass pin when creating matrix inputs
    - Update tests to reflect new behavior
2025-12-21 Add logging for configuration commands sent to device
    Logs each Configure struct before encoding and sending.
2025-12-21 Fix save_notches and add Map Input Ranges button
    1. Fix save_notches extracting empty params from forms - was using
    form.params which is empty for loaded forms. Now uses apply_changes
    to get actual values from the changeset.
    2. Add "Map Input Ranges" button to lever element card to access the
    guided notch mapping wizard. Button only shows when notches exist
    and an input is bound.
2025-12-21 Fix button overflow in lever element card
    Add flex-wrap and justify-end to allow buttons to wrap to next line
    when container is too narrow.
2025-12-21 Move Map Input Ranges button into Map Notches modal
    The button is now in the modal footer (left side) instead of crowding
    the lever element card. Only shows when notches exist and input is bound.
2025-12-21 Add button input recording feature
    Users can now click "Record" in the button config modal to auto-detect
    hardware button presses:
    - Click Record, press any button on hardware, input auto-selected
    - Supports both button inputs and matrix buttons (virtual pins 128+)
    - 10 second timeout with cancellation option
    - Shows spinner and instructions during recording
    - Displays detected input with device name and pin/position info
    Also includes matrix inputs in the available button inputs list.
2025-12-21 Fix NotLoaded error for matrix_pins in button config modal
    Handle case where matrix_pins association is not preloaded when
    displaying or matching matrix inputs.
2025-12-23 Add button binding modes and momentary repeat support
    - Add mode field (:simple, :momentary, :sequence) to button bindings
    - Add hardware_type field (:momentary, :latching) for switch types
    - Add repeat_interval_ms for momentary mode repeat timing
    - Implement momentary mode in ButtonController with timer-based repeat
    - Cancel active button timers on train change or binding reload
    - Add comprehensive tests for mode and hardware_type functionality
2025-12-23 Add UI for button mode and hardware type selection
    - Add binding mode dropdown (simple, momentary)
    - Add hardware type dropdown (momentary, latching)
    - Show repeat interval input for momentary mode
    - Display new fields in confirmation panel
    - Save new fields when creating/updating button bindings
2025-12-23 Add ControlDetectionSession for auto-detect feature
    Implements a GenServer that:
    - Discovers all InputValue endpoints from CurrentDrivableActor
    - Creates subscriptions and takes baseline snapshot
    - Polls for changes at 150ms intervals
    - Detects control interactions above threshold (0.01)
    - Notifies callback pid with detected changes
    - Times out after 30 seconds with no detection
    - Cleans up subscriptions on stop
2025-12-23 Add auto-detect UI component for control discovery
    - Create AutoDetectComponent LiveComponent with modal UI
    - Show listening state with countdown timer
    - Display detected controls with selection support
    - Handle timeout and error states
    - Add message handlers in train_edit_live for forwarding
    - Integrate with configuration wizard via button_detected event
2025-12-23 Add Sequence and SequenceCommand schemas for command sequences
    - Create Sequence schema for reusable command sequences per train
    - Create SequenceCommand schema for individual commands with position/delay
    - Add on_sequence and off_sequence associations to ButtonInputBinding
    - Add validation: sequence mode requires on_sequence_id
    - Add validation: off_sequence only valid for latching hardware
    - Create migration with proper indexes and foreign keys
2025-12-23 Implement ButtonController sequence execution
    Add sequence execution support to ButtonController:
    - Load on_sequence and off_sequence with commands when loading bindings
    - Spawn separate process for sequence execution with delays
    - Track active buttons with sequence_task for cancellation
    - Cancel running sequences on button release (momentary hardware)
    - Execute off_sequence on release for latching hardware
    Also includes migration to allow NULL endpoint for sequence mode
    (sequences define their own endpoints).
2025-12-23 Add sequence management UI
    Add SequenceManagerComponent for creating and managing sequences:
    - List sequences for a train
    - Create new sequences with name
    - Edit sequence commands (add/remove/reorder)
    - Delete sequences
    Update ConfigurationWizardComponent for sequence mode:
    - Add "Sequence" option to button mode dropdown
    - Add press sequence and release sequence dropdowns
    - Show sequence info in confirmation panel
    - Save on_sequence_id and off_sequence_id in bindings
    Integrate sequence manager into train edit page.
2025-12-23 Update changelog with button binding enhancements
    Document new features:
    - Button binding modes (simple, momentary, sequence)
    - Hardware type configuration (momentary, latching)
    - Command sequences with delays
    - Button endpoint auto-detection
2025-12-23 Integrate auto-detect button into configuration wizard
    Add "Auto-Detect Control" button to button configuration wizard:
    - Shows prominently above the API browser for quick setup
    - Opens AutoDetectComponent modal when clicked
    - Forwards detection results to wizard via explorer_event
    - Automatically populates endpoint and suggested ON/OFF values
    - Advances to testing step on successful detection
    This completes the Phase 1.5 auto-detect feature integration.
2025-12-23 Improve button mapping UX and fix sequence execution issues
    UX improvements:
    - Add sequence test button to execute sequences directly from the manager
    - Add example use cases to empty state in sequence manager
    - Improve mode descriptions with concrete examples (horn, lights, etc.)
    - Improve hardware type descriptions (keyboard key, light switch)
    - Add link to create sequences when none exist in wizard
    Code improvements:
    - Fix memory leak in sequence execution by adding process monitoring
    - Sequence tasks now properly exit when controller dies
    - Use receive with timeout for delays (allows cancellation mid-delay)
    - Add edge case tests for rapid button presses, long delays, stale messages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
2025-12-23 Improve visual consistency between Elements and Sequences sections
    - Move Add Element button to header row (matching Sequences layout)
    - Simplify Sequences empty state to match Elements style
    - Remove example uses expandable section
2025-12-23 Apply visual consistency to device configuration page
    - Update device header to use proper form inputs with labels
    - Move Add Input/Output buttons to header row (matching train edit page)
    - Use shared empty_collection_state component for empty states
    - Use shared danger_zone component for delete section
    - Import SharedComponents for reusable UI elements
2025-12-23 Extract section_header shared component
    Add reusable section_header component for consistent section styling:
    - Title with optional action button on the right
    - Supports phx-target for LiveComponents
    - Used in Elements, Sequences, Inputs, and Outputs sections
    Also:
    - Inline empty state components instead of wrapper functions
    - Use shared empty_collection_state directly
2025-12-23 Remove status section, move Apply button to header
    - Remove "No devices connected" status block
    - Move "Apply to Device" button to header (next to Save)
    - Show simple "Active" badge when configuration is applied
    - Matches train edit page pattern for showing active state
2025-12-23 Move Input Type field to top of Add Input modal
    Input Type selection now appears first since subsequent fields
    (Pin Number, Sensitivity, Debounce, Matrix config) depend on it.
2025-12-23 Fix button click
2025-12-23 Refactor matrix to separate entity
    Matrix is now a separate entity instead of an input type. When a matrix
    is created, virtual button Input records are automatically created with
    matrix_id set and pins 128-255. This eliminates all "if matrix" checks
    throughout the codebase - a matrix button is just a button.
    Changes:
    - Add Matrix schema with virtual_pin/3 helper
    - Update MatrixPin to reference matrix_id instead of input_id
    - Update Input schema: remove :matrix type, add matrix_id and name fields
    - Remove virtual_pin from ButtonInputBinding
    - Simplify ButtonController binding lookup to just input_id
    - Add Hardware context functions: create_matrix, list_matrices, etc.
    - Update configuration_e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
2025-12-23 Add LeverAnalyzer for empirical lever behavior detection
    Adds a new LeverAnalyzer module that sweeps through lever input ranges
    to detect actual behavior, solving the issue where API-reported notch
    counts don't match real lever behavior (e.g., BR430 MasterController
    reports 7 notches but has 21 continuous output positions).
    Key changes:
    - New LeverAnalyzer module that classifies levers as :discrete,
    :continuous, or :hybrid based on observed behavior
    - Added lever_type field to LeverConfig schema
    - Integrated analyzer into ConfigurationWizard save flow
    - Fixed notch creation to not copy simulator positions into
    hardware input range fields (semantically different concepts)
    The analyzer r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
2025-12-23 Fix overlapping modals and enhance configuration wizard
    - Fix ApiExplorerComponent to support embedded mode without modal wrapper
    - Add `embedded` prop to control whether modal wrapper is rendered
    - When embedded=true, renders content without fixed positioning/backdrop
    - Resolves issue where clicking "Set Up" showed two overlapping modals
    - Add lever calibration step with preparation UI and loading indicator
    - New :calibrating wizard step with safety checklist
    - Shows loading spinner during lever analysis
    - Add button auto-detect for hardware input selection
    - Replace radio button list with "Detect" button
    - Listen for hardware button presses to auto-select input
    - Fix matri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
2025-12-24 Fix momentary button mode and simplify configuration wizard
    Button Controller:
    - Add Interacting property support for momentary buttons
    - Send InputValue continuously while button held (no delay)
    - Remove configurable repeat interval (now sends as fast as possible)
    - Remove noisy logging for simulator commands
    Configuration Wizard:
    - Fix form binding - wrap fields in form with phx-change handler
    - Remove confirmation step for buttons (configure page has Save button)
    - Skip to configure step when editing existing bindings
    - Remove repeat interval UI option
2025-12-31 Replace lever configuration flow with unified wizard
    - Add LeverSetupWizard with 6-step flow:
    1. Select calibrated hardware input
    2. Find endpoint via API explorer/auto-detect
    3. Review calibration requirements
    4. Auto-calibrate using LeverAnalyzer
    5. Map notches with visual wobble capture
    6. Test live position and complete
    - Add LeverVisualization component with horizontal bar display
    showing gates as dots, linear notches as segments, and live
    position indicator
    - Remove old fragmented 4-modal lever flow:
    - Delete NotchMappingWizard component
    - Remove input binding modal from TrainEditLive
    - Remove lever mode from ConfigurationWizardComponent
    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
2026-01-01 Fix LeverAnalyzer gate vs linear detection and add unit tests
    - Add gate_range_threshold (0.1) to determine notch type based on output range
    - Gates are detected when min/max outputs differ by less than 0.1 after rounding
    - Fix function clause grouping warnings in configuration_wizard_component.ex
    - Fix function clause grouping warnings in train_edit_live.ex
    - Remove unused can_proceed_from? clauses in lever_setup_wizard.ex
    - Add LeverVisualization event_target prop for proper event routing
    - Add async calibration flow for lever setup wizard
    - Update ButtonController tests to match self-messaging implementation
    - Update ConfigurationWizard tests to use render(view) for full HTML
    - Add compre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
2026-01-01 Improve LeverAnalyzer output-based zone detection
    - Add Zone struct for proper input/output range tracking
    - Implement output-based zone detection using discontinuity threshold
    - Add initialize_lever_position to push past snap points at sweep start
    - Merge adjacent gates with similar values to handle snap-back artifacts
    - Increase output discontinuity threshold to 0.8 for proper linear detection
    The analyzer now correctly detects: Gate (emergency) → Linear (braking) →
    Gate (neutral) → Linear (power) for the MasterController.
2026-01-01 Rewrite LeverAnalyzer with simpler notch-based detection
    Replace complex boundary verification logic with a simpler approach:
    - Read GetCurrentNotchIndex at each sweep position
    - Group samples by notch_index (API's zone boundaries)
    - Merge adjacent notch groups that don't have snap behavior at boundary
    - Detect snap by checking if actual_input jumps significantly between zones
    This produces correct results: Gate (emergency) → Linear (braking) →
    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
2026-01-03 Fix train detection to use drivable actor's ObjectClass
    The previous common_prefix approach failed for freight trains where
    the locomotive and wagons have different class prefixes (e.g.,
    RVM_SBN_OBB_1116 vs RVM_VBRG_Laaers), resulting in just "RVM".
    Now uses CurrentFormation.DrivableIndex to get the ObjectClass of
    the actual driven vehicle, providing correct identification.
2026-01-03 Add keystroke simulation for button bindings
    - Create Rust keystroke utility using enigo for Windows SendInput
    - Add TswIo.Keyboard module to invoke keystroke executable
    - Add keystroke field and mode to ButtonInputBinding schema
    - Update ButtonController to handle keystroke mode (key_down/key_up)
    [main.rs]
2026-01-03 Add keystroke capture UI for button configuration
    - Add KeystrokeCapture JavaScript hook for recording key combinations
    - Update ConfigurationWizardComponent with keystroke mode option
    - Show interactive capture field when keystroke mode is selected
    - Support Ctrl, Shift, Alt modifier detection
2026-01-03 Refactor button wizard with type selection step
    Replace the confusing "skip" button approach with a cleaner UX:
    - Add "Choose Type" as the first step with clear options
    - "Simulator Control" proceeds to API explorer
    - "Keyboard Key" goes directly to keystroke configuration
    - Step indicators adapt based on binding type chosen
    - Back button returns to appropriate step based on mode
    This provides a clearer mental model for users configuring buttons.
2026-01-03 Fix new trains not being set as active
    After creating a new train, trigger detection sync to check if the new
    train matches the current simulator state. Previously, new trains would
    only become active after the next 5-second poll cycle or app restart.
2026-01-03 Fix sync() not re-checking database for current identifier
    The sync handler was calling detect_train with the existing state, but
    handle_identifier_detected skips the database lookup when the identifier
    hasn't changed. Clear current_identifier before detection to force a
    full re-lookup from the database.
2026-01-06 Streamline lever wizard and simplify inversion detection
    - Remove "Test" step from lever wizard - closes after saving notch mappings
    - Remove confusing live position indicator from notch mapping visualization
    (numerical values at bottom are sufficient)
    Code improvements from review:
    - Fix variable shadowing in reversed_layout?/1 (notches → mapped)
    - Simplify detect_inversion/3 using Enum.zip instead of with_index + at
    - Use consistent if/else pattern instead of case with multiple clauses
    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
2026-01-06 Allow notch capture with any number of samples
    Removes the minimum 10 sample requirement for notch capture.
    Users with low sensitivity hardware can now map notch positions
    as long as at least one sample with a valid range is collected.
2026-01-06 Add non-linear navigation to lever wizard edit mode
    When editing an existing lever configuration:
    - Step indicators are now clickable to jump directly to any step
    - Skip the "Calibration Info" step entirely in edit mode
    - Dependency tracking: changing input invalidates mapping; changing
    endpoint invalidates calibration and mapping
    - Warning indicator (orange badge) shows steps that need to be redone
2026-01-06 Show configured step status visually in lever wizard edit mode
    When opening the lever wizard in edit mode:
    - Steps with valid configuration show green checkmarks
    - Steps that need to be redone show orange warning icons
    - Unconfigured steps show step numbers
    - Current step shows primary color
    This makes it immediately clear which parts of the lever
    configuration are complete vs need attention.
2026-01-06 Allow capture button as soon as one sample is collected
    Previously, the capture button required min != max (lever must have
    moved to create a range). Now it's enabled as soon as any sample is
    collected.
    This allows single-point captures (min == max) which are valid for
    gate notches where the lever should be at a specific position.
2026-01-06 Improve button endpoint found message in setup wizard
    - Change icon from hand-raised to check-circle (clearer success indicator)
    - Remove non-functional "suggested values" text
2026-01-06 Add button ON/OFF value auto-detection
    Replace Test ON/OFF buttons with an auto-detection flow:
    - Add toggle between "Detect Values" (default) and "Configure Manually"
    - Auto mode uses API subscriptions to monitor endpoint value changes
    - First polled value is captured as OFF (resting), value change >0.05 as ON
    - Show detected values with Confirm/Retry options
    - Manual mode shows input fields for direct value entry
    - Parent LiveView handles subscription polling since LiveComponents don't
    support handle_info
    Also fix API subscription and auto-detect issues:
    - Add empty body to POST requests for Content-Length header requirement
    - Add loading state when starting auto-detection (shows "Setti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
2026-01-06 Update changelog for button ON/OFF auto-detection
2026-01-06 Rename project from TSW IO to Trenino
    - Rename all modules: TswIo → Trenino, TswIoWeb → TreninoWeb
    - Rename directories: lib/tsw_io → lib/trenino, etc.
    - Update app name from :tsw_io to :trenino
    - Update firmware references: tsw_board → trenino_firmware
    - Update all config files, package.json, and Tauri configs
    - Update documentation with new branding
    - Update git remote to github.com/albertorestifo/trenino
    Trenino = Train Sim World + Arduino, also means "model train" in Italian.
2026-01-06 Remove Arduino Nano (Old Bootloader) board option
    - Fix Arduino Nano baud rate: 115200 for new bootloader/clones (was 57600)
    - Remove nano_old_bootloader board type from BoardConfig
    - Add migration to clean up existing nano_old_bootloader firmware files
    - Update tests and changelog
2026-01-06 Add LED output test toggle button
    Replace separate ON/OFF buttons with a single toggle button that:
    - Shows current state (ON/OFF) with visual feedback
    - Changes appearance (green when ON, ghost when OFF)
    - Tracks state per-output in socket assigns
2026-01-07 Refactor hardware.ex delete_device to reduce nesting
    Extract cascade deletion logic into separate functions:
    - delete_device_cascade/1 for the main deletion flow
    - delete_input_with_calibration/1 for input cleanup
    Add comprehensive tests for delete_device/1.
2026-01-07 Refactor hardware.ex matrix functions to reduce complexity
    Extract matrix CRUD logic into smaller focused functions:
    - insert_matrix/2 for matrix insertion
    - maybe_update_name/2 for optional name updates
    - maybe_update_pins/3 for optional pin updates
    - delete_matrix_children/1 for cleanup
    - setup_matrix_pins_and_buttons/4 for pin and button creation
    Add comprehensive tests for update_matrix/2.
2026-01-07 Reduce nesting depth in train.ex functions
    - Refactor update_notch_input_ranges using with clause and helpers
    - Refactor create/update_lever_config_with_analysis using with clauses
    - Refactor save_calibration and save_notches with insert_notches helper
    - Refactor auto_distribute_input_ranges with do_auto_distribute helper
    - Refactor set_sequence_commands with insert_sequence_commands helper
    - Extract replace_notches and fetch_lever_config helpers
2026-01-07 Reduce nesting depth in button_controller.ex
    - Extract add_device_button_inputs helper from rebuild_input_lookup
    - Extract handle_sequence_release clauses from nested case statements
    - Use pattern matching on hardware_type and off_sequence for clarity
2026-01-07 Extract helper functions to reduce nesting in LiveView components
    - Refactor api_explorer_component.ex navigate handler into helpers
    - Extract sequence testing logic in sequence_manager_component.ex
    - Simplify firmware_live.ex file download flow
    - Refactor lever_visualization.ex notch position calculations
2026-01-07 Fix nested module aliases across codebase
    - Add explicit aliases for nested modules that were being referenced
    with full paths (Credo software design suggestion)
    - Add Ecto.Adapters.SQL.Sandbox alias to test files
    - Add Trenino.Firmware.FilePath alias where needed
    - Add CalibrationSession alias for Hardware.Calibration.Session
    - Fix incomplete aliases in train_edit_live.ex and button_controller.ex
    - Ensure all aliases are in alphabetical order
    All 921 tests pass with no credo issues.
2026-01-07 Add output bindings feature for hardware LED control
    Bind hardware outputs (LEDs) to simulator API values with conditional
    triggering. Users can configure bindings in the Train edit page with
    conditions (>, >=, <, <=, BETWEEN) that control when outputs turn on.
    - Add OutputBinding schema with operator and threshold validation
    - Add OutputController GenServer for runtime API polling and output control
    - Add OutputBindingWizard LiveComponent with 4-step configuration flow
    - Add context functions for CRUD operations on bindings
    - Add comprehensive test coverage (50 tests)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
2026-01-07 Fix device reconnection after cable disconnect
    - Manual scan now clears failed port status, bypassing 30-second backoff
    - Discovery re-sends identity request on each retry attempt
    - Increased settle delay (100ms → 200ms) and retry count (3 → 5)
    - Increased discovery timeout (5s → 7s) to match retry count
2026-01-07 Disable endpoint suggestions in output binding wizard
    Add :none mode to API explorer that skips lever and button endpoint
    detection. Output bindings don't need these suggestions since they
    bind to arbitrary API values, not standard control endpoints.
2026-01-07 Unify lever and button element card designs
    - Use consistent btn-outline style for Configure button
    - Always show "Configure" text (not "Edit" or "Set Up")
    - Remove detailed binding info from button cards
    - Use same badge style (badge-ghost) for both types
    - Horizontal layout with delete button inline
2026-01-07 Add boolean operator support for LED output bindings
    Support eq_true and eq_false operators for binding LEDs to boolean API
    endpoints (e.g., SIFA.Property.WarningStateVisual). Boolean operators
    don't require value_a threshold.
    - Add :eq_true and :eq_false operators to OutputBinding schema
    - Update changeset to make value_a nullable for boolean operators
    - Add evaluate_condition clauses with type guards
    - Update wizard UI with boolean operator options in dropdown
    - Add migration to allow null value_a in database
    - Add comprehensive tests for boolean operators
    Also fixes tests for earlier UI changes (element card uniformity).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
2026-01-07 Fix compiler warnings and enable --warnings-as-errors
    - Group handle_event/3 clauses together in api_explorer_component.ex
    to fix Elixir compiler warning about clause grouping
    - Fix typo in mix.exs: --warning-as-errors → --warnings-as-errors
2026-01-09 Fix sequence endpoint selector bugs
    - Fix KeyError when confirming detected value by preserving id in assigns
    - Hide lever auto-detect in API explorer for sequence mode
    - Forward button detection events to EndpointSelectorComponent for sequences
2026-01-09 Improve sequence configuration UI and validation
    UI Changes:
    - Add "Trigger Sequence" as top-level option in button type selection
    - Make type selection cards more compact with chevron indicators
    - Hide "Button Mode" dropdown for sequence mode (already chosen)
    - Show "Hardware Type" first for sequence mode
    - Rename labels: "Press Sequence" -> "On Press", "Release Sequence" -> "On Release"
    - Allow either on or off sequence (at least one required)
    - Add validation warning when no sequence selected
    - Hide "Selected Endpoint" section for sequence mode
    Validation Changes:
    - Allow saving with only off_sequence_id (for latching hardware)
    - Add validate_at_least_one_sequence/1 to schema
    - Fix get_i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
2026-01-09 Redesign elements and sequences sections with compact table layout
    - Replace element cards with compact table rows
    - Add unified element_row component handling both levers and buttons
    - Show status badges: Ready, Needs mapping, Needs input, Partial, Not configured
    - Change button icon from finger-print to cursor-arrow-rays
    - Convert sequences section to matching table format
    - Consistent visual design: table-sm, bg-base-200 headers, hover effects
2026-01-09 Improve value detection UX and refactor element status logic
    Value Detection:
    - Add :confirmed state for value detection status
    - Show confirmed values with "Detect Again" option after confirmation
    - Auto-set to :confirmed when editing existing bindings with endpoints
    Code Quality:
    - Rename is_button_fully_configured? to button_fully_configured?
    - Extract element_status, lever_status_badge, button_status_badge helpers
    - Reduce cyclomatic complexity in element_row function
2026-01-09 Add editable names for inputs, outputs, and matrices
    - Add name field to input creation form
    - Add inline name editing for inputs, outputs, and matrices tables
    - Add update_input and update_output functions to Hardware context
    - Simplify inputs table by removing Settings column
    - Merge Raw and Calibrated columns into single Value column (raw/calibrated)
    - Add tabular-nums and min-width to prevent table jumping on value changes
2026-01-17 Implement dynamic list of devices from firmware release
2026-01-23 docs: Weekly documentation review for 2026-01-23
    Updates documentation to reflect the dynamic device registry feature
    implemented in commit 7381cbe.
    - CHANGELOG.md: Add entries for dynamic device registry and firmware improvements
    - docs/architecture.md: Document DeviceRegistry GenServer and firmware domain
    - docs/development.md: Update GenServer list and contexts
    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
2026-01-31 Fix firmware upload system to use environment strings consistently
    The recent refactoring to support dynamic device loading from release.json
    manifests introduced type mismatches where UploadHistory and UploadManager
    expected atom board_types but received environment strings. This prevented
    firmware uploads from working as the upload history creation would fail with
    validation errors.
    - Updated UploadHistory schema to accept string board_type values
    - Refactored UploadManager to use environment parameter throughout
    - Enhanced FilePath to support both legacy atoms and new environment strings
    - Updated all test fixtures to use string identifiers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
2026-01-31 Add support for Arduino Nano new bootloader variant (nanoatmega328new)
    The latest firmware releases use "nanoatmega328new" as the environment name for
    Arduino Nano boards with the new bootloader. This commit adds hardware configuration
    for this environment alongside the existing "nanoatmega328".
    - Added "nanoatmega328new" to DeviceRegistry hardware configs
    - Updated environment_to_board_type mapping in Downloader
    - Updated infer_display_name for the new environment
    - Fixed test assertions to account for 7 devices instead of 6
    This resolves the "No firmware available for this device" error when selecting
    Arduino Nano from the firmware upload UI.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
2026-01-31 Remove all hardcoded device configurations and backward compatibility
    All device configurations are now loaded exclusively from release.json manifests
    with uploadConfig. This eliminates hardcoded hardware configurations and legacy
    support for old firmware releases.
    Breaking Changes:
    - Removed all hardcoded device configurations (except emergency fallback error)
    - Removed legacy asset parsing for releases without manifests
    - Removed board_type enum constraint - now accepts any string
    - Removed board_type_to_environment conversion functions
    - Simplified firmware file matching to only use environment field
    - Releases without valid manifests are skipped entirely
    Benefits:
    - No code changes nee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
2026-01-31 Add comprehensive end-to-end tests using real release manifest
    Created integration tests that validate the entire firmware update flow using
    the actual v2.2.1 release.json format from the trenino_firmware repository.
    Tests cover:
    - Creating releases from manifests with uploadConfig
    - Loading all devices into registry
    - Verifying upload configurations (protocol, MCU, speed, 1200bps touch)
    - Firmware file selection by environment
    - Select options for UI dropdowns
    - Device detection from filenames
    - MCU name normalization (atmega328p -> m328p)
    - Error handling for invalid manifests
    All tests use real-world data and validate end-to-end behavior.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
2026-01-31 Fix configuration creation to auto-save and prevent duplicates
    When creating a new configuration, changes are now auto-saved on every
    input change. The URL automatically redirects from /configurations/new
    to /configurations/<config_id> after the first save, preventing the
    creation of duplicate configurations when the save button is pressed
    multiple times.
    - Remove manual Save button from configuration form
    - Auto-save device name and description on change
    - Automatically redirect from /new to actual config ID after first save
    - Add handle_params/3 to smoothly transition from new mode to existing
    - Refactor to reduce nesting and improve code quality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
2026-01-31 Reduce cyclomatic complexity in environment_to_board_type
    Refactor environment_to_board_type to use a map lookup instead of a
    case statement with 9 branches. This reduces cyclomatic complexity
    from 10 to 1, satisfying the Credo requirement (max complexity 9).
    The functionality remains identical - converting environment strings
    to legacy board_type atoms for database backward compatibility.
2026-01-31 Fix all firmware tests to work with manifest-based system
    This commit updates all firmware-related tests to align with the new
    manifest-based firmware system that requires uploadConfig for all devices.
    Downloader:
    - Simplified parse_assets_from_manifest to store environment strings
    directly without converting to legacy board_type atoms
    - Removed environment_to_board_type function (no longer needed)
    Uploader:
    - Added backward compatibility clause to accept atom board types
    - Atom board types are converted to strings transparently
    Tests:
    - Added load_test_devices() helper to DataCase for test setup
    - Updated uploader tests to use DataCase and load device configs
    - Completely ref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
2026-01-31 Fix device type dropdown empty due to manifest download failure
    GitHub CDN serves release.json with Content-Type: application/octet-stream,
    so Req does not auto-decode the JSON body. The validate_manifest function
    only handled map inputs, causing all manifest downloads to fail silently
    with :not_a_map. Added a clause to parse string bodies as JSON.
    Also added self-healing on startup: when DeviceRegistry finds no manifest
    in the database, it triggers a background check_for_updates to fetch and
    store manifests automatically.
2026-02-01 feat: add dedicated script editor LiveView page
    Full-featured Lua script editor with:
    - Name input and save/create form
    - Monospace code textarea with debounced updates
    - Trigger endpoint management (add/remove tags)
    - Enable/disable toggle and manual Run button
    - Console log viewer with refresh
    - Collapsible hardware outputs reference table
2026-02-01 docs: add MCP server design for native train configuration
    Design document for exposing Trenino as a native MCP server over SSE,
    enabling Claude to configure output bindings, button bindings, and
    sequences through structured tools.
2026-02-01 feat: add native MCP server for AI-powered train configuration
    Implement an MCP server over SSE directly in Phoenix, enabling Claude
    to configure train output bindings, button bindings, and command
    sequences through structured tools. Replaces the fetch-based MCP proxy
    with 20 fine-grained tools across simulator, trains, devices, output
    bindings, button bindings, and sequences.
    Also fixes pre-existing credo issue in ScriptEngine (explicit try)
    and adds end-user documentation with setup guide.
2026-02-01 feat: add MCP element tools for managing train buttons and levers
    Add ElementTools module with list_elements, create_element, and
    delete_element MCP tools, enabling AI-driven management of train
    control elements. Update tool count in existing tests.
2026-02-06 docs: Weekly documentation review for 2026-02-06
    Updated documentation to reflect changes from the past week:
    CHANGELOG.md:
    - Added Lua scripting system for train automation
    - Added native MCP server for AI-powered train configuration
    - Added resilient train detection with two-layer defense
    - Added Arduino Nano new bootloader support
    - Documented REST API expansions
    - Documented bug fixes for CI tests and train detection
    docs/architecture.md:
    - Added Train.Script, ScriptEngine, and ScriptRunner to Train Domain
    - Added MCP Domain section documenting MCP server and 20 tools
    - Updated GenServer supervision tree to include ScriptRunner
    - Added scripts schema to database diagram
    - Added MCP pro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
2026-02-07 fix: URL-encode simulator API paths with special characters
    Paths containing spaces and parentheses like "Throttle_Virtual (SimpleLever)"
    caused HTTP request failures due to invalid URL characters. Added encode_path/1
    helper that percent-encodes special characters while preserving path separators.
2026-02-07 fix: LeverAnalyzer reads actual input range instead of hardcoded 0.0-1.0
    Levers like the Class 166 ThrottleAndBrake have a -1 to 1 input range.
    The hardcoded 0.0-1.0 sweep missed the entire braking half, detecting
    only ~6 of 12 notches. Now reads GetMinimumInputValue/GetMaximumInputValue
    from the simulator before sweeping, with fallback to 0.0-1.0.
    Also fixes restore_position: 0.5 which is wrong for non-standard ranges,
    and a Credo issue in client.ex (Enum.map |> Enum.join -> Enum.map_join).
2026-02-07 fix: allow negative sim_input values in Notch validation
    The sim_input_min/sim_input_max fields represent simulator InputValue
    ranges which can be negative (e.g., -1.0 to 1.0 for ThrottleAndBrake
    levers). Remove the 0.0-1.0 constraint from sim_input validation while
    keeping it for hardware input_min/input_max which are always normalized.
2026-02-07 fix: use URL-encoded paths in ControlDetectionSession test stubs
    The encode_path function URL-encodes parentheses (Throttle(Lever) ->
    Throttle%28Lever%29), but the test stubs compared against unencoded
    paths, causing the list request to 404 and no subscriptions to be
    created.
2026-02-13 Add BLDC haptic lever support design
    Comprehensive design for supporting BLDC motor-based haptic levers:
    - Two-level configuration (hardware setup + runtime profiles)
    - Extended Notch schema with optional BLDC haptic fields
    - Auto-generated haptic parameters from detected zones
    - Profile loading/unloading on train activation/deactivation
    - Robust error handling for calibration and runtime failures
2026-02-13 feat(bldc): add database schema for BLDC lever support
    - Add :bldc to lever_type enum in LeverConfig
    - Add BLDC haptic fields to Notch (engagement, hold, exit, spring_back, damping)
    - Add validation for BLDC field ranges (0-255) in Notch changeset
    - Add comprehensive test coverage for BLDC field validation
    - BLDC fields are optional (nil for non-BLDC levers)
2026-02-13 Add BLDC protocol messages for haptic lever control
    Implements three new protocol messages for BLDC motor haptic control:
    - RetryCalibration (type 0x08): Retries calibration after failure
    - DeactivateBLDCProfile (type 0x0C): Puts motor in freewheel mode
    - LoadBLDCProfile (type 0x0B): Loads detent profile to firmware
    LoadBLDCProfile supports:
    - Multiple detents (position, engagement, hold, exit, spring_back)
    - Multiple ranges between detents (start, end, damping)
    - Comprehensive validation of all parameters
    All messages follow existing protocol patterns with encode/decode
    functions, proper validation, and comprehensive test coverage.
    Tests include:
    - Valid encoding/decoding for all messag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
2026-02-13 feat(bldc): add BLDCProfileBuilder to convert LeverConfig to LoadBLDCProfile
    Implement module that builds LoadBLDCProfile messages from LeverConfig data.
    Converts gate notches to detents and linear notches to damped ranges.
    Position calculation maps 0.0-1.0 input range to 0-100 firmware range.
    Validates BLDC parameters and returns errors for non-BLDC levers.
2026-02-13 Add BLDC haptic parameter generation to LeverAnalyzer
    LeverAnalyzer now generates default BLDC haptic parameters when
    analyzing levers with the `lever_type: :bldc` option. This enables
    auto-detection workflows to produce BLDC-ready lever configurations.
    - Updated analyze_samples/2 to accept opts parameter
    - Added lever_type: :bldc option to generate BLDC parameters
    - Extracted build_base_notch/2 for base notch data
    - Added default_bldc_params/2 with zone-type-specific values:
    - Gate zones: engagement=180, hold=200, exit=150, damping=0
    - Linear zones: engagement=50, hold=30, exit=50, damping=100
    - Both: spring_back=notch_index
    - Added 4 comprehensive tests covering gates, line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
2026-02-13 Add BLDC profile management to LeverController
    Implements automatic loading and deactivation of BLDC haptic profiles
    when trains are activated/deactivated:
    - Load BLDC profiles for all BLDC levers when train activates
    - Deactivate BLDC profiles when train deactivates
    - Skip profile loading for non-BLDC lever types
    - Handle missing device connections gracefully with warnings
    - Added load_bldc_profiles_for_train/1 to load profiles on activation
    - Added deactivate_bldc_profiles_for_train/1 to deactivate on deactivation
    - Uses BLDCProfileBuilder to construct profiles from lever config
    - Sends LoadBLDCProfile and DeactivateBLDCProfile messages via SerialConnection
    - Added comprehensive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
2026-02-13 Add BLDC lever type option to setup wizard UI
    Implemented lever type selection step in the wizard that allows users
    to choose between Analog Potentiometer and BLDC Haptic Lever types.
    - Added :select_lever_type as the first step in wizard flow
    - BLDC selection skips pin selection and goes directly to endpoint
    - Analog selection follows traditional flow through pin selection
    - Added comprehensive tests for both lever type options
    - Radio card style UI with clear descriptions and hardware requirements
    Tests verify:
    - BLDC option is displayed with hardware requirements
    - Analog option is displayed
    - BLDC selection skips pin selection step
    - Analog selection shows pin selection step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
2026-02-13 Add end-to-end integration tests for BLDC lever flow
    Implements comprehensive integration tests covering:
    - Complete BLDC configuration and activation lifecycle
    - Train creation with BLDC levers
    - Notch configuration with BLDC parameters
    - Profile loading on train activation
    - Profile deactivation on train deactivation
    - Train switching with different BLDC profiles
    - Mixed BLDC and continuous lever handling
    Tests validate:
    - LoadBLDCProfile message structure (detents and ranges)
    - Detent parameters (position, engagement, hold, exit, spring_back)
    - Range parameters (start_detent, end_detent, damping)
    - Proper activation/deactivation flow
    - Profile isolation between different trains
    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
2026-02-13 docs(bldc): add comprehensive BLDC lever documentation
    - Create feature documentation with configuration flow
    - Document hardware requirements and technical details
    - Explain two-level configuration system
    - Add error handling guide
    - Update README with BLDC support mention
2026-02-14 docs: add BLDC hardware config design document
2026-02-14 docs: add BLDC hardware config implementation plan
2026-02-14 feat: add BLDC lever input type to Configure protocol message
2026-02-14 feat: wire RetryCalibration, LoadBLDCProfile, DeactivateBLDCProfile into Message decoder
2026-02-14 feat: add BLDC lever columns and unique constraint to device_inputs
2026-02-14 feat: add :bldc_lever input type to Input schema with validation
2026-02-14 feat: wire BLDC lever input type through ConfigurationManager
    Add build_configure_message/4 clause for :bldc_lever inputs, mapping
    the 10 BLDC-specific fields from Input to Configure struct.
2026-02-14 feat: add BLDC lever input form to Device Settings UI
    This commit adds BLDC lever support to the Device Settings page:
    1. Add "BLDC Lever" to input type dropdown
    2. Hide Pin Number field for BLDC (pin auto-set to encoder_cs)
    3. Add BLDC-specific form fields for motor pins, encoder, and parameters
    4. Auto-assign pin to encoder_cs value when creating BLDC input
    5. Display BLDC badge with accent color in inputs table
2026-02-14 feat: setup wizard shows BLDC lever inputs when BLDC type selected
    Previously, BLDC levers skipped the "Select Input" step. Now that BLDC
    levers have their own input type (:bldc_lever) in device hardware config,
    the wizard properly handles both lever types:
    - All lever types go through select_input step (BLDC no longer skips)
    - Available inputs are filtered by lever type (BLDC shows :bldc_lever
    inputs, analog shows :analog inputs)
    - Updated test expectations to match new flow
2026-02-14 feat: migrate BLDC protocol schema for PD haptic controller
    Replace per-detent strength fields (engagement/hold/exit/spring_back)
    with single detent_strength, add profile-level snap_point and
    endstop_strength to lever_configs.
2026-02-14 feat: replace per-detent BLDC fields with single detent_strength in Notch schema
2026-02-14 feat: add bldc_snap_point and bldc_endstop_strength to LeverConfig schema
2026-02-15 feat: update LoadBLDCProfile protocol for 6-byte header and 2-byte detents
    New header includes snap_point and endstop_strength. Detents now have
    position + detent_strength (2 bytes) instead of position + 4 strength
    fields (5 bytes).
2026-02-15 feat: update BLDCProfileBuilder for new protocol format
    Use bldc_detent_strength instead of per-detent fields. Read snap_point
    and endstop_strength from LeverConfig with defaults (70, 200).
2026-02-15 feat: update LeverAnalyzer default BLDC params for new protocol
    Use bldc_detent_strength (gate: 200, linear: 30) instead of per-detent
    engagement/hold/exit/spring_back fields.
2026-02-15 feat: update integration and controller tests for new BLDC protocol
    Replace per-detent engagement/hold/exit/spring_back with
    detent_strength in all test fixtures and assertions.
2026-02-15 fix: resolve credo complexity and update protocol decode test
    Extract pin/profile_params validation into separate functions to reduce
    cyclomatic complexity. Update protocol_test.exs decode test for new
    binary format.
2026-02-17 fix: remove unused function components and fix dependabot analyzer workflow
    Remove dead code lever_element_card/1 and button_element_card/1 that
    caused compile warnings with phoenix_live_view v1.1.21. Switch
    dependabot-analyzer workflow to pull_request_target so it can access
    repository secrets.
2026-02-17 Filter formatting
2026-02-22 fix: increase serial settle delay for Arduino Mega bootloader
    The stock stk500v2 bootloader on Arduino Mega can take up to 3 seconds.
    Opening the serial port toggles DTR, resetting the board into the
    bootloader. With a 200ms settle delay, the first identity requests were
    sent while the device was still in the bootloader, and bootloader noise
    desynchronized the host's COBS framing layer for subsequent attempts.
2026-02-22 feat: Add BLDC self-calibrating lever pipeline
    BLDC motor levers self-calibrate on the firmware side and report discrete
    detent indices. Add LeverMapper.map_detent/2 to map detent indices to
    simulator values via gate notch lookup, branch LeverController to handle
    BLDC inputs without requiring calibration, and fix device page UI to show
    "Detent N" for BLDC levers without a calibrate button.
2026-03-02 fix: handle :port_timed_out exits from UART to prevent Connection GenServer crash
    Circuits.UART's internal call_port/4 calls exit(:port_timed_out) when the
    native port driver doesn't respond in time. This exit propagates through
    GenServer.call and crashes the Connection GenServer, taking down all device
    tracking. This commonly happens with Bluetooth devices or unresponsive
    serial ports.
    Wrap UART.open in do_open_port/3 and Discovery.discover + UART.configure
    in do_discover/3 with try/catch to convert exit signals into {:error, reason}
    tuples, which are already handled by the existing error paths.
    Fixes #46
2026-03-03 fix: resolve CI failures on Dependabot PRs by fixing secret access
    Dependabot runs in a restricted security context that cannot access
    repository secrets, causing claude-review and analyze-dependabot jobs
    to fail with "Environment variable validation failed".
    - claude-code-review.yml: Exclude dependabot[bot] PRs (handled by
    dedicated analyzer). Remove now-unnecessary allowed_bots setting.
    - dependabot-analyzer.yml: Switch to pull_request_target so secrets
    are accessible. Harden against pwn request attacks by explicitly
    checking out the base branch, not the PR head.
2026-03-04 feat: put BLDC lever UI behind feature flag for stable release
    Hide BLDC haptic lever selection and configuration in both the lever
    setup wizard and device settings behind :enable_bldc_levers config flag.
    Enabled in dev/test, disabled by default (production). Remove BLDC
    references from changelog, README, and mark docs as WIP.
2026-03-04 feat: add InputDetectionSession GenServer for hardware input detection
    Short-lived GenServer that detects which hardware input the user
    interacts with. Subscribes to PubSub input_value topics, builds a
    {port, pin} → input_info lookup from the database, records baselines
    on first event per pin, and fires {:input_detected, info} to the
    caller when a significant change is detected.
    Supports filtering by :button, :analog, or :any input type, with
    a configurable timeout that sends {:detection_timeout} on expiry.
    Monitors the callback_pid and stops automatically if it dies.
2026-03-04 fix: resolve flaky test failures in InputDetectionSession
    Three changes:
    1. Call Connection.connected_devices() once in init/1 and pass the
    result to both build_pin_lookup/1 and subscribe_to_ports/1,
    eliminating the duplicate GenServer call.
    2. Wrap on_exit stop calls in try/catch :exit to handle the case
    where the session already stopped itself after a detection fires
    (PubSub broadcast leak between tests).
    3. Replace refute Process.alive?(pid) after the timeout test with
    Process.monitor + assert_receive {:DOWN, ...} so the assertion
    waits for the process to actually terminate rather than racing
    against the GenServer stop.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
2026-03-04 docs: add Lua scripting guide and improve README
    Add end-user focused Lua scripting documentation covering the API,
    triggers, examples, and limitations. Restructure README for better
    flow: consolidate TSW API setup into Getting Started, add hardware
    test status, remove section dividers, fix nav links.
2026-03-06 fix: pass missing assigns to private LiveView components
    The add_input_modal component in configuration_edit_live crashed with a
    KeyError because bldc_enabled wasn't passed as an assign. Also adds
    the missing attr declaration for the empty_releases component in
    firmware_live.
2026-03-06 feat: show lever name as primary text in input selection list
    Display the input name prominently with device name and pin as a
    subtitle in the lever setup wizard's "Select Hardware Input" step.
2026-03-06 fix: reload controller bindings after MCP tool updates
    MCP tools for button and output bindings were updating the database but
    not calling reload_bindings() on the respective controllers, so changes
    made via MCP (e.g. updating mode or on_value) had no effect until the
    app was restarted. Also fix Interacting endpoint to use numeric 1/0
    instead of boolean true/false which the simulator rejects.
2026-03-09 fix: prevent LiveView crash when Connection GenServer is blocked by UART timeouts
    When serial ports are unresponsive (port_timed_out), UART.open blocks the
    Connection GenServer for 5+ seconds. During this time, NavHook's synchronous
    list_devices() call would timeout, crashing the LiveView mount and preventing
    users from accessing the UI.
    - NavHook now starts with empty state and fetches initial data asynchronously
    via send(self(), :nav_fetch_initial_state), letting PubSub handle updates
    - list_devices() and connected_devices() catch exit signals and return []
    instead of propagating the crash to callers
    - Fix test isolation in connection_port_timeout_test to properly restart
    t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
2026-03-14 fix: pin OTP version to 28.4 for Burrito compatibility
    Beam Machine doesn't have precompiled ERTS for OTP 28.4.1 yet,
    causing the Linux release build to fail with a 404.
2026-03-14 fix: add wrapper Makefile for circuits_uart Burrito cross-compilation
    Burrito runs `make` from the dep root directory, but circuits_uart
    has its Makefile at src/Makefile. Create a delegating wrapper so
    the NIF recompilation step can find the build targets.
2026-03-14 fix: simplify Linux Burrito build workarounds
    Replace custom ERTS download with version-type: strict in setup-beam
    to install exactly OTP 28.4 (matching Beam Machine). Replace printf'd
    Makefile wrapper with a symlink for circuits_uart.
2026-05-03 docs: add firmware flashing robustness design spec
    Documents the plan for issue #76: AvrdudeRunner extraction for
    testability, regression fixtures for known failure modes, Windows
    bootloader port polling, Sentry enrichment, and ESP32 guard.
2026-05-03 docs: add implementation plan for firmware flashing robustness
    7-task plan covering AvrdudeRunner extraction, avrdude fixtures,
    upload flow regression tests, Windows bootloader port polling,
    Sentry enrichment, and ESP32 protocol guard.
2026-05-03 feat(consent): redirect to /consent until preference is set
    Adds ConsentGateHook on_mount hook and wires it as the first hook in
    the live_session :default on_mount list so every LiveView redirects to
    /consent when no error-reporting preference has been recorded yet.
2026-05-03 feat(consent): add ConsentLive first-run screen
    Implements the /consent LiveView with accept/decline buttons that persist
    the error reporting preference via Settings and redirect to / on completion.
2026-05-03 feat(nav): swap Simulator link for Settings gear icon
    Replace the Simulator nav button (linking to /simulator/config) with a
    Settings gear icon button linking to /settings, preserving the simulator
    status dot. Update the one nav-text assertion to expect "Settings".
2026-05-03 feat(settings): add Settings.Simulator file reader
    Extracts the file-reading concern from Trenino.Simulator.AutoConfig into
    a new pure read-only module. Never writes — the API key is read fresh
    from CommAPIKey.txt on Windows each time it is needed.
2026-05-03 feat(settings): add simulator connection section
    Adds a Simulator Connection section to SettingsLive with URL input,
    API key status indicator, optional manual API key override, and a
    Save button that persists both via Trenino.Settings.
2026-05-03 test: add avrdude transcript fixtures for upload flow tests
2026-05-03 test: add upload flow regression tests (success, non-retry errors, baud retry)
    Covers the full upload/4 happy path, non-retrying error classification
    (wrong board type, permission denied, verification failure, missing hex
    file, unknown device), and the baud-rate retry loop for old-bootloader
    Nanos using Mimic stubs for AvrdudeRunner and Avrdude.executable_path.
2026-05-03 feat: reject manifest devices with unsupported upload protocol (closes #76)
    Add @supported_programmers allowlist to DeviceRegistry so devices using
    sam-ba (Arduino Due) or esptool (ESP32) are silently skipped at manifest
    load time and never appear in the device dropdown.
2026-05-03 docs: add test suite cleanup design spec
    Captures the four problems (fragility, real-serial leakage, slowness,
    verbosity), the five-step rollout (Mimic safety net → detection-tools
    deterministic sync → top-5 slow-test surgery → output hygiene →
    verification), and explicit pass/fail gates.
2026-05-03 test: add forbidden default Mimic stubs for serial/avrdude
    Three modules — ForbiddenUART, ForbiddenAvrdude, ForbiddenSerialDiscovery —
    that raise loudly on any call. Wired up in case templates in next commit;
    this commit is the inert addition.
2026-05-03 test: wire forbidden serial stubs into DataCase and ConnCase
    Every DataCase / ConnCase test now starts with default Mimic stubs that
    raise on any real Circuits.UART / Avrdude / Serial.Discovery call. Tests
    that need real-looking behavior must stub explicitly. Failing tests
    surface in the next commit's fix sweep.
2026-05-03 test: stub serial calls in configuration_list_live_test
    Connection.scan/0 (a GenServer.cast) was being dispatched to the real
    Connection process, which would attempt UART enumeration and add ~220ms
    per test while the GenServer processed the request. Stubbing Connection
    at the test boundary via Mimic eliminates that overhead.
    Also add Mimic.copy(Trenino.Serial.Connection) to test_helper.exs so
    the module is available for stubbing in any test that needs it.
2026-05-03 test: replace remaining sleeps with deterministic waits in BLDC tests
    The 200ms/100ms Process.sleep calls used to guard negative assertions
    (verify no extra profiles sent) or sync capture_log with an async
    handle_info. Replace with assert_receive/refute_receive pairs and a
    LeverController.get_state() call (which flushes the mailbox by going
    through the GenServer serialisation queue).
2026-05-03 test: convert 29 DataCase test files to async: true
    Now that DataCase provisions a per-test isolated SQLite database for
    async tests, these 29 files can run in parallel without DB-busy
    contention. Identified by attempting conversion and verifying each
    file passes individually and in a 28-file concurrent batch (521 tests,
    0 failures).
    10 files remain async: false due to real concurrency issues:
    - device_registry_test: calls global DeviceRegistry GenServer
    - lever_session_test: global calibration session process
    - simulator_test: all 11 tests fail (unrelated async incompatibility)
    - upload_flow_test: Mimic stubs conflict under concurrency
    - detection_tools_test: DBConnection.OwnershipError
    -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
2026-05-03 test: silence test logs except on failure
    Two changes to make `mix test` output show only progress dots on success:
    1. ExUnit.start(capture_log: true) — captures all per-test log output
    and only prints it on test failure. This is the standard ExUnit way
    to keep clean runs quiet.
    2. Demoted Logger.warning -> Logger.info for the "Skipping device:
    protocol X not supported" message in DeviceRegistry. The bundled
    manifest contains devices we know we don't support (Arduino Due,
    esp32dev); skipping them is routine boot behavior, not a warning.
    This message was also leaking into test output because it fires
    during Application.ensure_all_started, before ExUnit's capture
    ha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
2026-05-03 test: silence logs from background GenServers (Logger level :none)
    ExUnit's capture_log is per-test-process; logs emitted from background
    GenServers (e.g. Trenino.Firmware.DeviceRegistry) had no test-process
    owner and bypassed the per-test buffer, leaking into clean test output.
    Setting global Logger level to :none in test env suppresses all routine
    logs. Tests that need to assert on log output should still use
    ExUnit.CaptureLog.capture_log/1 explicitly, which installs its own
    handler that bypasses this filter.
2026-05-03 test: wrap intentional noisy paths in capture_log
    Logger global level is :warning so capture_log/1 assertions work, but
    some tests intentionally trigger background-GenServer logs (DeviceRegistry
    empty-manifest fallback, etc.) that bypass ExUnit's per-test capture.
    Those tests now wrap their calls in capture_log/1 explicitly to keep
    clean test output dot-only.
    Reverts Logger level from :none back to :warning in test.exs so that
    capture_log/1 assertions (e.g. lever_controller_bldc_test.exs) can
    observe real log output.
2026-05-03 refactor: remove all BLDC functionality
    BLDC haptic lever support was an experiment that didn't pan out.
    Removes all protocol messages, hardware config, UI, tests, docs,
    and migrations related to BLDC levers. Adds a cleanup migration to
    drop BLDC columns from existing databases.
2026-05-03 docs: implementation plan for firmware version compatibility
    Six tasks: new Compatibility module (TDD), config key, latest-compatible
    release lookup (TDD), UpdateChecker integration (TDD), UI badge/disabled
    button with server-side guard, and a final precommit pass.
2026-05-03 feat(firmware): skip incompatible releases in update notifications
    Switches handle_check_success/2 to use Firmware.get_latest_compatible_release/0
    instead of get_latest_release/0 so update notifications skip releases that
    don't satisfy :firmware_version_requirement. Incompatible releases stay in
    the DB and remain visible elsewhere; only the update-notification path
    ignores them.
2026-05-03 docs: design spec for i2c display output support
2026-05-03 docs: add UI changes section to i2c display design spec
2026-05-03 docs: allow hex input for i2c address in design spec
2026-05-03 fix(firmware): also disable modal Start Upload for incompatible release
    The release-row install button is already disabled, but a stale modal
    (left open across a config change) could still bypass the UX cue. The
    server-side check_compatible/1 catches it either way; this is purely
    for visual consistency.
2026-05-03 docs: i2c display output implementation plan
2026-05-03 feat: add I2cModule schema and migration
2026-05-03 feat: add I2cModule CRUD and write_segments to Hardware context
2026-05-03 feat: include i2c modules in device configuration messages
2026-05-03 feat: add HT16K33 segment encoder
    Implements encode_string/2 that converts a UTF-8 string into raw 14-segment
    bytes for the Holtek HT16K33 display driver, using the Adafruit alphafonttable.
2026-05-03 feat: add DisplayBinding schema, migration, and Train context functions
    Introduces the train_display_bindings table that binds simulator endpoints
    to I2C display modules, with full CRUD context functions in Train module.
2026-05-03 feat: add DisplayController GenServer
    Drives I2C display modules based on simulator endpoint values, mirroring
    OutputController but sending WriteSegments. Uses subscription ID range
    3000-3999 to avoid conflicts with OutputController and ScriptRunner.
2026-05-03 feat: add display.set() to Lua scripting API
    Extends the ScriptEngine with a display.set(i2c_address, text) function
    that emits a :display_set side effect, and adds the corresponding handler
    in ScriptRunner to look up the i2c module by address and write segments
    to the hardware display.
2026-05-03 fix: code quality improvements in DisplayController and Lua display integration
    - Tighten active_train type from map() to Train.Train.t() in DisplayController.State
    - Add catch-all blank_display/1 clause with warning for unloaded association
    - Alias HT16K33 in ScriptRunner and use aliased form in chip_module/1
    - Document DB query cost in apply_display_set/2 with explanatory comment
    - Add display.set side effect entry to ScriptEngine moduledoc
    - Add display.set test to ScriptEngine test suite
2026-05-03 feat: add MCP tools for i2c modules and display bindings
    Adds 4 i2c module CRUD tools to DeviceTools and a new DisplayBindingTools
    module with 4 display binding CRUD tools. Registers DisplayBindingTools in
    the tool registry and updates tool count assertions from 29 to 37.
2026-05-03 feat: add I2C modules section to device configuration UI
2026-05-03 fix: address code quality issues in UI tasks 12 and 13
    - Add missing @impl true on second update/2 clause in DisplayBindingWizard
    - Replace bare {:ok, _} = ... match with case in delete_i2c_module and delete_display_binding handlers
    - Remove unused simulator_connected attr from display_bindings_section
2026-05-03 feat: replace brightness number input with 0-100% slider
    Convert the HT16K33 brightness field (wire range 0–15) to a user-friendly
    0–100% range slider with live percentage display. Conversion is handled in
    coerce_params/1 (pct→wire on save/validate) and update/2 (wire→pct on load).
2026-05-03 fix: brightness as percentage and align I2C module table buttons
2026-05-03 feat: add timed display test sequence to I2C modules table
2026-05-03 feat: replace flat brightness/num_digits with polymorphic_embed params on I2cModule
2026-05-03 fix: require params embed on I2cModule changeset
2026-05-03 feat: migrate I2C module brightness/num_digits to polymorphic params JSON column
2026-05-03 fix: populate i2c address input with raw integer, add display_type/align_right/min_value/has_dot form fields
2026-05-03 fix: update all callers to read chip params from mod.params, apply min_value clamp
2026-05-04 fix: harden serial connection and firmware upload infrastructure
    Six targeted fixes to improve resilience of the device connection and
    firmware upload pipeline:
    1. Run device discovery in a Task so the Connection GenServer stays
    responsive during the 3-second DTR settle delay and identity handshake.
    Stale discovery results are safely ignored when the port state changed
    while the Task was running. Increased discovery timeout to 10s to match
    the maximum possible discovery duration.
    2. Switch UploadManager from Task.async (linked) to Task.Supervisor.async_nolink
    and store the task pid. Cancel and timeout handlers now kill the task
    process, which terminates the avrdude Port l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
2026-05-09 fix(firmware): pass APP_PATH to backend so bundled avrdude is found on Windows
    Two targeted fixes for firmware flashing on Windows (root cause of #76):
    1. lib.rs: resolve the directory of the Tauri executable at startup and pass
    it as APP_PATH to the Elixir backend sidecar. The backend's
    tauri_sidecar_executable() was already written to use APP_PATH, but the
    env var was never set — making avrdude undiscoverable on any machine where
    it wasn't installed system-wide (i.e. all Windows users).
    2. uploader.ex: remove the avrdude_hex_path/1 Windows workaround that tried to
    use a relative path to avoid drive-letter colons in the -U argument.
    avrdude 8.x (which is always the bun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
    [lib.rs]
2026-05-09 docs(changelog): separate v0.7.4 fixes from unreleased I2C display work
    Move the flashing and connection stability fixes into a [0.7.4] section
    (pending release via release/v0.7.4 branch). Leave only the I2C display
    feature in [Unreleased] as it is not part of the v0.7.4 release.
2026-06-09 chore(deps): bump circuits_uart from 1.5.5 to 1.6.0
    Bumps [circuits_uart](https://github.com/elixir-circuits/circuits_uart) from 1.5.5 to 1.6.0.
    - [Release notes](https://github.com/elixir-circuits/circuits_uart/releases)
    - [Changelog](https://github.com/elixir-circuits/circuits_uart/blob/main/CHANGELOG.md)
    - [Commits](https://github.com/elixir-circuits/circuits_uart/compare/v1.5.5...v1.6.0)
    ---
    updated-dependencies:
    - dependency-name: circuits_uart
    dependency-version: 1.6.0
    dependency-type: direct:production
    update-type: version-update:semver-minor
    ...
2026-06-09 fix: resolve all Elixir 1.20 set-theoretic type checker warnings
    - Remove unused `require Logger` in application.ex and output_binding_wizard.ex
    - Pin bitstring size variables with `^` in framing.ex, configure.ex, and framing_test.exs
    - Remove dead catch-all clauses the type checker proved unreachable:
    - calibration_wizard: format_error(_) (caller guarded by match?/2)
    - lever_setup_wizard: NotLoaded clauses for has_existing_config?/1 and
    compute_configured_steps/2 (lever_config always preloaded at call sites)
    - lever_visualization: format_range(nil, _) (caller guarded by :if={@captured_range})
    - simulator/client: unreachable _ clause (map_size guard ensures non-empty list)
    - Fix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
2026-06-12 docs: weekly documentation review for 2026-06-12
    - Update Elixir requirement from 1.15+ to 1.20 and Erlang from 26+ to
    29 in development.md and getting-started.md (matches mise.toml after
    the Elixir 1.20 upgrade landed in fc00d73)
    - Fix speed unit bug in lua-scripting.md: HUD_GetSpeed returns m/s but
    the example compared against 100 as if it were km/h (would trigger
    at 360 km/h); updated example converts to km/h before comparing
    - Fix same unit assumption in mcp-setup.md Lua script workflow example
    - Update Hardware Protocol Reference table in hardware-setup.md: had
    wrong byte values (0x01 for both IdentityRequest and IdentityResponse)
    and was missing I2C display message types 0x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
2026-06-19 docs: weekly documentation review for 2026-06-19
    - README: simplify dev setup to use `mix setup` (was missing asset compilation steps)
    - development.md: remove incorrect Node.js prerequisite (project uses Hex-managed esbuild/tailwind, no Node.js needed)
    - hardware-setup.md: document the missing "Minimum value" field for I2C modules
    - lua-scripting.md: add speed-on-display example showing display.set() with unit conversion
    - CHANGELOG.md: remove empty placeholder sections from [Unreleased]
2026-08-02 fix: report unsupported vJoy platform via protocol
    [vjoy.rs]
2026-08-02 fix: harden virtual joystick sidecar
    [protocol.rs, vjoy.rs]
2026-08-02 fix: match pinned vJoy v3 report ABI
    [vjoy.rs]
2026-08-02 fix: pass mutable report to vJoy
    [vjoy.rs]
2026-08-03 feat: configure vJoy device with explicit elevation
2026-08-03 fix: reap timed out vJoy probe processes
2026-08-04 fix: tighten virtual joystick UI state handling
2026-08-04 fix: require integer virtual joystick device index
2026-08-05 fix: harden Windows vJoy packaging
    [lib.rs, main.rs, vjoy.rs]
2026-08-09 docs: pin official Windows XZ prerequisite
2026-08-09 fix: stage verified avrdude Windows sidecar
2026-08-09 test: stop UART connection before fake port
2026-08-12 ci: stage vJoy resources in release builds
2026-09-29 Fix jitter when commands are delayed
2026-10-25 fix: keep desktop backend alive and probe vJoy with native PowerShell
2026-11-01 ci: repair Claude workflows and pin their actions
    - claude-code-review: restore id-token: write, which the action needs for
    its GitHub App token; add a timeout and per-PR cancel-in-progress
    - dependabot-analyzer: use the job token under pull_request_target, allow
    the tools its prompt needs, and check the PR author rather than the actor
    - claude: require a trusted author for issue triggers
    - claude-weekly-docs: drop references to files that no longer exist
    - pin claude-code-action and harden-runner to commit SHAs
2026-11-01 feat: add stepper protocol and empty configuration codecs
2026-11-01 feat: persist configurable hardware stepper axes
2026-11-01 feat: manage stepper command sessions and watchdogs
2026-11-01 feat: coordinate calibrated stepper gauges and train telemetry
2026-11-01 feat: add stepper configuration and commissioning screens
2026-11-01 feat: add train gauge setup and calibration workflow
2026-11-01 docs: document stepper commissioning and acceptance
2026-11-01 feat: add orientation setting for I2C display modules
    Support Normal, Rotated 180, Flipped horizontal, and Flipped vertical
    orientations for HT16K33 displays mounted upside down or mirrored. The
    transform is applied in software during segment encoding (per-digit
    segment-bit permutation plus digit-order reversal), so it works for
    display bindings, Lua display.set, and the display test with no
    firmware or protocol change.
    Also fix MCP create/update_i2c_module silently dropping brightness and
    num_digits: both tools now build a proper nested params map (with the
    identify-by fields PolymorphicEmbed needs) and merge param overrides
    into existing params on update instead of clobbering them.
2026-11-01 feat: simplify stepper gauge setup and add apply MCP tool
    - Apply is gated on the ALLCALL registration confirmation only when the panel
    has a display at 0x70; plain-language explanation inline.
    - Quick setup X27.168 preset, advanced fields grouped under a details block.
    - One-click Flip direction with next-step notice; saves explain Apply is needed.
    - New MCP tool apply_stepper_configuration (explicit acknowledged input, never
    defaulted, never moves a motor); update_stepper_axis returns next_steps.
    - Docs and tool-count tests updated.
2026-11-01 feat: replace 0x70 acknowledgement with non-blocking warning
    Apply is never blocked by or asks for confirmation. A warning is shown in
    Stepper axes and the Apply dialog when a configured 0x70 module and a stepper
    axis coexist; apply_stepper_configuration returns a warning field.
2026-11-01 fix: make stepper commissioned flag uncastable from attrs
    Only StepperManager's complete_commissioning path (fresh stationary
    reference plus lease) may commission, via Hardware.commission_stepper_axis/1.
2026-11-01 fix: clear deployment token when stepper session faults
    A fault left deployment_token set, so begin_deployment returned busy until
    reconnect and an old token could still finish a deployment.
2026-11-01 feat: show Apply needed banner and explain unavailable Apply
    Record a fingerprint of the configuration the device confirmed and compare
    it with the saved one. When Apply is unavailable the page says why.
2026-11-01 feat: stepper next-step guidance, glossary, and clear healthy fault display
    Session error is cleared on re-probe/invalidate and axis error on a
    successful acknowledgement, and the status line only shows real faults.
2026-11-01 test(steppers): fault-to-recovery sequences; report session lifecycle for refused targets
    admit_target ignored the session lifecycle, so a faulted or reconfiguring
    session answered needs_reference. It now answers with the lifecycle.
2026-11-01 feat(steppers): accepted moves finish past lease expiry; lease status and explained refusals
2026-11-01 feat(hardware): move dial calibration from gauge bindings to the stepper axis
    The dial belongs to the hardware. A new per-axis dial calibration table holds
    points, dial unit, validity and review; bindings keep only their speed source.
    Existing data migrates (identical tables stay reviewed, conflicting ones keep the
    newest as unreviewed with a log note) and the migration rolls back losslessly.
2026-11-01 feat(ui): calibrate the dial on the axis, simplify the train gauge wizard
    DialCalibrationComponent (axis commissioning area) carries the measure, preview,
    test move and capture tools with their why-disabled lines. The train wizard is
    now axis, endpoint and units, enable; it shows whether the axis dial is
    calibrated and links to it.
2026-11-01 docs: per-axis dial calibration and the simplified gauge wizard
2026-11-01 test: align gauge runtime tests with axis dial calibration
2026-11-01 feat(hardware): add pure gauge setup wizard state machine
    Guided flow for a stepper axis: prerequisites, direction check, dial marks
    with slope-based estimates, verification, optional automatic homing with
    backoff measurement, and commissioning through complete_commissioning only.
    Effects are carried out by a small Runner over the existing StepperManager
    and Hardware operations; the machine itself touches no hardware.
2026-11-01 feat(web): guided gauge setup wizard on the stepper axis card
    A thin LiveComponent over the GaugeWizard state machine and Runner. It is
    opened from a Guided gauge setup button on each axis card, follows real device
    status for every wait, shows Stop during motion, and releases manual control
    (resuming train control for commissioned axes) when closed. Adds
    Train.list_gauge_bindings_for_axis/1 so the last step can link to trains that
    already use the gauge.
2026-11-01 fix(hardware): keep wizard interruption reason current and clearer checklist
    A fault arriving while the device is disconnected now replaces the waiting
    message with the recovery action, and the checklist names each condition
    instead of reading as an instruction.
2026-11-01 fix: stepper session target dedupe, configure timeout fault, rollover bookkeeping
2026-11-01 fix: stepper manager auto-home latch, single subscription, barrier owner, deletes, op records
2026-11-01 docs+schema: per-tool stepper schemas, acknowledged, operation token wording, MCP loss, rollover
2026-11-01 chore: satisfy credo for stepper manager and tests
2026-11-01 fix(gauge-wizard): keep the lease token until Close has released and resumed
    Close cleared the token before the runner read it, so release and resume were
    refused and the axis kept running under a stale lease. Track that the wizard
    paused the axis so Close also resumes after a fault or disconnect, and show a
    failed release or resume instead of closing silently. Adds a Runner test
    against the real StepperManager.
2026-11-01 fix(gauge-wizard): make homing tuning recoverable and honour the startup choice
    The first sweep starts from no backoff and 'No, adjust again' re-runs from there, so
    the needle can always be nudged up onto 0. Tuning can be cancelled to restore the
    previous settings, a re-run reaches the tuning step again, and the startup homing
    checkbox is always written, including when unticked.
2026-11-01 fix(config): fingerprint only what reaches the device, deterministically; unknown apply state is not a difference
2026-11-01 fix(gauge): reverse, home position/direction and motor port invalidate the dial
2026-11-01 style: format dial calibration migration
2026-11-01 fix(stepper): halt polling on rollover, keep pause on reload, single poll chain
2026-11-01 fix(config): report firmware_update_required for stepper axes on old firmware
2026-11-01 fix(stepper): Resume and owner-loss resume work while unplugged
2026-11-01 fix(stepper): train inactive clears queued targets instead of Stop
2026-11-01 docs(stepper): host restart rediscovery does authorize auto-home
2026-11-01 refactor(stepper): extract lifecycle update, alias LocalOnly
2026-11-01 fix(gauge-wizard): shift dial on homing confirm, restore homing on close, close while unplugged
2026-11-01 fix(stepper): reset request ids when a rollover faults a deployment
2026-11-01 fix(stepper): lease revocation resumes only once the owner is gone
2026-11-01 fix(gauge): invalidate dial on home frame edits; restore provisional homing on any close
    home_backoff and reference_strategy now invalidate the dial; the wizard's homing
    tuning passes an explicit keep_dial option. Close restores whenever the homing
    settings are provisional, not only on tuning steps.
2026-11-01 fix(stepper): a revoked lease's owner watch is superseded by later claims, Resume and release
    One watch per axis; claim, claim_mcp, Resume and the owner's own release drop it, and a
    resume after owner loss re-arms the startup Home latch spent while the axis was paused.
2026-11-01 fix(gauge): block the dial while homing tuning is provisional
    Tuning marks the dial valid: false (bindings stay enabled) in the same transaction as the
    axis update, replacing keep_dial; confirm, cancel and close hand it back with valid: true.
    An abandoned run leaves a blocked gauge with guidance, not a needle driven by an offset
    dial. Confirm always saves so a zero shift also revalidates.
2026-11-01 test: supervise stepper sessions in manager tests; reset Detection in ConnCase
    Without StepperSupervisor the manager unlinks its sessions, so a manager stopped by the
    test exit leaves them running and their watchdog fault reaches later tests that reuse
    device ids. ConnCase now resets Train.Detection like DataCase.
2026-11-01 feat(ui): simplify stepper axis card and gauge list
    Axis card at rest shows a name, one state chip and at most one action. Manual
    controls move behind an Advanced disclosure; Stop, Resume and Recover are
    promoted only when the state makes them urgent. Gauge cards show identity, one
    state, one reason and a real on/off switch.
2026-11-01 docs: add I2C input modules spec and host plan
2026-11-01 feat: manage chip inputs and virtual pin allocation
2026-11-01 fix(levers): stop resending values the simulator already has
    Notched levers snap to their own position after a write, so repeating a
    gate target on every input sample kept pulling the handle off the notch.
    Also records this and the identifier re-detection fix in the changelog.
2026-11-01 feat: support ADS1115 calibration
2026-11-01 feat: track failed input chips
2026-11-01 Fix I2C review findings: default names, server-side delete confirm, immediate delete, removed in MCP Co-Authored-By: Claude Opus 5.5 <noreply@anthropic.com>
2026-11-02 Show lever direction in notch mapping step
    The Map Positions step mixed hardware and simulator vocabulary, truncated
    notch names and only inferred lever direction silently at save, making it
    hard to tell which physical end gives full power on inverted levers.
    - NotchMappingSession exposes a live `preview` (ends, live position,
    physical-order ranges, detected inversion) computed through
    LeverMapper.resolve_input/2 on the same normalization the save uses
    - Sim-order bar drops MIN/MAX and shows full notch names; new "Your lever"
    strip shows captured ranges in physical order with a live marker and a
    "Reversed vs. simulator" badge
    - Capture panel and review state use plain-language copy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
2026-11-02 chore(deps): bump circuits_uart from 1.6.0 to 1.7.0
    Bumps [circuits_uart](https://github.com/elixir-circuits/circuits_uart) from 1.6.0 to 1.7.0.
    - [Commits](https://github.com/elixir-circuits/circuits_uart/compare/v1.6.0...v1.7.0)
    dependency-version: 1.7.0
    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
2026-11-03 feat(ui): adopt Trenino brand guide v1.1
    Align the app, desktop shell and docs with the v1.1 brand system.
    - Identity: throttle-lever lockup in the nav (theme-aware), brand
    favicon and app tile, regenerated Tauri icon family, flat graphite
    splash; remove the Phoenix logo, welcome page and title suffix.
    - Theme: map brand tokens onto both daisyUI themes with one indigo
    action family, ink content on light dark-theme fills, --depth 0,
    and a text-muted token replacing faint-opacity text.
    - Type: 14px/1.6 body, 24/20px titles, 12px minimum, tabular numbers
    for technical values.
    - Status: labelled states (Connected, Connecting, Needs attention,
    Failed), soft status variants, category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
2026-11-03 feat(ui): move simulator status into the connections dropdown
    The full-width simulator banner showed on every page, as the only solid
    status fill in the app, even where the simulator is not needed.
    - Remove the banner. The nav status button now rolls up devices and
    the simulator ("Connections: ..."); its dropdown leads with a Train
    Sim World row with the next step and Retry or Open Settings.
    - Only Trains and train edit show <.simulator_notice>, a soft warning
    with the same action, hidden while connecting.
    - Name device rows after their configuration when known, port second;
    compact Scan / Check firmware actions and a single muted failure line.
    - Settings becomes a nav tab; the head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
2026-11-03 perf(steppers): stop idle status polls from querying and broadcasting
    Each idle status poll reply was broadcast unconditionally, and every
    broadcast made StepperManager look up the device's axes (two queries)
    to check for stale leases. Sessions now publish only when the state
    visible to subscribers changes, and the lease check is skipped when no
    leases are held.
2026-11-03 docs(changelog): note the idle stepper polling fix
2026-11-03 fix(firmware): wait for Pro Micro bootloader before running avrdude
    After the 1200bps touch the bootloader poll accepted the original port on
    its first check, ~100ms in, while the sketch still owned it. avrdude then
    held the port across the board's USB reset and hung with no output until
    the upload was cancelled.
    Only accept the original port once it has disappeared and re-enumerated,
    falling back to it after a 2s grace period for boards that never reset.
    New ports (Windows) are still taken immediately.
    Also replace invalid UTF-8 in avrdude output, which crashed the Logger
    formatter when avrdude echoed raw bytes from a running sketch.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
2026-11-03 fix(firmware): kill avrdude when an upload is cancelled or times out
    Closing an Erlang port does not stop the OS process, and avrdude never
    reads stdin, so a stuck avrdude outlived cancelled uploads and kept the
    serial port open. Each run now starts a watcher that kills avrdude by OS
    pid if the calling process dies first, and the runner's own timeout
    kills it directly (kill -TERM, or taskkill on Windows).
2026-11-03 Revert "Merge branch 'feat/i2c-input-modules'"
    Several boards are simpler and more reliable than MCP23017 and ADS1115
    expansion chips, so input chips go away. HT16K33 displays stay. Changes made
    after the merge are kept; where they touched chip code, only the chip parts
    are removed. Firmware 3.2.1 drops the chip module types to match.
    This reverts commit a3abc44, reversing changes made to ac11278.
2026-11-03 feat(joystick): ask users to install vJoy instead of bundling the driver
    Joystick mode is optional, so the Windows installer no longer installs
    the vJoy kernel driver. When the driver is missing, the Joystick page and
    the MCP driver_missing reason link to the vJoy 2.2.2.0 release.
    The build still verifies vJoySetup.exe but only extracts vJoyConfig.exe
    and vJoyInstall.dll from it; the installer is no longer bundled. The
    uninstall hook still removes Trenino's device and still offers to remove
    a driver that an earlier release installed.
2026-11-03 docs(changelog): note the removal of I2C input chips
2026-11-04 feat(steppers): simplify the stepper axes section
    Each axis card now shows one status and at most one action. Adding a gauge
    asks for a name and a shield port, then opens the guided setup. Manual
    controls move to a Diagnostics panel in the card menu, and the shield
    address becomes one line with a guided Change panel.
    Add StepperManager.rezero/2, an explicit operator action that hands a
    set-up gauge back to the train: it Homes an internal-stop axis (after a
    fault, once the reconfigured device awaits a reference, and only that
    axis), takes a host-reference axis's reference once the operator confirms
    the needle is on 0, or just resumes a referenced axis. Recover, Apply and
    reconnects still nev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
2026-11-04 feat(ui): unify edit-page sections on the hardware and train pages
    Every section on the hardware configuration and train pages now renders
    through shared primitives (config_section, section_group, section_action,
    section_empty, row_actions, section_nav), so they share one card style,
    header, compact empty state and row-action convention.
    - Group sections (Controls / Feedback on hardware; Controls / Displays &
    lights / Automation on train) behind a sticky per-section nav
    - Rename "Stepper axes" to "Gauges" and the train gauge section to
    "Gauge bindings"; motor shield address moves under the Gauges header
    - Confirm every delete; disabled add buttons show a visible reason
    - Move section an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
2026-11-04 docs(readme): add Discord invite and move stepper gauges into features
2026-11-06 feat(selectors): add selector data layer
    Add the data layer for using a potentiometer as a multi-position switch.
    - selector_bindings and selector_positions tables. Each position has a
    hardware range and enter/exit actions (set_value, sequence, keystroke).
    - SelectorBinding and SelectorPosition schemas. Positions are saved as a
    full set and must not overlap; the gaps between them are dead zones.
    - SelectorMapper: position lookup, even split with dead zones, and
    layout validation.
    - Train context functions for selector bindings, and a :selector
    element type.
    - Selector bindings conflict with virtual joystick mappings on the same
    input, like lever and button bindings.
    Co-Authored-B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
2026-11-06 feat(selectors): run selector actions at runtime
    Add SelectorController, which runs a selector position's actions as the
    potentiometer moves.
    - Readings are normalized and resolved to a position. A reading in a
    dead zone, or one that resolves to the current position, does nothing.
    - On a position change the old position's exit action runs, then the new
    one's enter action, in a single runner task per selector. A new
    transition kills the running task.
    - Syncs the current position's enter action when a train activates, when
    bindings reload, when the simulator connects, and when a device
    connects and a selector has no position yet. Sync uses the last cached
    reading and runs only whi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
2026-11-06 fix(selectors): address phase 2 review findings
    - Keep the current position struct, expose get_position/1, and broadcast
    a nil position when a selector's position is cleared.
    - A reload rebuilds the input lookup, so a recalibration applies, and
    keeps the position of selectors whose configuration is unchanged.
    Saving one selector no longer re-fires every other selector.
    - Sync never taps keystrokes, since they are usually toggles. A knob
    resting in a dead zone syncs to its known position.
    - While the simulator is disconnected, readings update and broadcast
    the position but run no actions. Runners stop when it disconnects.
    - Context functions reload the controllers themselves: saving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
2026-11-06 feat(mcp): add selector tools
    - get_selector, configure_selector, set_selector_even_split and
    delete_selector. configure_selector replaces the whole position set,
    splits it evenly when no ranges are given, orders explicit ranges
    physically, and reports nested validation errors per position.
    - create_element accepts "selector", and unknown types return a
    validation error instead of raising.
    - get_train includes selectors with their positions.
    - list_device_inputs reports whether each input is calibrated.
    - Document selectors in the train-setup skill.
    - Tool count: 62 -> 66.
2026-11-06 fix(mcp): address selector tool review findings
    - Report position errors at the caller's list index, skipping positions
    being replaced, and keep binding-level position errors next to nested
    ones.
    - Keep explicit ranges in the order given instead of sorting before
    casting. String bounds sorted after numbers and swapped positions. The
    list order is the order the knob passes through the positions, so a
    reverse-wired pot works too.
    - Treat null bounds as not given.
    - A non-integer or missing element_id returns an error instead of
    raising.
    - Require calibration on a selector's input, and require enabled.
    - Clearer error for a missing or foreign sequence.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
2026-11-06 feat(ui): configure selectors on the train page
    - The add element modal offers Selector. Its setup opens without the
    simulator.
    - New SelectorWizard with three steps:
    - Input: pick a calibrated analog input. Uncalibrated inputs are
    disabled, and inputs that already drive a lever on the train show a
    warning.
    - Positions: choose a count, split evenly, or capture each detent with
    the knob while a live bar shows the ranges and the current reading.
    Ranges and labels stay editable.
    - Actions: enter and exit actions per position. Endpoints can be typed
    or browsed in the simulator API, and values read from the simulator,
    while it is connected.
    - Validation errors are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
2026-11-06 fix(selectors): address final review findings
    UI:
    - The table's live position and the wizard rows had the same DOM id.
    - A device connecting or disconnecting while the wizard is open now
    starts or stops its live reading, so a stale reading can't be
    captured.
    - Each port is subscribed to once per page. The lever wizard handlers
    had been resetting the watched ports, and button detection
    subscribed again on every run.
    - Opening another selector re-initializes the wizard.
    - Crafted event params no longer crash the page.
    - Ranges are checked before the actions step.
    - The wizard has an Enabled toggle.
    - The live region announces only the knob's position, and Escape no
    longer closes the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
2026-11-06 fix(controllers): subscribe to each input port once
    LeverController and ButtonController replaced their subscribed ports
    with the currently connected ones. A port that disconnected and came
    back was subscribed again, and since PubSub subscriptions outlive the
    disconnect, every reading after that was delivered more than once.
    Keep the union of subscribed ports instead, as SelectorController does.
2026-11-07 fix(configurations): show device configs on apply, allow outputs-only apply
    - The Apply configuration dialog shows what each connected device runs:
    this configuration, another one by name, an unknown one, or none.
    - Outputs count as configuration parts, so an outputs-only configuration
    can be applied (empty Configure packet, firmware 3.1+) and its outputs
    tested. A truly empty configuration is still rejected.
    - Configuration pages ignore apply success/failure events for other
    configurations.
2026-11-07 test(firmware): wait for the avrdude watcher before killing the caller
    The :receive trace fires when the subprocess output reaches the caller's
    mailbox, which can happen before AvrdudeRunner has spawned its watcher.
    Killing the caller in that window left nothing to kill the subprocess,
    so the test flaked in CI. Also trace spawns and wait for the watcher.
2026-11-07 fix(train): retry output subscriptions, finish tapped sequences, quiet gauges
    OutputController subscribed once at train load and dropped any endpoint
    whose subscribe failed, so a transient error (a closed socket while the
    train was loading) left door LEDs dark for the session. Bindings now load
    regardless, and the poll loop subscribes missing endpoints with a retry
    delay, clears stale IDs first, resubscribes after a failed read or a
    simulator reconnect, and switches outputs off on disconnect.
    A momentary release killed a running sequence, so a tap during the 300ms
    delay of "Close all doors" left DoorClose held. The sequence now runs to
    completion; a re-press while it runs is ignored. Latchi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
2026-11-07 fix(serial): skip streamed frames while waiting for the identity reply
    Configured firmware streams input values and heartbeats from boot, so
    discovery could read five of them, count each as a failed attempt and
    give up before reading the identity response. Each attempt now reads
    frames for up to one second, skipping anything that is not an identity
    response; only a silent second counts as a failed attempt.
    Replace the discovery test, which reimplemented the logic against a
    hand-rolled mock, with SerialSafetyCase tests that run the real module.
2026-11-07 fix(serial): scan for new ports every 2s and back off failed retries
    New ports were only picked up on a 60s discovery tick, and failed ports
    waited for that same tick after their 30s backoff, so a board could take
    up to a minute to connect and about another minute per failed attempt.
    Scan every 2s (only untracked or due ports are opened) and retry failed
    ports after 5s, doubling per consecutive failure up to 60s so a
    non-Trenino device is not reset every few seconds.
2026-11-07 ci: build with Elixir 1.20 and OTP 29
    Release and nightly pin OTP 29.1, the newest build available on Beam
    Machine for Burrito.
2026-11-07 perf(train): cache hardware lookups on gauge and script hot paths
    StepperManager re-read the stepper axis (two queries) on every train
    target, up to 5x/s per moving gauge. It now caches the axis and drops
    the cache on every gauge configuration broadcast, device change and its
    own axis writes. Device deletion now broadcasts too, since it removes
    the device's axes.
    ScriptRunner looked up the output or every I2C module on each
    output.set/display.set. It now caches them until a configuration is
    applied, the train changes or scripts reload.
2026-11-08 feat(beta): hide gauges and selectors behind a beta features setting
    Add Trenino.Beta, a small registry of known beta flags. Beta features are
    always on in dev and test, and in releases they follow a new "Enable beta
    features" toggle on the Settings page.
    Stepper-motor gauges and selectors are the first beta features. Only entry
    points are gated: the Gauges and Gauge bindings sections, the Selector
    element type, and their MCP tools. Saved gauges and selectors keep running
    while beta features are off.
    CLAUDE.md explains how to gate a feature and how to graduate one.
2026-11-08 Scripted lever calibration, AI lever tools and wizard handoff
    Lever calibration now finds notches the way drivers feel them, checked on
    seven trains (Class 802, BR430, LIRR M9, ÖBB 1116, Class 323, AC4400CW,
    Class 142):
    - push the lever into gates such as Emergency
    - merge the ends of a range ("Max Brake", "Min Power") into the range,
    keep a gate when the output jumps or an unreachable band separates it
    - split power steps that share one simulator notch into separate notches
    - take simulator input ranges from where the lever actually stopped
    - name notches from the game's DisplayInfo labels
    - warn about blocked ranges and spring-loaded positions
    - refuse to sweep a moving train, stop if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
2026-11-08 Fix lever review findings and live-test regressions
    - Keep a gate past an unreachable band even when its output equals the
    range end; merge equal-output snap points only within 2x the merge gap
    - Refuse to sweep when the lever's position cannot be read, so it is
    never left at the end of the sweep
    - Group samples into contiguous notch-index runs, fold a gate the lever
    returns to later (Class 142 reverser snaps to Off above 0.86), and drop
    single transient samples between two gates
    - Carry hardware notch ranges over only for the same simulator control;
    force-reload notches after saving an analysis (stale notches were
    returned on recalibration)
    - calibrate_lever requires the speed g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
2026-11-08 Put the virtual joystick behind a beta flag
    The Joystick tab stays in the nav. While beta features are off, the page
    explains the joystick is a beta feature, less tested and errors are
    expected, and offers an "Enable beta features" button. The virtual
    joystick MCP tools are hidden until beta features are on.
2026-11-08 Design a notch disk from a calibrated lever
    Calibrated levers link to the train-lever notch disk generator with their
    notches prefilled. Trenino.Train.NotchDesign maps gates to positions
    (Emergency and centre gates Deep, the rest Standard) and linear ranges to
    Smooth runs sized by their share of the simulator travel, with end stops
    and a 13-position limit. The link is on the lever row of the train page,
    after notch detection in the wizard, and in get_lever's notch_disk_url.
2026-11-08 Let lever calibration sweep while the train moves, with a warning
    A combined power/brake handle (e.g. the Class 802 PowerHandle) releases the
    brake as it is swept through the power notches, so the speed guard always
    stopped its calibration. LeverAnalyzer no longer refuses to start or stops
    when the train moves; it still puts the lever back where it was.
    calibrate_lever's description, the wizard's Calibration Info and Detect
    Notches copy, and the train-setup skill now warn up front that the sweep
    will move the train.
2026-11-08 Lever wizard: start detection on demand, two-column mapping, notch disk in row menu
    - Detect Notches no longer sweeps the lever as soon as the step opens; it
    waits for Start Detection / Detect Again (Try Again after a failure).
    Only the Calibration Info "Start Calibration" button starts it directly.
    - Map Positions puts the overview (simulator notches, your lever) on the
    left and the current notch's readings and capture buttons on the right,
    so the step fits without scrolling. The review stays one column.
    - Long notch names truncate instead of breaking mid-word.
    - Lever rows on the train page always use the "..." menu (Configure,
    Design notch disk); the wizard keeps the notch disk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
2026-11-08 Changelog and wizard copy for calibration that moves the train
    Fold the "train will move" behaviour into the unreleased calibration
    entry (the stop-on-movement guard never shipped), add entries for the
    on-demand Detect Notches step, the two-column Map Positions step and the
    lever row menu, and point the notch disk entry at its new places. The
    Calibration Info checklist now asks for the reverser out of neutral and
    the Detect Notches idle copy matches the movement warning.
2026-11-08 Follow firmware 3.3.0: drive X27 gauge modules instead of stepper axes
    Firmware 3.3.0 removed the stepper axis extension (messages 16/17, the
    PCA9685/TB6612 shield, lease, homing and status) and made X27 gauges a
    normal Configure module (type 7), moved with SetGaugePosition (18) and
    re-zeroed with ZeroGauge (19). Trenino's gauge stack is rebuilt on it.
    - Hardware.Gauge replaces StepperAxis: VID6606 channel (STEP, DIR, shared
    RESET_N) or direct drive from four AVR pins, travel, speed, acceleration,
    reverse. Device-wide checks mirror the firmware: four gauges, no shared
    pins except RESET_N, no clashes with inputs, matrices or outputs.
    - Gauges are configure parts; a gauges-only device n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
2026-11-08 Notch disk: place notches by simulator input, guard Emergency
    The generator spaces positions evenly and a Smooth run is a single
    plateau, so run lengths only decide where the notches land. They were
    sized from range width against travel / notch count, which let gates
    drift: the Class 802's Off landed at -8.3 degrees instead of the centre.
    Now every position count and Smooth split is scored by how close each
    gate lands to its simulator input, so a centred Off is the middle
    position.
    A range next to Emergency now gets a Standard position named after the
    range, so the lever no longer glides straight into Emergency.
2026-11-08 Keep 4-decimal precision on lever inputs
    Rounding the normalized lever position to 2 decimals capped a lever at
    101 positions, so a linear notch over a short part of the travel (e.g. a
    brake notch over 9%) moved the simulator in ~10 steps. The live position
    and interpolated linear-notch values now keep LeverMapper.input_precision/0
    (4) places. Notch bounds, gate values and selectors stay at 2 decimals.
    Docs: Sensitivity range is 1-10 (matches validation), with 1-2 suggested
    for levers.
2026-11-09 Make table row actions consistent across edit pages
    - Label the action that opens an item's settings "Edit" everywhere
    (elements and output bindings said "Configure")
    - row_actions: `primary` keeps an action inline when the rest collapse
    into the "..." menu; `menu_slot` reserves the menu's width so buttons
    line up across rows
    - Lever rows show Edit inline; the menu holds only "Design notch disk"
    - Action columns hug their content and never wrap
    - Output binding rows stay on one line
    - Section header keeps actions top right even with a long description
    (fixes "Add gauge"); gauge status chip moves under the name
    - Document the rules in the phoenix-liveview skill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
2026-11-09 Delete an input's calibration along with it
    The calibration foreign key has no ON DELETE action, so deleting a
    calibrated input (a lever) raised Ecto.ConstraintError and crashed the
    configuration page. delete_input now removes the calibration first, in
    one transaction.
2026-11-09 Apply a changed lever input without restarting
    Reloading lever or button bindings now also rebuilds the controller's input
    lookup, so an input added or calibrated after its device connected is picked
    up. Closing the lever wizard after it saved the input binding reloads too.
2026-11-09 Send the nearest notch when a lever rests between notches
    Captured notch ranges rarely touch. A reading in a gap matched no notch,
    so nothing was sent and the simulator stayed on the previous notch: moving
    from Brake to a narrow Off gate often left the train braking. A gap now
    resolves to the notch with the nearest edge (a gate wins a tie), and a
    linear notch reached from a gap sends its nearest end. The mapping
    wizard's live preview follows the same rule.
    Also log when a lever write gives up after its bounded retries.
